avena-robotics/pcbs/UNIVERSAL_JOINT_v3_5/elementy.xlsx

Sheet: SMT
C1, | 1 | 10uF 25v | C | footprints:C_0805_2012Metric_Pad1.18x1.45mm_HandSolder | Unpolarized capacitor
X1, | 1 | ECS-240-8-36B2-CKM-TR | Crystal_GND24_Small | Crystal:Crystal_SMD_2520-4Pin_2.5x2.0mm | Four pin crystal, GND on pins 2 and 4, small symbol
U8, | 1 | NCP115 | NCP115 | footprints:TSOP-5_1.65x3.05mm_P0.95mm
U7, | 1 | MP2456 | MP2456GJ-Z | UNIVERSAL_JOINT:MP2456GJ-Z
U5, | 1 | 24CW16X | 24AA02-OT | footprints:SOT-23-5 | I2C Serial EEPROM, 2Kb, SOT-23
U4, | 1 | iC-PZ2656 | iC-PZ2656 | UNIVERSAL_JOINT:oQFN32-5x5
U3, | 1 | iC-PX3212 | iC-PX3212 | UNIVERSAL_JOINT:oDFN8-3x3
U2, | 1 | TCAN332G | TCAN332G | footprints:SO-8_3.9x4.9mm_P1.27mm | High-Speed CAN Transceiver with CAN FD, 5Mbps, 3.3V supply, SOT-23-8/SOIC-8
U1, | 1 | STSPIN32G4 | STSPIN32G4 | UNIVERSAL_JOINT:STSPIN32G4
SW3, | 1 | EVP-BB2A9B000 | EVP-BB2A9B000 | UNIVERSAL_JOINT:SW_EVP-BB2A9B000
RJ213, RJ215, RJ216, RJ217, RJ218, | 5 | 0 | R | footprints:R_0402_1005Metric_Pad0.72x0.64mm_HandSolder | Resistor
R92, | 1 | 200 | R | footprints:R_0402_1005Metric_Pad0.72x0.64mm_HandSolder | Resistor
R90, R226, | 2 | 100k | R | footprints:R_0402_1005Metric_Pad0.72x0.64mm_HandSolder | Resistor
R62, R63, R64, | 3 | 3.9k 1% | R | footprints:R_0402_1005Metric_Pad0.72x0.64mm_HandSolder | Resistor
R57, R59, R61, | 3 | 27k 1% | R | footprints:R_0402_1005Metric_Pad0.72x0.64mm_HandSolder | Resistor
R56, R58, R60, | 3 | 68k 1% | R | footprints:R_0402_1005Metric_Pad0.72x0.64mm_HandSolder | Resistor
R53, R54, R55, | 3 | 11k 1% | R | footprints:R_0402_1005Metric_Pad0.72x0.64mm_HandSolder | Resistor
R44, R45, R46, R50, R51, R52, | 6 | 1.5k 1% | R | footprints:R_0402_1005Metric_Pad0.72x0.64mm_HandSolder | Resistor
R41, R42, R43, R47, R48, R49, | 6 | 22k 1% | R | footprints:R_0402_1005Metric_Pad0.72x0.64mm_HandSolder | Resistor
R39, | 1 | 3.01k 1% | R | footprints:R_0402_1005Metric_Pad0.72x0.64mm_HandSolder | Resistor
R37, | 1 | 72.3k 1% | R | footprints:R_0402_1005Metric_Pad0.72x0.64mm_HandSolder | Resistor
R31, R33, R35, | 3 | 5m 1% 3W | R | footprints:R_2512_6332Metric_Pad1.40x3.35mm_HandSolder | Resistor
R225, | 1 | 33k | R | footprints:R_0402_1005Metric_Pad0.72x0.64mm_HandSolder | Resistor
R223, R224, | 2 | 10k 1% | R | footprints:R_0402_1005Metric_Pad0.72x0.64mm_HandSolder | Resistor
R222, | 1 | 23,7k | R | footprints:R_0402_1005Metric_Pad0.72x0.64mm_HandSolder | Resistor
R221, | 1 | 124k | R | footprints:R_0402_1005Metric_Pad0.72x0.64mm_HandSolder | Resistor
R209, | 1 | 1,1k | R | footprints:R_0402_1005Metric_Pad0.72x0.64mm_HandSolder | Resistor
R207, R210, | 2 | 100 | R | footprints:R_0402_1005Metric_Pad0.72x0.64mm_HandSolder | Resistor
R205, R206, R208, R213, R214, R215, R216, R217, R219, | 9 | 10k | R | footprints:R_0402_1005Metric_Pad0.72x0.64mm_HandSolder | Resistor
R204, | 1 | 1k | R | footprints:R_0402_1005Metric_Pad0.72x0.64mm_HandSolder | Resistor
R203, | 1 | 1,5k | R | footprints:R_0402_1005Metric_Pad0.72x0.64mm_HandSolder | Resistor
R201, R202, R211, R212, | 4 | 4.7k 0,5W 5% | R | footprints:R_0402_1005Metric_Pad0.72x0.64mm_HandSolder | Resistor
R2, | 1 | 22k | R | footprints:R_0402_1005Metric_Pad0.72x0.64mm_HandSolder | Resistor
R13, R14, R15, R25, R26, R27, | 6 | 33 | R | footprints:R_0402_1005Metric_Pad0.72x0.64mm_HandSolder | Resistor
Q203, | 1 | BSS138PS | BSS138PS | UNIVERSAL_JOINT:SOT363 | 60 V, 320 mA dual N-channel Trench MOSFET
Q1, Q2, Q3, Q4, Q5, Q6, | 6 | STL100N10 | BSC070N10NS5 | Package_TO_SOT_SMD:TDSON-8-1 | 80A Id, 100V Vds, OptiMOS N-Channel Power MOSFET, 7.0mOhm Ron, Qg (typ) 30.0nC, PG-TDSON-8
L2, | 1 | 10uH | L | UNIVERSAL_JOINT:VLS201612HBX-100M-1 | Inductor
L1, | 1 | 18uH, 1A | L | footprints:L_Wuerth_WE-PD2-Typ-MS | Inductor
J12, | 1 | FTSH-107-01-L-DV-K-TR | FTSH-107-01-L-DV-K-TR | UNIVERSAL_JOINT:SAMTEC_FTSH-107-01-L-DV-K-TR
J1, J2, | 2 | BM02B-SRSS-TB | BM02B-SRSS-TB | UNIVERSAL_JOINT:BM02B-SRSS-TB
D8, D9, D10, D11, D206, | 5 | BAT30K | D_Schottky | footprints:D_0603_1608Metric_Pad1.05x0.95mm_HandSolder | Schottky diode
D204, | 1 | RED | LED | footprints:D_0603_1608Metric_Pad1.05x0.95mm_HandSolder | Light emitting diode
D202, | 1 | SMBJ48A-TR | D_Schottky | footprints:D_SMB | Schottky diode
D201, D203, D205, | 3 | GREEN | LED | footprints:D_0603_1608Metric_Pad1.05x0.95mm_HandSolder | Light emitting diode
D2, D3, D4, D5, D6, D7, D207, | 7 | BAT48, 40 V | D_Schottky | footprints:D_0603_1608Metric_Pad1.05x0.95mm_HandSolder | Schottky diode
D1, | 1 | STPS1H100A | D_Schottky | footprints:D_0603_1608Metric_Pad1.05x0.95mm_HandSolder | Schottky diode
C8, C10, C215, | 3 | 1uF | C | footprints:C_0603_1608Metric_Pad1.08x0.95mm_HandSolder | Unpolarized capacitor
C7, C9, C11, C12, C40, C214, | 6 | 100nF | C | footprints:C_0603_1608Metric_Pad1.08x0.95mm_HandSolder | Unpolarized capacitor
C6, | 1 | 10uF | C | footprints:C_0603_1608Metric_Pad1.08x0.95mm_HandSolder | Unpolarized capacitor
C41, C203, C204, C205, C207, C209, C211, | 7 | 100 nF | C | footprints:C_0603_1608Metric_Pad1.08x0.95mm_HandSolder | Unpolarized capacitor
C4, C5, | 2 | 6.8pF | C | footprints:C_0603_1608Metric_Pad1.08x0.95mm_HandSolder | Unpolarized capacitor
C25, C26, C27, | 3 | 82nF 5% | C | footprints:C_0603_1608Metric_Pad1.08x0.95mm_HandSolder | Unpolarized capacitor
C217, C218, | 2 | C | C | footprints:C_0603_1608Metric_Pad1.08x0.95mm_HandSolder | Unpolarized capacitor
C216, | 1 | 1uF Ceramic | C | footprints:C_0603_1608Metric_Pad1.08x0.95mm_HandSolder | Unpolarized capacitor
C213, | 1 | 10 uF | C | footprints:C_0603_1608Metric_Pad1.08x0.95mm_HandSolder | Unpolarized capacitor
C212, | 1 | 4,7 uF | C | footprints:C_0805_2012Metric_Pad1.18x1.45mm_HandSolder | Unpolarized capacitor
C206, C208, C210, | 3 | 1 uF | C | footprints:C_0603_1608Metric_Pad1.08x0.95mm_HandSolder | Unpolarized capacitor
C2, C13, C14, C15, | 4 | 220nF 100V | C | footprints:C_0603_1608Metric_Pad1.08x0.95mm_HandSolder | Unpolarized capacitor
C19, | 1 | 33nF | C | footprints:C_0603_1608Metric_Pad1.08x0.95mm_HandSolder | Unpolarized capacitor
C16, C17, C18, | 3 | 1uF 25V | C | footprints:C_0603_1608Metric_Pad1.08x0.95mm_HandSolder | Unpolarized capacitor

Sheet: THT
J3, | 1 | Conn_01x11_Male | Conn_01x11_Male | footprints:PinHeader_1x11_P1.27mm_Vertical | Generic connector, single row, 01x11, script generated (kicad-library-utils/schlib/autogen/connector/)
TP9, TP10, | 2 | CANH | TestPoint | UNIVERSAL_JOINT:61-2348-11_0030 | test point
TP7, TP8, | 2 | CANL | TestPoint | UNIVERSAL_JOINT:KEYS_3544 | test point
TP5, TP6, | 2 | 12V | TestPoint | UNIVERSAL_JOINT:61-2348-11_0030 | test point
TP3, TP4, | 2 | GND | TestPoint | UNIVERSAL_JOINT:1-726388-2 | test point
TP18, TP19, | 2 | SAFETY | TestPoint | UNIVERSAL_JOINT:KEYS_3544 | test point
TP16, TP17, | 2 | GND | TestPoint | UNIVERSAL_JOINT:61-2348-11_0030 | test point
TP11, TP12, TP13, | 3 | 1-726388-2 | TestPoint | UNIVERSAL_JOINT:61-2348-11_0030 | test point
TP1, TP2, | 2 | 48V | TestPoint | UNIVERSAL_JOINT:1-726388-2 | test point
C31, C32, | 2 | 330uF 100V | C_Polarized_Small | footprints:CP_Radial_D12.5mm_P5.00mm | Polarized capacitor, small symbol
C202, | 1 | 220uF 100V | C_Polarized_Small | footprints:CP_Radial_D6.3mm_P2.50mm | Polarized capacitor, small symbol

Sheet: NM
R81, R82, R218, R220, | 4 | NM | R | footprints:R_0402_1005Metric_Pad0.72x0.64mm_HandSolder | Resistor
NT1, NT2, NT3, NT4, NT5, NT6, | 6 | NetTie_2 | NetTie_2 | footprints:NetTie-2_SMD_Pad0.5mm | Net tie, 2 pins
D12, D13, | 2 | NM | D_Schottky | footprints:D_0603_1608Metric_Pad1.05x0.95mm_HandSolder | Schottky diode
C34, C35, | 2 | NM | C | footprints:C_0603_1608Metric_Pad1.08x0.95mm_HandSolder | Unpolarized capacitor
