avena-robotics/pcbs/ARM_NUCLEO_HAT_1.1/ARM_NUCLEO_HAT/3dmodels/XY256RA1.STEP

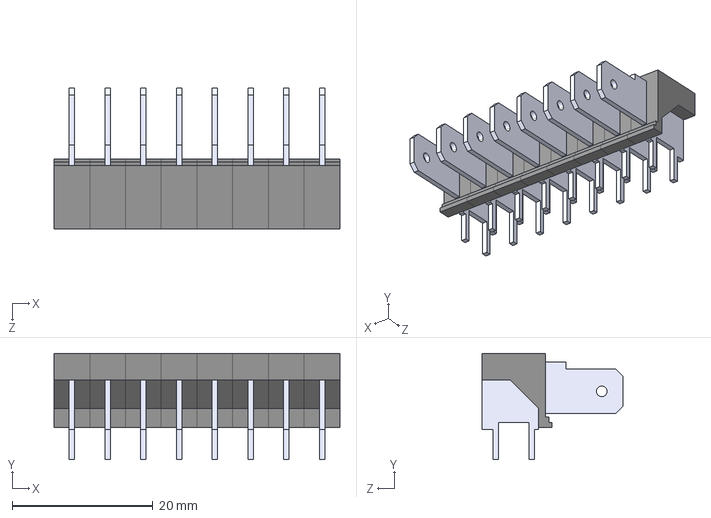
[picture p1: CAD file, 2022-02-07]
ARM_NUCLEO_HAT_1.1/ARM_NUCLEO_HAT/3dmodels/XY256RA1.STEP
40.6 x 15.1 x 20.0 mm
