avena-robotics/pcbs/ARM_NUCLEO_HAT_1.1/NUCLEO-H743ZI2 - odwrócony.DXF

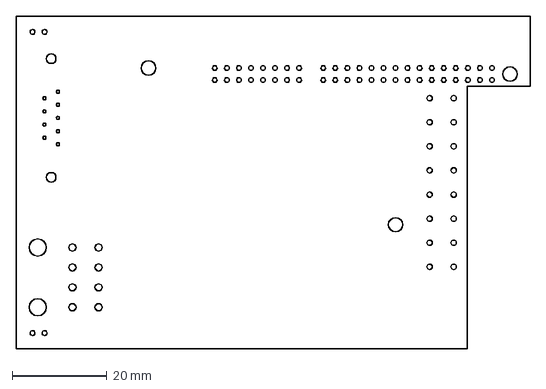
[picture p2: CAD file, 2022-02-07]
ARM_NUCLEO_HAT_1.1/NUCLEO-H743ZI2 - odwrócony.DXF
108.3 x 70.0 mm
