avena-robotics/pcbs/ARM_RPI4_HAT_1.0/mcp2517fd_click.dxf

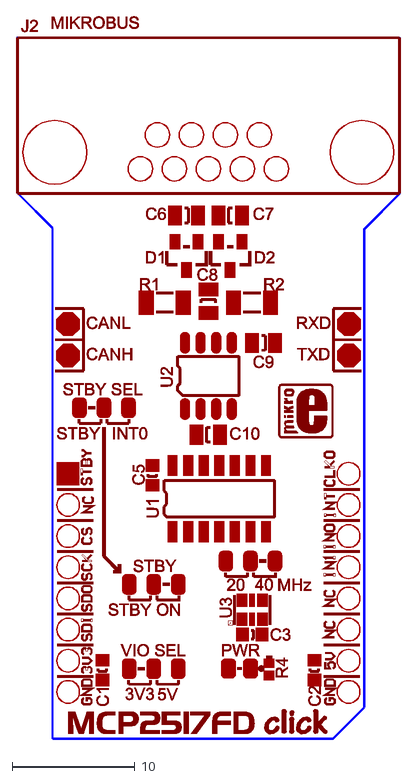
[picture p3: CAD file, 2022-01-12]
ARM_RPI4_HAT_1.0/mcp2517fd_click.dxf
31.3 x 58.9
