avena-robotics/pcbs/common_libraries/3dmodels/PinHeader_1x09_P1.27mm_Vertical.step

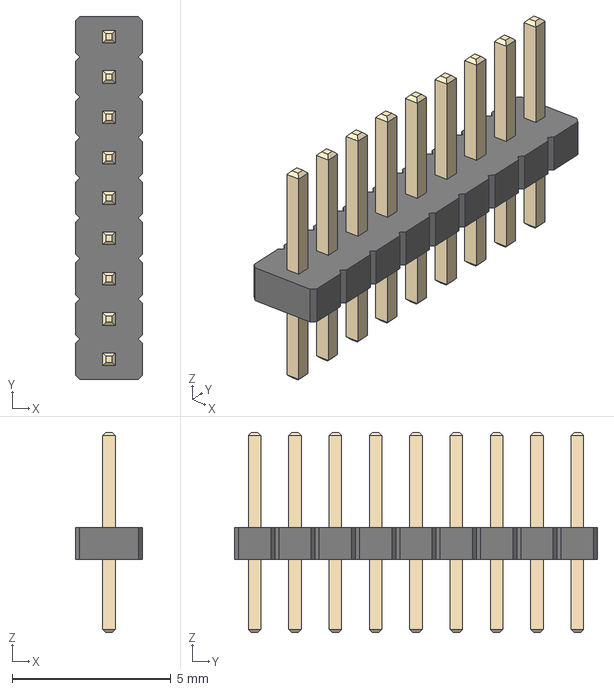
[picture p4: CAD file, 2022-07-13]
common_libraries/3dmodels/PinHeader_1x09_P1.27mm_Vertical.step
2.10 x 11.4 x 6.30 mm
