avena-robotics/pcbs/GRIPPER_PUMP_v1.0/CP1-0120 - kontroler PCB - nowy.dxf

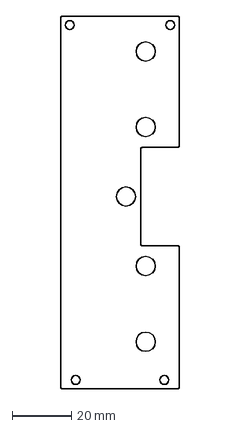
[picture p5: CAD file, 2022-05-02]
GRIPPER_PUMP_v1.0/CP1-0120 - kontroler PCB - nowy.dxf
40.0 x 126.0 mm
