avena-robotics/pcbs/GRIPPER_TWO_ADVANCED_CONTROL_BOARD_v1.3/GRIPPER_TWO_ADVANCED_CONTROL_BOARD/3dmodels/BD9G341AEFJ-E2.step

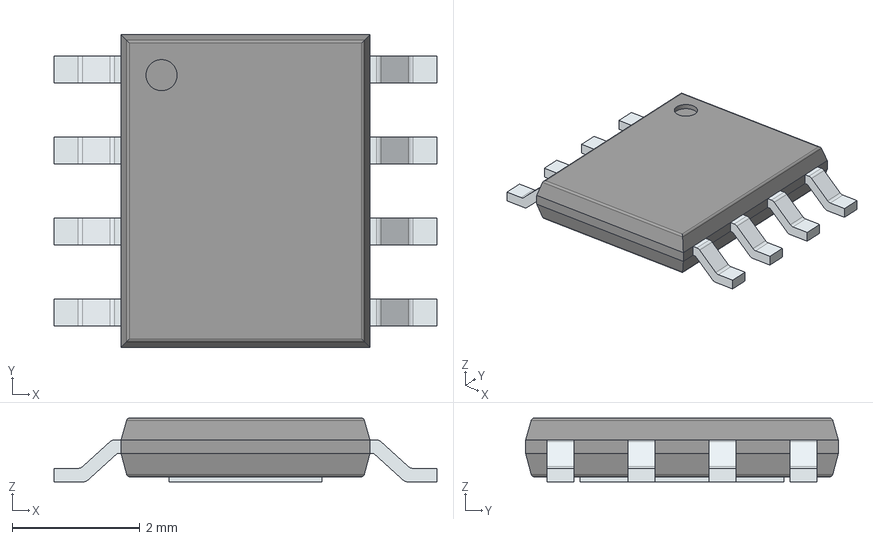
[picture p6: CAD file, 2022-01-12]
GRIPPER_TWO_ADVANCED_CONTROL_BOARD_v1.3/GRIPPER_TWO_ADVANCED_CONTROL_BOARD/3dmodels/BD9G341AEFJ-E2.step
6.00 x 4.90 x 1.00 mm
PinsArrayLR
ThermalPad
