avena-robotics/pcbs/IR_LED_PROJECTOR_v0.3/IR_LED_PROJECTOR/3dmodels/AON3402.step

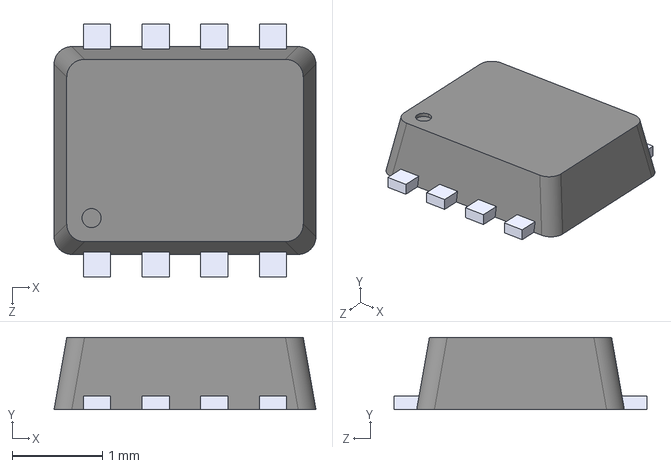
[picture p7: CAD file, 2022-01-12]
IR_LED_PROJECTOR_v0.3/IR_LED_PROJECTOR/3dmodels/AON3402.step
2.90 x 0.8 x 2.80 mm
