avena-robotics/pcbs/IR_LED_PROJECTOR_v0.3/ir_led_projector_v0.3.step

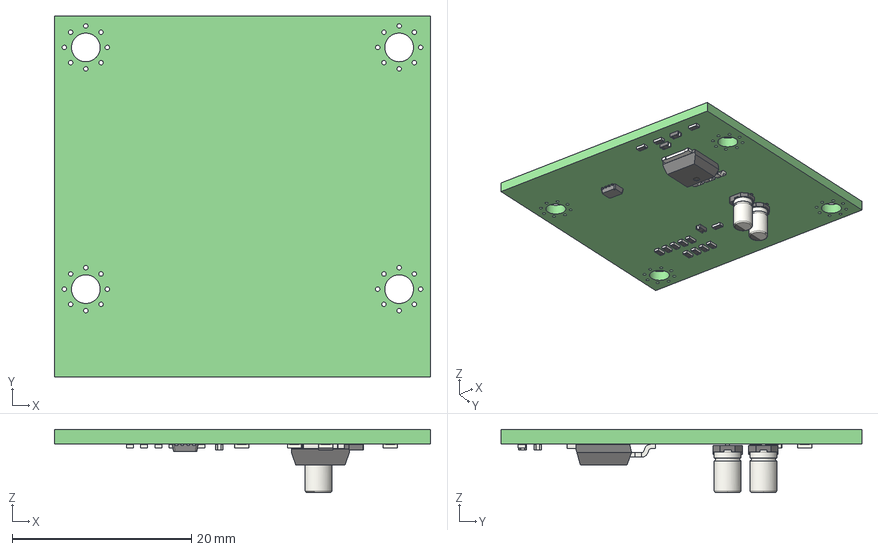
[picture p8: CAD file, 2022-01-12]
IR_LED_PROJECTOR_v0.3/ir_led_projector_v0.3.step
42.0 x 40.3 x 7.05 mm
ir_led_projector_v0.3 PCB
