avena-robotics/pcbs/TACTILE_28UFQFPN_SPI_v2.2/project-3dmodels/CP_Radial_D6.3mm_P2.50mm.step

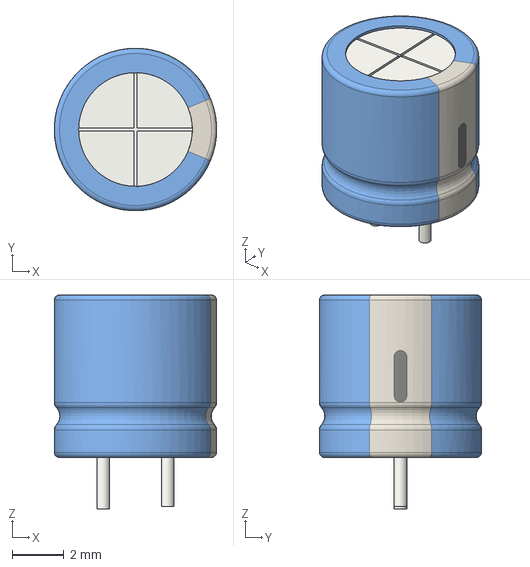
[picture p9: CAD file, 2021-11-14]
TACTILE_28UFQFPN_SPI_v2.2/project-3dmodels/CP_Radial_D6.3mm_P2.50mm.step
6.30 x 6.30 x 8.30 mm
