avena-robotics/pcbs/TACTILE_28UFQFPN_SPI_v2.2/STM32G071G8U6N/UFQFPN-28.step

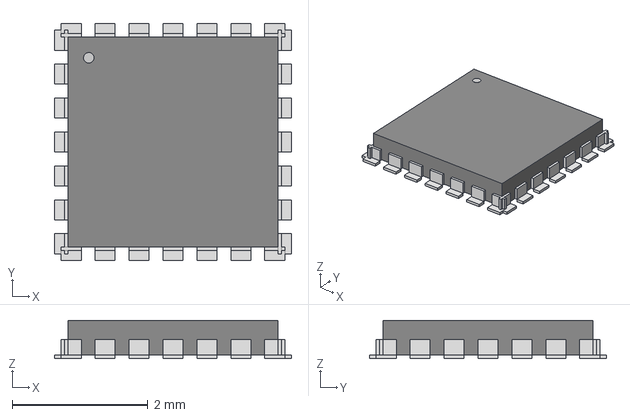
[picture p10: CAD file, 2021-11-14]
TACTILE_28UFQFPN_SPI_v2.2/STM32G071G8U6N/UFQFPN-28.step
3.49 x 3.49 x 0.561 mm
