avena-robotics/pcbs/UNIVERSAL_HALL_PCB_RI70_v3.0/universal_hall_pcb_RI70_v3.0.step

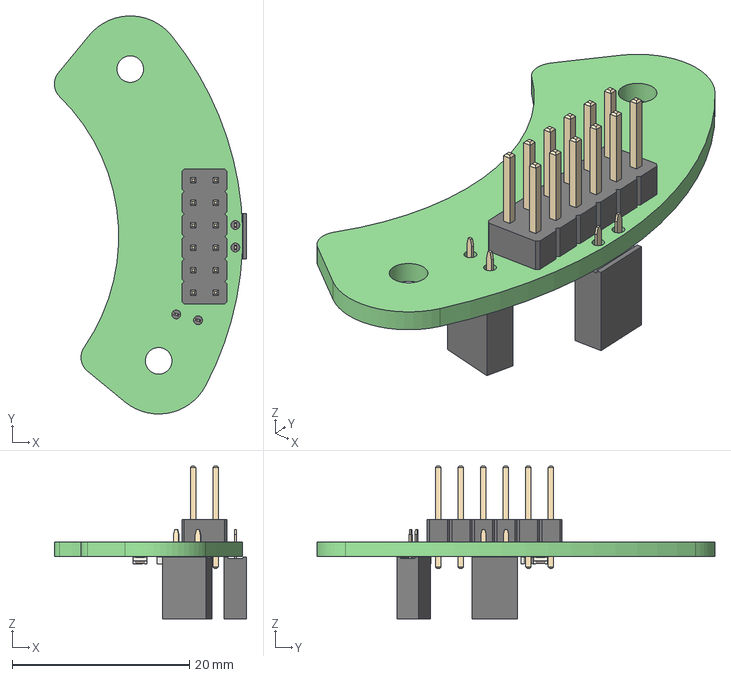
[picture p11: CAD file, 2022-02-07]
UNIVERSAL_HALL_PCB_RI70_v3.0/universal_hall_pcb_RI70_v3.0.step
21.7 x 44.9 x 17.2 mm
universal_hall_pcb_RI70_v3.0 PCB
