avena-robotics/pcbs/UNIVERSAL_HALL_PCB_RI80_v3.0/universal_hall_pcb_RI80_v3.0.step

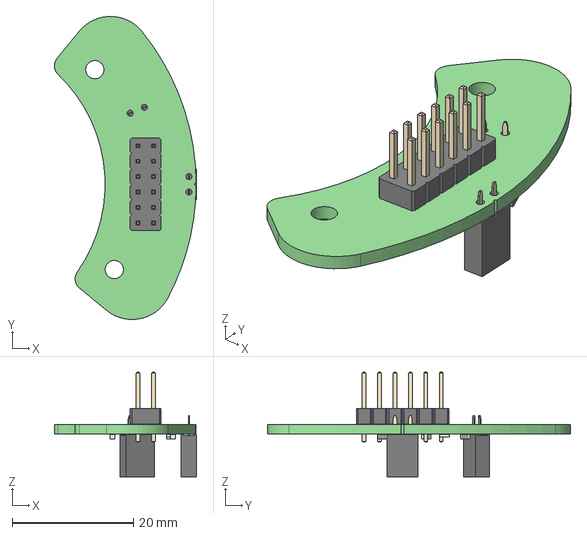
[picture p12: CAD file, 2022-02-07]
UNIVERSAL_HALL_PCB_RI80_v3.0/universal_hall_pcb_RI80_v3.0.step
23.4 x 49.9 x 17.2 mm
universal_hall_pcb_RI80_v3.0 PCB
