avena-robotics/pcbs/UNIVERSAL_JOINT_v3_5/D3-16-33 - PCB kontroler - D-shape.dxf

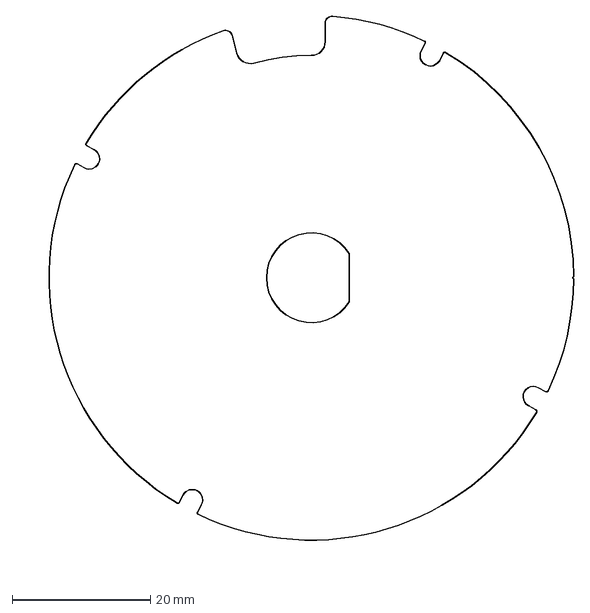
[picture p13: CAD file, 2022-07-13]
UNIVERSAL_JOINT_v3_5/D3-16-33 - PCB kontroler - D-shape.dxf
80.7 x 80.6 mm
