avena-robotics/pcbs/UNIVERSAL_JOINT_v3_5/UNIVERSAL_JOINT/3dmodels/BM02B-SRSS-TB.step

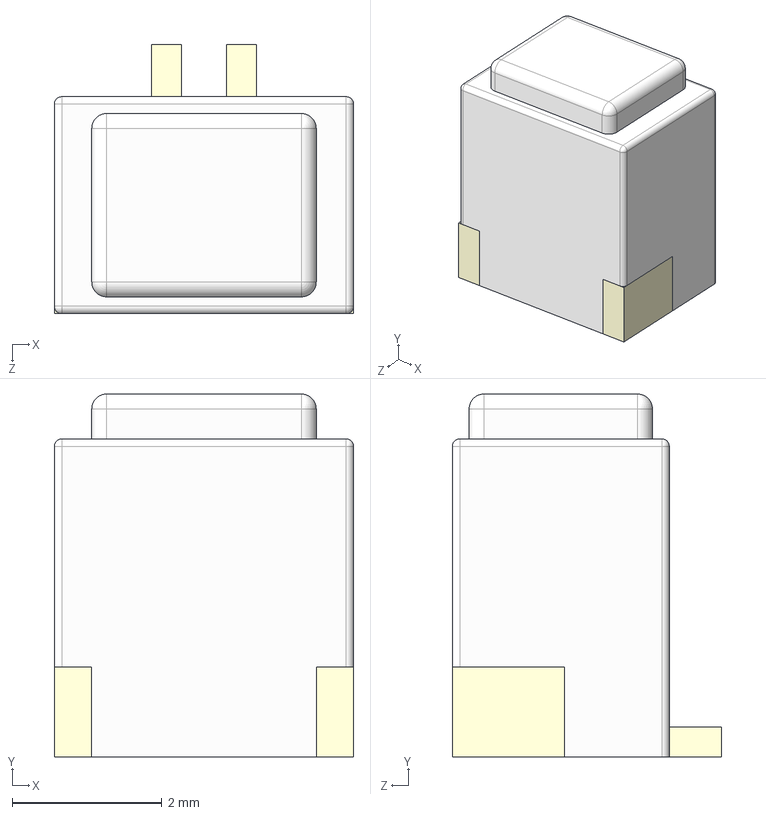
[picture p14: CAD file, 2022-07-13]
UNIVERSAL_JOINT_v3_5/UNIVERSAL_JOINT/3dmodels/BM02B-SRSS-TB.step
4.00 x 4.85 x 3.60 mm
