avena-robotics/pcbs/ARM_NUCLEO_HAT_1.1/ARM_NUCLEO_HAT/3dmodels/39-30-1080.step

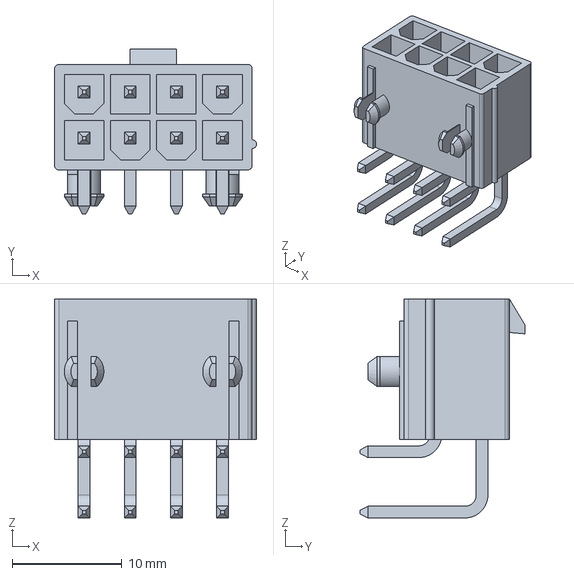
[picture p15: CAD file, 2022-02-07]
ARM_NUCLEO_HAT_1.1/ARM_NUCLEO_HAT/3dmodels/39-30-1080.step
18.4 x 15.0 x 19.9 mm
