avena-robotics/pcbs/ARM_NUCLEO_HAT_1.1/NUCLEO-H743ZI2 - HAT.dxf

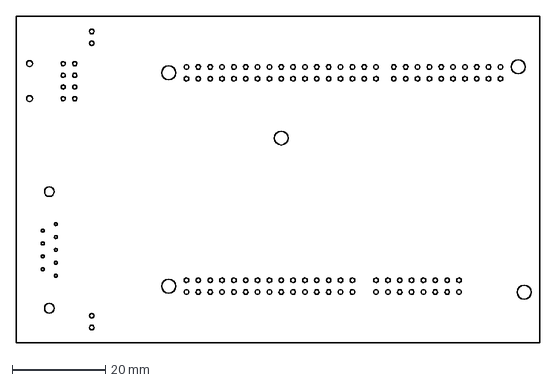
[picture p16: CAD file, 2022-02-07]
ARM_NUCLEO_HAT_1.1/NUCLEO-H743ZI2 - HAT.dxf
112.3 x 70.0 mm
