avena-robotics/pcbs/common_libraries/3dmodels/CP_Radial_D8.0mm_P2.50mm.step

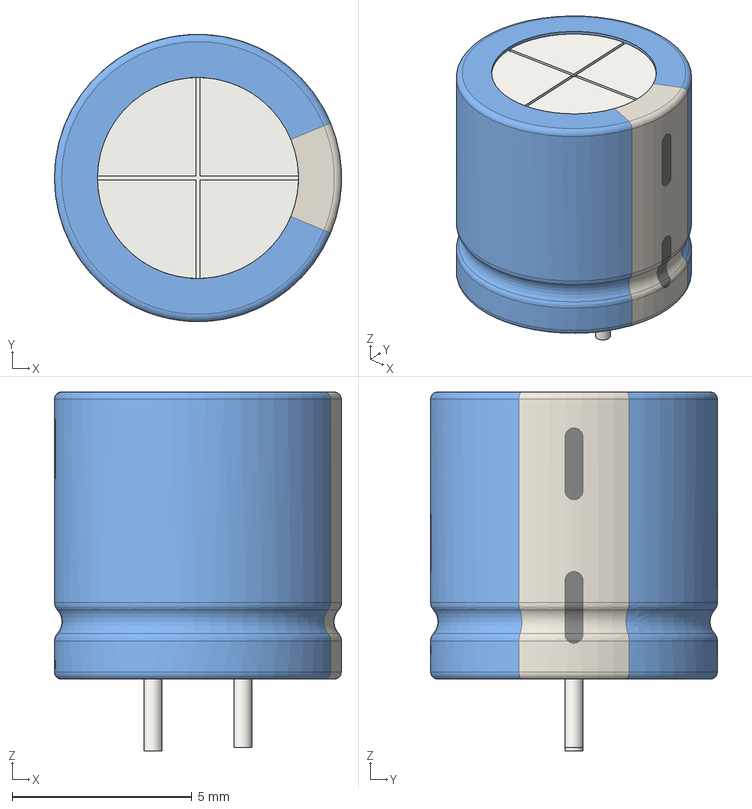
[picture p17: CAD file, 2022-07-13]
common_libraries/3dmodels/CP_Radial_D8.0mm_P2.50mm.step
8.00 x 8.00 x 10.0 mm
