avena-robotics/pcbs/GRIPPER_TWO_ADVANCED_CONTROL_BOARD_v1.3/GRIPPER_TWO_ADVANCED_CONTROL_BOARD/3dmodels/STR485LVQT.step

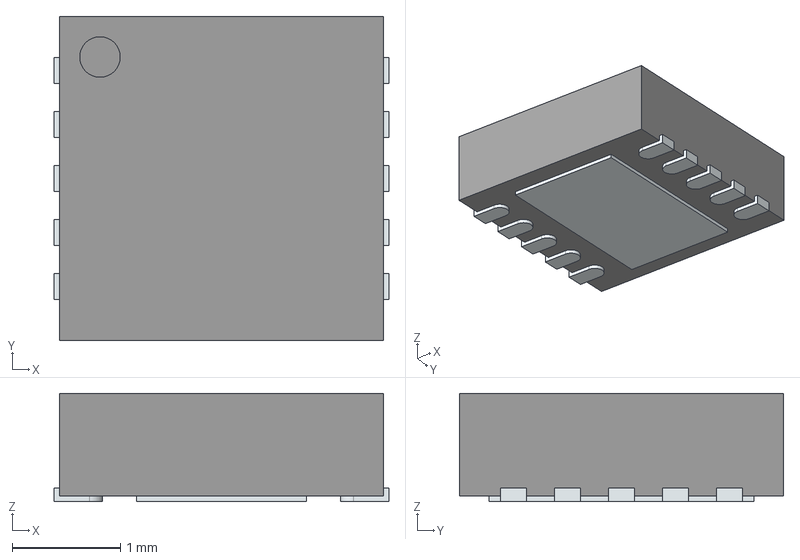
[picture p18: CAD file, 2022-01-12]
GRIPPER_TWO_ADVANCED_CONTROL_BOARD_v1.3/GRIPPER_TWO_ADVANCED_CONTROL_BOARD/3dmodels/STR485LVQT.step
3.10 x 3.00 x 1.00 mm
ThermalPin
PinsArrayLR
