avena-robotics/pcbs/IR_LED_PROJECTOR_v0.3/IR_LED_PROJECTOR/3dmodels/SKHUAL.step

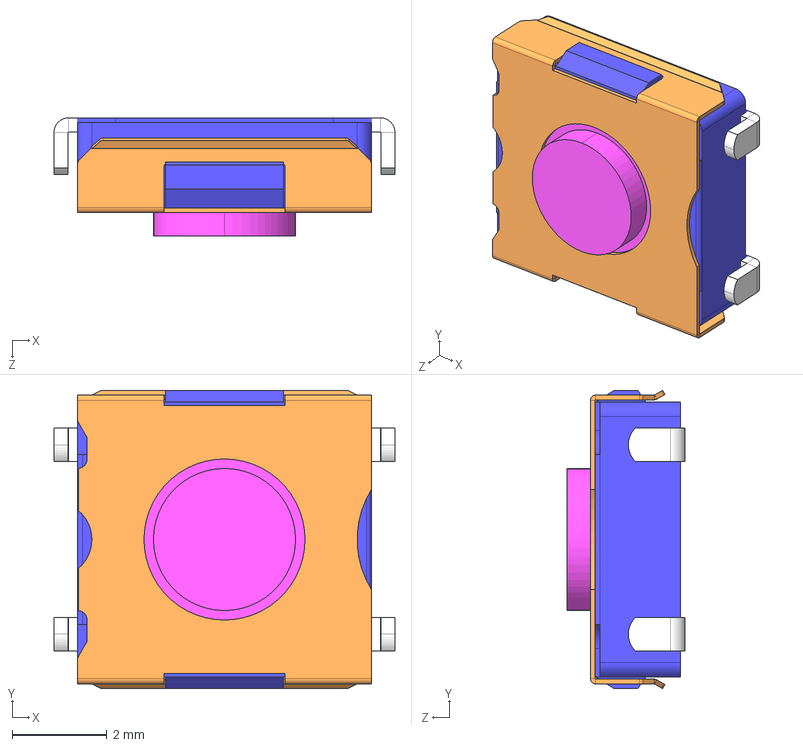
[picture p19: CAD file, 2021-11-30]
IR_LED_PROJECTOR_v0.3/IR_LED_PROJECTOR/3dmodels/SKHUAL.step
7.20 x 6.30 x 2.50 mm
