avena-robotics/pcbs/TACTILE_28UFQFPN_SPI_v2.2/project-3dmodels/C_2512_6332Metric.step

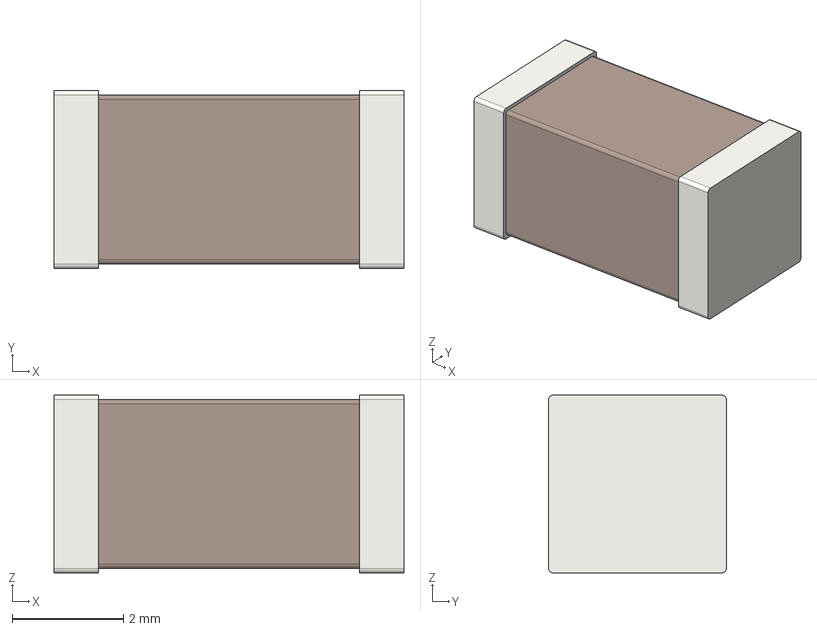
[picture p20: CAD file, 2021-11-14]
TACTILE_28UFQFPN_SPI_v2.2/project-3dmodels/C_2512_6332Metric.step
6.30 x 3.20 x 3.20 mm
