avena-robotics/pcbs/UNIVERSAL_HALL_PCB_RI80_v3.0/D3-15-24 - PCB - hall SMD v.3.2 - obrys płytki.dxf

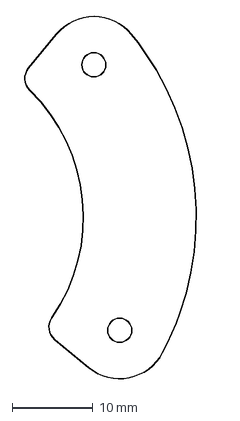
[picture p21: CAD file, 2021-12-08]
UNIVERSAL_HALL_PCB_RI80_v3.0/D3-15-24 - PCB - hall SMD v.3.2 - obrys płytki.dxf
24.0 x 45.2 mm
