avena-robotics/pcbs/UNIVERSAL_JOINT_v3_5/UNIVERSAL_JOINT/3dmodels/IC-PX.step

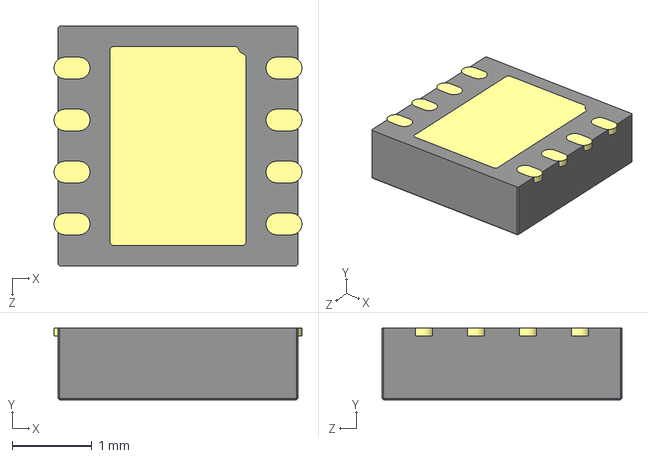
[picture p22: CAD file, 2022-07-13]
UNIVERSAL_JOINT_v3_5/UNIVERSAL_JOINT/3dmodels/IC-PX.step
3.10 x 0.9 x 3.00 mm
