avena-robotics/pcbs/ARM_NUCLEO_HAT_1.1/ARM_NUCLEO_HAT/3dmodels/SN75LBC179AD.step

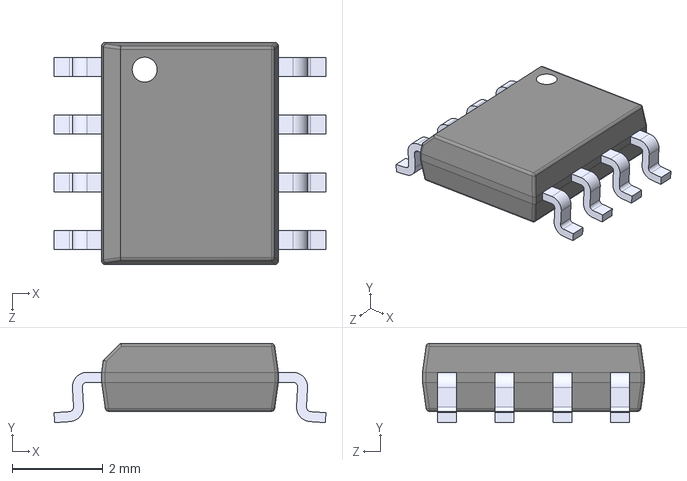
[picture p23: CAD file, 2022-02-07]
ARM_NUCLEO_HAT_1.1/ARM_NUCLEO_HAT/3dmodels/SN75LBC179AD.step
6.00 x 1.75 x 4.90 mm
