avena-robotics/pcbs/common_libraries/3dmodels/TSOT-23-6.step

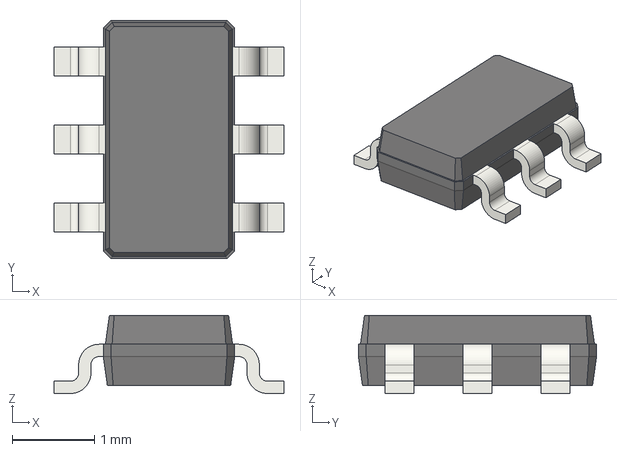
[picture p24: CAD file, 2022-07-13]
common_libraries/3dmodels/TSOT-23-6.step
2.80 x 2.90 x 0.95 mm
