avena-robotics/pcbs/TACTILE_28UFQFPN_SPI_v2.2/project-3dmodels/C_0603_1608Metric.step

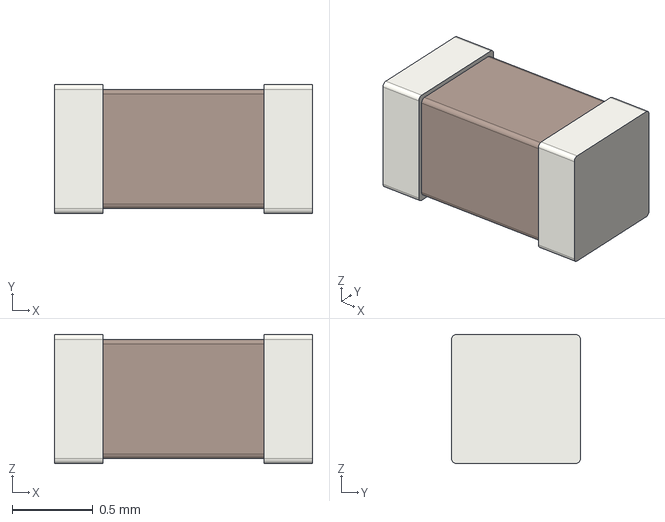
[picture p25: CAD file, 2021-11-14]
TACTILE_28UFQFPN_SPI_v2.2/project-3dmodels/C_0603_1608Metric.step
1.60 x 0.8 x 0.8 mm
