avena-robotics/pcbs/UNIVERSAL_HALL_PCB_RI80_v3.0/D3-2515-31 - PCB - hall SMD v.3.1.- obrys płytki z otworami nontażowymiDXF.DXF

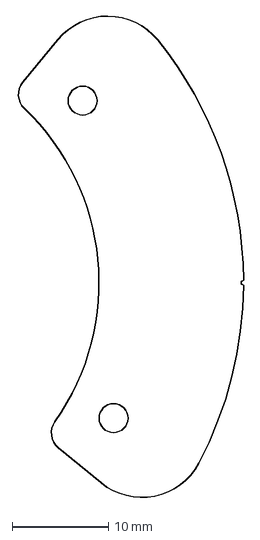
[picture p26: CAD file, 2021-12-08]
UNIVERSAL_HALL_PCB_RI80_v3.0/D3-2515-31 - PCB - hall SMD v.3.1.- obrys płytki z otworami nontażowymiDXF.DXF
23.6 x 50.2 mm
