avena-robotics/pcbs/ARM_NUCLEO_HAT_1.1/ARM_NUCLEO_HAT/3dmodels/MPEV1D1040.step

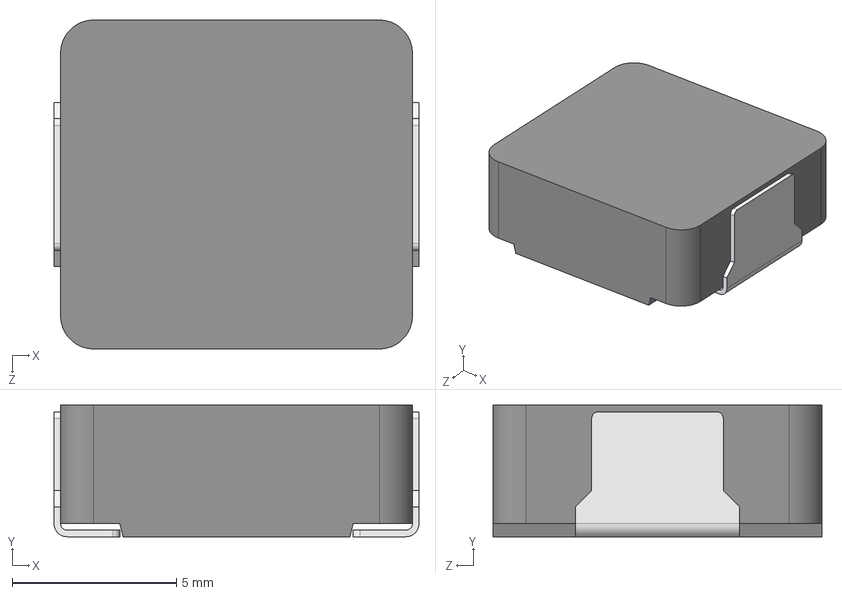
[picture p27: CAD file, 2022-01-12]
ARM_NUCLEO_HAT_1.1/ARM_NUCLEO_HAT/3dmodels/MPEV1D1040.step
11.1 x 4.00 x 10.0 mm
