avena-robotics/pcbs/common_libraries/3dmodels/R_0402_1005Metric.step

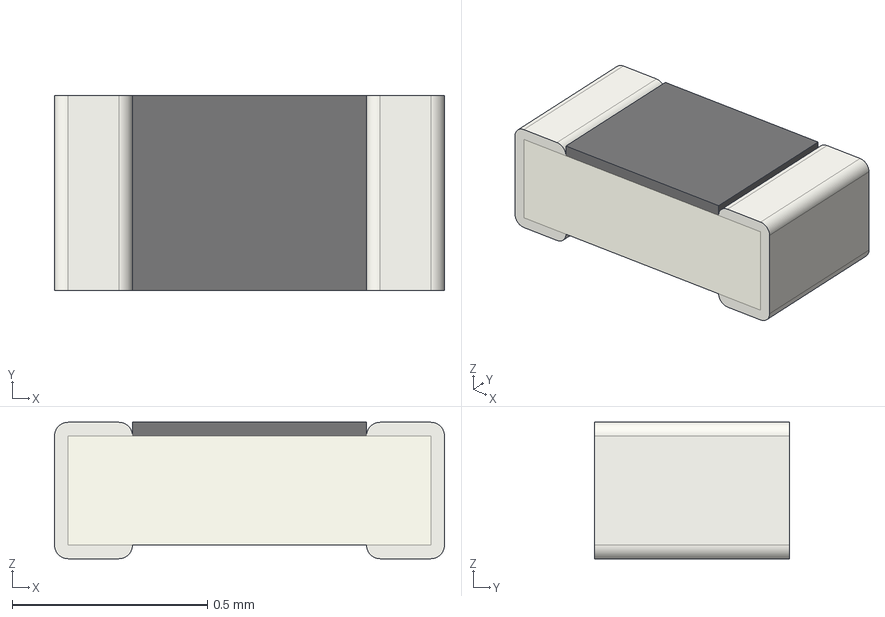
[picture p28: CAD file, 2022-07-13]
common_libraries/3dmodels/R_0402_1005Metric.step
1.00 x 0.5 x 0.35 mm
