avena-robotics/pcbs/TACTILE_28UFQFPN_SPI_v2.2/project-3dmodels/R_0603_1608Metric.step

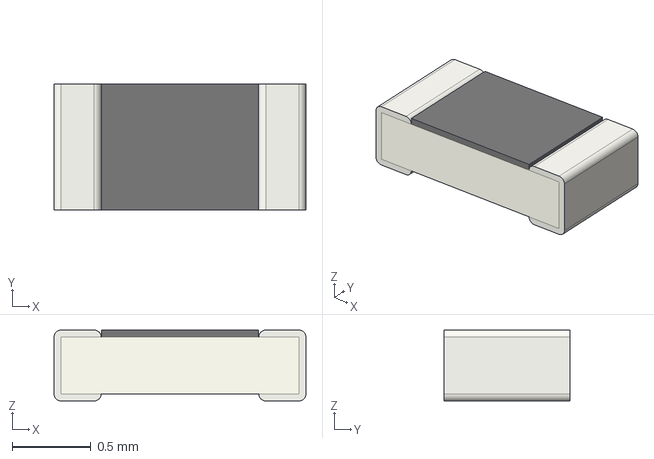
[picture p29: CAD file, 2021-11-14]
TACTILE_28UFQFPN_SPI_v2.2/project-3dmodels/R_0603_1608Metric.step
1.60 x 0.8 x 0.45 mm
