avena-robotics/pcbs/UNIVERSAL_HALL_PCB_RI80_v3.0/D3-2515-31 - PCB - hall SMD v.3.1 - obrys płytki i elementów.DXF

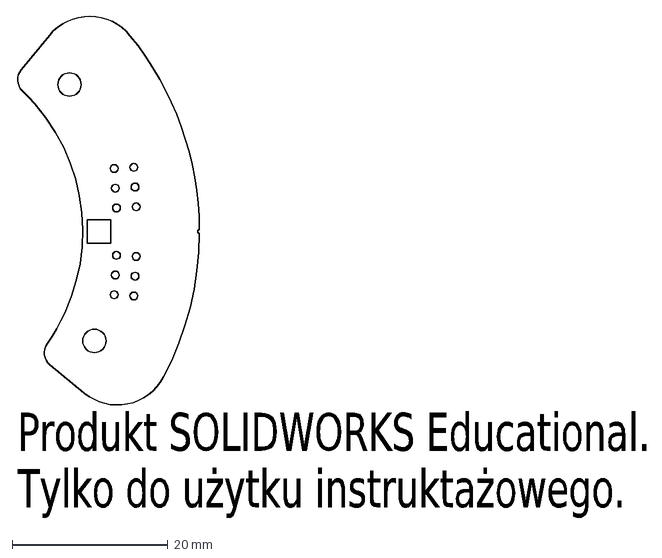
[picture p30: CAD file, 2021-11-30]
UNIVERSAL_HALL_PCB_RI80_v3.0/D3-2515-31 - PCB - hall SMD v.3.1 - obrys płytki i elementów.DXF
Produkt SOLIDWORKS Educational.
Tylko do użytku instruktażowego.
