avena-robotics/pcbs/UNIVERSAL_JOINT_v3_5/UNIVERSAL_JOINT/3dmodels/EVP-BB2A9B000.step

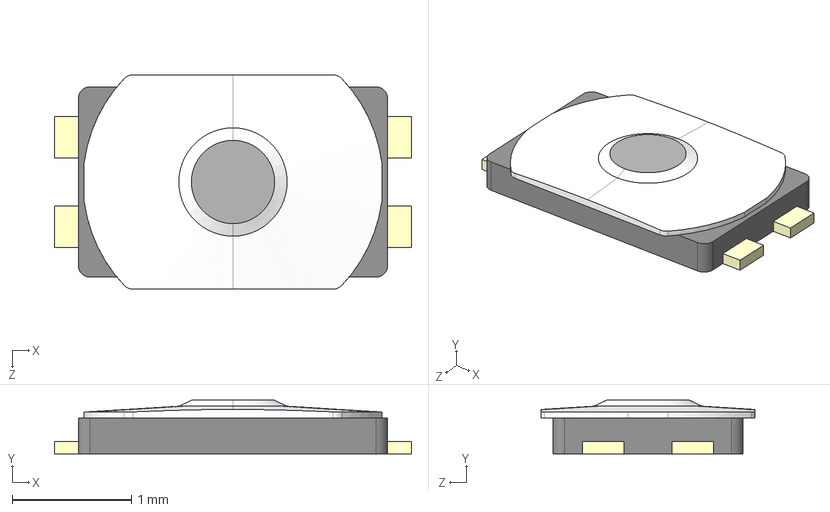
[picture p31: CAD file, 2022-07-13]
UNIVERSAL_JOINT_v3_5/UNIVERSAL_JOINT/3dmodels/EVP-BB2A9B000.step
3.00 x 0.45 x 1.80 mm
