avena-robotics/pcbs/common_libraries/3dmodels/PinHeader_1x11_P1.27mm_Vertical.step

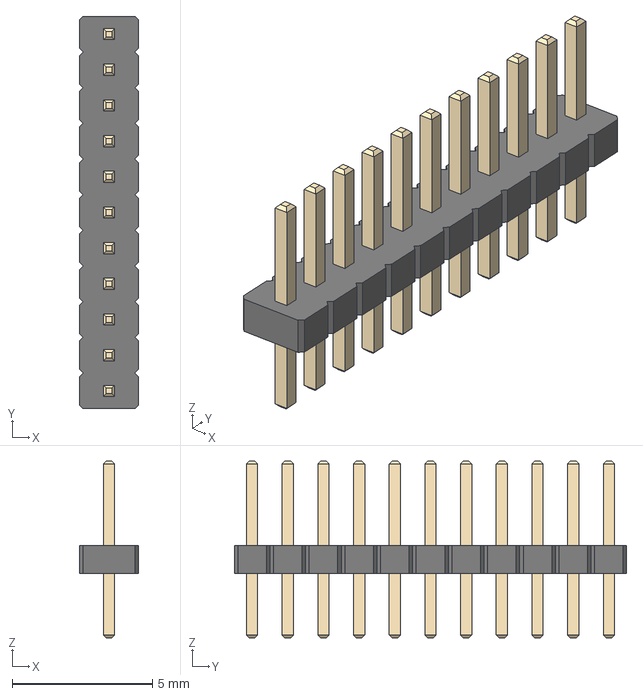
[picture p32: CAD file, 2022-07-13]
common_libraries/3dmodels/PinHeader_1x11_P1.27mm_Vertical.step
2.10 x 14.0 x 6.30 mm
