avena-robotics/pcbs/TACTILE_28UFQFPN_SPI_v2.2/project-3dmodels/D_0603_1608Metric.step

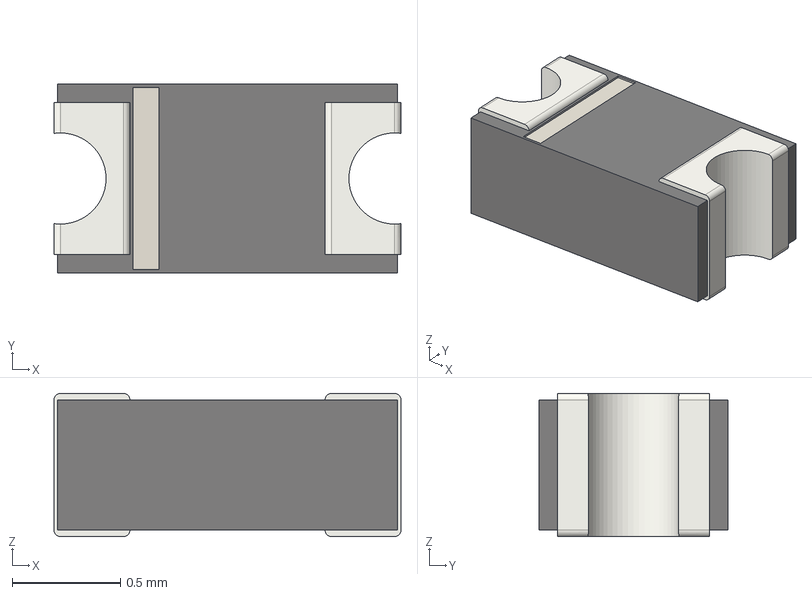
[picture p33: CAD file, 2021-11-14]
TACTILE_28UFQFPN_SPI_v2.2/project-3dmodels/D_0603_1608Metric.step
1.60 x 0.87 x 0.66 mm
