avena-robotics/pcbs/UNIVERSAL_JOINT_v3_5/UNIVERSAL_JOINT/3dmodels/iC-PZ.step

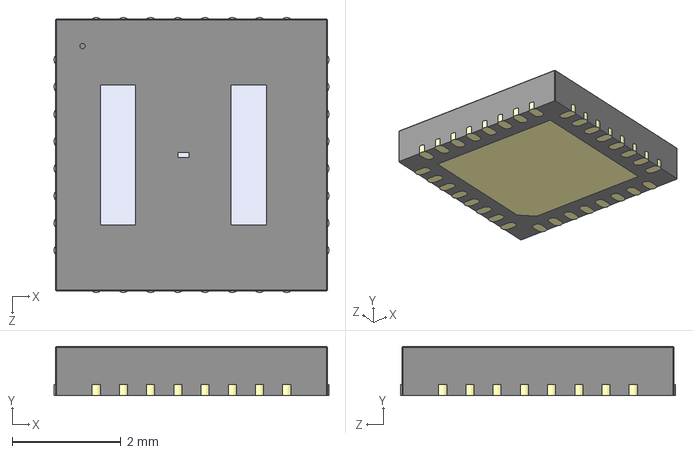
[picture p34: CAD file, 2022-07-13]
UNIVERSAL_JOINT_v3_5/UNIVERSAL_JOINT/3dmodels/iC-PZ.step
5.05 x 0.9 x 5.05 mm
