avena-robotics/pcbs/common_libraries/3dmodels/TSOP-5_1.65x3.05mm_P0.95mm.step

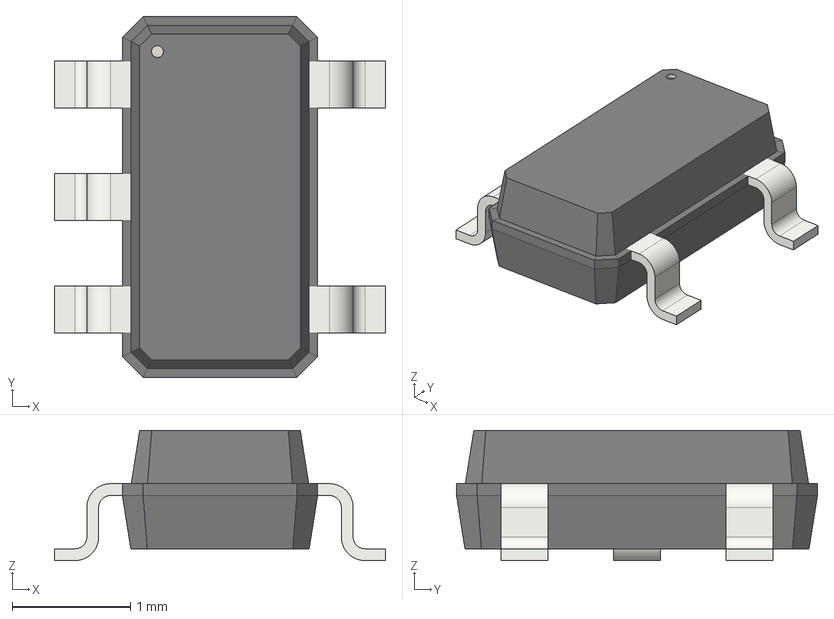
[picture p35: CAD file, 2022-07-13]
common_libraries/3dmodels/TSOP-5_1.65x3.05mm_P0.95mm.step
2.80 x 3.05 x 1.10 mm
