avena-robotics/pcbs/TACTILE_28UFQFPN_SPI_v2.2/project-3dmodels/CP_Radial_D12.5mm_P2.50mm.step

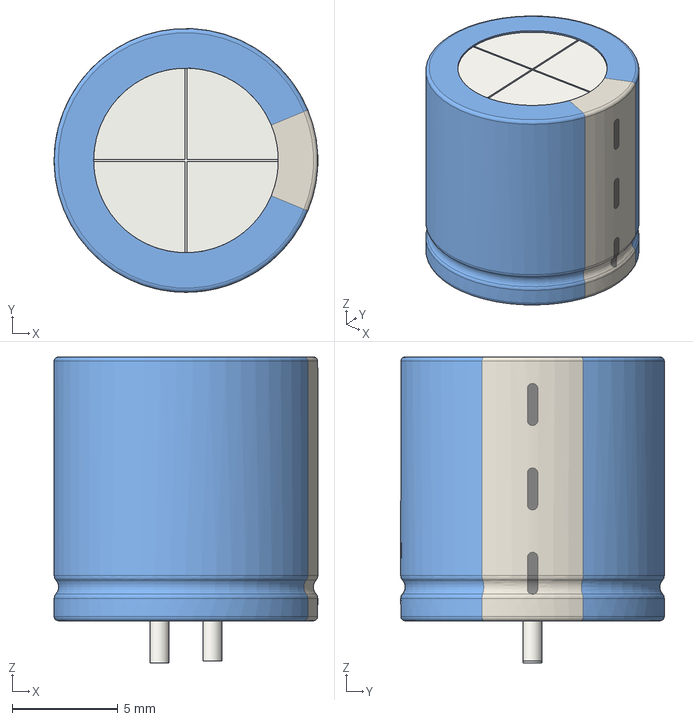
[picture p36: CAD file, 2021-11-14]
TACTILE_28UFQFPN_SPI_v2.2/project-3dmodels/CP_Radial_D12.5mm_P2.50mm.step
12.5 x 12.5 x 14.5 mm
