avena-robotics/pcbs/UNIVERSAL_JOINT_v3_5/UNIVERSAL_JOINT/3dmodels/TC2030-IDC.step

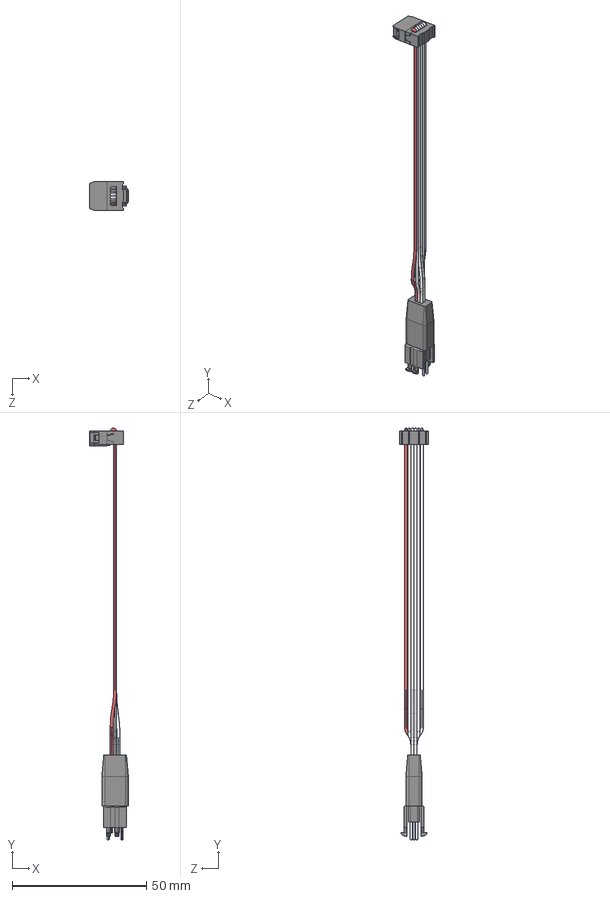
[picture p37: CAD file, 2022-07-13]
UNIVERSAL_JOINT_v3_5/UNIVERSAL_JOINT/3dmodels/TC2030-IDC.step
14.5 x 153.6 x 10.7 mm
