avena-robotics/pcbs/common_libraries/3dmodels/SOT-23-5.step

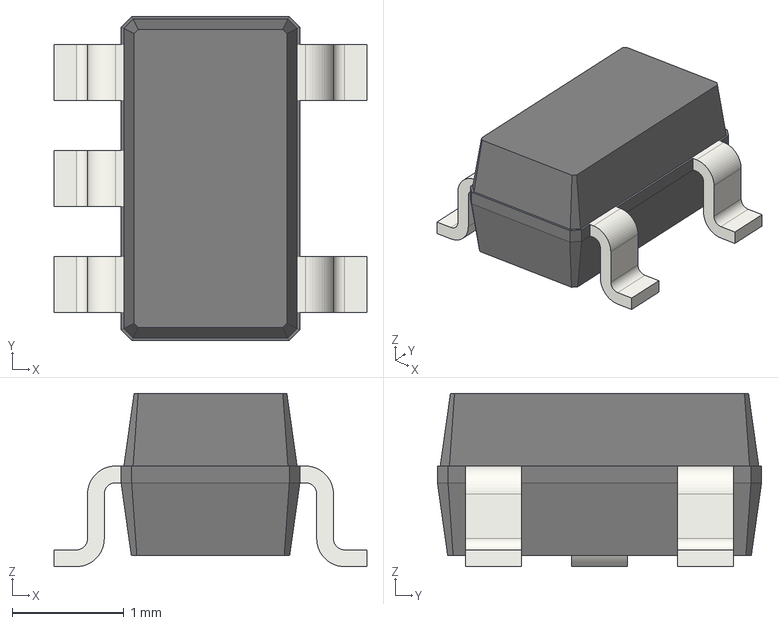
[picture p39: CAD file, 2022-07-13]
common_libraries/3dmodels/SOT-23-5.step
2.80 x 2.90 x 1.55 mm
