avena-robotics/pcbs/UNIVERSAL_JOINT_v3_5/UNIVERSAL_JOINT/3dmodels/SM04B-SRSS-TB.step

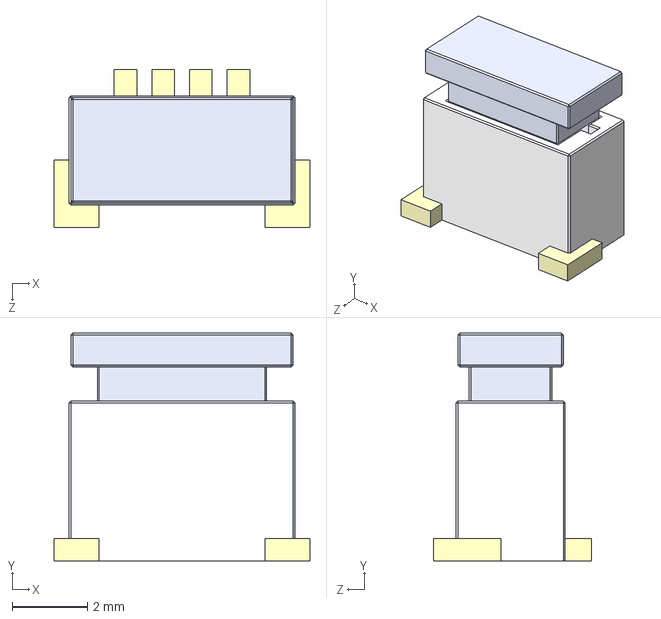
[picture p40: CAD file, 2022-06-21]
UNIVERSAL_JOINT_v3_5/UNIVERSAL_JOINT/3dmodels/SM04B-SRSS-TB.step
6.80 x 6.05 x 4.20 mm
