avena-robotics/pcbs/ARM_NUCLEO_HAT_1.1/ARM_NUCLEO_HAT/3dmodels/61-1407-21_0031.step

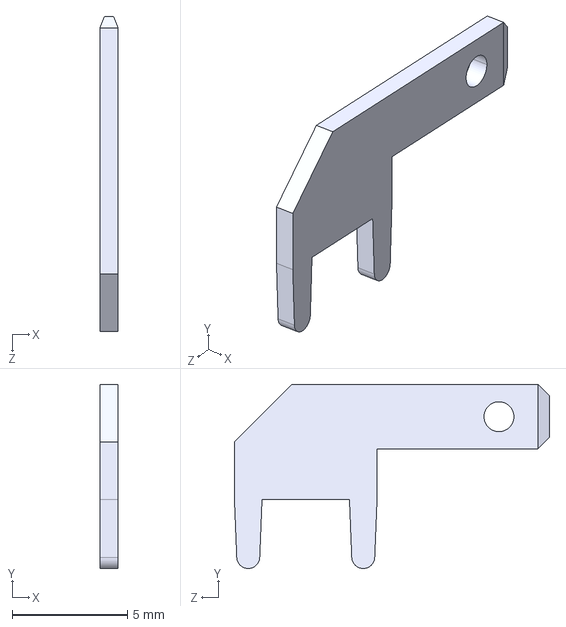
[picture p41: CAD file, 2022-01-12]
ARM_NUCLEO_HAT_1.1/ARM_NUCLEO_HAT/3dmodels/61-1407-21_0031.step
0.8 x 8.00 x 13.7 mm
