avena-robotics/pcbs/common_libraries/3dmodels/TDSON-8-1.step

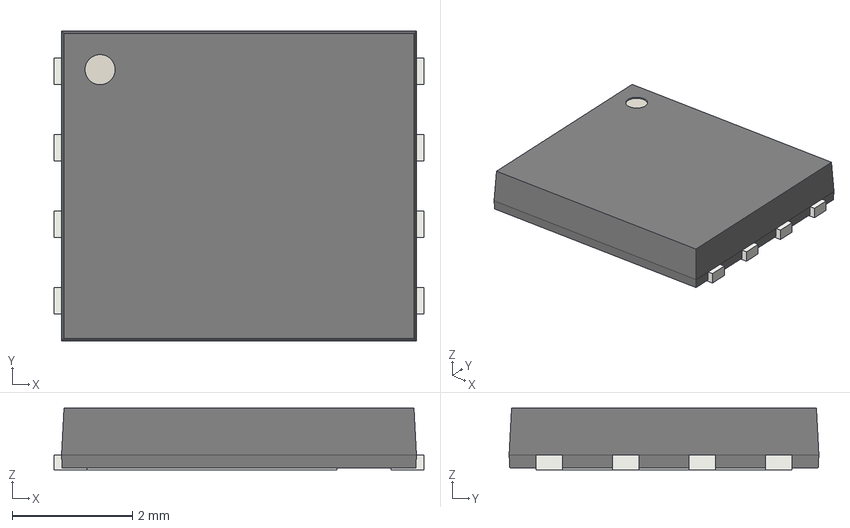
[picture p42: CAD file, 2022-05-02]
common_libraries/3dmodels/TDSON-8-1.step
6.15 x 5.15 x 1.03 mm
