avena-robotics/pcbs/UNIVERSAL_JOINT_v3_5/UNIVERSAL_JOINT/3dmodels/ECX-2236B2.step

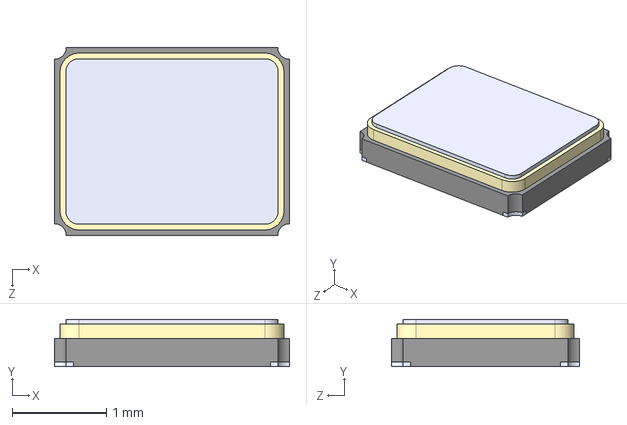
[picture p43: CAD file, 2022-05-02]
UNIVERSAL_JOINT_v3_5/UNIVERSAL_JOINT/3dmodels/ECX-2236B2.step
2.50 x 0.5 x 2.00 mm
