avena-robotics/pcbs/common_libraries/3dmodels/C_0805_2012Metric.step

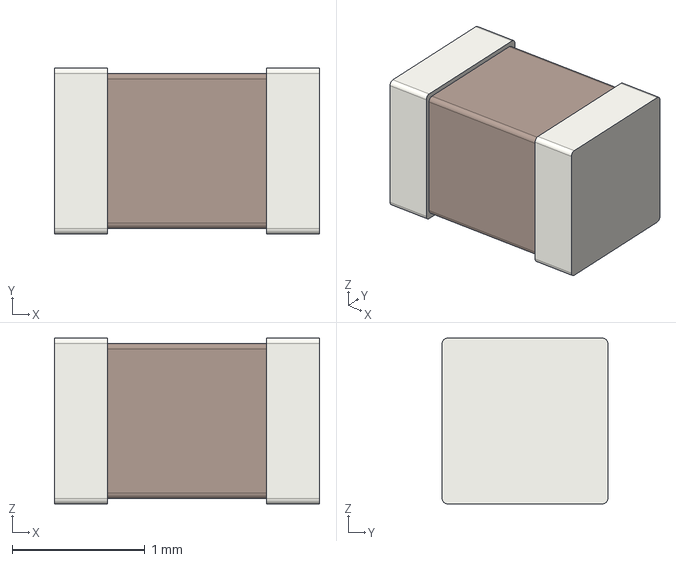
[picture p44: CAD file, 2022-01-12]
common_libraries/3dmodels/C_0805_2012Metric.step
2.00 x 1.25 x 1.25 mm
