avena-robotics/pcbs/UNIVERSAL_JOINT_v3_5/UNIVERSAL_JOINT/3dmodels/BSS138PS.STEP

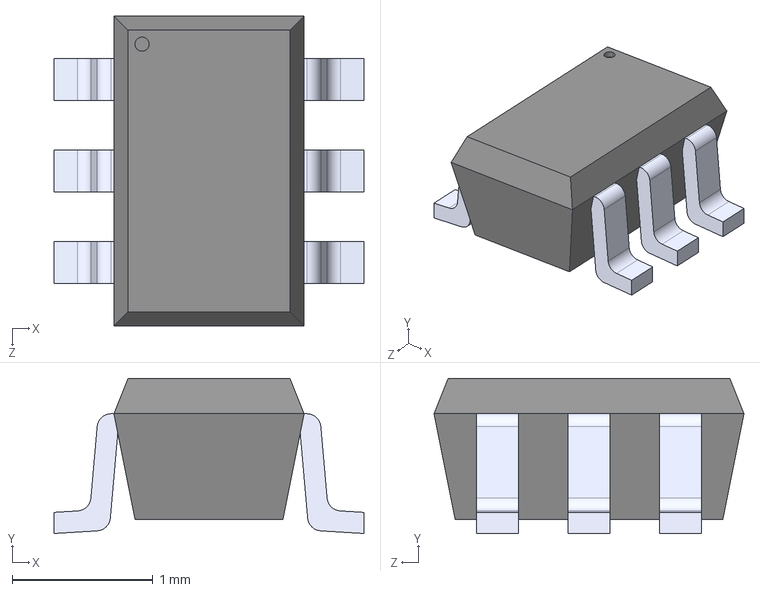
[picture p46: CAD file, 2022-04-29]
UNIVERSAL_JOINT_v3_5/UNIVERSAL_JOINT/3dmodels/BSS138PS.STEP
2.20 x 1.10 x 2.20 mm
