avena-robotics/pcbs/common_libraries/3dmodels/PinSocket_1x08_P2.54mm_Vertical.step

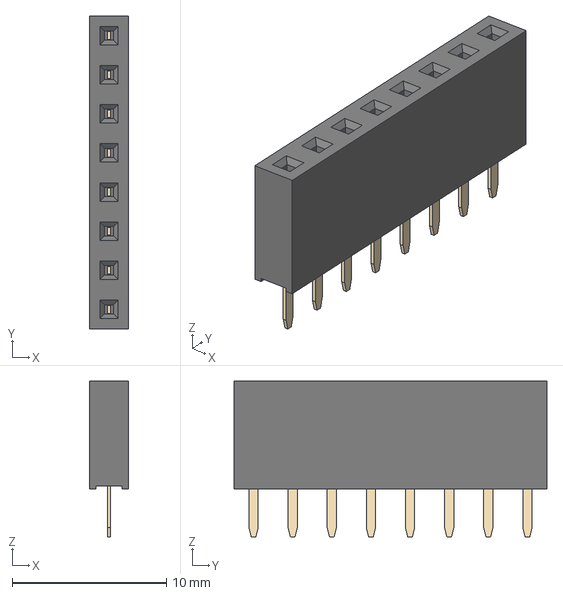
[picture p47: CAD file, 2022-01-12]
common_libraries/3dmodels/PinSocket_1x08_P2.54mm_Vertical.step
2.54 x 20.3 x 10.1 mm
