avena-robotics/pcbs/TACTILE_28UFQFPN_SPI_v2.2/project-3dmodels/QFN_IN32G4_STM.step

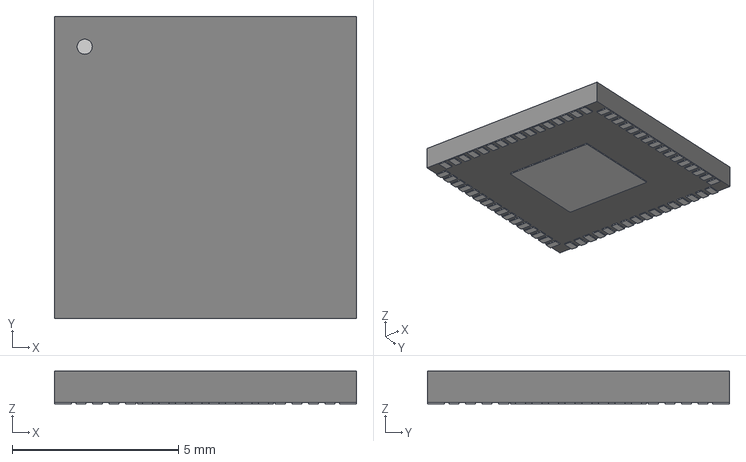
[picture p48: CAD file, 2021-11-14]
TACTILE_28UFQFPN_SPI_v2.2/project-3dmodels/QFN_IN32G4_STM.step
9.09 x 9.09 x 0.993 mm
