avena-robotics/pcbs/UNIVERSAL_JOINT_v3_5/UNIVERSAL_JOINT/3dmodels/TSOT23-6_MNP.step

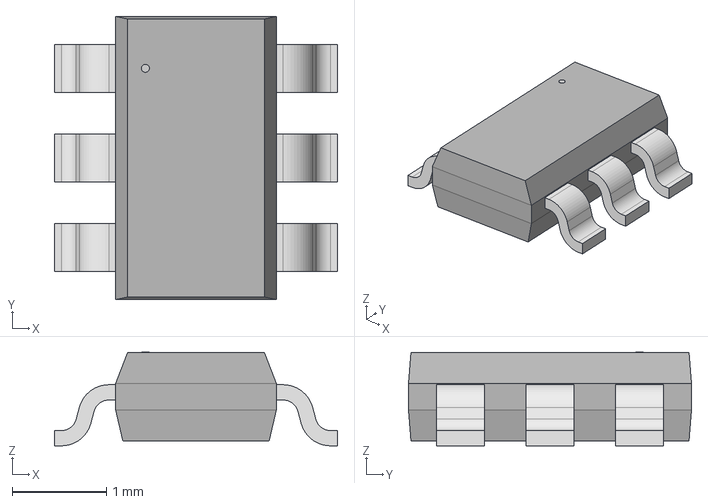
[picture p49: CAD file, 2022-04-29]
UNIVERSAL_JOINT_v3_5/UNIVERSAL_JOINT/3dmodels/TSOT23-6_MNP.step
3.00 x 3.00 x 0.993 mm
