avena-robotics/pcbs/common_libraries/3dmodels/PinHeader_1x03_P2.54mm_Horizontal.step

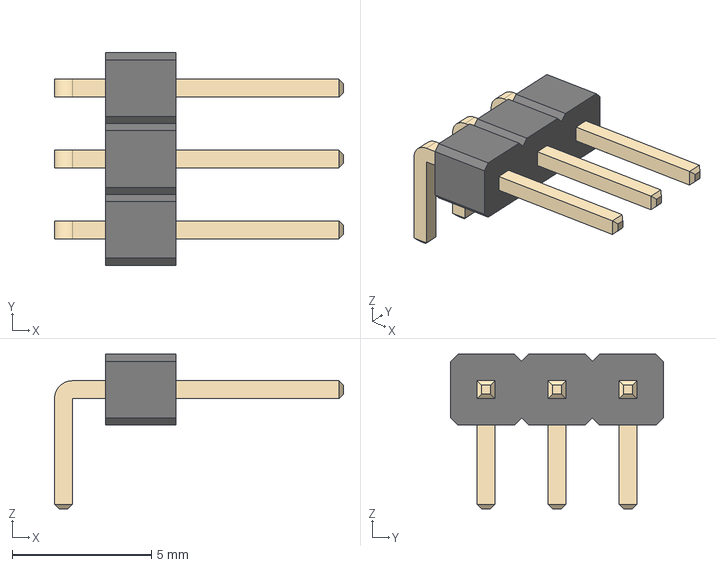
[picture p50: CAD file, 2022-01-12]
common_libraries/3dmodels/PinHeader_1x03_P2.54mm_Horizontal.step
10.4 x 7.62 x 5.54 mm
