avena-robotics/pcbs/UNIVERSAL_JOINT_v3_5/UNIVERSAL_JOINT/3dmodels/SOT-363.step

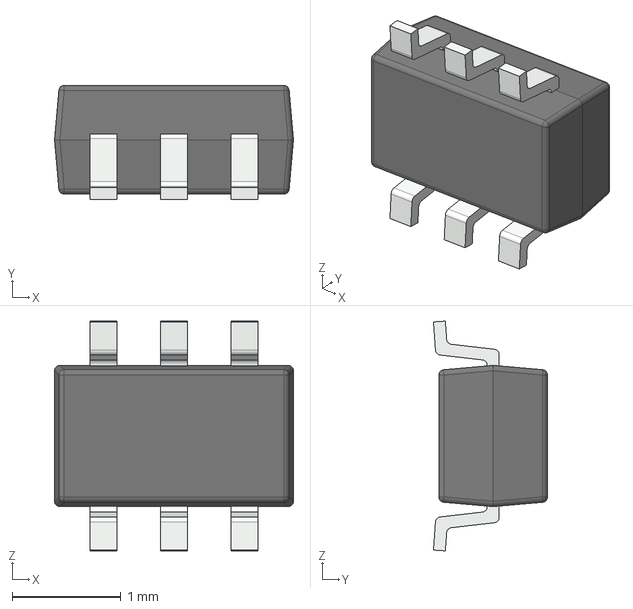
[picture p51: CAD file, 2022-04-29]
UNIVERSAL_JOINT_v3_5/UNIVERSAL_JOINT/3dmodels/SOT-363.step
2.20 x 1.05 x 2.12 mm
