avena-robotics/pcbs/common_libraries/3dmodels/D_SMB.step

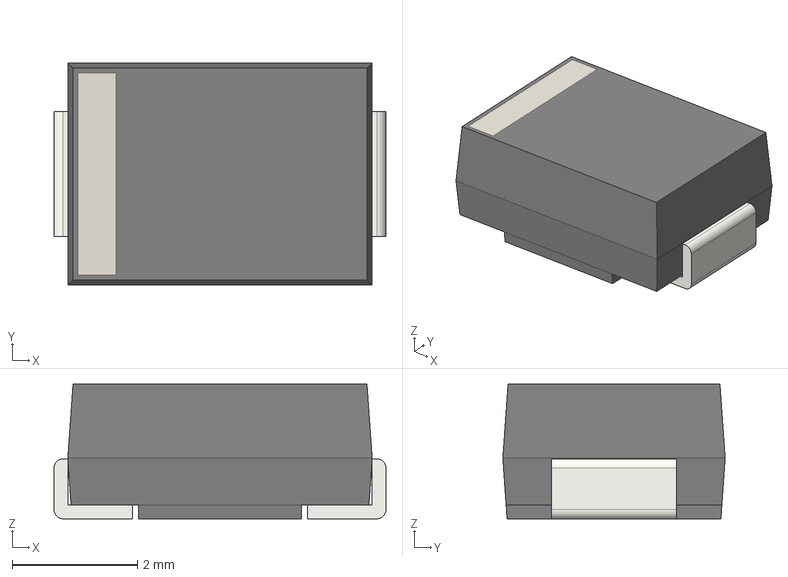
[picture p52: CAD file, 2022-01-12]
common_libraries/3dmodels/D_SMB.step
5.30 x 3.55 x 2.15 mm
