avena-robotics/pcbs/UNIVERSAL_JOINT_v3_5/UNIVERSAL_JOINT/3dmodels/KEYS-3578.step

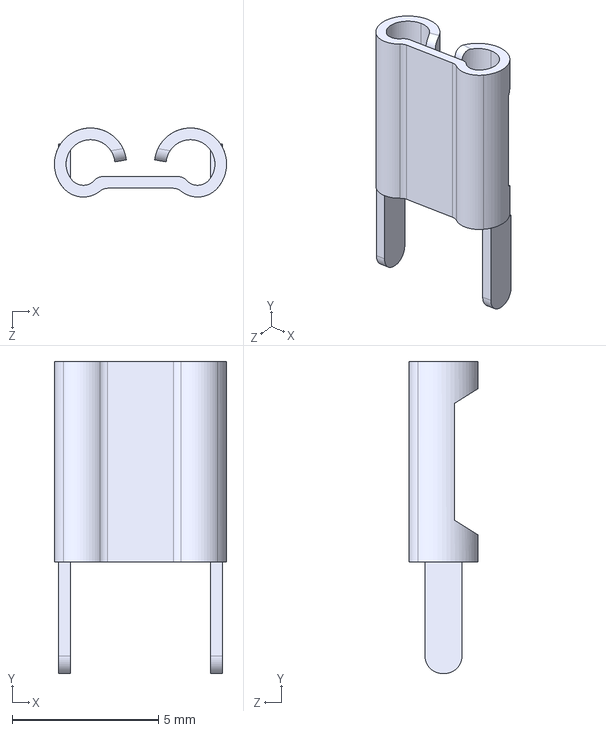
[picture p53: CAD file, 2022-02-07]
UNIVERSAL_JOINT_v3_5/UNIVERSAL_JOINT/3dmodels/KEYS-3578.step
5.89 x 10.7 x 2.36 mm
