avena-robotics/pcbs/UNIVERSAL_JOINT_v3_5/UNIVERSAL_JOINT/3dmodels/KEYS-3544.step

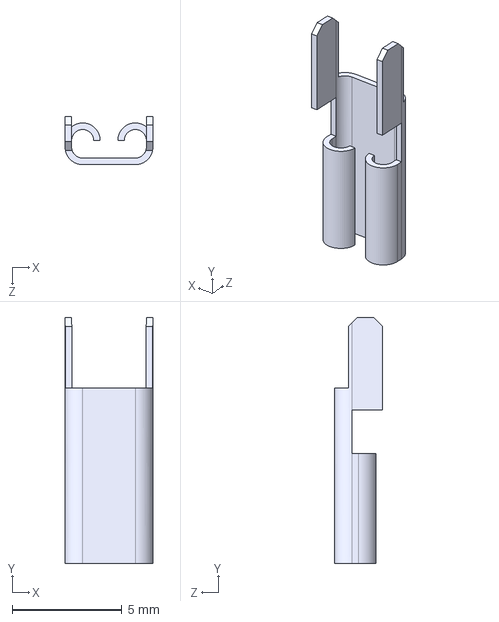
[picture p55: CAD file, 2022-02-07]
UNIVERSAL_JOINT_v3_5/UNIVERSAL_JOINT/3dmodels/KEYS-3544.step
4.00 x 11.2 x 2.20 mm
