avena-robotics/pcbs/common_libraries/3dmodels/PinSocket_1x02_P2.54mm_Vertical.step

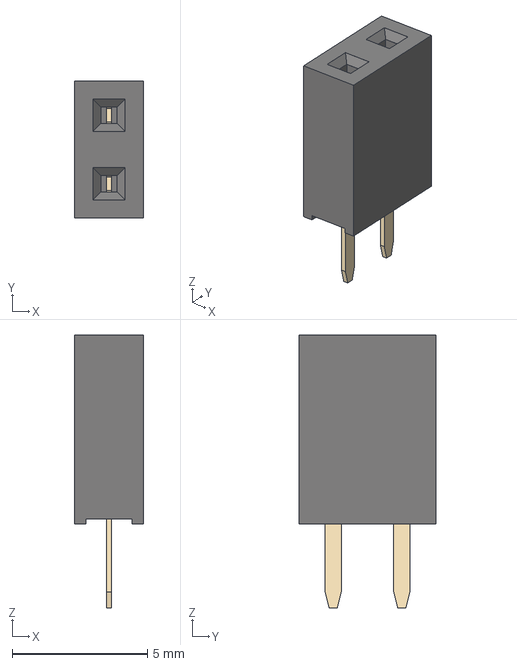
[picture p56: CAD file, 2022-01-12]
common_libraries/3dmodels/PinSocket_1x02_P2.54mm_Vertical.step
2.54 x 5.08 x 10.1 mm
