avena-robotics/pcbs/UNIVERSAL_JOINT_v3_5/UNIVERSAL_JOINT/3dmodels/MA730GQ-Z.step

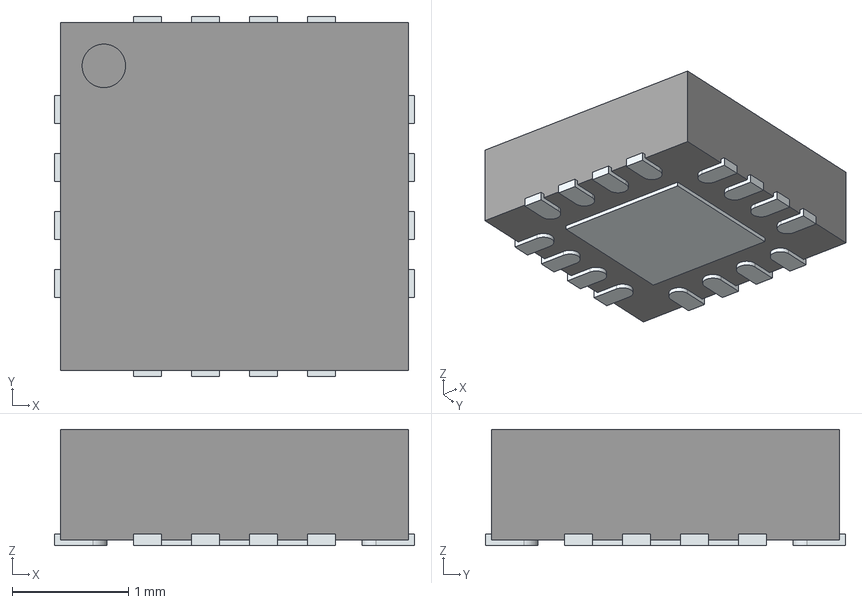
[picture p57: CAD file, 2022-01-12]
UNIVERSAL_JOINT_v3_5/UNIVERSAL_JOINT/3dmodels/MA730GQ-Z.step
3.10 x 3.10 x 1.00 mm
ThermalPin
PinsArrayLR
PinsArrayTB
