avena-robotics/pcbs/common_libraries/3dmodels/D_SOD-123.step

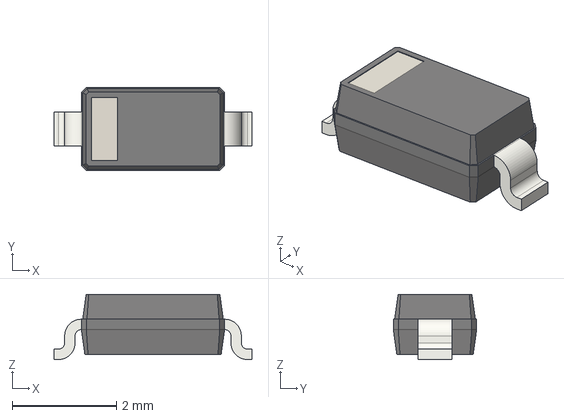
[picture p58: CAD file, 2022-01-12]
common_libraries/3dmodels/D_SOD-123.step
3.80 x 1.60 x 1.25 mm
