avena-robotics/pcbs/common_libraries/3dmodels/C_1210_3225Metric.step

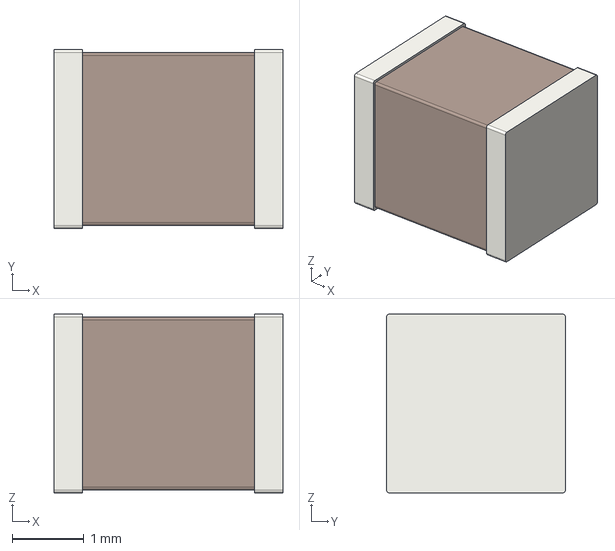
[picture p59: CAD file, 2022-01-12]
common_libraries/3dmodels/C_1210_3225Metric.step
3.20 x 2.50 x 2.50 mm
