avena-robotics/pcbs/UNIVERSAL_JOINT_v3_5/UNIVERSAL_JOINT/3dmodels/SOT-23.step

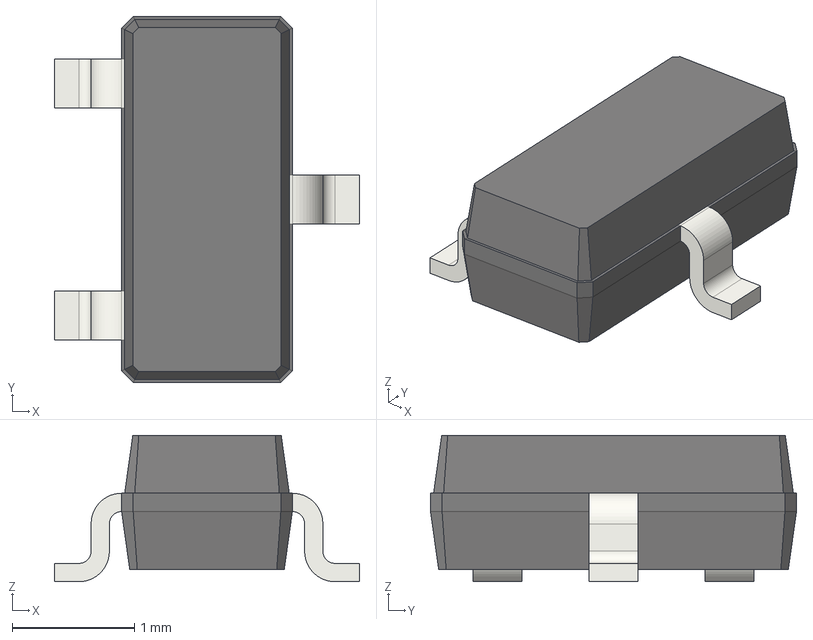
[picture p60: CAD file, 2022-01-12]
UNIVERSAL_JOINT_v3_5/UNIVERSAL_JOINT/3dmodels/SOT-23.step
2.50 x 3.00 x 1.20 mm
