avena-robotics/pcbs/common_libraries/3dmodels/C_1206_3216Metric.step

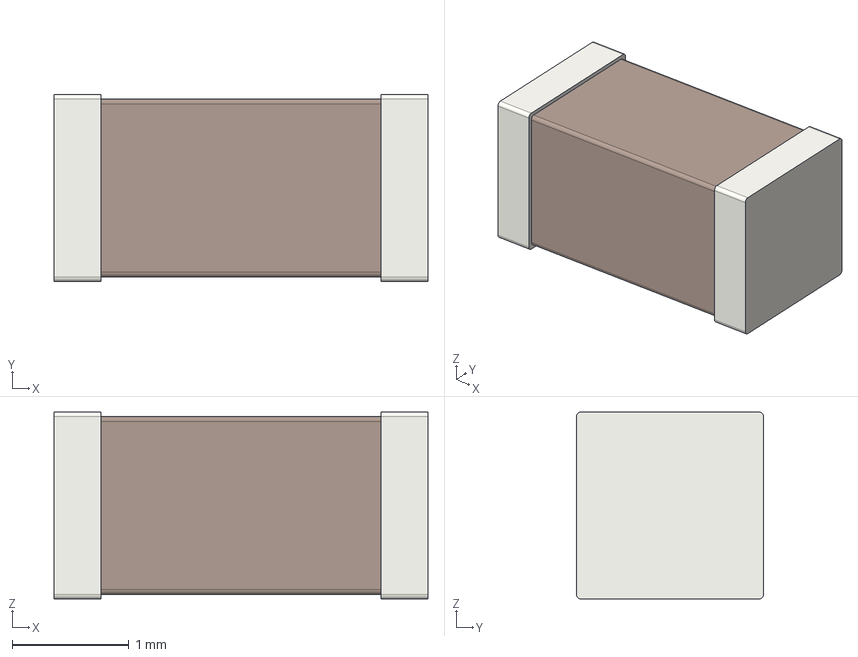
[picture p61: CAD file, 2022-01-12]
common_libraries/3dmodels/C_1206_3216Metric.step
3.20 x 1.60 x 1.60 mm
