avena-robotics/pcbs/UNIVERSAL_JOINT_v3_5/UNIVERSAL_JOINT/3dmodels/ECS-240-8-36B2-CKM-TR.step

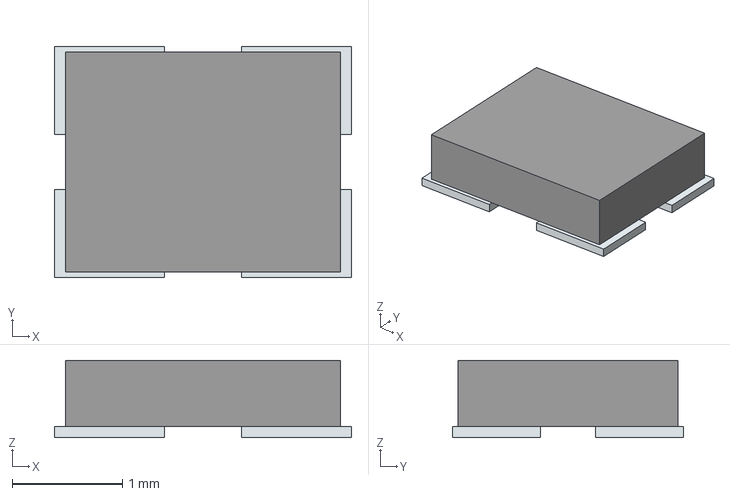
[picture p62: CAD file, 2022-01-12]
UNIVERSAL_JOINT_v3_5/UNIVERSAL_JOINT/3dmodels/ECS-240-8-36B2-CKM-TR.step
2.70 x 2.10 x 0.7 mm
Pins
