avena-robotics/pcbs/common_libraries/3dmodels/D_SMA.step

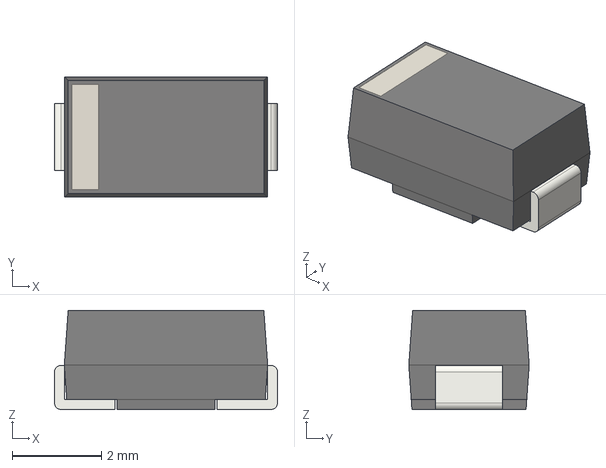
[picture p63: CAD file, 2022-01-12]
common_libraries/3dmodels/D_SMA.step
5.00 x 2.70 x 2.22 mm
