avena-robotics/pcbs/UNIVERSAL_JOINT_v3_5/UNIVERSAL_JOINT/3dmodels/TCAN332G.step

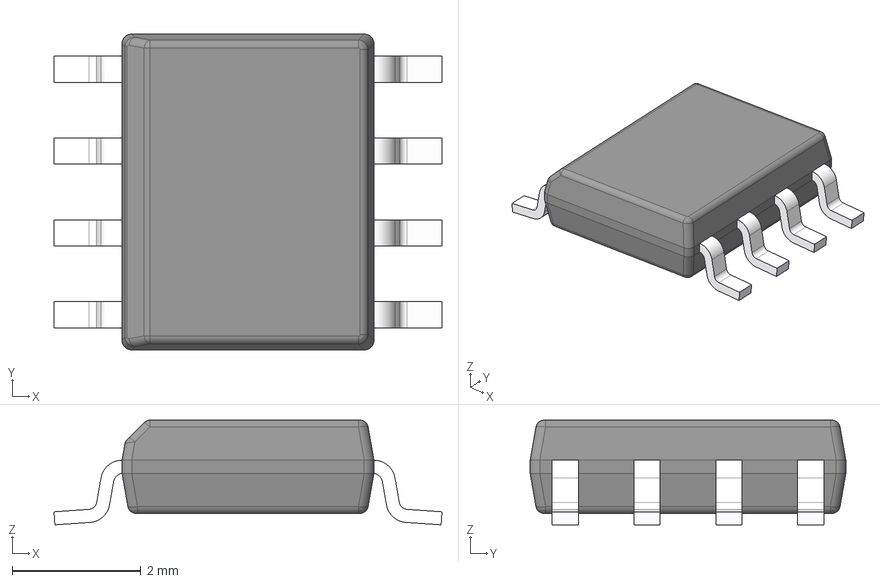
[picture p64: CAD file, 2021-12-10]
UNIVERSAL_JOINT_v3_5/UNIVERSAL_JOINT/3dmodels/TCAN332G.step
6.02 x 4.90 x 1.63 mm
BODY-SO
LEAD-D0008A x 8
