avena-robotics/pcbs/common_libraries/3dmodels/PinSocket_2x20_P2.54mm_Vertical.step

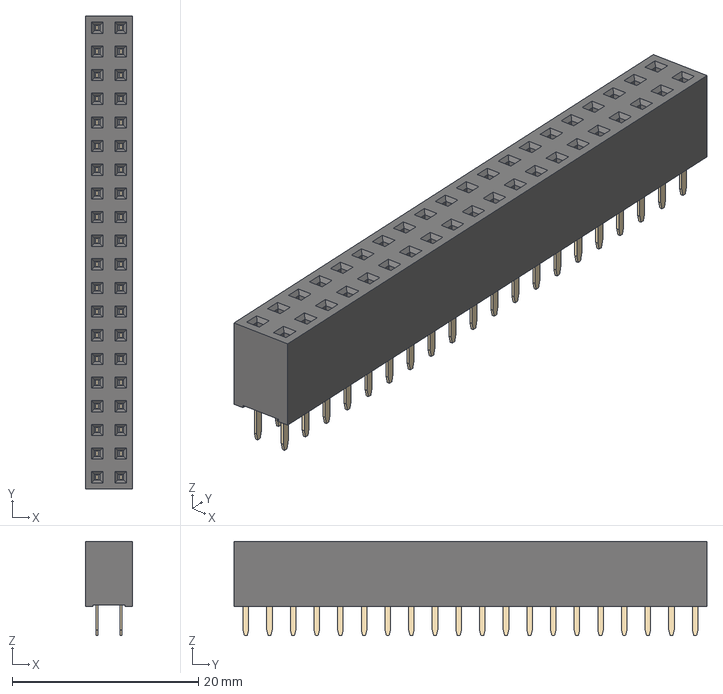
[picture p65: CAD file, 2022-01-12]
common_libraries/3dmodels/PinSocket_2x20_P2.54mm_Vertical.step
5.08 x 50.8 x 10.1 mm
