avena-robotics/pcbs/common_libraries/3dmodels/R_0805_2012Metric.step

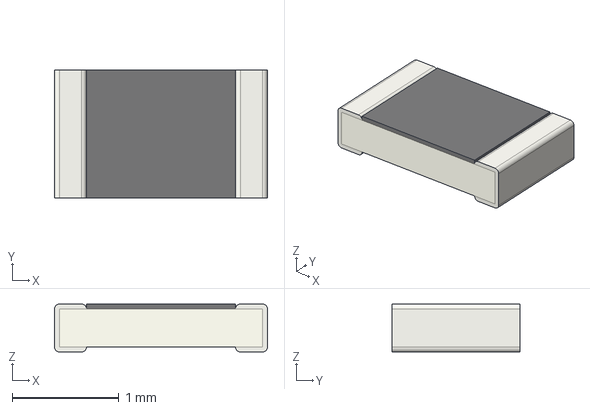
[picture p66: CAD file, 2021-12-10]
common_libraries/3dmodels/R_0805_2012Metric.step
2.00 x 1.20 x 0.45 mm
