avena-robotics/pcbs/UNIVERSAL_JOINT_v3_5/UNIVERSAL_JOINT/3dmodels/61-2348-11_0030.step

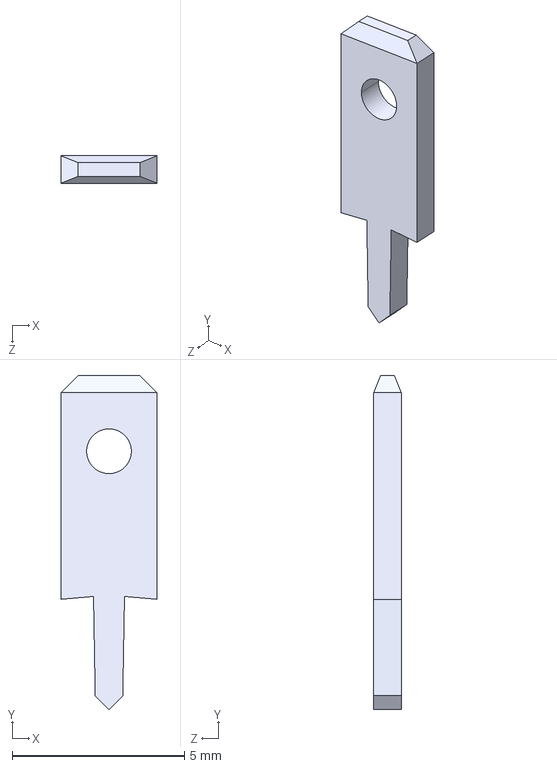
[picture p67: CAD file, 2021-12-08]
UNIVERSAL_JOINT_v3_5/UNIVERSAL_JOINT/3dmodels/61-2348-11_0030.step
2.80 x 9.70 x 0.8 mm
