avena-robotics/pcbs/common_libraries/3dmodels/L_Wuerth_WE-PD2-Typ-MS.step

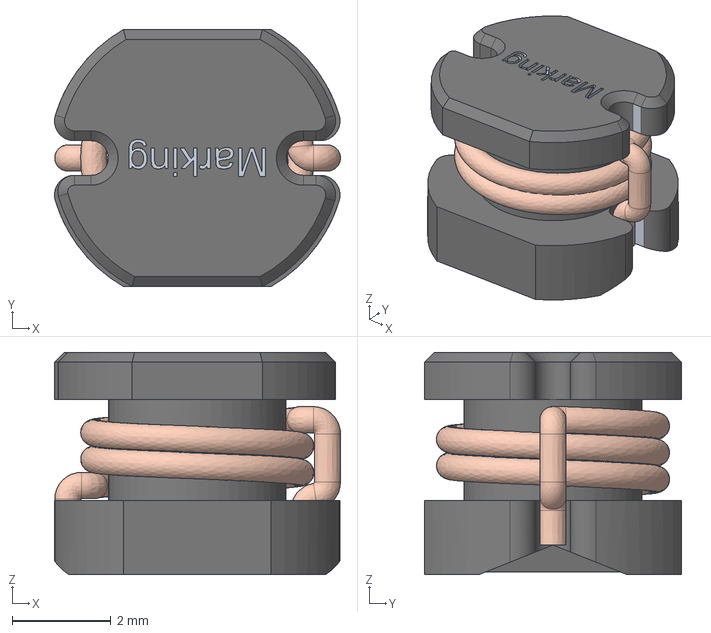
[picture p68: CAD file, 2021-11-30]
common_libraries/3dmodels/L_Wuerth_WE-PD2-Typ-MS.step
5.79 x 5.20 x 4.50 mm
