avena-robotics/pcbs/common_libraries/3dmodels/C_Elec_6.3x7.7.step

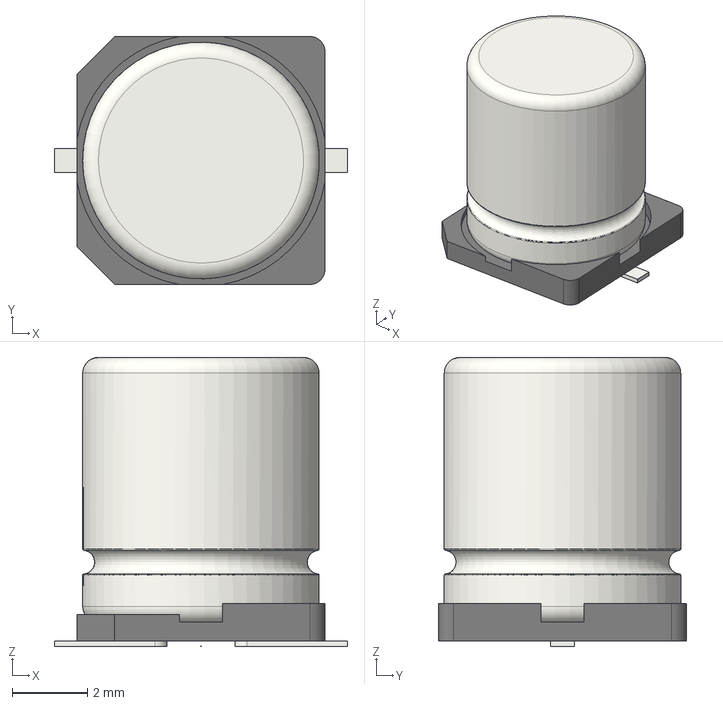
[picture p69: CAD file, 2021-11-14]
common_libraries/3dmodels/C_Elec_6.3x7.7.step
7.80 x 6.60 x 7.70 mm
