avena-robotics/pcbs/UNIVERSAL_JOINT_v3_5/UNIVERSAL_JOINT/3dmodels/PCU250.step

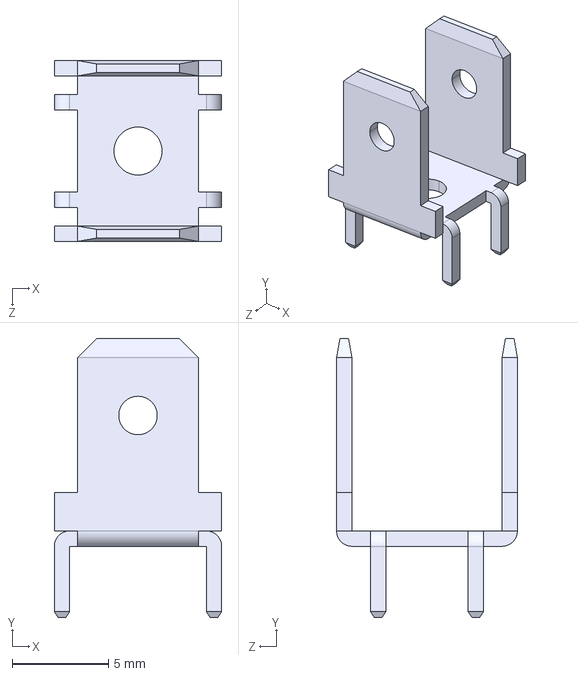
[picture p70: CAD file, 2021-11-30]
UNIVERSAL_JOINT_v3_5/UNIVERSAL_JOINT/3dmodels/PCU250.step
8.70 x 14.5 x 9.40 mm
