avena-robotics/pcbs/common_libraries/3dmodels/C_Elec_10x10.2.step

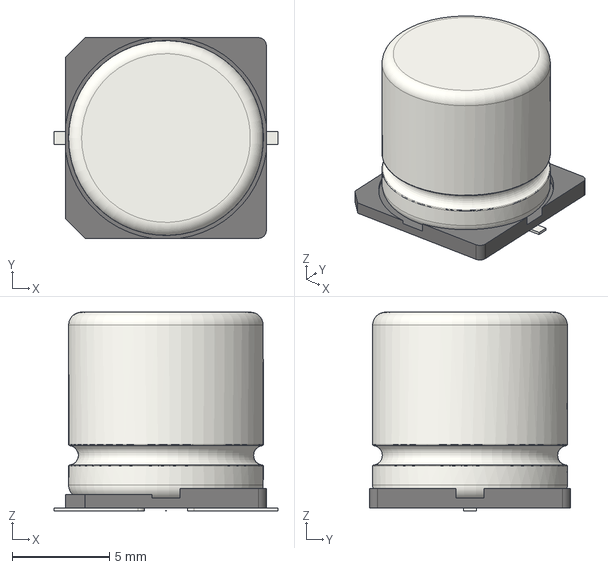
[picture p71: CAD file, 2021-11-14]
common_libraries/3dmodels/C_Elec_10x10.2.step
11.5 x 10.3 x 10.2 mm
