avena-robotics/pcbs/UNIVERSAL_JOINT_v3_5/UNIVERSAL_JOINT/3dmodels/1-726388-2.step

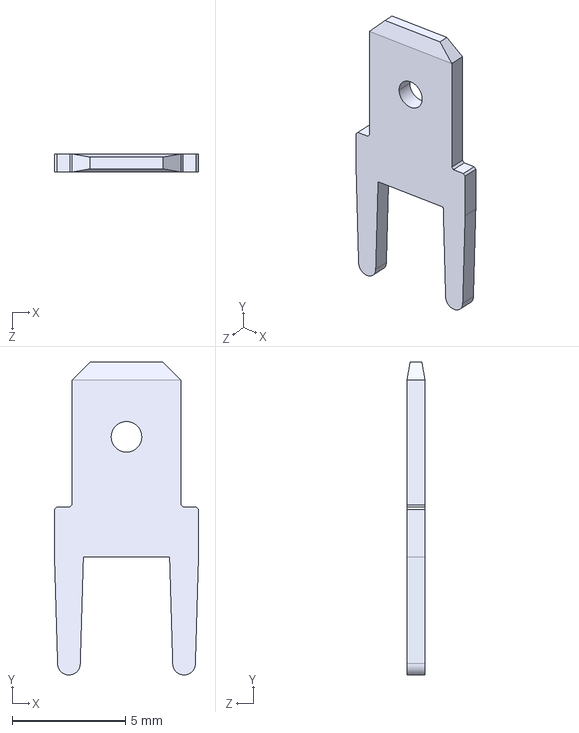
[picture p72: CAD file, 2021-11-30]
UNIVERSAL_JOINT_v3_5/UNIVERSAL_JOINT/3dmodels/1-726388-2.step
6.35 x 13.8 x 0.8 mm
