avena-robotics/pcbs/common_libraries/3dmodels/C_Elec_3x5.4.step

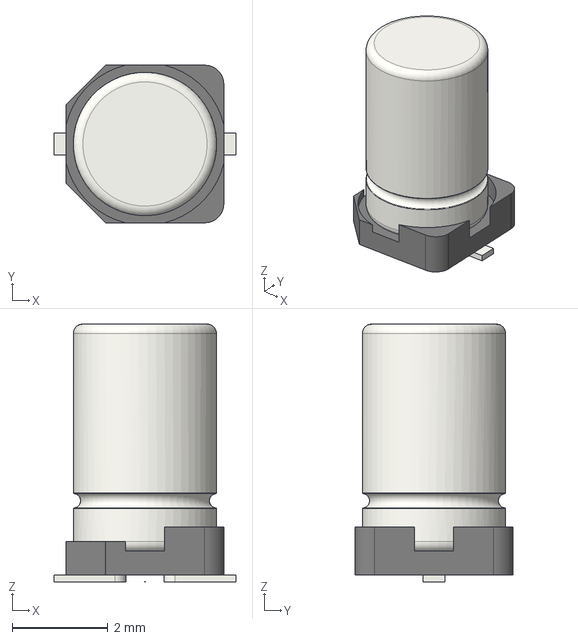
[picture p73: CAD file, 2021-11-14]
common_libraries/3dmodels/C_Elec_3x5.4.step
3.80 x 3.30 x 5.40 mm
