avena-robotics/pcbs/UNIVERSAL_JOINT_v3_5/UNIVERSAL_JOINT/3dmodels/FTSH-107-01-L-DV-K-TR.step

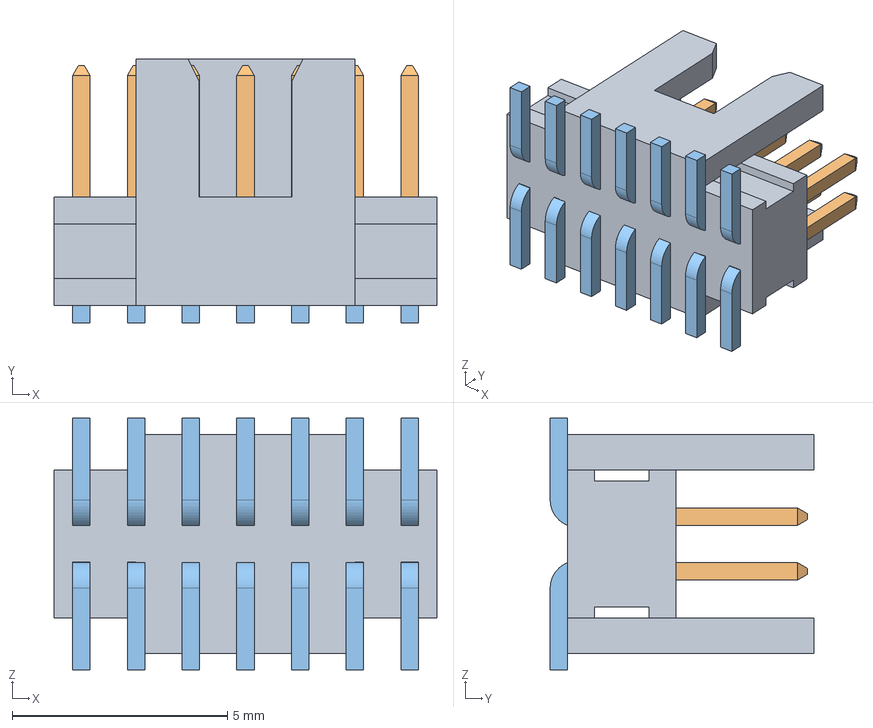
[picture p74: CAD file, 2021-11-14]
UNIVERSAL_JOINT_v3_5/UNIVERSAL_JOINT/3dmodels/FTSH-107-01-L-DV-K-TR.step
8.89 x 6.12 x 5.84 mm
_FTSH-107-01-L-DV-K-TR_body
_FTSH-107-01-L-DV-K-TR_pins1
_FTSH-107-01-L-DV-K-TR_pins2
