avena-robotics/pcbs/common_libraries/3dmodels/C_Elec_4x5.4.step

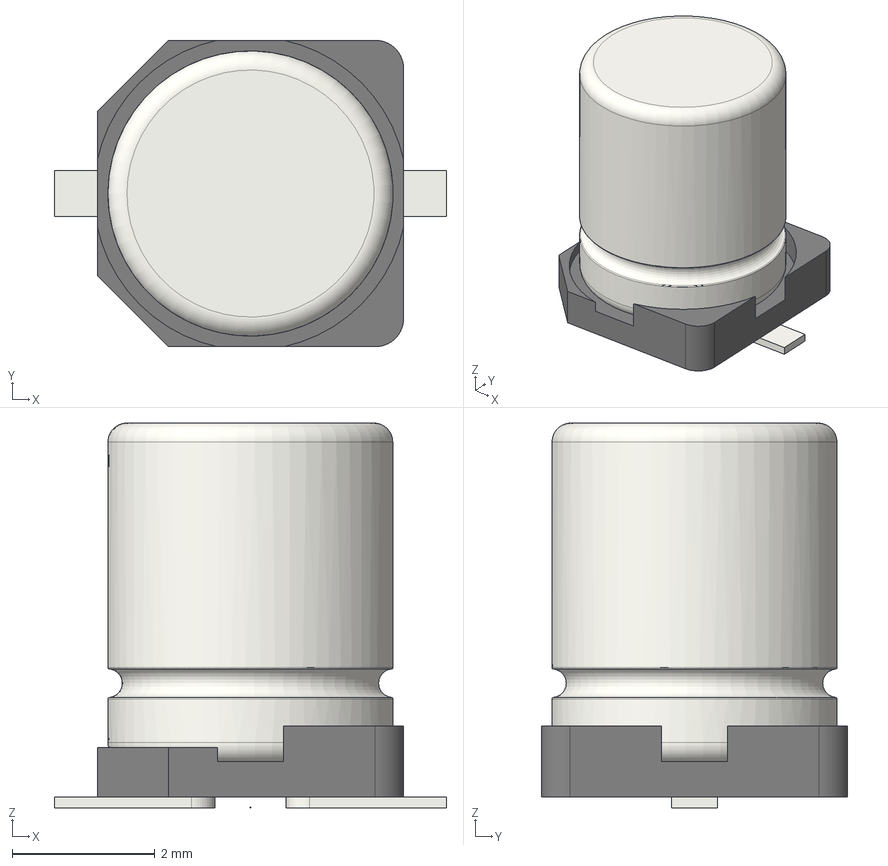
[picture p75: CAD file, 2021-11-14]
common_libraries/3dmodels/C_Elec_4x5.4.step
5.50 x 4.30 x 5.40 mm
