avena-robotics/pcbs/UNIVERSAL_JOINT_v3_5/UNIVERSAL_JOINT/3dmodels/IAUC120N06S5L.step

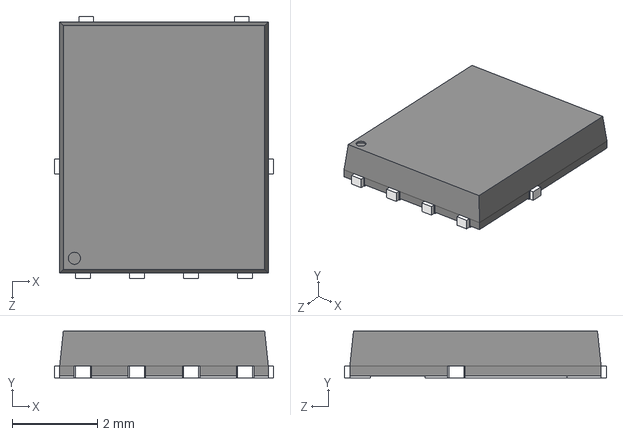
[picture p76: CAD file, 2021-11-14]
UNIVERSAL_JOINT_v3_5/UNIVERSAL_JOINT/3dmodels/IAUC120N06S5L.step
5.15 x 1.10 x 6.15 mm
