avena-robotics/pcbs/common_libraries/3dmodels/C_Elec_5x5.4.step

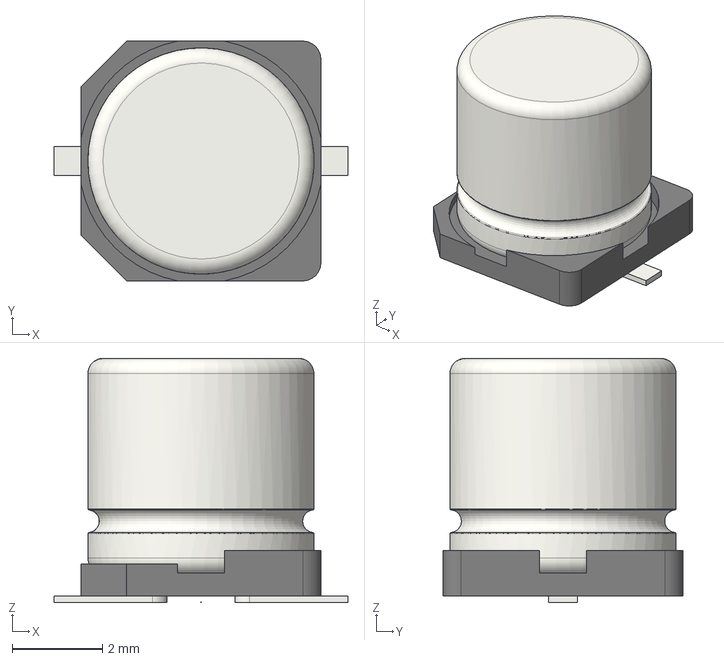
[picture p78: CAD file, 2021-11-14]
common_libraries/3dmodels/C_Elec_5x5.4.step
6.50 x 5.30 x 5.40 mm
