avena-robotics/pcbs/common_libraries/3dmodels/C_Elec_8x5.4.step

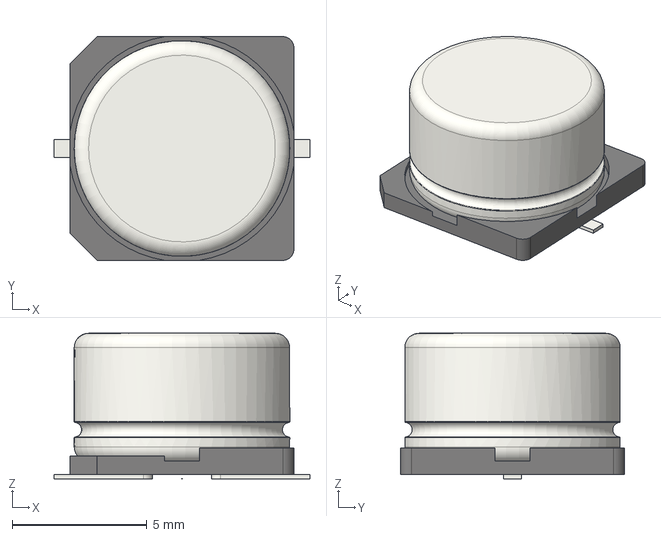
[picture p79: CAD file, 2021-11-14]
common_libraries/3dmodels/C_Elec_8x5.4.step
9.50 x 8.30 x 5.40 mm
