avena-robotics/pcbs/common_libraries/3dmodels/C_Elec_8x6.2.step

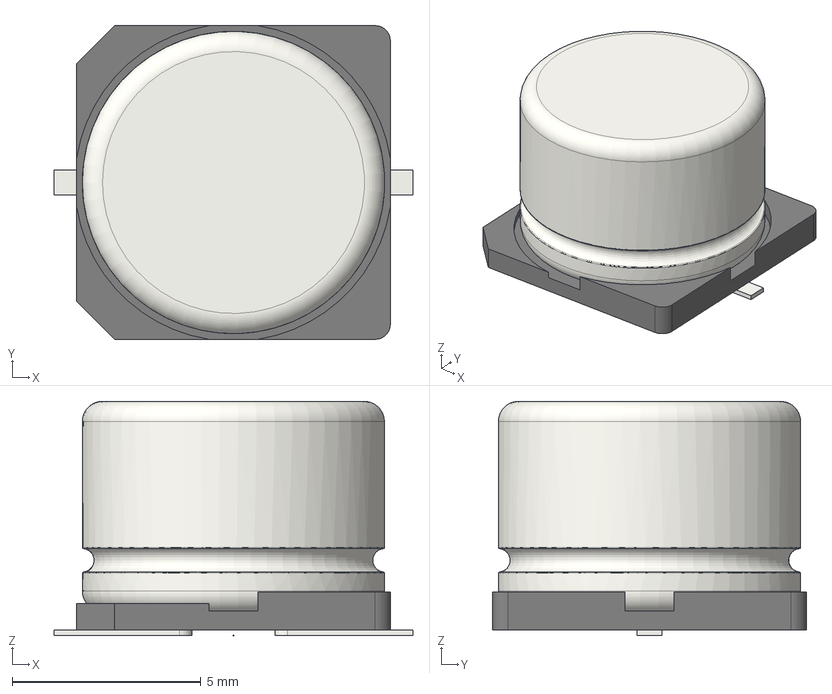
[picture p80: CAD file, 2021-11-14]
common_libraries/3dmodels/C_Elec_8x6.2.step
9.50 x 8.30 x 6.20 mm
