avena-robotics/pcbs/common_libraries/3dmodels/C_Elec_4x5.8.step

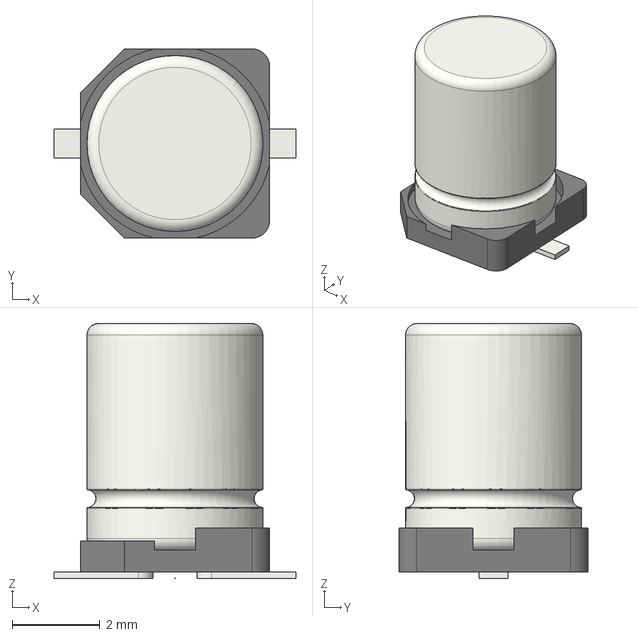
[picture p81: CAD file, 2021-11-14]
common_libraries/3dmodels/C_Elec_4x5.8.step
5.50 x 4.30 x 5.80 mm
