avena-robotics/pcbs/common_libraries/3dmodels/C_Elec_6.3x5.4.step

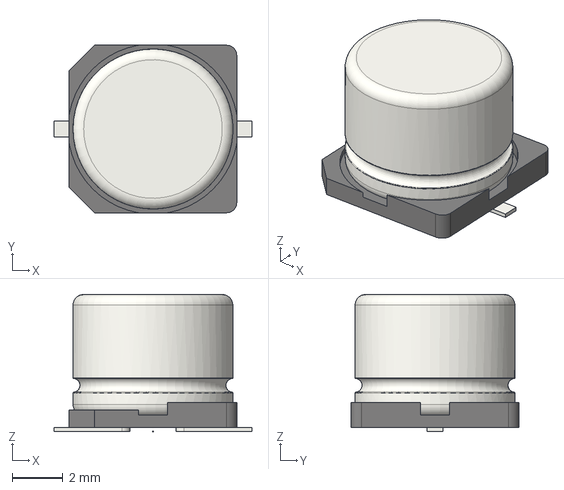
[picture p82: CAD file, 2021-11-14]
common_libraries/3dmodels/C_Elec_6.3x5.4.step
7.80 x 6.60 x 5.40 mm
