avena-robotics/pcbs/common_libraries/3dmodels/C_Elec_6.3x5.8.step

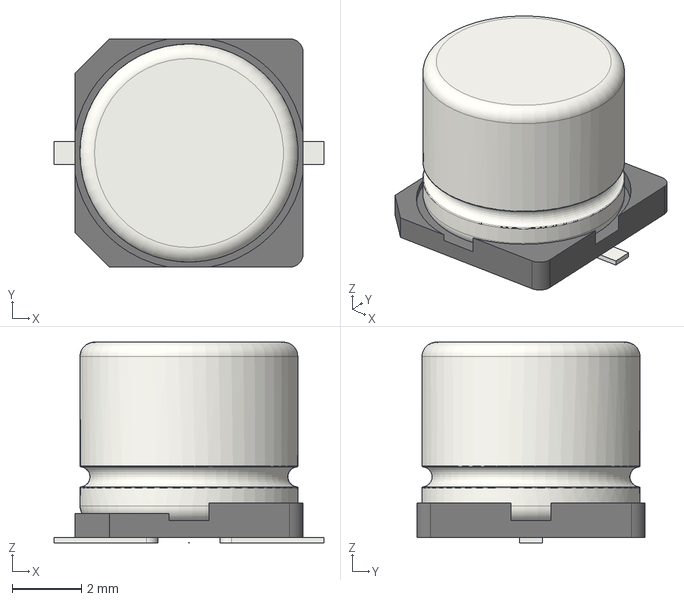
[picture p83: CAD file, 2021-11-14]
common_libraries/3dmodels/C_Elec_6.3x5.8.step
7.80 x 6.60 x 5.80 mm
