avena-robotics/pcbs/(list of files, cad)

Other CAD files:
TACTILE_28UFQFPN_SPI_v2.2/project-3dmodels/CP_Radial_D12.5mm_P7.50mm.step
TACTILE_28UFQFPN_SPI_v2.2/project-3dmodels/CP_Radial_D12.5mm_P5.00mm.step
UNIVERSAL_JOINT_v3_5/UNIVERSAL_JOINT/3dmodels/QFN_IN32G4_STM.step
UNIVERSAL_JOINT_v3_5/UNIVERSAL_JOINT/3dmodels/SKHUALE010.step
ARM_NUCLEO_HAT_1.1/ARM_NUCLEO_HAT/3dmodels/01000020Z LITTELFUSE x 20mm.step
ARM_NUCLEO_HAT_1.1/ARM_NUCLEO_HAT/3dmodels/105314-2208.step
IR_LED_PROJECTOR_v0.3/IR_LED_PROJECTOR/3dmodels/JS202011SCQN.step
IR_LED_PROJECTOR_v0.3/ir_led_projector_v0.1.step
TACTILE_28UFQFPN_SPI_v2.1/TACTILE_28UFQFPN_SPI_v2.1.step
UNIVERSAL_HALL_PCB_RI70_v2.9/universal_hall_pcb_RI70_v2.9.step
UNIVERSAL_HALL_PCB_RI70_v2.9/universal_hall_pcb_v2.9.step
UNIVERSAL_JOINT_v2_2/UNIVERSAL_JOINT/3dmodels/C_Radial_D12.5mm_H20.0mm_P5.00mm.step
UNIVERSAL_JOINT_v2_2/UNIVERSAL_JOINT/3dmodels/DRV8323RHRGZR.STEP
UNIVERSAL_JOINT_v2_2/UNIVERSAL_JOINT/3dmodels/LQFP48-7x7mm.step
UNIVERSAL_JOINT_v2_2/UNIVERSAL_JOINT/3dmodels/QFN-3x3_MA710_MNP.step
UNIVERSAL_JOINT_v2_2/UNIVERSAL_JOINT/3dmodels/SMBJ16A-TR.step
UNIVERSAL_JOINT_v2_2/UNIVERSAL_JOINT/3dmodels/SRN4012TA-150M.STEP
UNIVERSAL_JOINT_v2_2/UNIVERSAL_JOINT/3dmodels/STM32G431CBT6.step
UNIVERSAL_JOINT_v2_2/UNIVERSAL_JOINT/3dmodels/STM32G431CBU6.step
UNIVERSAL_JOINT_v2_2/UNIVERSAL_JOINT_v2_2.dxf
UNIVERSAL_JOINT_v3_1/UNIVERSAL_JOINT/3dmodels/M20-7810645.step
UNIVERSAL_JOINT_v3_2/UNIVERSAL_JOINT/3dmodels/QFN-3x3_MA710_MNP.step
UNIVERSAL_JOINT_v3_3/D3-16-33 - PCB kontroler.dxf
UNIVERSAL_JOINT_v3_3/UNIVERSAL_JOINT_v3_3 - powierzchnia oddawania ciepła.DXF
UNIVERSAL_JOINT_v3_4/UNIVERSAL_JOINT/3dmodels/VLS201612HBX-100M-1.step
UNIVERSAL_JOINT_v3_5/UNIVERSAL_JOINT/3dmodels/M20-7810345.step
UNIVERSAL_JOINT_v3_5/UNIVERSAL_JOINT/3dmodels/M50-3600742.step
UNIVERSAL_JOINT_v3_5/UNIVERSAL_JOINT/3dmodels/VLS201612HBX-100M-1.step
