avena-robotics/pcbs/UNIVERSAL_JOINT_v3_5/UNIVERSAL_JOINT_v3_5.kicad_pcb

## KiCad design UNIVERSAL_JOINT_v3_5/UNIVERSAL_JOINT_v3_5.kicad_pcb (2022-07-13)

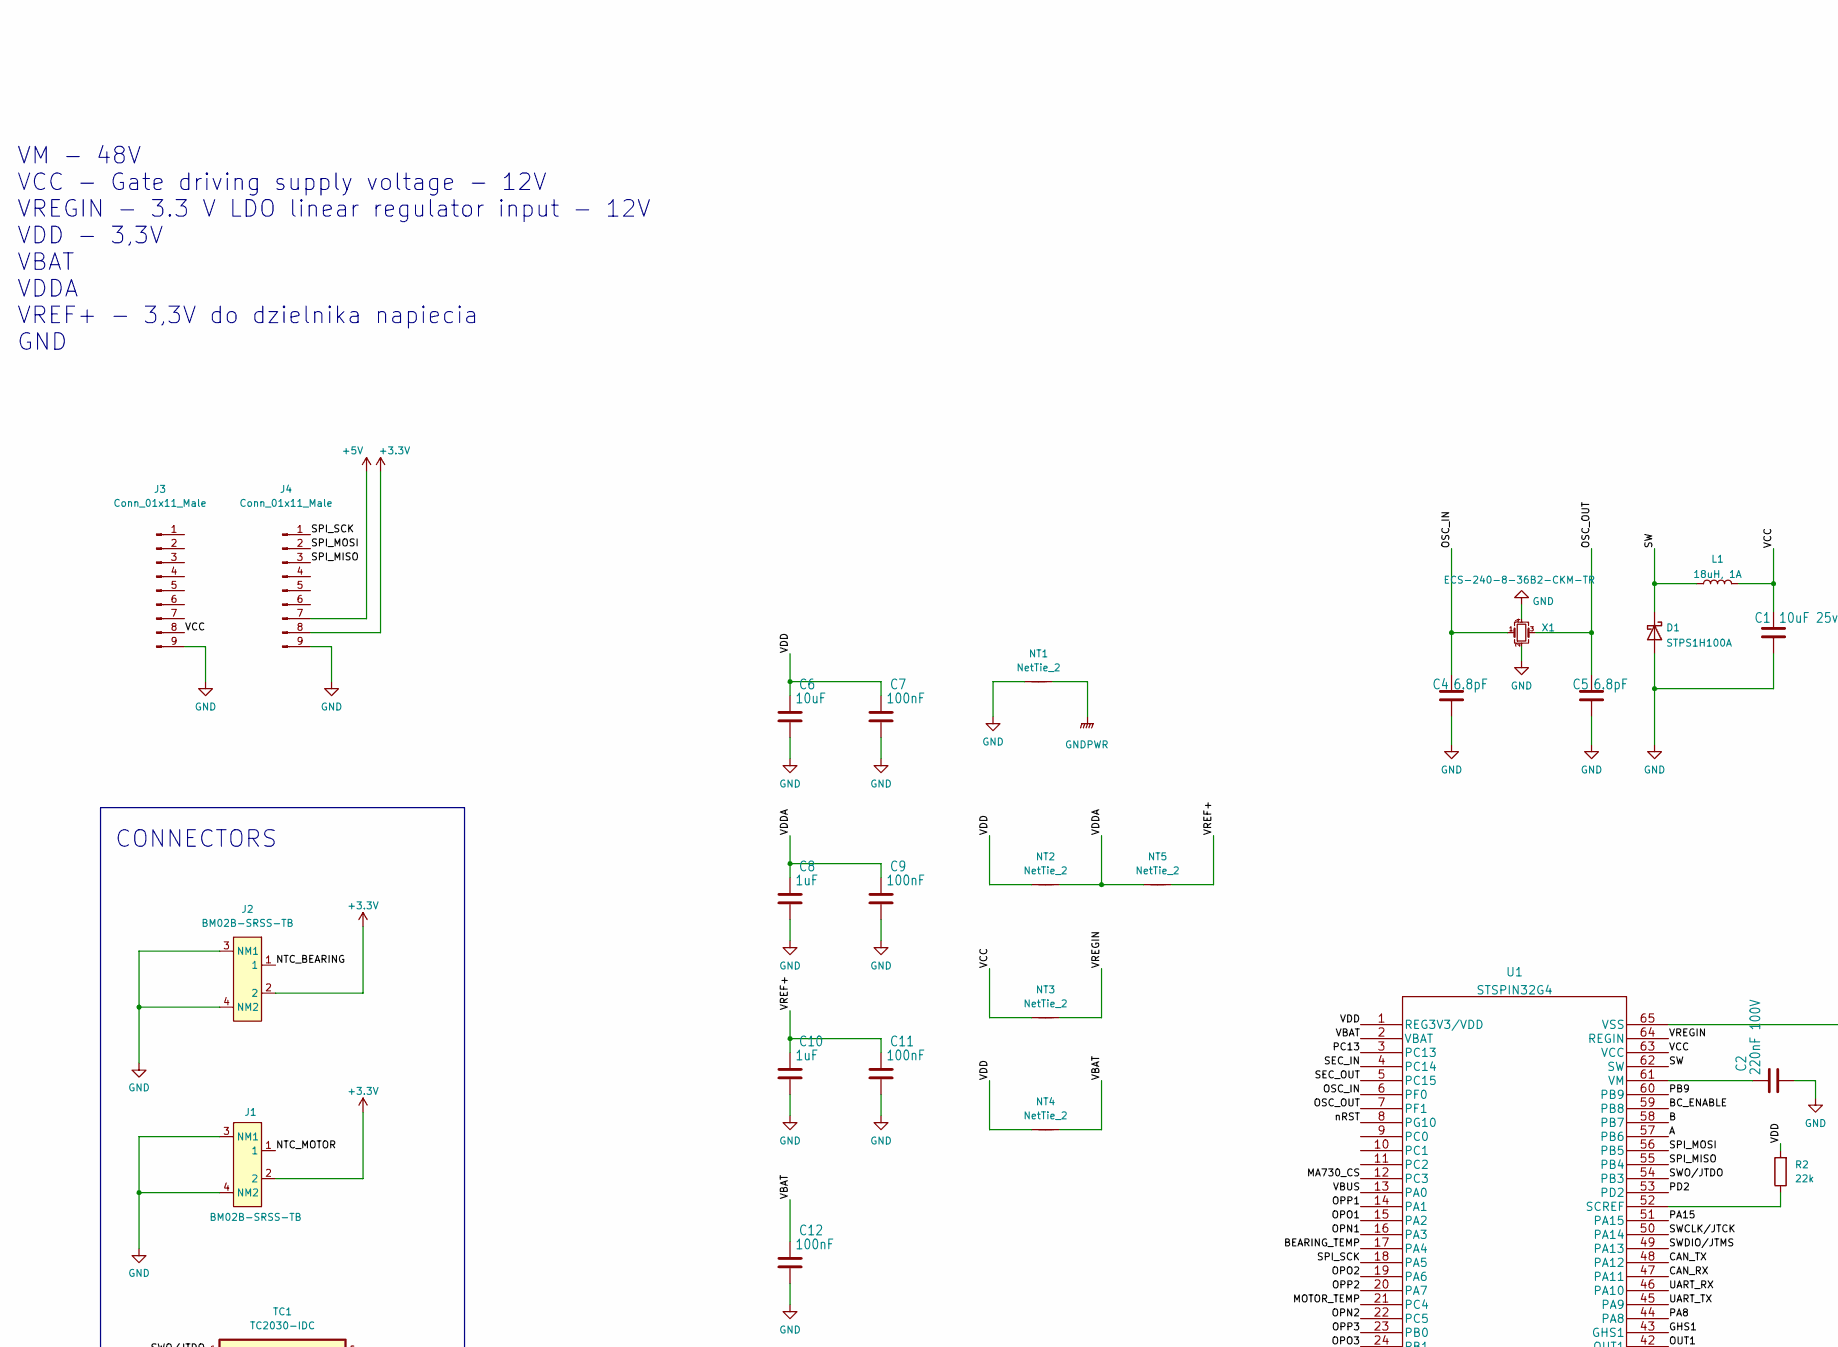
[picture p85: schematic UNIVERSAL_JOINT_v3_5.kicad_sch, part in row 1, column 1]

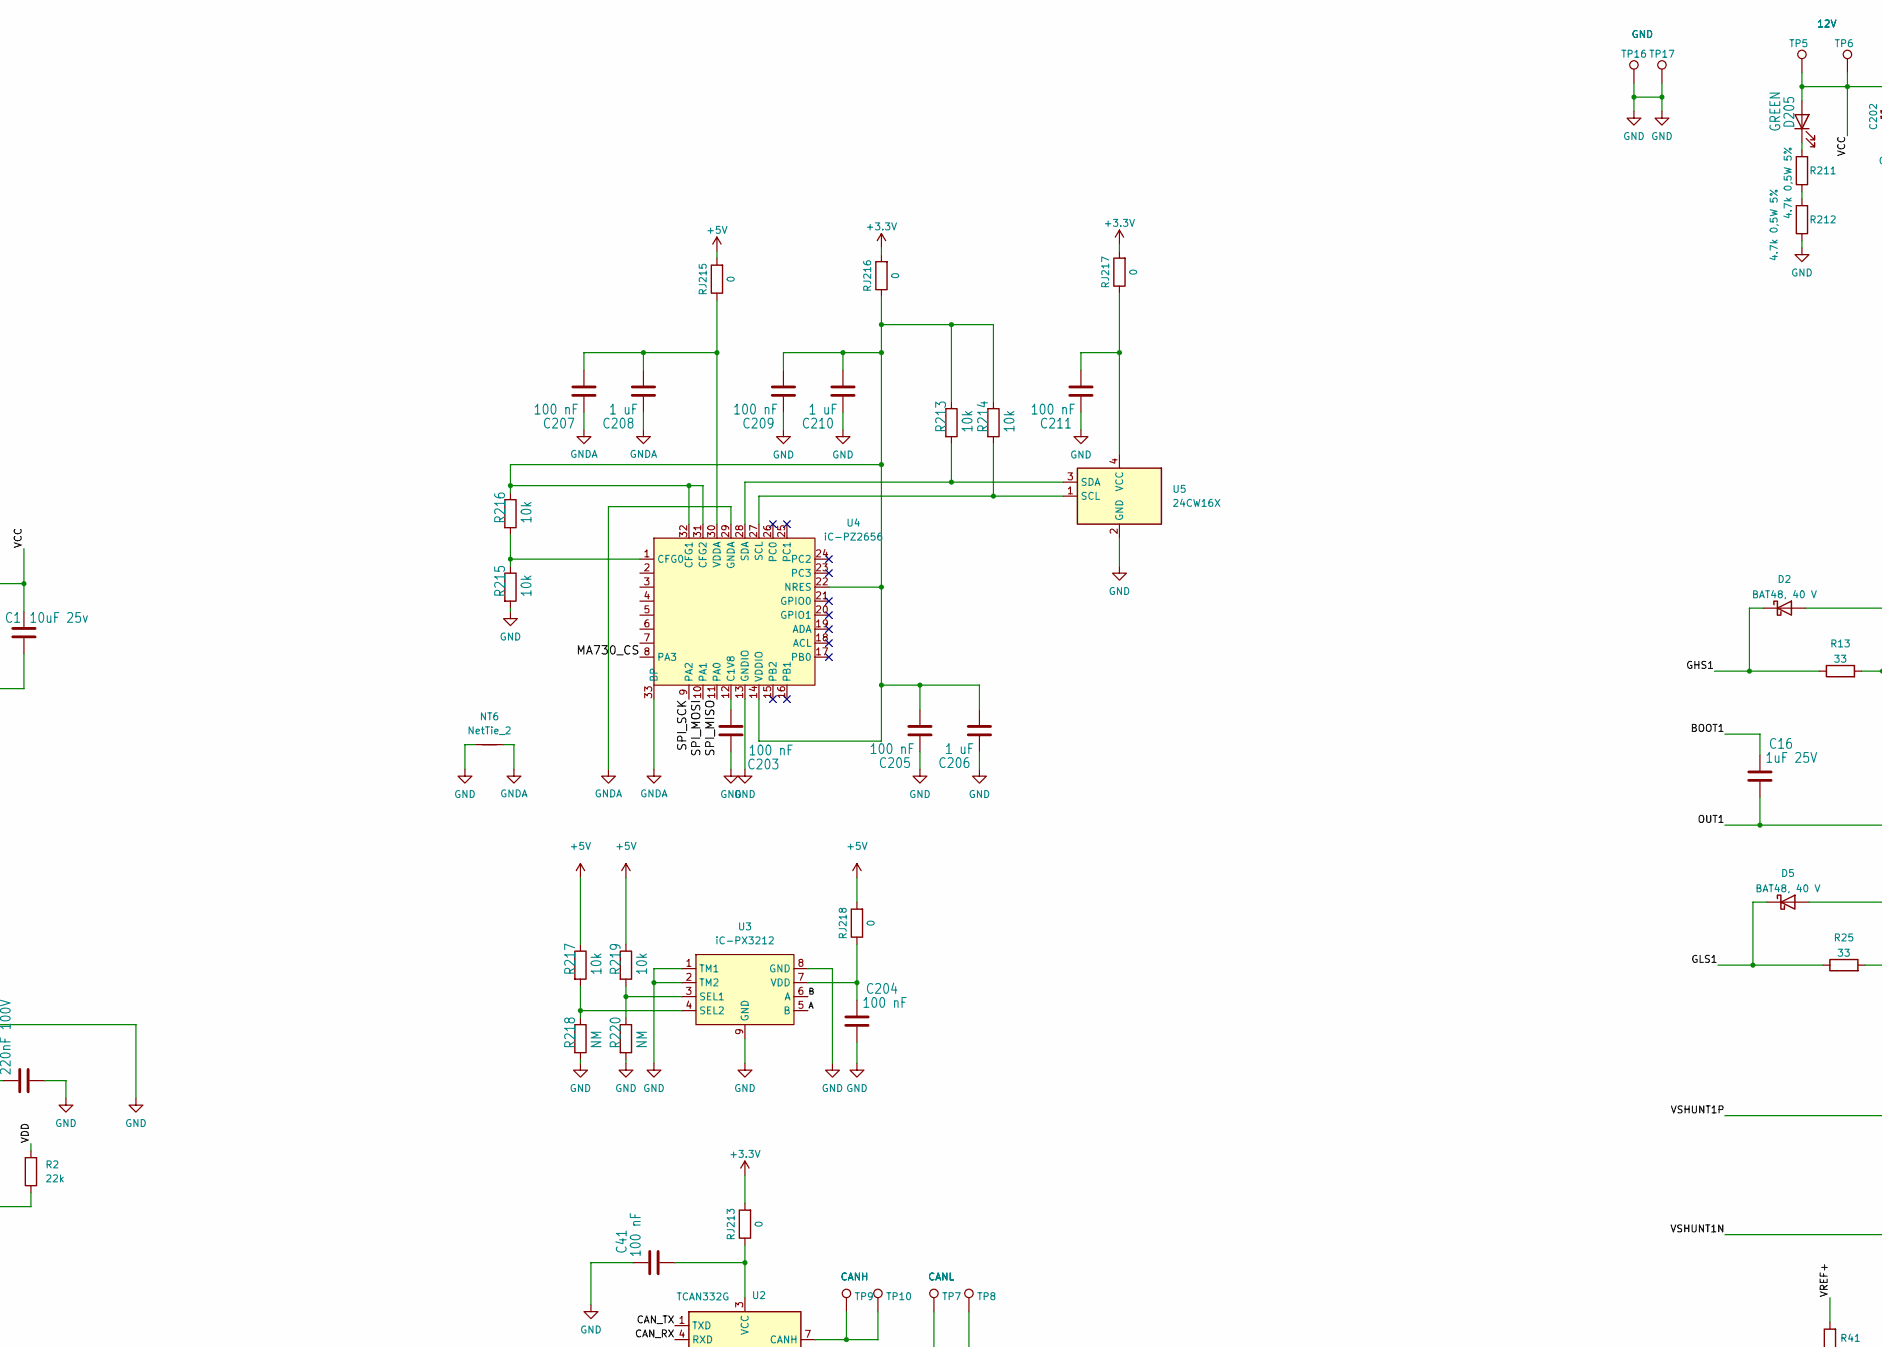
[picture p86: schematic UNIVERSAL_JOINT_v3_5.kicad_sch, part in row 1, column 2]

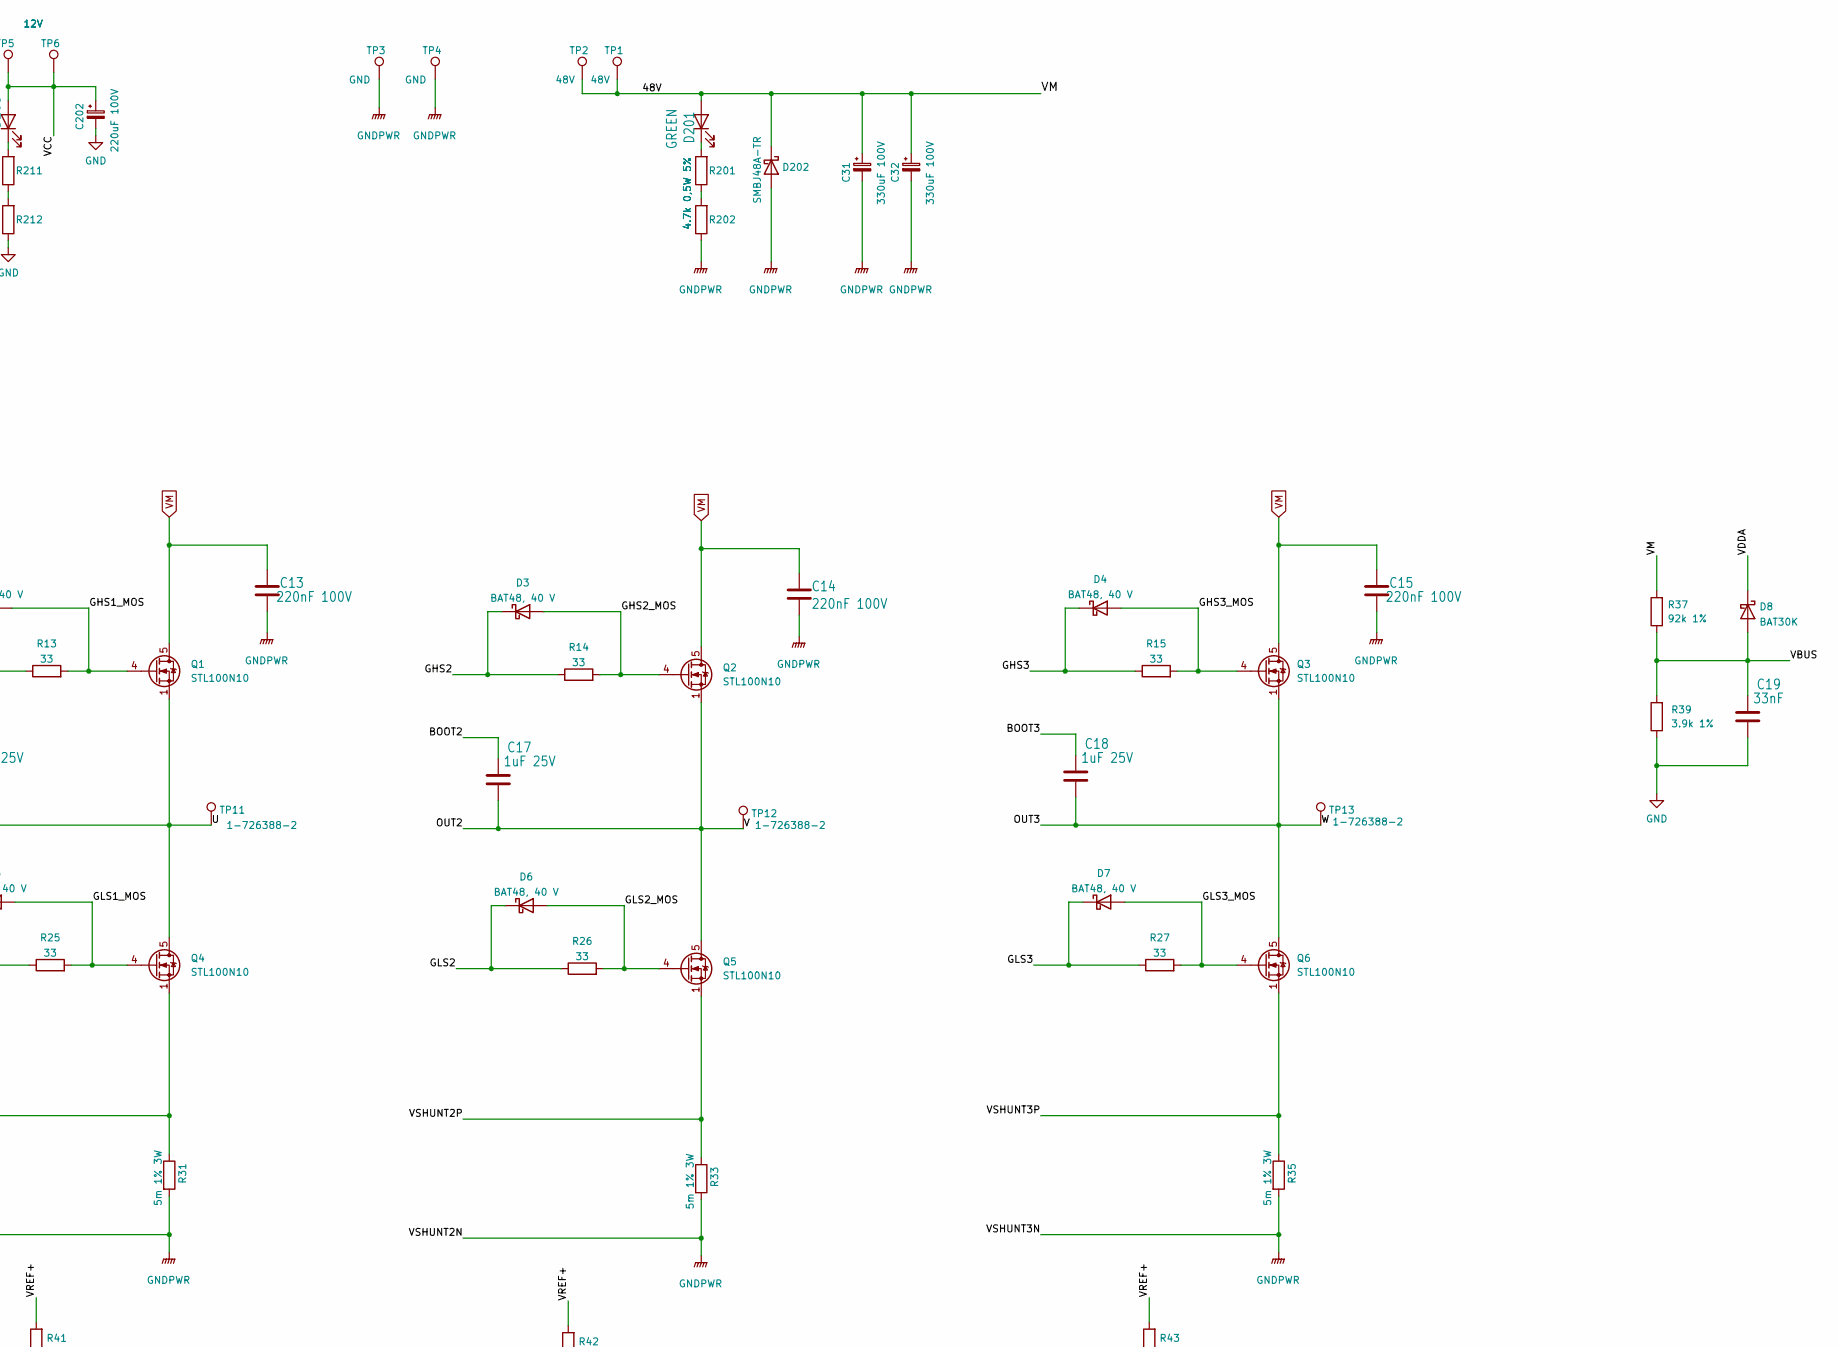
[picture p87: schematic UNIVERSAL_JOINT_v3_5.kicad_sch, part in row 1, column 3]

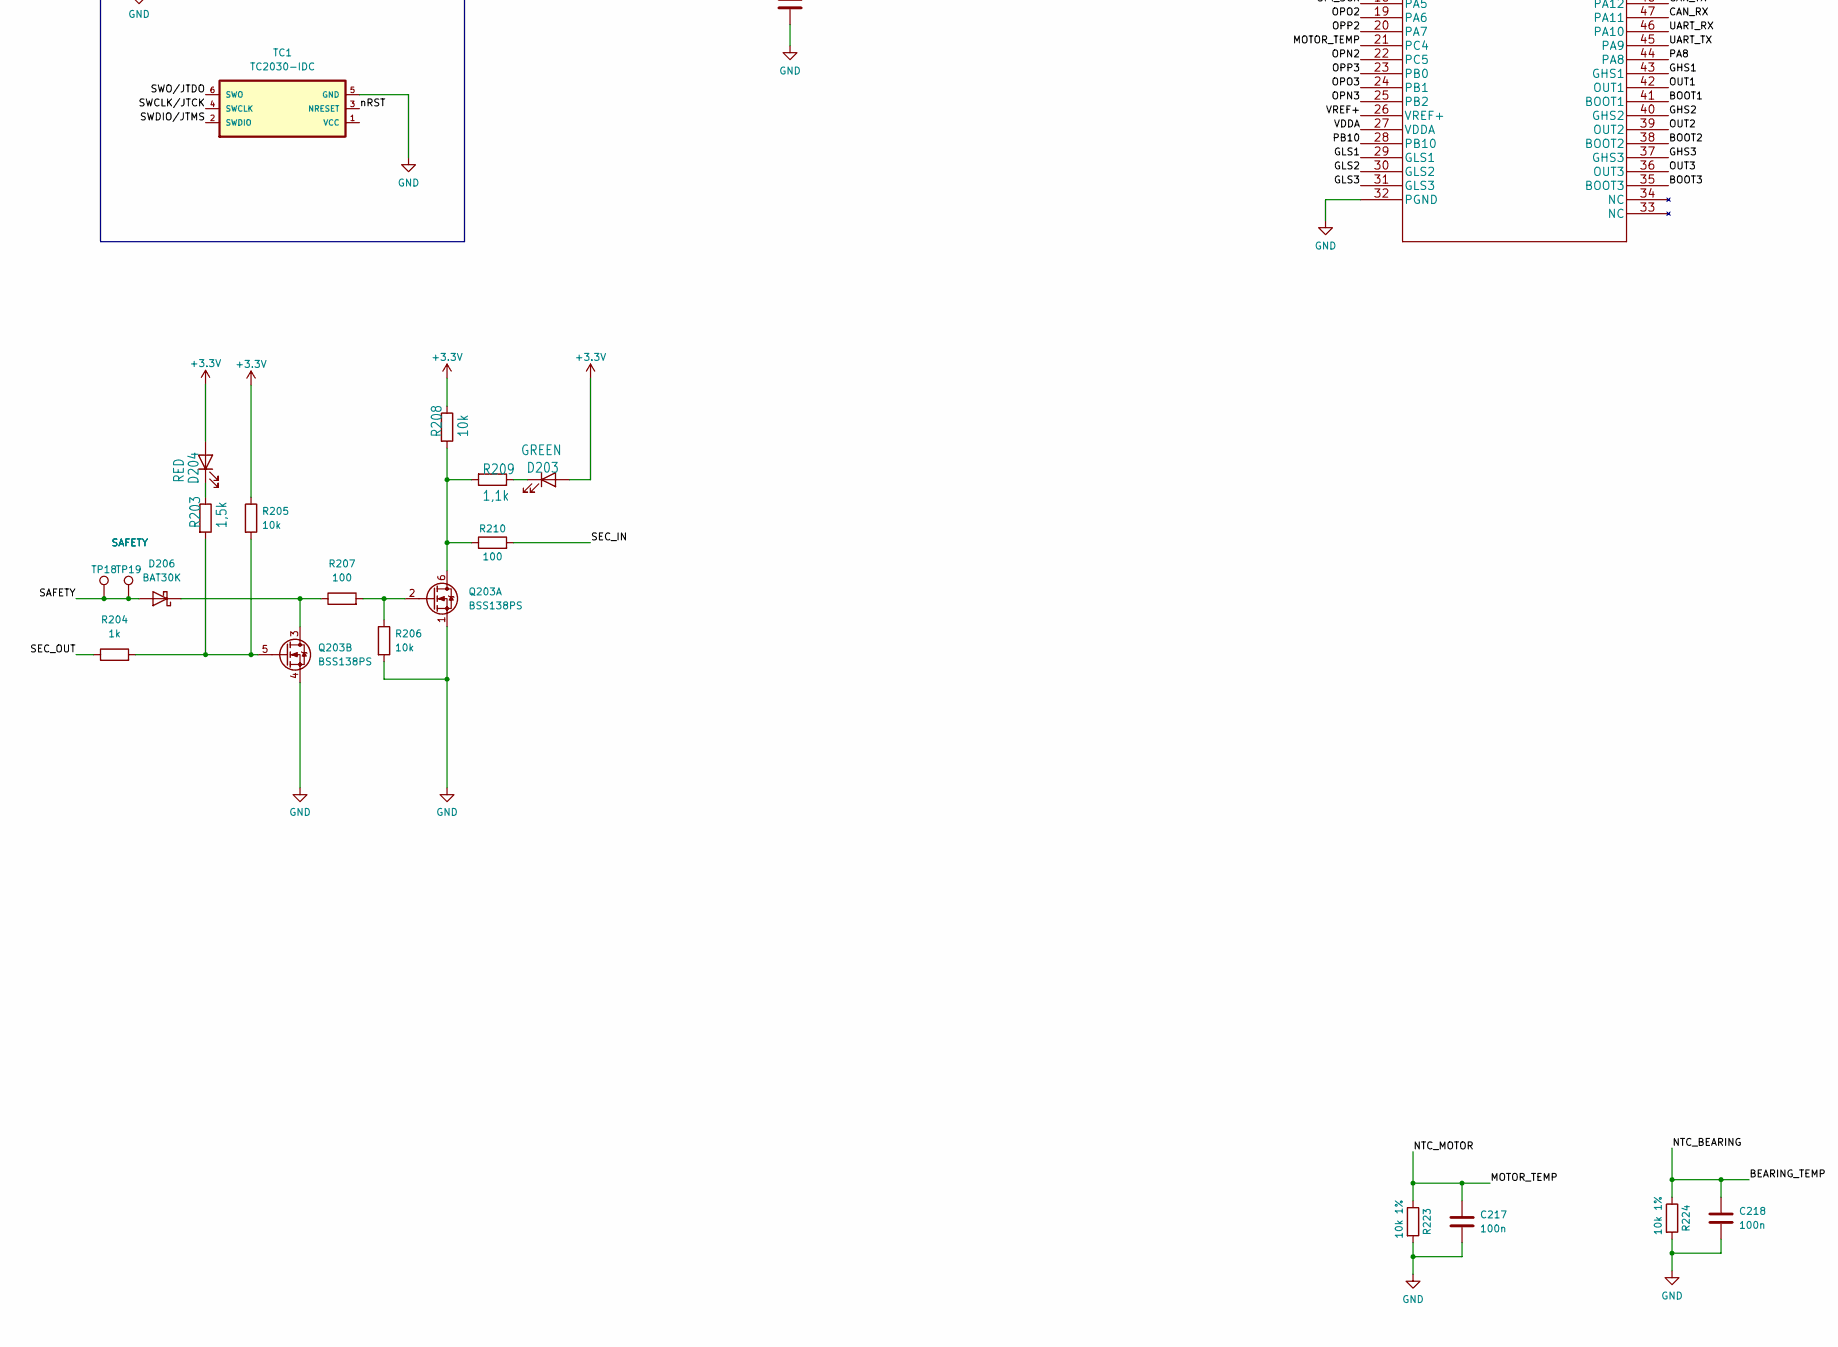
[picture p88: schematic UNIVERSAL_JOINT_v3_5.kicad_sch, part in row 2, column 1]

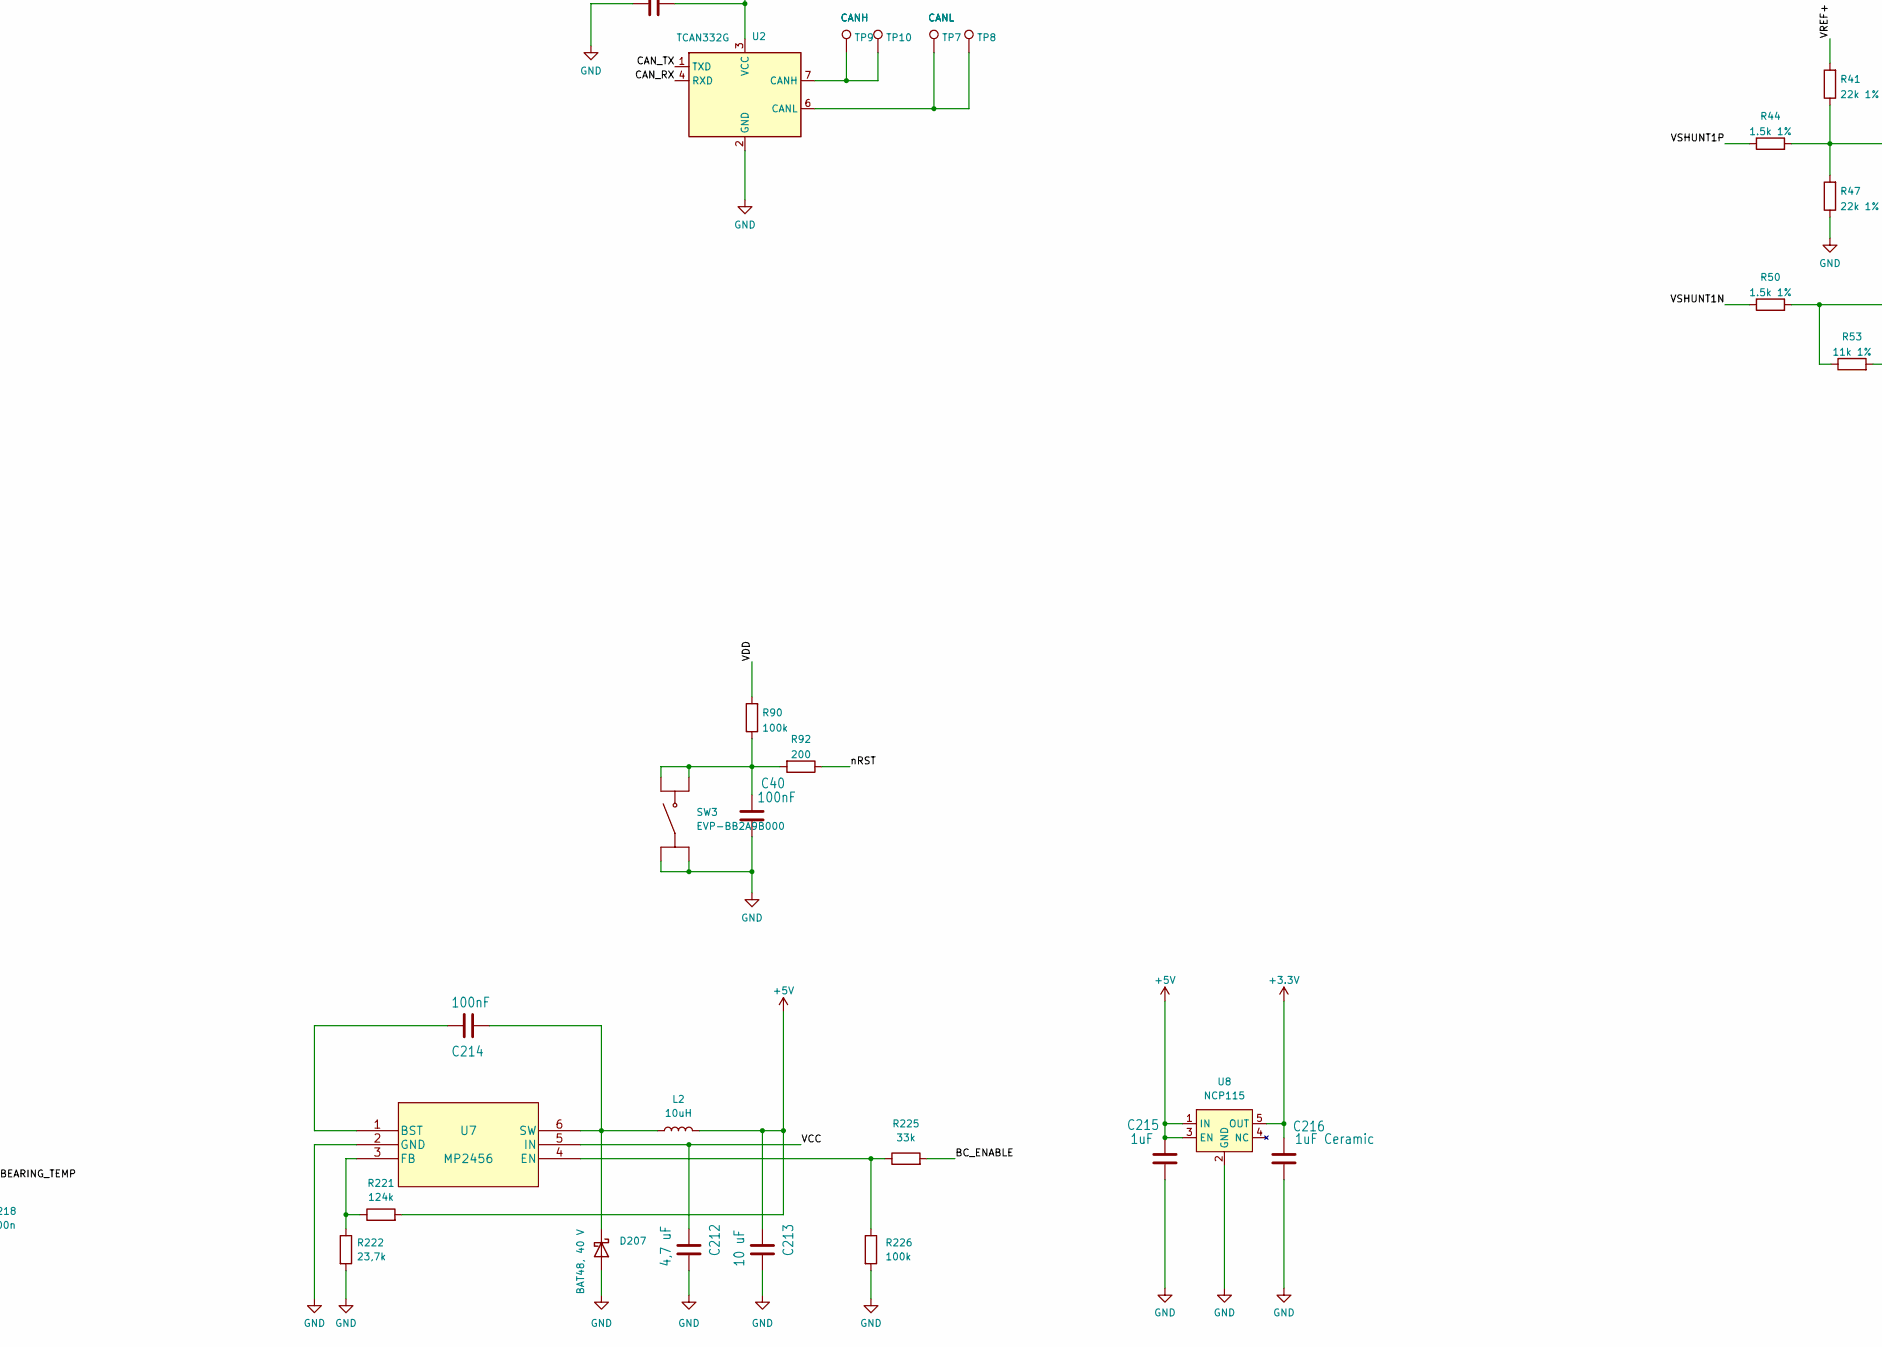
[picture p89: schematic UNIVERSAL_JOINT_v3_5.kicad_sch, part in row 2, column 2]

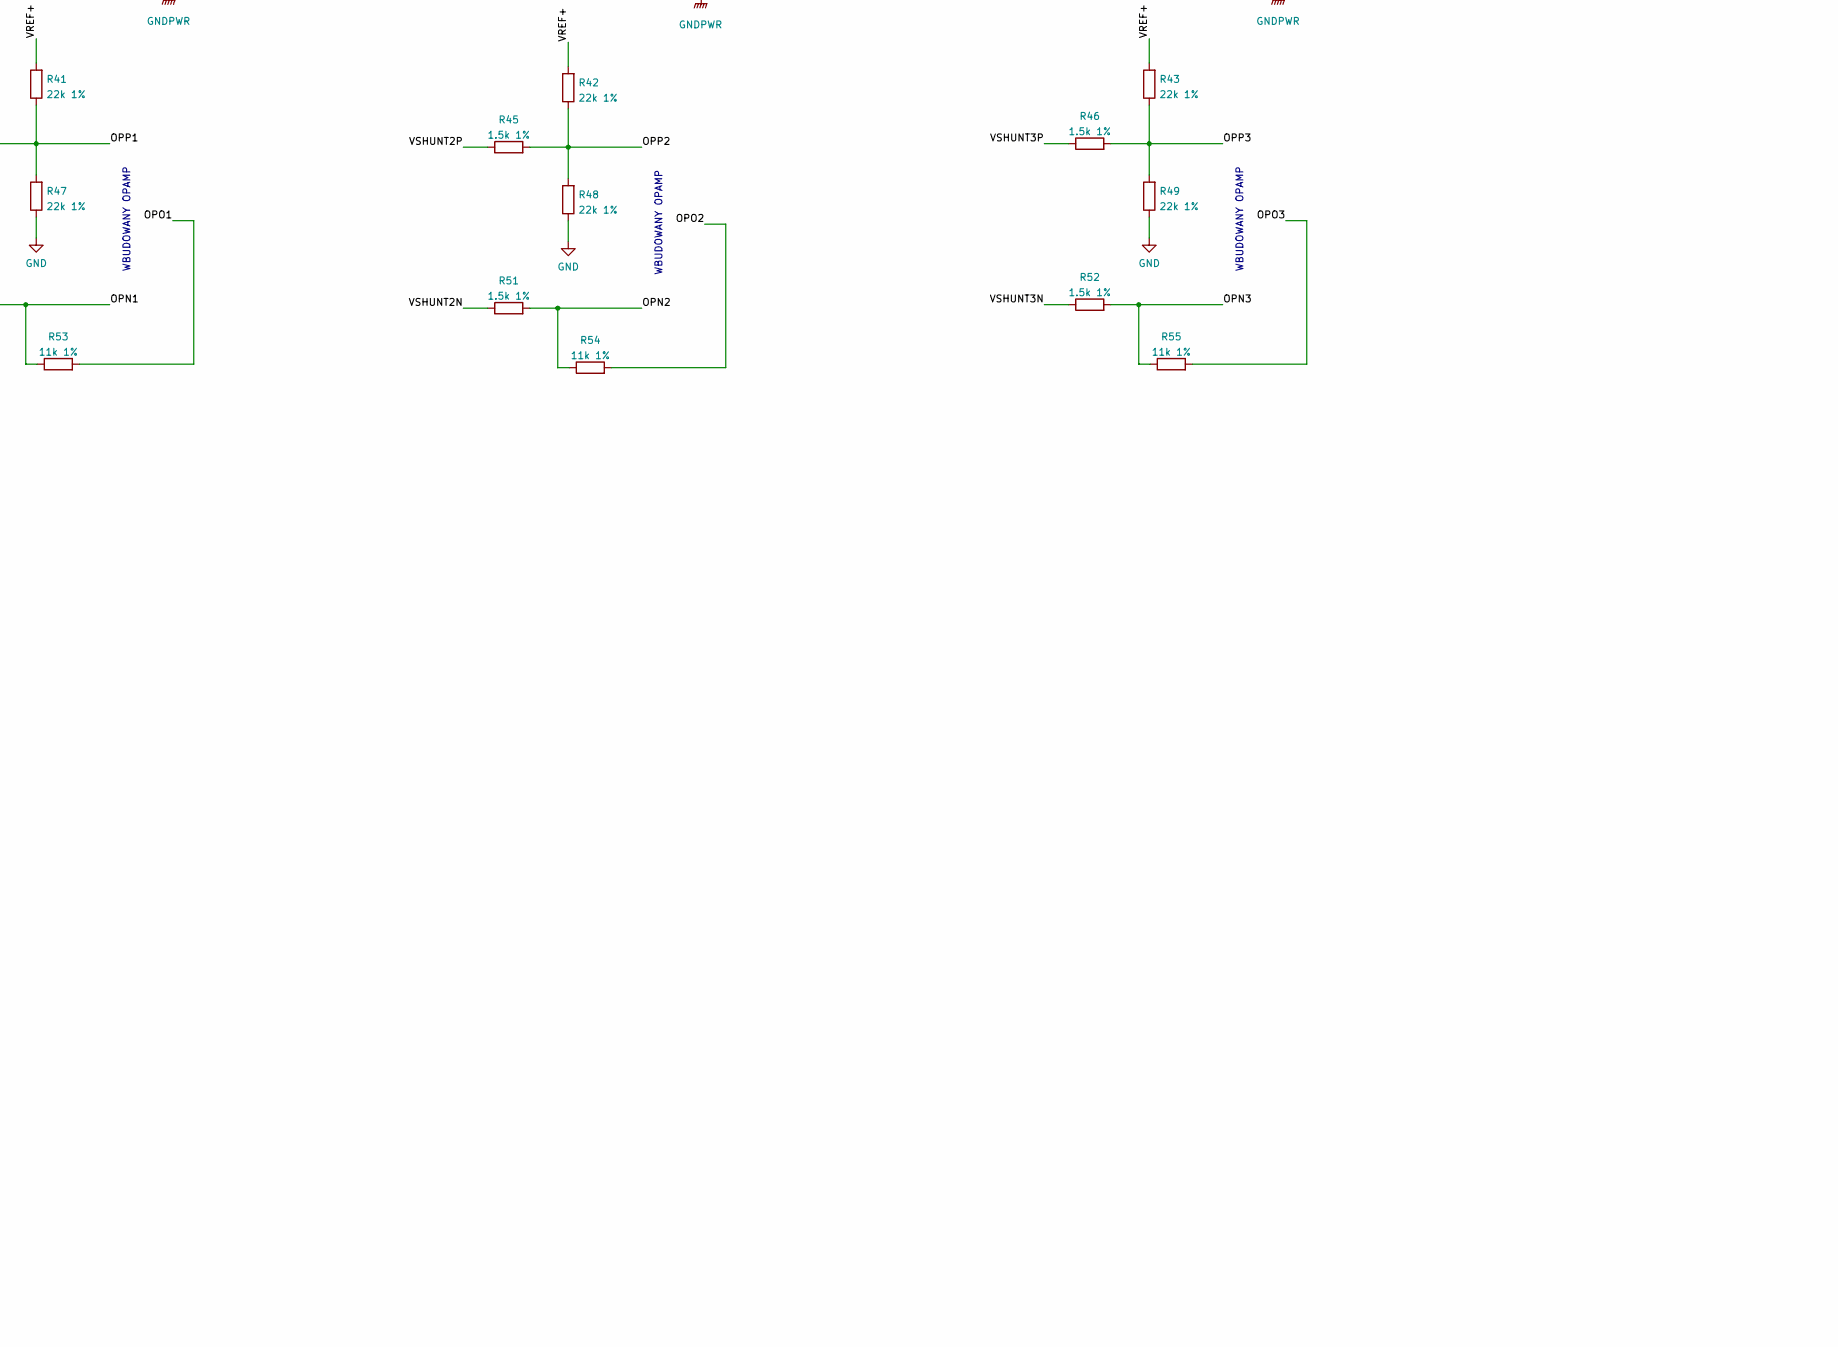
[picture p90: schematic UNIVERSAL_JOINT_v3_5.kicad_sch, part in row 2, column 3]

Parts:
C1: 10uF 25v; C_0805_2012Metric_Pad1.18x1.45mm_HandSolder
C2, C13, C14, C15: 220nF 100V; C_0603_1608Metric_Pad1.08x0.95mm_HandSolder
C4, C5: 6.8pF; C_0603_1608Metric_Pad1.08x0.95mm_HandSolder
C6: 10uF; C_0603_1608Metric_Pad1.08x0.95mm_HandSolder
C7, C9, C11, C12, C40, C214: 100nF; C_0603_1608Metric_Pad1.08x0.95mm_HandSolder
C8, C10, C215: 1uF; C_0603_1608Metric_Pad1.08x0.95mm_HandSolder
C16, C17, C18: 1uF 25V; C_0603_1608Metric_Pad1.08x0.95mm_HandSolder
C19: 33nF; C_0603_1608Metric_Pad1.08x0.95mm_HandSolder
C31, C32: 330uF 100V; CP_Radial_D12.5mm_P5.00mm
C41, C203, C204, C205, C207, C209, C211: 100 nF; C_0603_1608Metric_Pad1.08x0.95mm_HandSolder
C202: 220uF 100V; CP_Radial_D8.0mm_P2.50mm
C206, C208, C210: 1 uF; C_0603_1608Metric_Pad1.08x0.95mm_HandSolder
C212: 4,7 uF; C_0805_2012Metric_Pad1.18x1.45mm_HandSolder
C213: 10 uF; C_0603_1608Metric_Pad1.08x0.95mm_HandSolder
C216: 1uF Ceramic; C_0603_1608Metric_Pad1.08x0.95mm_HandSolder
C217, C218: 100n; C_0603_1608Metric_Pad1.08x0.95mm_HandSolder
D1: STPS1H100A; D_0603_1608Metric_Pad1.05x0.95mm_HandSolder
D2, D3, D4, D5, D6, D7, D207: BAT48, 40 V; D_0603_1608Metric_Pad1.05x0.95mm_HandSolder
D8, D206: BAT30K; D_0603_1608Metric_Pad1.05x0.95mm_HandSolder
D201, D203, D205: GREEN; D_0603_1608Metric_Pad1.05x0.95mm_HandSolder
D202: SMBJ48A-TR; D_SMB
D204: RED; D_0603_1608Metric_Pad1.05x0.95mm_HandSolder
J1, J2: BM02B-SRSS-TB
J3, J4: Conn_01x11_Male; PinHeader_1x09_P1.27mm_Vertical
L1: 18uH, 1A; L_Wuerth_WE-PD2-Typ-MS
L2: 10uH; VLS201612HBX-100M-1
NT1, NT2, NT3, NT4, NT5, NT6: NetTie_2; NetTie-2_SMD_Pad0.5mm
Q1, Q2, Q3, Q4, Q5, Q6: STL100N10; TDSON-8-1
Q203: BSS138PS; SOT363
R2: 22k; R_0402_1005Metric_Pad0.72x0.64mm_HandSolder
R13, R14, R15, R25, R26, R27: 33; R_0402_1005Metric_Pad0.72x0.64mm_HandSolder
R31, R33, R35: 5m 1% 3W; R_2512_6332Metric_Pad1.40x3.35mm_HandSolder
R37: 92k 1%; R_0402_1005Metric_Pad0.72x0.64mm_HandSolder
R39: 3.9k 1%; R_0402_1005Metric_Pad0.72x0.64mm_HandSolder
R41, R42, R43, R47, R48, R49: 22k 1%; R_0402_1005Metric_Pad0.72x0.64mm_HandSolder
R44, R45, R46, R50, R51, R52: 1.5k 1%; R_0402_1005Metric_Pad0.72x0.64mm_HandSolder
R53, R54, R55: 11k 1%; R_0402_1005Metric_Pad0.72x0.64mm_HandSolder
R90, R226: 100k; R_0402_1005Metric_Pad0.72x0.64mm_HandSolder
R92: 200; R_0402_1005Metric_Pad0.72x0.64mm_HandSolder
R201, R202, R211, R212: 4.7k 0,5W 5%; R_0603_1608Metric_Pad0.98x0.95mm_HandSolder
R203: 1,5k; R_0402_1005Metric_Pad0.72x0.64mm_HandSolder
R204: 1k; R_0402_1005Metric_Pad0.72x0.64mm_HandSolder
R205, R206, R208, R213, R214, R215, R216, R217, R219: 10k; R_0402_1005Metric_Pad0.72x0.64mm_HandSolder
R207, R210: 100; R_0402_1005Metric_Pad0.72x0.64mm_HandSolder
R209: 1,1k; R_0402_1005Metric_Pad0.72x0.64mm_HandSolder
R218, R220: NM; R_0402_1005Metric_Pad0.72x0.64mm_HandSolder
R221: 124k; R_0402_1005Metric_Pad0.72x0.64mm_HandSolder
R222: 23,7k; R_0402_1005Metric_Pad0.72x0.64mm_HandSolder
R223, R224: 10k 1%; R_0402_1005Metric_Pad0.72x0.64mm_HandSolder
R225: 33k; R_0402_1005Metric_Pad0.72x0.64mm_HandSolder
RJ213, RJ215, RJ216, RJ217, RJ218: 0; R_0402_1005Metric_Pad0.72x0.64mm_HandSolder
SW3: EVP-BB2A9B000; SW_EVP-BB2A9B000; DIGI-KEY_PART_NUMBER P19888CT-ND
TC1: TC2030-IDC
TP1, TP2: 48V; 1-726388-2
TP3, TP4: GND; 1-726388-2
TP5, TP6: 12V; 61-2348-11_0030
TP7, TP8: CANL; KEYS_3544
TP9, TP10: CANH; 61-2348-11_0030
TP11, TP12, TP13: 1-726388-2; 61-2348-11_0030
TP16, TP17: GND; 61-2348-11_0030
TP18, TP19: SAFETY; KEYS_3544
U1: STSPIN32G4
U2: TCAN332G; SO-8_3.9x4.9mm_P1.27mm
U3: iC-PX3212; oDFN8-3x3
U4: iC-PZ2656; oQFN32-5x5
U5: 24CW16X; SOT-23-5
U7: MP2456; MP2456GJ-Z
U8: NCP115; TSOP-5_1.65x3.05mm_P0.95mm
X1: ECS-240-8-36B2-CKM-TR; Crystal_SMD_2520-4Pin_2.5x2.0mm

Connections:
+3V3: C216.2, D203.2 (A), D204.2 (A), J1.2, J2.2, J4.8, R205.1, R208.1, RJ213.2, RJ216.2, RJ217.2, U8.5 (OUT)
+5V: C213.2, C215.2, J4.7, L2.2, R217.1, R219.1, R221.2, RJ215.2, RJ218.2, U8.1 (IN), U8.3 (EN)
/A: U1.57 (PB6), U3.5 (B)
/B: U1.58 (PB7), U3.6 (A)
/BC_ENABLE: R225.2, U1.59 (PB8)
/BEARING_TEMP: C218.1, J2.1, R224.1, U1.17 (PA4)
/BOOT1: C16.2, U1.41 (BOOT1)
/BOOT2: C17.2, U1.38 (BOOT2)
/BOOT3: C18.2, U1.35 (BOOT3)
/CAN_RX: U1.47 (PA11), U2.4 (RXD)
/CAN_TX: U1.48 (PA12), U2.1 (TXD)
/GHS1: D2.1 (K), R13.1, U1.43 (GHS1)
/GHS1_MOS: D2.2 (A), Q1.4 (G), R13.2
/GHS2: D3.1 (K), R14.1, U1.40 (GHS2)
/GHS2_MOS: D3.2 (A), Q2.4 (G), R14.2
/GHS3: D4.1 (K), R15.1, U1.37 (GHS3)
/GHS3_MOS: D4.2 (A), Q3.4 (G), R15.2
/GLS1: D5.1 (K), R25.1, U1.29 (GLS1)
/GLS1_MOS: D5.2 (A), Q4.4 (G), R25.2
/GLS2: D6.1 (K), R26.1, U1.30 (GLS2)
/GLS2_MOS: D6.2 (A), Q5.4 (G), R26.2
/GLS3: D7.1 (K), R27.1, U1.31 (GLS3)
/GLS3_MOS: D7.2 (A), Q6.4 (G), R27.2
/MA730_CS: U1.12 (PC3), U4.8 (PA3)
/MOTOR_TEMP: C217.1, J1.1, R223.1, U1.21 (PC4)
/OPN1: R50.2, R53.1, U1.16 (PA3)
/OPN2: R51.2, R54.1, U1.22 (PC5)
/OPN3: R52.2, R55.1, U1.25 (PB2)
/OPO1: R53.2, U1.15 (PA2)
/OPO2: R54.2, U1.19 (PA6)
/OPO3: R55.2, U1.24 (PB1)
/OPP1: R41.1, R44.2, R47.2, U1.14 (PA1)
/OPP2: R42.1, R45.2, R48.2, U1.20 (PA7)
/OPP3: R43.1, R46.2, R49.2, U1.23 (PB0)
/OSC_IN: C4.2, U1.6 (PF0), X1.1
/OSC_OUT: C5.2, U1.7 (PF1), X1.3
/OUT1: C16.1, Q1.1 (S), Q1.2 (S), Q1.3 (S), Q4.5 (D), TP11.1, U1.42 (OUT1)
/OUT2: C17.1, Q2.1 (S), Q2.2 (S), Q2.3 (S), Q5.5 (D), TP12.1, U1.39 (OUT2)
/OUT3: C18.1, Q3.1 (S), Q3.2 (S), Q3.3 (S), Q6.5 (D), TP13.1, U1.36 (OUT3)
/PA8: U1.44 (PA8)
/PA15: U1.51 (PA15)
/PB9: U1.60 (PB9)
/PB10: U1.28 (PB10)
/PC13: U1.3 (PC13)
/PD2: U1.53 (PD2)
/SAFETY: D206.2 (A), TP18.1, TP19.1
/SEC_IN: R210.2, U1.4 (PC14)
/SEC_OUT: R204.1, U1.5 (PC15)
/SPI_MISO: J4.3, U1.55 (PB4), U4.11 (PA0)
/SPI_MOSI: J4.2, U1.56 (PB5), U4.10 (PA1)
/SPI_SCK: J4.1, U1.18 (PA5), U4.9 (PA2)
/SW: D1.1 (K), L1.1, U1.62 (SW)
/SWCLK/JTCK: TC1.4 (SWCLK), U1.50 (PA14)
/SWDIO/JTMS: TC1.2 (SWDIO), U1.49 (PA13)
/SWO/JTDO: TC1.6 (SWO), U1.54 (PB3)
/UART_RX: U1.46 (PA10)
/UART_TX: U1.45 (PA9)
/VBAT: C12.2, NT4.2, U1.2 (VBAT)
/VBUS: C19.2, D8.2 (A), R37.1, R39.2, U1.13 (PA0)
/VCC: C1.2, C202.1, C212.2, D205.2 (A), J3.8, L1.2, NT3.1, TP5.1, TP6.1, U1.63 (VCC), U7.5 (IN)
/VDD: C6.2, C7.2, NT2.1, NT4.1, R2.2, R90.2, U1.1 (REG3V3/VDD)
/VDDA: C8.2, C9.2, D8.1 (K), NT2.2, NT5.1, U1.27 (VDDA)
/VREF+: C10.2, C11.2, NT5.2, R41.2, R42.2, R43.2, U1.26 (VREF+)
/VREGIN: NT3.2, U1.64 (REGIN)
/VSHUNT1P: Q4.1 (S), Q4.2 (S), Q4.3 (S), R31.1, R44.1
/VSHUNT2P: Q5.1 (S), Q5.2 (S), Q5.3 (S), R33.1, R45.1
/VSHUNT3P: Q6.1 (S), Q6.2 (S), Q6.3 (S), R35.1, R46.1
/nRST: R92.1, TC1.3 (NRESET), U1.8 (PG10)
GND: C1.1, C2.1, C4.1, C5.1, C6.1, C7.1, C8.1, C9.1, C10.1, C11.1, C12.1, C19.1, C40.1, C41.2, C202.2, C203.2, C204.1, C205.2, C206.2, C209.2, C210.2, C211.2, C212.1, C213.1, C215.1, C216.1, C217.2, C218.2, D1.2 (A), D207.2 (A), J1.3 (NM1), J1.4 (NM2), J2.3 (NM1), J2.4 (NM2), J3.9, J4.9, NT1.1, NT6.1, Q203.1 (S1), Q203.4 (S2), R39.1, R47.1, R48.1, R49.1, R206.2, R212.1, R215.2, R218.2, R220.2, R222.2, R223.2, R224.2, R226.2, SW3.A1, SW3.A2, TC1.5 (GND), TP16.1, TP17.1, U1.32 (PGND), U1.65 (VSS), U2.2 (GND), U3.1 (TM1), U3.2 (TM2), U3.8 (GND), U3.9 (GND), U4.13 (GNDIO), U5.2 (GND), U7.2 (GND), U8.2 (GND), X1.2, X1.4
GNDA: C207.2, C208.2, NT6.2, U4.29 (GNDA), U4.33 (BP)
GNDPWR: C13.1, C14.1, C15.1, C31.2, C32.2, D202.2 (A), NT1.2, R31.2, R33.2, R35.2, R50.1, R51.1, R52.1, R202.1, TP3.1, TP4.1
unnamed: C2.2, U1.61 (VM)
unnamed: C40.2, R90.1, R92.2, SW3.B1, SW3.B2
unnamed: C41.1, RJ213.1, U2.3 (VCC)
unnamed: C203.1, U4.12 (C1V8)
unnamed: C204.2, RJ218.1, U3.7 (VDD)
unnamed: C205.1, C206.1, C209.1, C210.1, R213.1, R214.1, R216.1, RJ216.1, U4.14 (VDDIO), U4.22 (NRES), U4.31 (CFG2), U4.32 (CFG1)
unnamed: C207.1, C208.1, RJ215.1, U4.30 (VDDA)
unnamed: C211.1, RJ217.1, U5.4 (VCC)
unnamed: C214.1, U7.1 (BST)
unnamed: C214.2, D207.1 (K), L2.1, U7.6 (SW)
unnamed: D201.1 (K), R201.2
unnamed: D203.1 (K), R209.1
unnamed: D204.1 (K), R203.1
unnamed: D205.1 (K), R211.2
unnamed: D206.1 (K), Q203.3 (D2), R207.1
unnamed: Q203.2 (G1), R206.1, R207.2
unnamed: Q203.5 (G2), R203.2, R204.2, R205.2
unnamed: Q203.6 (D1), R208.2, R209.2, R210.1
unnamed: R2.1, U1.52 (SCREF)
unnamed: R201.1, R202.2
unnamed: R211.1, R212.2
unnamed: R213.2, U4.28 (SDA), U5.3 (SDA)
unnamed: R214.2, U4.27 (SCL), U5.1 (SCL)
unnamed: R215.1, R216.2, U4.1 (CFG0)
unnamed: R217.2, R218.1, U3.4 (SEL2)
unnamed: R219.2, R220.1, U3.3 (SEL1)
unnamed: R221.1, R222.1, U7.3 (FB)
unnamed: R225.1, R226.1, U7.4 (EN)
unnamed: TP7.1, TP8.1, U2.6 (CANL)
unnamed: TP9.1, TP10.1, U2.7 (CANH)
VM: C13.2, C14.2, C15.2, C31.1, C32.1, D201.2 (A), D202.1 (K), Q1.5 (D), Q2.5 (D), Q3.5 (D), R37.2, TP1.1, TP2.1

Notes on the sheet:
VM - 48V VCC - Gate driving supply voltage - 12V VREGIN - 3.3 V LDO linear regulator input - 12V VDD - 3,3V VBAT VDDA VREF+ - 3,3V do dzielnika napiecia GND
CONNECTORS
WBUDOWANY OPAMP
