avena-robotics/pcbs/UNIVERSAL_JOINT_v3_5/UNIVERSAL_JOINT_v3_5.kicad_pcb

## KiCad design UNIVERSAL_JOINT_v3_5/UNIVERSAL_JOINT_v3_5.kicad_pcb (continued)

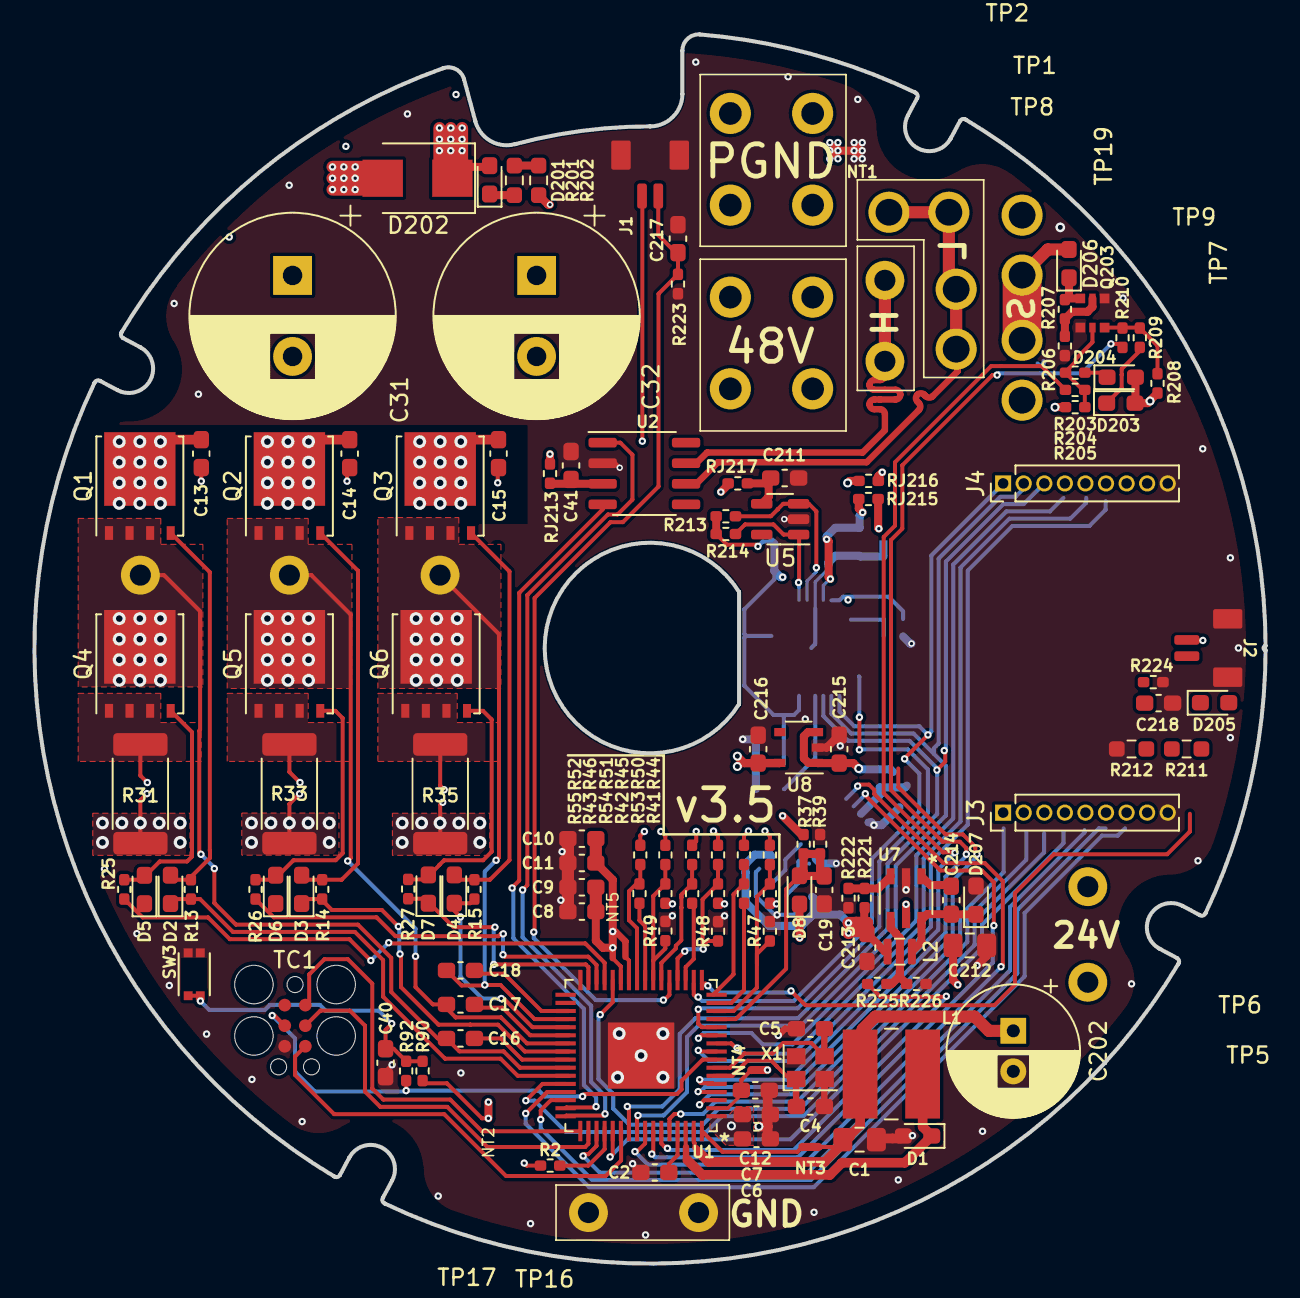
[picture p91: board UNIVERSAL_JOINT_v3_5.kicad_pcb from above]

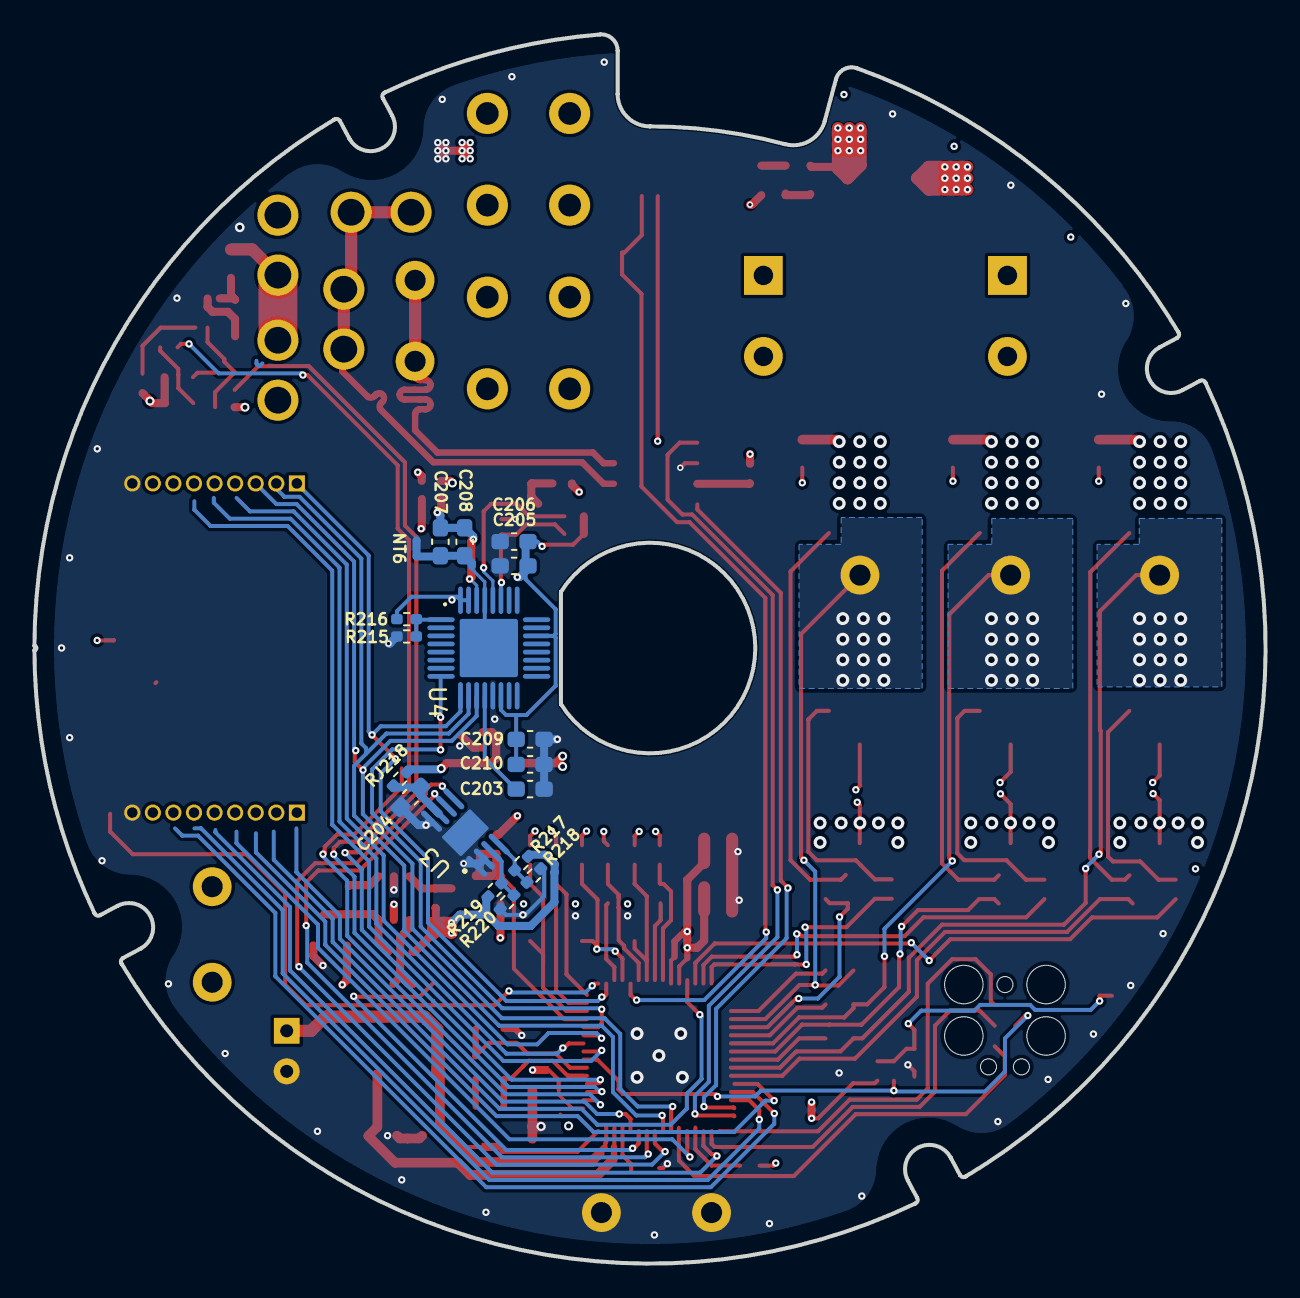
[picture p92: board UNIVERSAL_JOINT_v3_5.kicad_pcb from below]

Board: 4 copper layers, 76.0 x 75.9 mm, 160 parts (18 on the bottom side), 94 nets.
