avena-robotics/pcbs/GRIPPER_PUMP_v1.0/GRIPPER_PUMP_v1_0.kicad_pcb

## KiCad design GRIPPER_PUMP_v1.0/GRIPPER_PUMP_v1_0.kicad_pcb (2022-05-02)

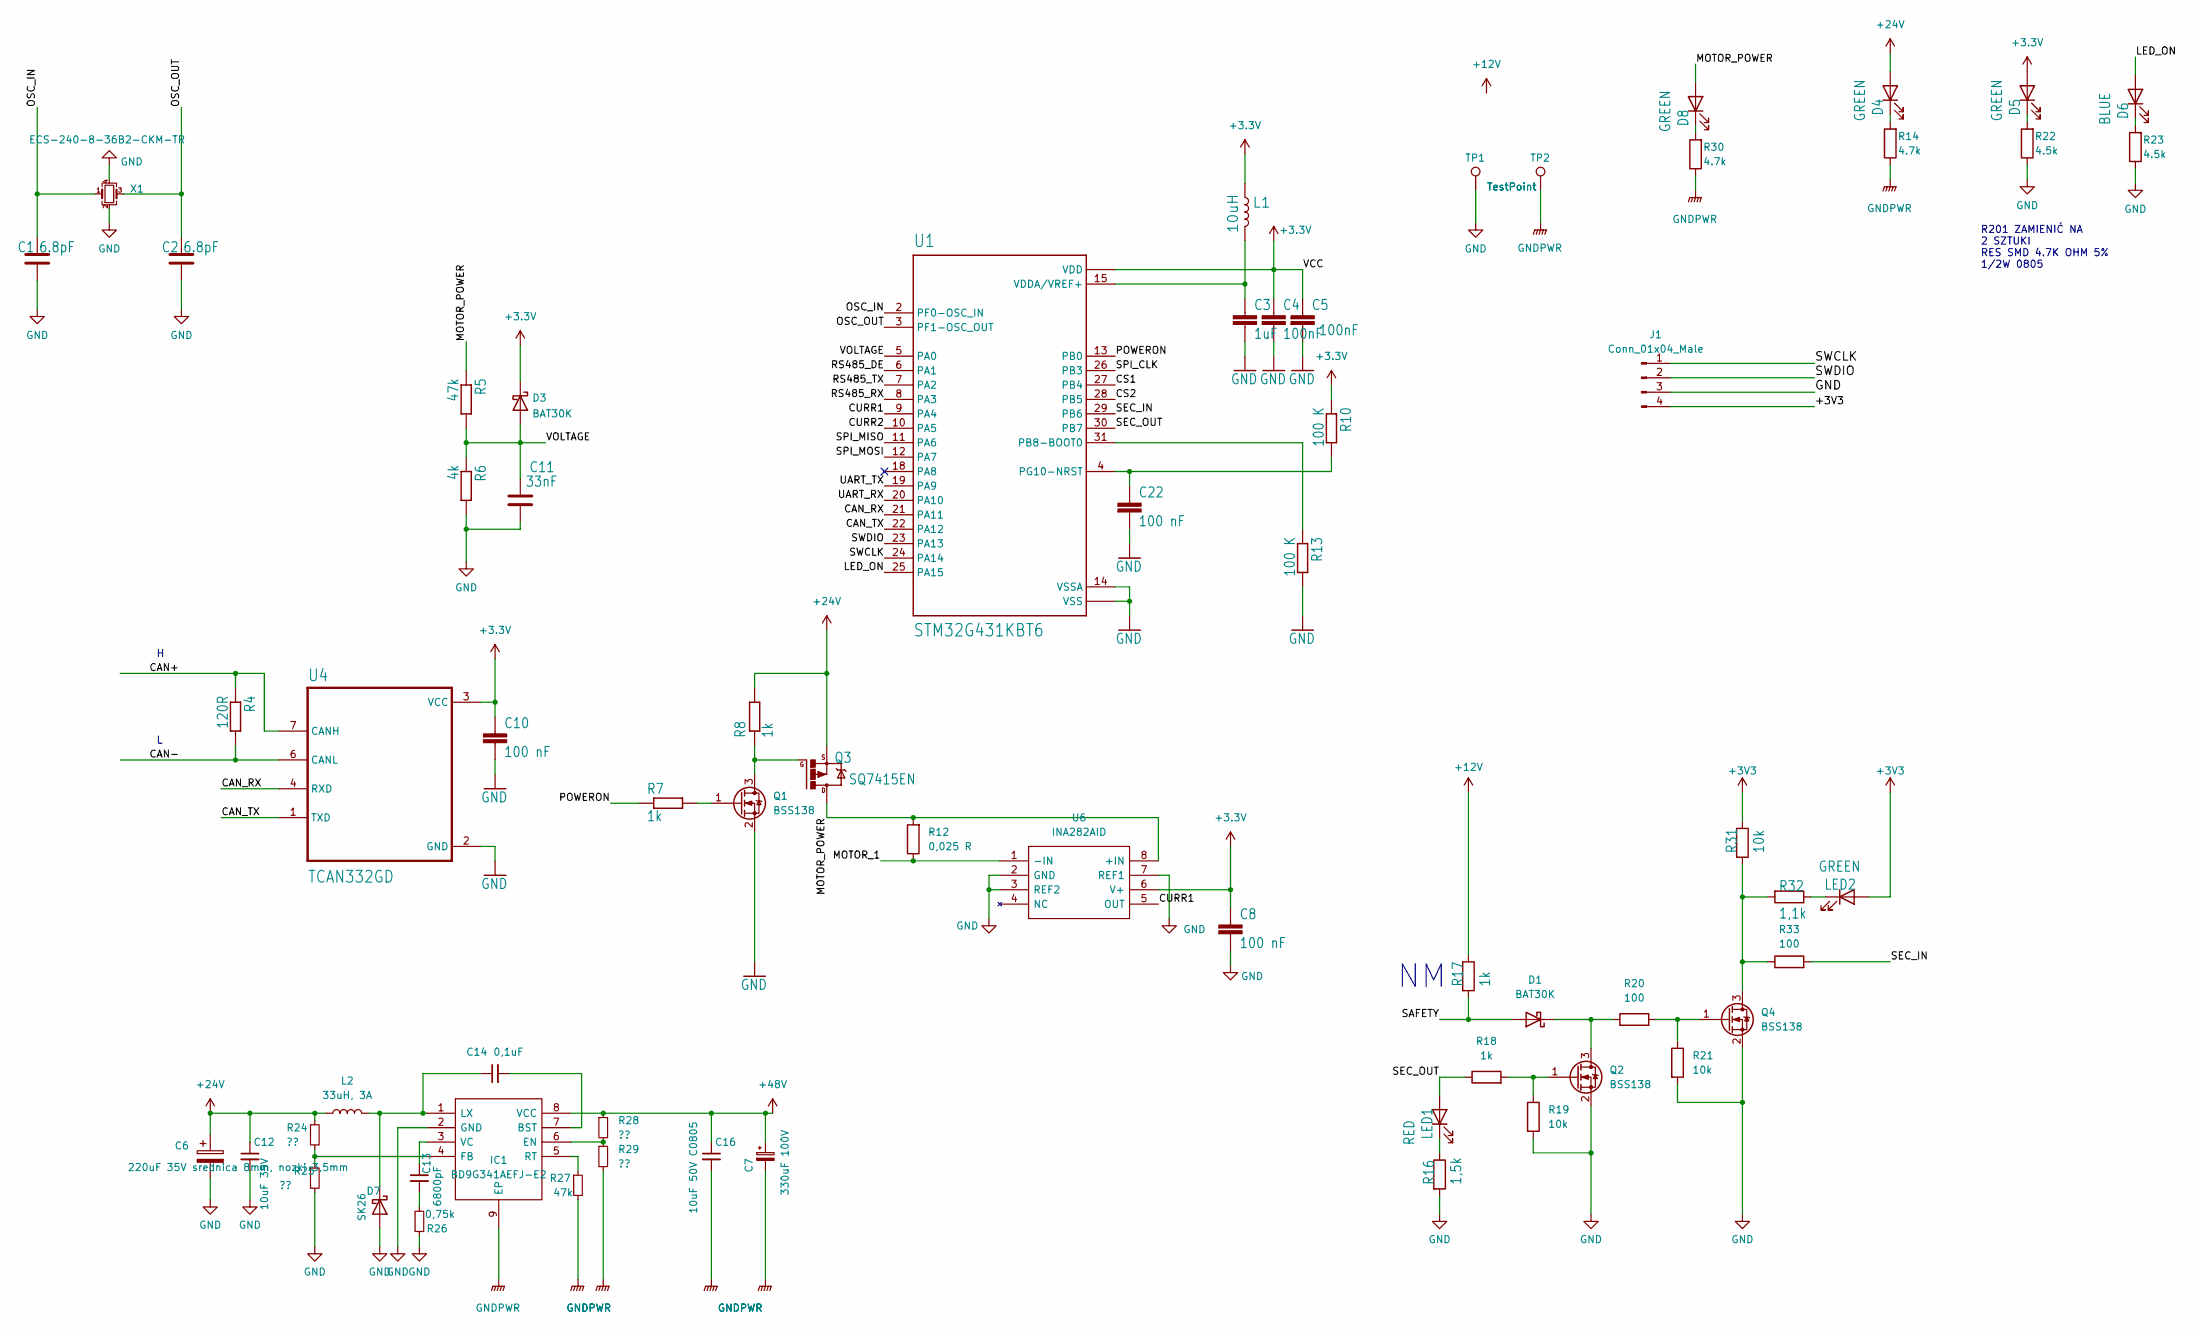
[picture p93: schematic GRIPPER_PUMP_v1_0.kicad_sch]

Parts:
C1, C2: 6.8pF; C_0603_1608Metric_Pad1.08x0.95mm_HandSolder
C3: 1uF; C_0603_1608Metric_Pad1.08x0.95mm_HandSolder
C4, C5: 100nF; C_0603_1608Metric_Pad1.08x0.95mm_HandSolder
C6: 220uF 35V srednica 8mm, nozki 3,5mm; C_Radial_D8.0mm_H11.5mm_P3.50mm
C7: 330uF 100V; CP_Radial_D12.5mm_P7.50mm
C8, C10, C22: 100 nF; C_0603_1608Metric_Pad1.08x0.95mm_HandSolder
C11: 33nF; C_0603_1608Metric_Pad1.08x0.95mm_HandSolder
C12: 10uF 35V; C_1206_3216Metric_Pad1.33x1.80mm_HandSolder
C13: 6800pF; C_0603_1608Metric_Pad1.08x0.95mm_HandSolder
C14: 0,1uF; C_0603_1608Metric_Pad1.08x0.95mm_HandSolder
C16: 10uF 50V C0805; C_0603_1608Metric_Pad1.08x0.95mm_HandSolder
D1, D3: BAT30K; D_0603_1608Metric_Pad1.05x0.95mm_HandSolder
D4, D5, D8: GREEN; D_0603_1608Metric_Pad1.05x0.95mm_HandSolder
D6: BLUE; D_0603_1608Metric_Pad1.05x0.95mm_HandSolder
D7: SK26; D_SMB_Handsoldering
IC1: BD9G341AEFJ-E2; SOIC127P600X100-9N; Mouser Part Number 755-BD9G341AEFJ-E2
J1: Conn_01x04_Male; PinHeader_1x04_P2.54mm_Vertical
L1: 10uH; 0603
L2: 33uH, 3A; MPEV1D1040L330
LED1: RED; D_0603_1608Metric_Pad1.05x0.95mm_HandSolder
LED2: GREEN; D_0603_1608Metric_Pad1.05x0.95mm_HandSolder
Q1, Q2, Q4: BSS138; SOT-23
Q3: SQ7415EN; DFN3.3X3.3
R4: 120R; R_0603_1608Metric_Pad0.98x0.95mm_HandSolder
R5, R27: 47k; R_0603_1608Metric_Pad0.98x0.95mm_HandSolder
R6: 4k; R_0603_1608Metric_Pad0.98x0.95mm_HandSolder
R7, R8, R17, R18: 1k; R_0603_1608Metric_Pad0.98x0.95mm_HandSolder
R10, R13: 100 K; R_0603_1608Metric_Pad0.98x0.95mm_HandSolder
R12: 0,025 R; R_2512_6332Metric_Pad1.40x3.35mm_HandSolder
R14, R30: 4.7k; R_0805_2012Metric_Pad1.20x1.40mm_HandSolder
R16: 1,5k; R_0603_1608Metric_Pad0.98x0.95mm_HandSolder
R19, R21, R31: 10k; R_0603_1608Metric_Pad0.98x0.95mm_HandSolder
R20, R33: 100; R_0603_1608Metric_Pad0.98x0.95mm_HandSolder
R22, R23: 4.5k; R_0603_1608Metric_Pad0.98x0.95mm_HandSolder
R24, R25, R28, R29: ??; R_0603_1608Metric_Pad0.98x0.95mm_HandSolder
R26: 0,75k; R_0603_1608Metric_Pad0.98x0.95mm_HandSolder
R32: 1,1k; R_0603_1608Metric_Pad0.98x0.95mm_HandSolder
TP1, TP2: TestPoint; TestPoint_Pad_1.0x1.0mm
U1: STM32G431KBT6; QFP80P900X900X160-32N
U4: TCAN332GD; SOIC127P599X175-8N
U6: INA282AID; SOIC127P600X175-8N; Mouser Part Number 595-INA282AID
X1: ECS-240-8-36B2-CKM-TR; Crystal_SMD_2520-4Pin_2.5x2.0mm

Connections:
+12V: R17.1
+24V: C6.1, C12.1, D4.2 (A), L2.1, Q3.1 (S), Q3.2 (S), Q3.3 (S), R8.2, R24.1
+48V: C7.1, C16.1, IC1.8 (VCC), R28.1
/CAN+: R4.1, U4.7 (CANH)
/CAN-: R4.2, U4.6 (CANL)
/CAN_RX: U1.21 (PA11), U4.4 (RXD)
/CAN_TX: U1.22 (PA12), U4.1 (TXD)
/CS1: U1.27 (PB4)
/CS2: U1.28 (PB5)
/CURR1: U1.9 (PA4), U6.5 (OUT)
/CURR2: U1.10 (PA5)
/LED_ON: D6.2 (A), U1.25 (PA15)
/MOTOR_1: R12.1, U6.1 (-IN)
/MOTOR_POWER: D8.2 (A), Q3.5 (D), Q3.6 (D), Q3.7 (D), Q3.8 (D), R5.1, R12.2, U6.8 (+IN)
/OSC_IN: C1.2, U1.2 (PF0-OSC_IN), X1.1
/OSC_OUT: C2.2, U1.3 (PF1-OSC_OUT), X1.3
/POWERON: R7.1, U1.13 (PB0)
/RS485_DE: U1.6 (PA1)
/RS485_RX: U1.8 (PA3)
/RS485_TX: U1.7 (PA2)
/SAFETY: D1.2 (A), R17.2
/SEC_IN: R33.2, U1.29 (PB6)
/SEC_OUT: LED1.2 (A), R18.1, U1.30 (PB7)
/SPI_CLK: U1.26 (PB3)
/SPI_MISO: U1.11 (PA6)
/SPI_MOSI: U1.12 (PA7)
/SWCLK: J1.1, U1.24 (PA14)
/SWDIO: J1.2, U1.23 (PA13)
/UART_RX: U1.20 (PA10)
/UART_TX: U1.19 (PA9)
/VOLTAGE: C11.2, D3.2 (A), R5.2, R6.1, U1.5 (PA0)
GND: C1.1, C2.1, C3.2, C4.2, C5.2, C6.2, C8.2, C10.2, C11.1, C12.2, C22.2, D7.2 (A), IC1.2 (GND), J1.3, Q1.2 (S), Q2.2 (S), Q4.2 (S), R6.2, R13.2, R16.2, R19.2, R21.2, R22.1, R23.1, R25.2, R26.1, TP1.1, U1.14 (VSSA), U1.16 (VSS), U1.32 (VSS), U4.2 (GND), U6.2 (GND), U6.3 (REF2), U6.7 (REF1), X1.2, X1.4
GNDPWR: C7.2, C16.2, IC1.9 (EP), R14.1, R27.2, R29.2, R30.1, TP2.1
unnamed: C3.1, L1.2, U1.15 (VDDA/VREF+)
unnamed: C13.1, IC1.3 (VC)
unnamed: C13.2, R26.2
unnamed: C14.1, D7.1 (K), IC1.1 (LX), L2.2
unnamed: C14.2, IC1.7 (BST)
unnamed: C22.1, R10.2, U1.4 (PG10-NRST)
unnamed: D1.1 (K), Q2.3 (D), R20.1
unnamed: D4.1 (K), R14.2
unnamed: D5.1 (K), R22.2
unnamed: D6.1 (K), R23.2
unnamed: D8.1 (K), R30.2
unnamed: IC1.4 (FB), R24.2, R25.1
unnamed: IC1.5 (RT), R27.1
unnamed: IC1.6 (EN), R28.2, R29.1
unnamed: LED1.1 (K), R16.1
unnamed: LED2.1 (K), R32.1
unnamed: Q2.1 (G), R18.2, R19.1
unnamed: Q1.3 (D), Q3.4 (G), R8.1
unnamed: Q4.1 (G), R20.2, R21.1
unnamed: Q4.3 (D), R31.2, R32.2, R33.1
unnamed: Q1.1 (G), R7.2
unnamed: R13.1, U1.31 (PB8-BOOT0)

Notes on the sheet:
R201 ZAMIENIĆ NA 2 SZTUKI RES SMD 4.7K OHM 5% 1/2W 0805

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
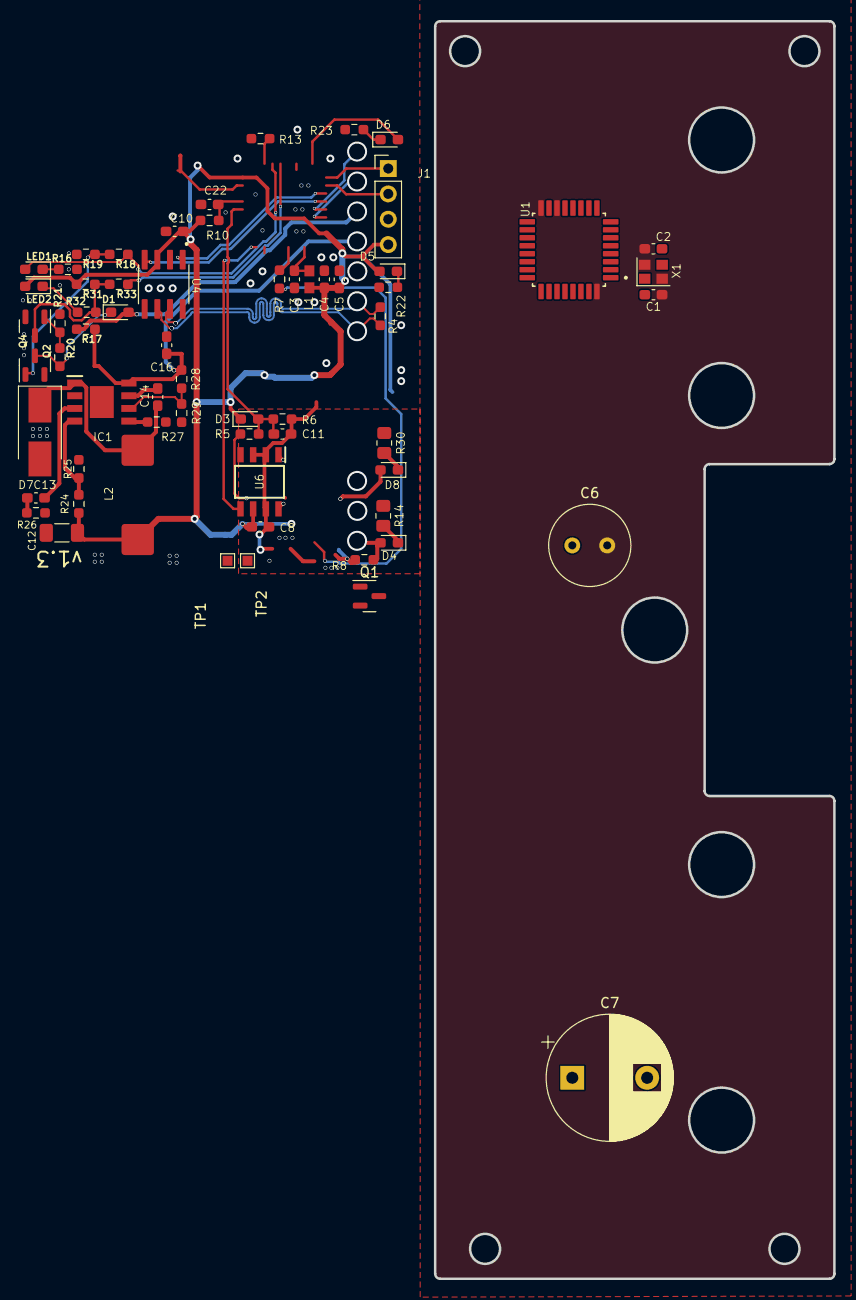
[picture p94: board GRIPPER_PUMP_v1_0.kicad_pcb from above]

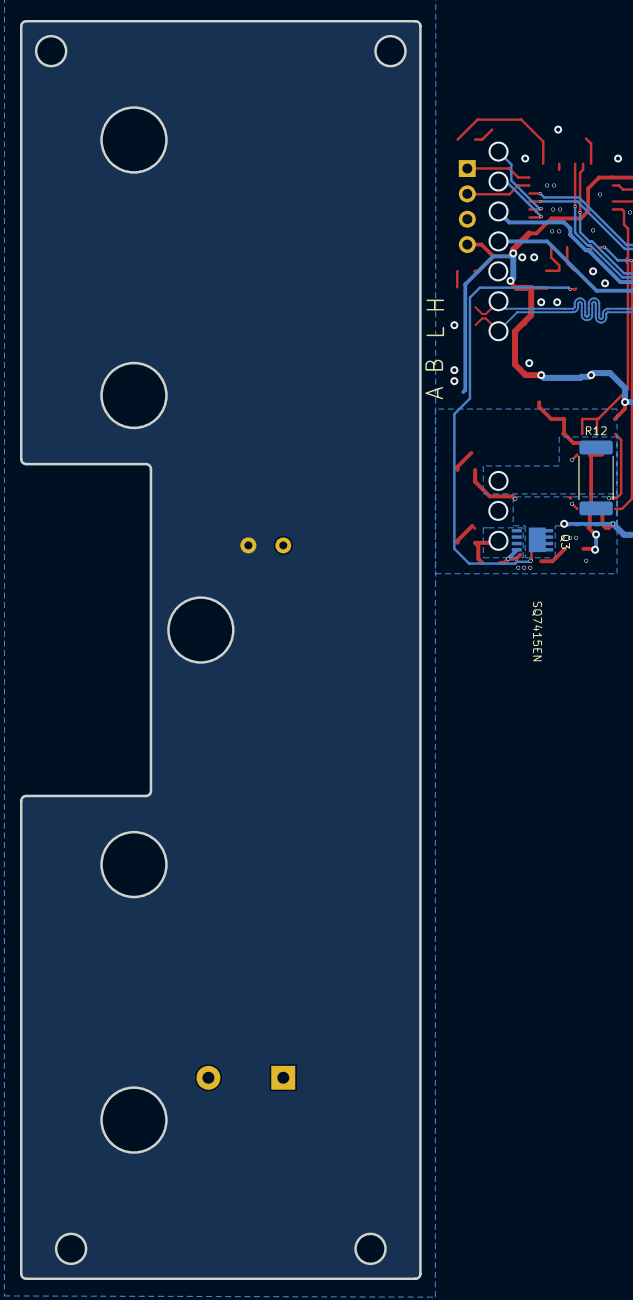
[picture p95: board GRIPPER_PUMP_v1_0.kicad_pcb from below]

Board: 2 copper layers, 40.0 x 126.0 mm, 65 parts (2 on the bottom side), 44 nets.
