avena-robotics/pcbs/UNIVERSAL_JOINT_v2_2/UNIVERSAL_JOINT_v2_2.kicad_pcb

## KiCad design UNIVERSAL_JOINT_v2_2/UNIVERSAL_JOINT_v2_2.kicad_pcb (2022-05-02, an earlier design)

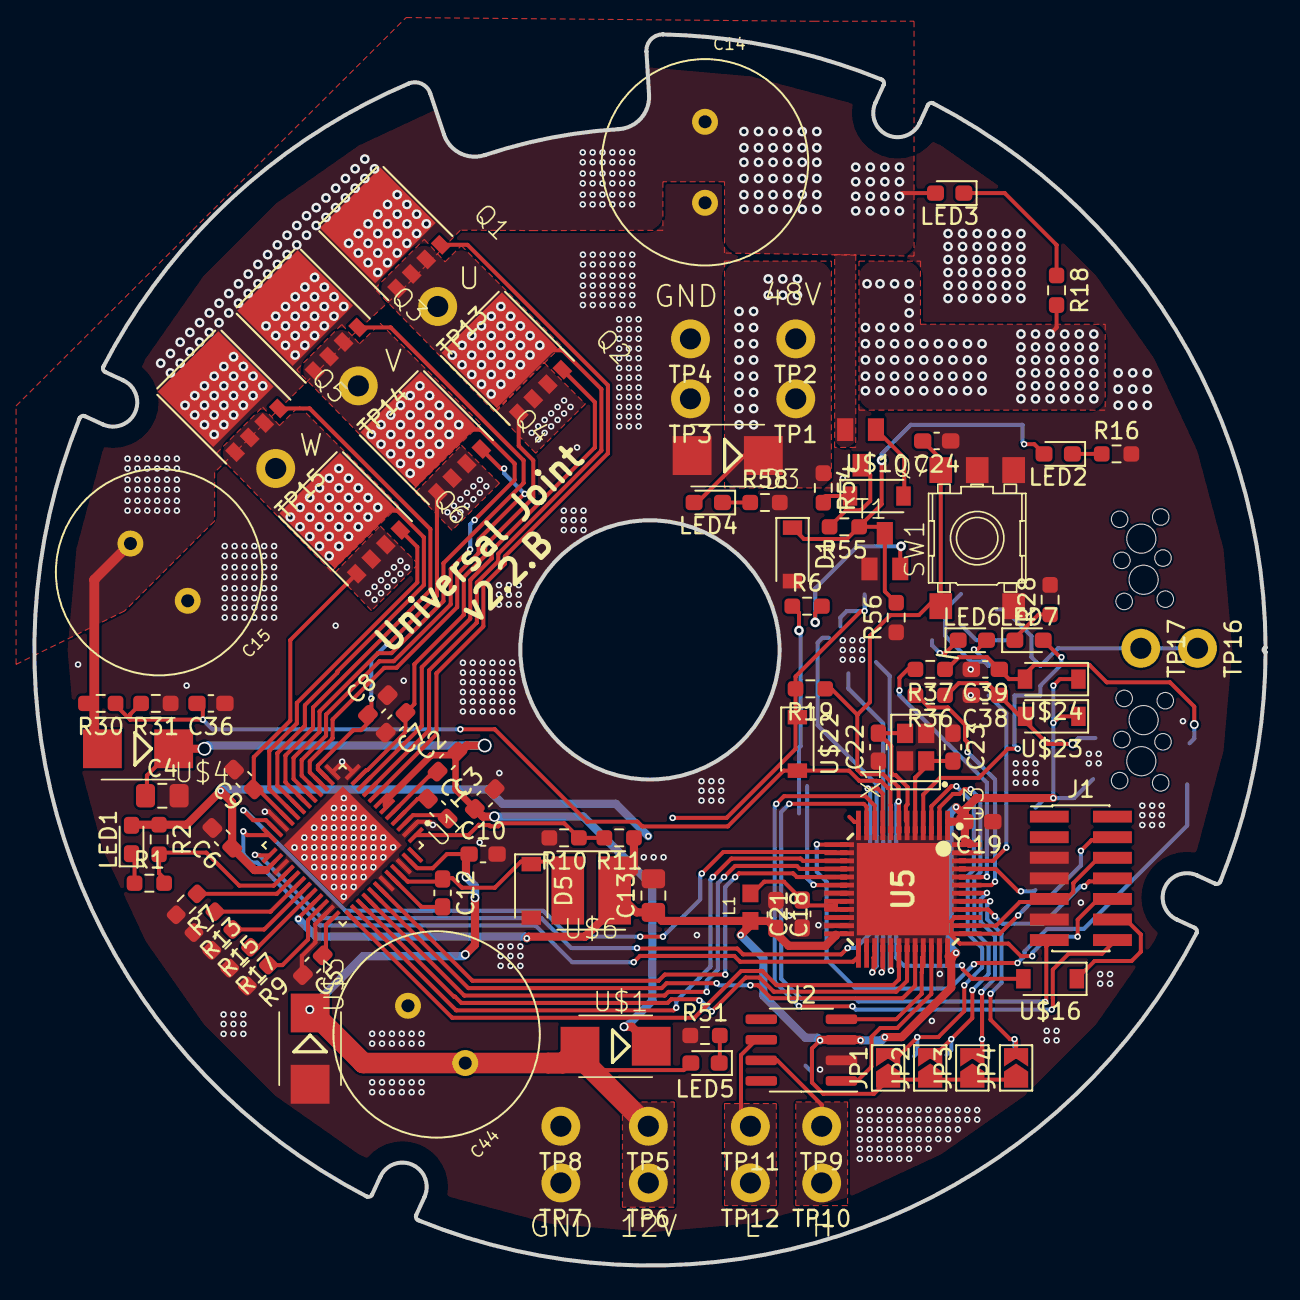
[picture p96: board UNIVERSAL_JOINT_v2_2.kicad_pcb from above]

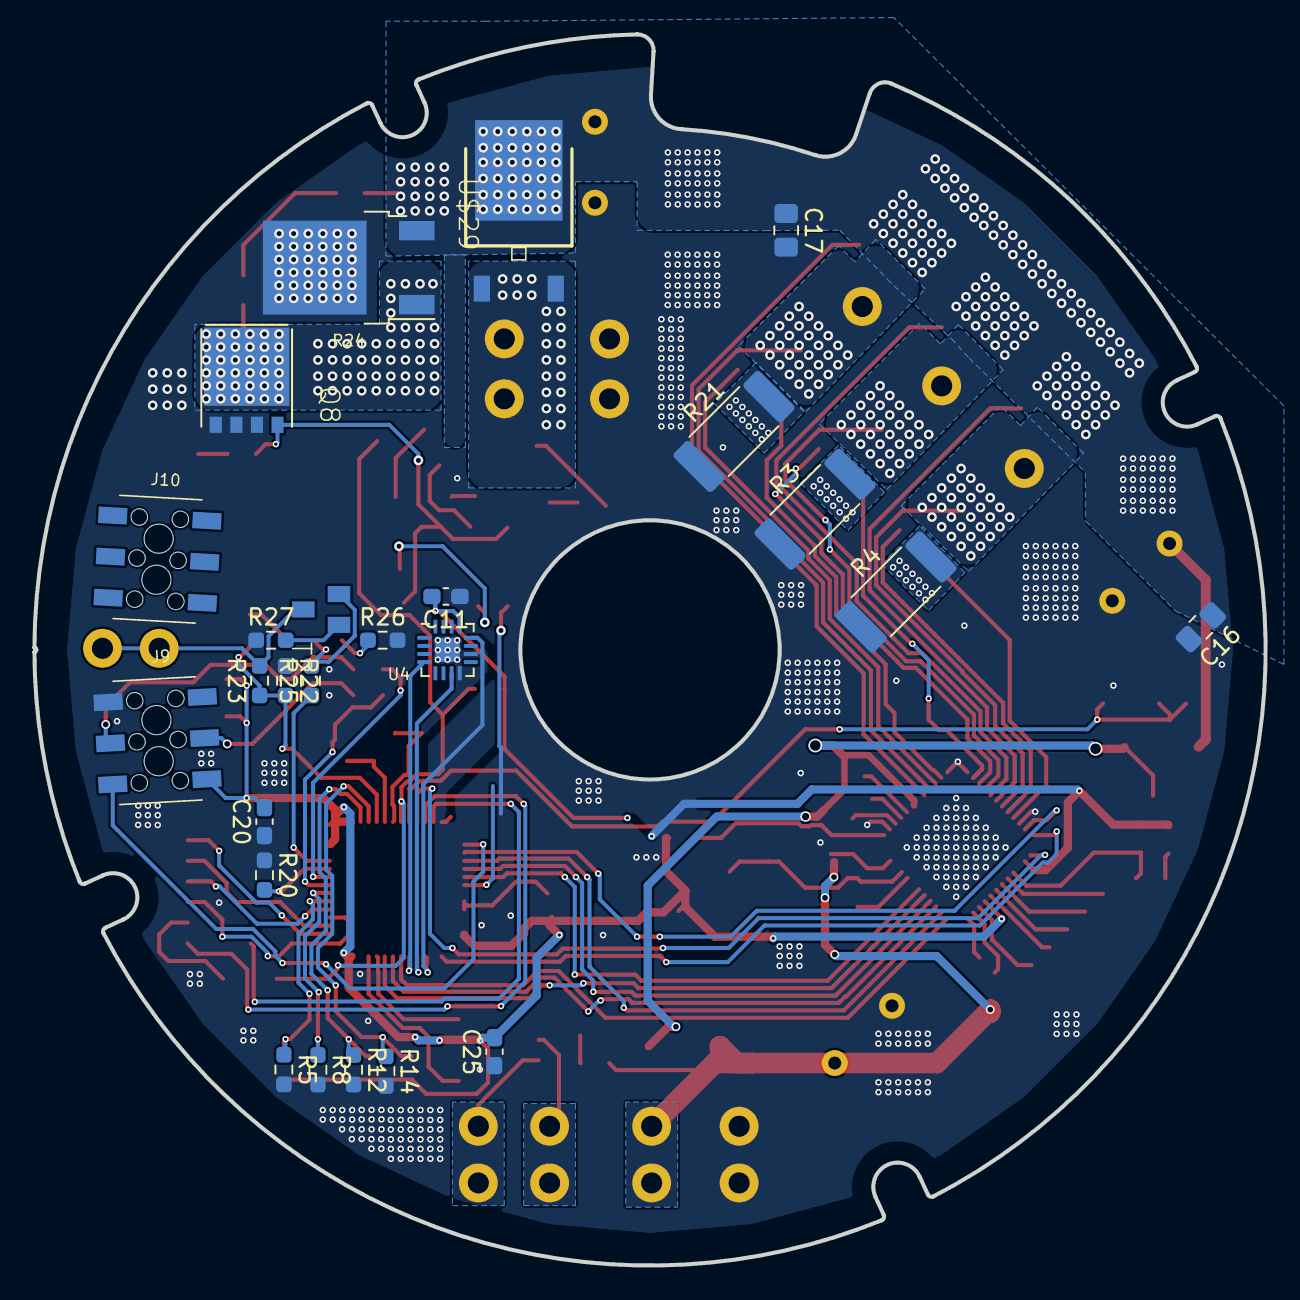
[picture p97: board UNIVERSAL_JOINT_v2_2.kicad_pcb from below]

Board: 2 copper layers, 76.0 x 76.0 mm, 128 parts (25 on the bottom side), 89 nets.

Parts:
C1: 47nF x 50V; C_0603_1608Metric_Pad1.08x0.95mm_HandSolder
C2, C10, C11, C21: 1uF; C_0603_1608Metric_Pad1.08x0.95mm_HandSolder
C3, C5, C6, C12, C18, C19, C20, C24, C25: 100nF; C_0603_1608Metric_Pad1.08x0.95mm_HandSolder
C4: 10uF; C_0805_2012Metric_Pad1.18x1.45mm_HandSolder
C7, C8, C9: 1nF; C_0603_1608Metric_Pad1.08x0.95mm_HandSolder
C13: 22u; C_0805_2012Metric_Pad1.18x1.45mm_HandSolder
C14, C15, C44: 330uF; C_Radial_D12.5mm_H25.0mm_P5.00mm
C16, C17: 100nF; C_0805_2012Metric_Pad1.18x1.45mm_HandSolder
C22, C23: 22pF; C_0603_1608Metric_Pad1.08x0.95mm_HandSolder
C36: 4.7n x 10V; C_0603_1608Metric_Pad1.08x0.95mm_HandSolder
C38, C39: 4.7nF; C_0603_1608Metric_Pad1.08x0.95mm_HandSolder
D1: ACZRW5242B-G; D_SOD-123
D3: SMBJ48A-TR; SMB
D5: MBR1H100SFT3G; D_SOD-123
J1: Conn_02x07_Odd_Even; PinHeader_2x07_P1.27mm_Vertical_SMD
J9: HEADER_MALE_2X3_2.54_SMT; M207810345
J10: n.m.; M207810345
JP1, JP2, JP3, JP4: SolderJumper_2_Open; SolderJumper-2_P1.3mm_Open_TrianglePad1.0x1.5mm
L1: 10uH; 0603
LED1, LED6: RED; D_0603_1608Metric_Pad1.05x0.95mm_HandSolder
LED2: BLUE; D_0603_1608Metric_Pad1.05x0.95mm_HandSolder
LED3: ORANGE; D_0603_1608Metric_Pad1.05x0.95mm_HandSolder
LED4, LED5, LED7: GREEN; D_0603_1608Metric_Pad1.05x0.95mm_HandSolder
Q1, Q2, Q3, Q4, Q5, Q6, Q8: IAUC120N06S5L; SO-8FL
Q7: ZXTP19100CFFCT; SOT23
R1, R26: 130R; R_0603_1608Metric_Pad0.98x0.95mm_HandSolder
R2, R6, R51: 1k; R_0603_1608Metric_Pad0.98x0.95mm_HandSolder
R3, R4, R21: 10mR; R_2512_6332Metric_Pad1.40x3.35mm_HandSolder
R5, R8, R12, R14, R19, R20: 100k; R_0603_1608Metric_Pad0.98x0.95mm_HandSolder
R7, R17: 0; R_0603_1608Metric_Pad0.98x0.95mm_HandSolder
R9, R10, R54, R56: 10k; R_0603_1608Metric_Pad0.98x0.95mm_HandSolder
R11: 33k; R_0603_1608Metric_Pad0.98x0.95mm_HandSolder
R13, R15: 75k; R_0603_1608Metric_Pad0.98x0.95mm_HandSolder
R16: 1.2k; R_0603_1608Metric_Pad0.98x0.95mm_HandSolder
R18: 4.6k; R_0603_1608Metric_Pad0.98x0.95mm_HandSolder
R22: 5,23k; R_0603_1608Metric_Pad0.98x0.95mm_HandSolder
R23: 13,7k; R_0603_1608Metric_Pad0.98x0.95mm_HandSolder
R24: 47R; TO-252-2
R25, R27: 200R; R_0603_1608Metric_Pad0.98x0.95mm_HandSolder
R28: 80R; R_0603_1608Metric_Pad0.98x0.95mm_HandSolder
R30: 169k; R_0603_1608Metric_Pad0.98x0.95mm_HandSolder
R31: 9k31; R_0603_1608Metric_Pad0.98x0.95mm_HandSolder
R36, R37: 1k8; R_0603_1608Metric_Pad0.98x0.95mm_HandSolder
R55: 22k; R_0603_1608Metric_Pad0.98x0.95mm_HandSolder
R58: 4.5k; R_0603_1608Metric_Pad0.98x0.95mm_HandSolder
SW1: SKHMPE010; SKHMPXE010
T1, T2: 2PC4081S,115; SOT23-EBC
TP1, TP2, TP3, TP4, TP5, TP6, TP7, TP8, TP9, TP10, TP11, TP12, TP13, TP14, TP15, TP16, TP17: TestPoint; 61-2348-11_0030
U1: DRV8323RHRGZR; QFN50P700X700X100-49N
U2: TCAN332G; SOIC-8_3.9x4.9mm_P1.27mm
U3: STM32G431C8T6; LQFP48-7X7
U4: MA730; HVQFN-16-1EP_3x3mm_P0.5mm_EP1.5x1.5mm
U5: STM32G431CBU6; QFN50P700X700X65-49N-D
U$1, U$4: SMBJ48A-TR; SMB
U$3: 16V; SMB
U$6: SRN4012TA-150M; BEADC4040X120N
U$10: STPS0560Z; D_SOD-123
U$16, U$22, U$23, U$24: RSX101M-30TR; D_SOD-123
U$29: MBRD10100CT; DPACK
X1: LFXTAL069392CUTT; 2.5X2-4-PAD

Connections:
+3V3: C6.1, C11.2, C13.1, C18.2, C19.2, C20.2, C25.2, J9.6, JP1.1 (A), JP2.1 (A), JP3.1 (A), JP4.1 (A), L1.1, LED1.2 (A), R2.1, R11.1, R19.2, U1.26 (VREF), U1.33 (ENABLE), U2.3 (VCC), U3.1 (VDD), U3.24 (VDD), U3.36 (VDD), U3.48 (VDD), U4.13 (VDD), U$6.1, U$22.1 (K), U$23.1 (K), U$24.1 (K)
/12V: C10.1, C44.1, LED5.2 (A), TP5.1, TP6.1, U1.47 (VIN), U$1.A, U$3.C
/48V: D3.C, LED4.2 (A), R54.1, TP1.1, TP2.1, U$29.1 (A1), U$29.3 (A2)
/A: C38.1, J9.4, R36.1, U$23.2 (A)
/B: C39.1, J9.3, R37.1, U$24.2 (A)
/BRAKE: R6.1, U3.12 (PA4), U5.12 (PA4)
/CAN_H: TP9.1, TP10.1, U2.7 (CANH)
/CAN_L: TP11.1, TP12.1, U2.6 (CANL)
/CB: C12.2, U1.44 (CB)
/CS1: U3.18 (PB2), U4.5 (~CS)
/CURR_FB_U: U1.25 (SOA), U3.9 (PA1), U5.9 (PA1)
/CURR_FB_V: U1.24 (SOB), U3.25 (PB11)
/CURR_FB_W: U1.23 (SOC), U3.14 (PA6), U5.14 (PA6)
/DIP1: JP1.2 (B), R14.1, U3.3 (PC14)
/DIP2: JP2.2 (B), R12.1, U3.2 (PC13)
/DIP3: JP3.2 (B), R8.1, U3.42 (PB5)
/DIP4: JP4.2 (B), R5.1, U3.41 (PB4)
/FDCAN_RX: U2.4 (RXD), U3.33 (PA11)
/FDCAN_TX: U2.1 (TXD), U3.34 (PA12)
/GAIN: R17.1, U1.32 (GA]N)
/GHA: Q1.P$4 (G), U1.8 (GHA)
/GHB: Q3.P$4 (G), U1.17 (GHB)
/GHC: Q5.P$4 (G), U1.18 (GHC)
/GLA: Q2.P$4 (G), U1.10 (GLA)
/GLB: Q4.P$4 (G), U1.15 (GLB)
/GLC: Q6.P$4 (G), U1.20 (GLC)
/H1: R36.2, U3.43 (PB6)
/H2: R37.2, U3.44 (PB7)
/IDRIVE: R13.1, U1.30 (IDRLVE)
/JTDI: J1.10, U3.39 (PA15)
/MODE: R7.1, U1.29 (MODE)
/MOTOR_SUPPLY: C14.1, C15.1, C16.1, C17.1, LED3.2 (A), Q1.P$5 (D), Q3.P$5 (D), Q5.P$5 (D), Q7.2 (E), R24.3, R30.2, U$4.A, U$29.2 (C)
/MOTOR_U: Q1.P$1 (S), Q1.P$2 (S), Q1.P$3 (S), Q2.P$5 (D), TP13.1, U1.9 (SHA)
/MOTOR_V: Q3.P$1 (S), Q3.P$2 (S), Q3.P$3 (S), Q4.P$5 (D), TP14.1, U1.16 (SHB)
/MOTOR_W: Q5.P$1 (S), Q5.P$2 (S), Q5.P$3 (S), Q6.P$5 (D), TP15.1, U1.19 (SHC)
/NFAULT: R1.2, R2.2, U1.28 (NFAULT)
/PWM_1: U1.37 (INHA), U3.30 (PA8)
/PWM_1N: U1.38 (INLA), U3.15 (PA7), U5.15 (PA7)
/PWM_2: U1.39 (INHB), U3.31 (PA9)
/PWM_2N: U1.40 (INLB), U3.16 (PB0), U5.17 (PB0)
/PWM_3: U1.41 (INHC), U3.32 (PA10)
/PWM_3N: U1.42 (INLC), U3.17 (PB1), U5.18 (PB1)
/SECURITY: R23.2, T2.C, TP16.1, TP17.1
/SEC_IN: LED7.2 (A), R22.2, R23.1, U3.4 (PC15)
/SEC_OUT: R25.1, U3.46 (PB9)
/SENS_U: C7.1, Q2.P$1 (S), Q2.P$2 (S), Q2.P$3 (S), R21.2, U1.11 (SPA)
/SENS_V: C8.1, Q4.P$1 (S), Q4.P$2 (S), Q4.P$3 (S), R3.2, U1.14 (SPB)
/SENS_W: C9.1, Q6.P$1 (S), Q6.P$2 (S), Q6.P$3 (S), R4.2, U1.21 (SPC)
/SPI_MISO: U3.28 (PB14), U4.7 (MISO)
/SPI_MOSI: U3.29 (PB15), U4.4 (MOSI)
/SPI_SCK: U3.27 (PB13), U4.12 (SCLK)
/SW: C12.1, D5.1 (K), U1.45 (SW), U$6.2
/SWCLK/JTCK: J1.6, J1.9, U3.38 (PA14)
/SWDIO/JTMS: J1.4, U3.37 (PA13)
/SWO/JTDO: J1.8, U3.40 (PB3)
/TEMP: J9.5, U3.13 (PA5), U5.13 (PA5)
/UART_RX: J1.13, U3.11 (PA3), U5.11 (PA3)
/UART_TX: J1.14, U3.10 (PA2), U5.10 (PA2)
/VBUS: C36.2, R30.1, R31.2, U3.8 (PA0), U5.8 (PA0), U$22.2 (A)
/VDS: R15.1, U1.31 (VDS)
/VM: C2.2, C3.1, C4.1, U1.6 (VM), U1.7 (VDRALN), U$1.C, U$4.C
/nRST: J1.12, U$16.1 (K)
GND: C3.2, C4.2, C5.2, C6.2, C7.2, C8.2, C9.2, C10.2, C11.1, C13.2, C14.2, C15.2, C16.2, C17.2, C18.1, C19.1, C20.1, C21.1, C22.1, C23.1, C24.1, C25.1, C36.1, C38.2, C39.2, C44.2, D1.2 (A), D3.A, D5.2 (A), J1.5, J1.7, J1.11, J9.1, Q8.P$1 (S), Q8.P$2 (S), Q8.P$3 (S), R3.1, R4.1, R5.2, R7.2, R8.2, R9.2, R10.2, R12.2, R13.2, R14.2, R15.2, R16.2, R17.2, R20.1, R21.1, R22.1, R24.2, R26.2, R27.1, R28.2, R31.1, R51.2, R56.1, R58.2, SW1.3 (2.1), SW1.4 (2.2), SW1.5 (SH), T1.E, TP3.1, TP4.1, TP7.1, TP8.1, U1.2 (PGND), U1.12 (SNA), U1.13 (SNB), U1.22 (SNC), U1.27 (DGND), U1.35 (AGND), U1.43 (BGND), U1.46 (NC), U1.49 (PAD), U2.2 (GND), U3.19 (VSSA), U3.23 (VSS), U3.35 (VSS), U3.47 (VSS), U4.8 (GND), U4.10 (TEST), U4.17 (PAD), U$3.A, X1.2, X1.4
unnamed: C1.1, U1.4 (CPH)
unnamed: C1.2, U1.3 (CPL)
unnamed: C2.1, U1.5 (VCP)
unnamed: C5.1, U1.36 (DVDD)
unnamed: C21.2, L1.2, U3.20 (VDDA/VREF+), U3.21 (VDDA/VREF+)
unnamed: C22.2, U3.6 (PF1-OSC_OUT), X1.3
unnamed: C23.2, U3.5 (PF0-OSC_IN), X1.1
unnamed: C24.2, R19.1, SW1.1 (1.1), SW1.2 (1.2), U3.7 (PG10-NRST), U$16.2 (A)
unnamed: D1.1 (K), LED2.2 (A), Q8.P$4 (G), R55.1, R56.2, T1.C
unnamed: LED1.1 (K), R1.1
unnamed: LED2.1 (K), R16.1
unnamed: LED3.1 (K), R18.1
unnamed: LED4.1 (K), R58.1
unnamed: LED5.1 (K), R51.1
unnamed: LED6.1 (K), R26.1
unnamed: LED6.2 (A), R25.2, T2.B
unnamed: LED7.1 (K), R28.1
unnamed: Q7.1 (B), U$10.2 (A)
unnamed: Q7.3 (C), R55.2
unnamed: Q8.P$5 (D), R18.2, R24.1
unnamed: R6.2, T1.B
unnamed: R9.1, U1.34 (CAL)
unnamed: R10.1, R11.2, U1.1 (FB)
unnamed: R20.2, U3.45 (PB8-BOOT0)
unnamed: R27.2, T2.E
unnamed: R54.2, U$10.1 (K)
