avena-robotics/pcbs/ARM_NUCLEO_HAT_1.0/ARM_NUCLEO_HAT_1.0.kicad_pcb

## KiCad design ARM_NUCLEO_HAT_1.0/ARM_NUCLEO_HAT_1.0.kicad_pcb (2022-05-02)

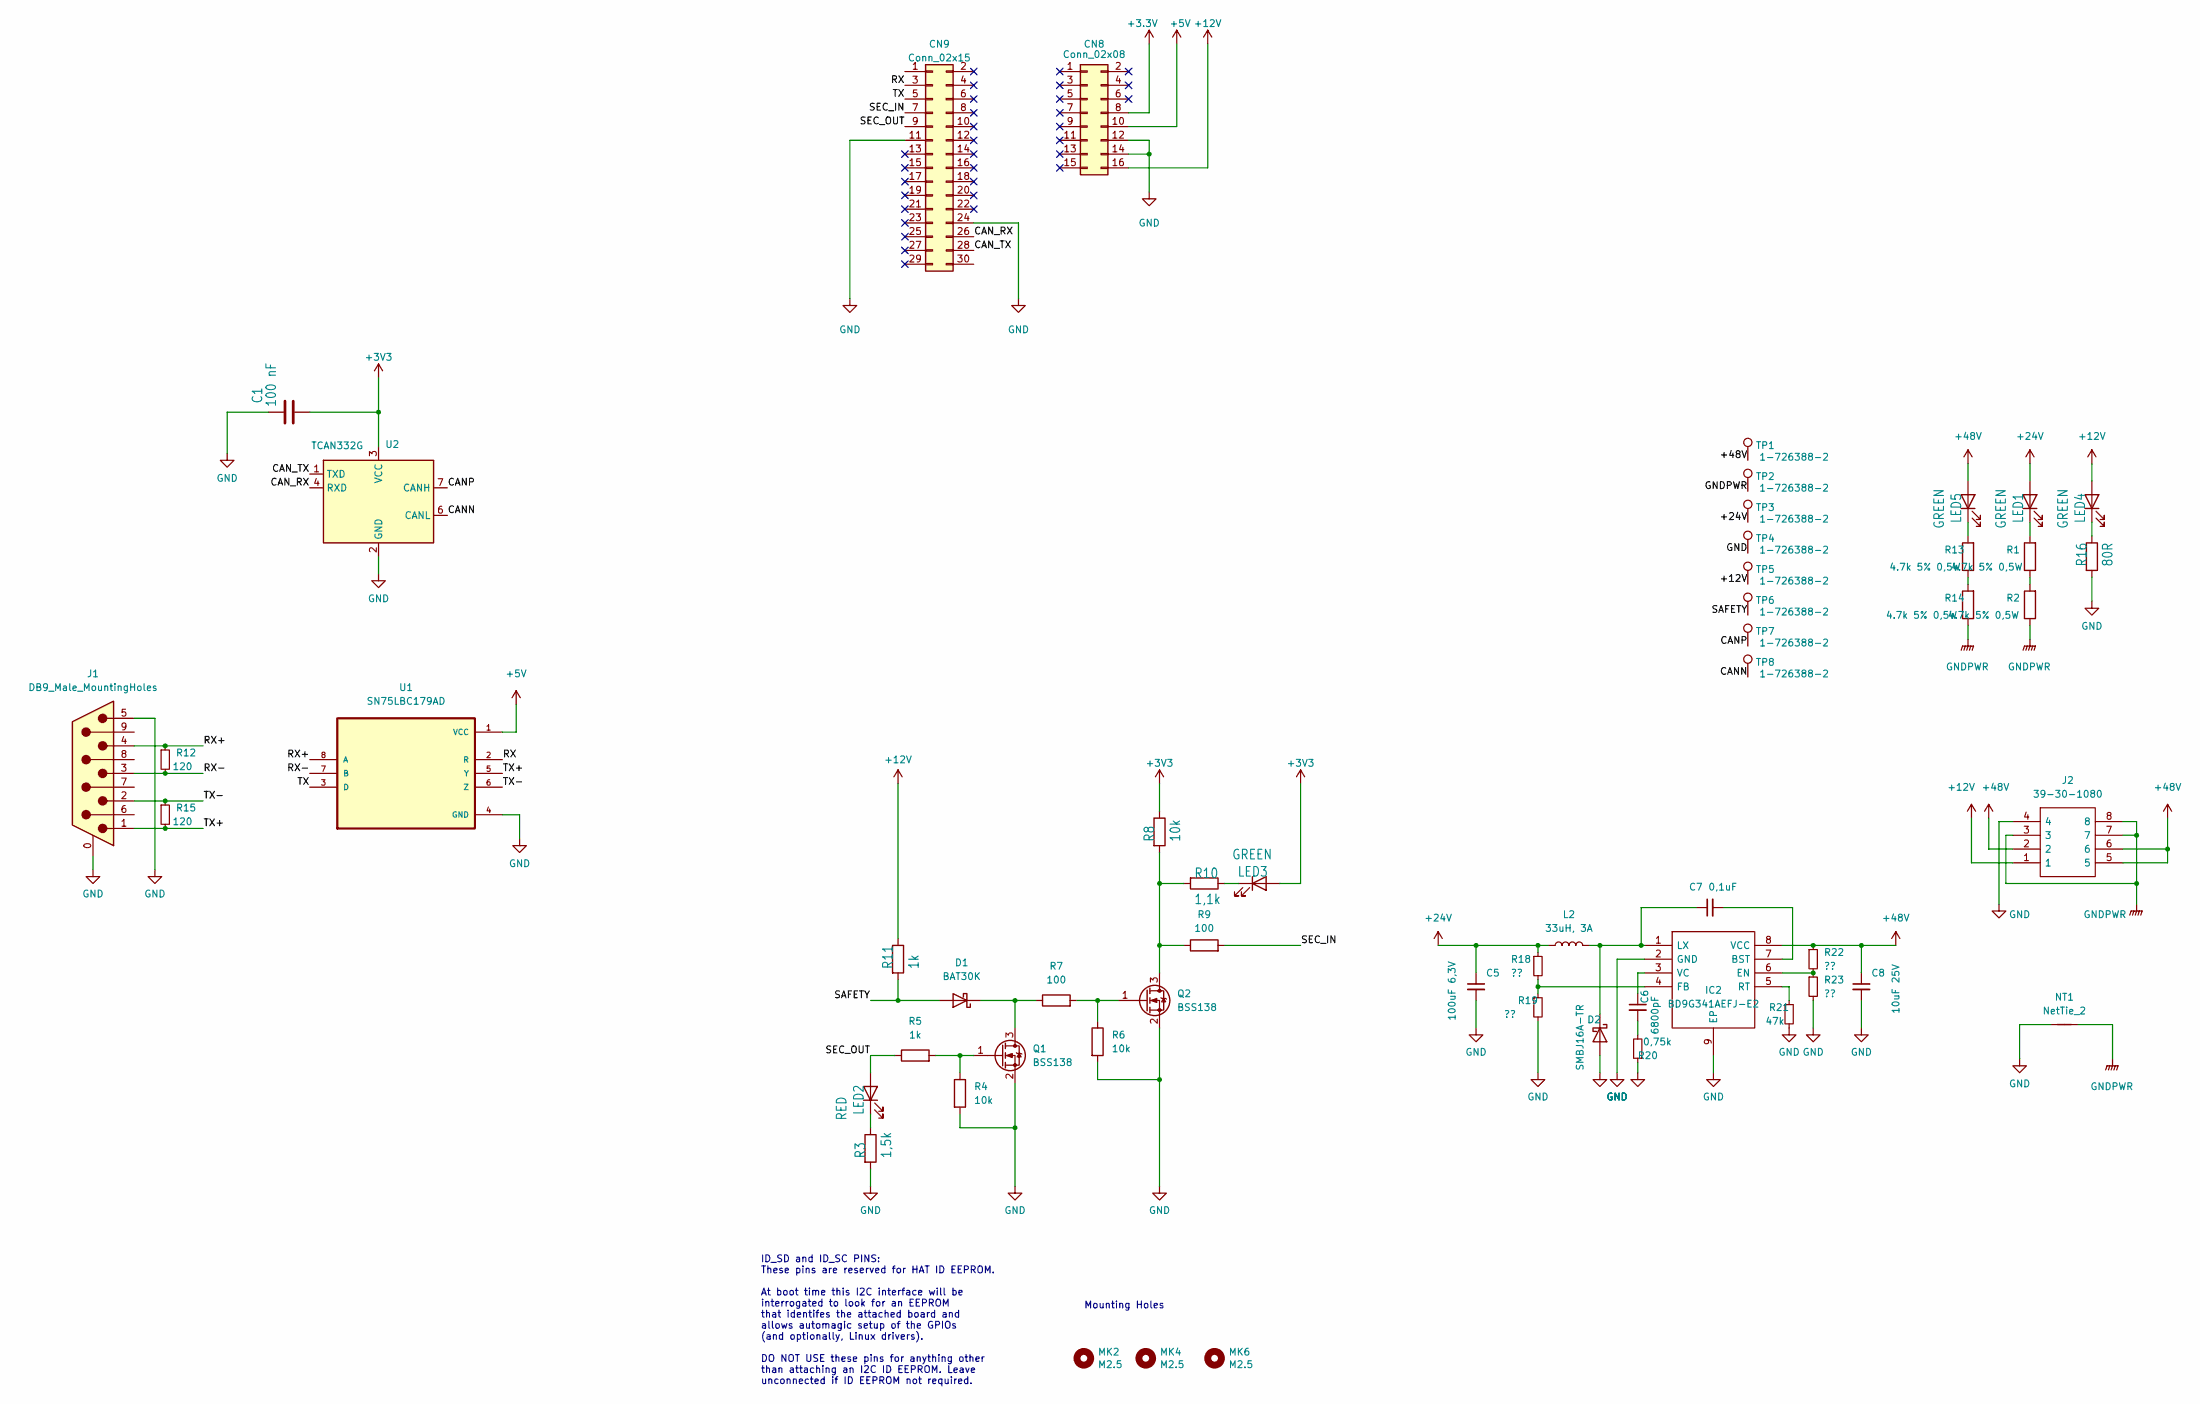
[picture p98: schematic ARM_NUCLEO_HAT_1.0.kicad_sch]

Parts:
C1: 100 nF; C_0603_1608Metric_Pad1.08x0.95mm_HandSolder
C5: 100uF 6,3V; C_1206_3216Metric_Pad1.33x1.80mm_HandSolder
C6: 6800pF; C_0603_1608Metric_Pad1.08x0.95mm_HandSolder
C7: 0,1uF; C_0603_1608Metric_Pad1.08x0.95mm_HandSolder
C8: 10uF 25V; C_0603_1608Metric_Pad1.08x0.95mm_HandSolder
CN8: Conn_02x08; PinSocket_2x08_P2.54mm_Vertical
CN9: Conn_02x15; PinSocket_2x15_P2.54mm_Vertical
D1: BAT30K; D_0603_1608Metric_Pad1.05x0.95mm_HandSolder
D2: SMBJ16A-TR; D_SMB_Handsoldering
IC2: BD9G341AEFJ-E2; SOIC127P600X100-9N; Mouser Part Number 755-BD9G341AEFJ-E2
J1: DB9_Male_MountingHoles; DSUB-9_Male_Horizontal_P2.77x2.84mm_EdgePinOffset7.70mm_Hou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
J2: 39-30-1080; 39301080; Mouser Part Number 538-39-30-1080
L2: 33uH, 3A; MPEV1D1040L330
LED1, LED3, LED4, LED5: GREEN; D_0603_1608Metric_Pad1.05x0.95mm_HandSolder
LED2: RED; D_0603_1608Metric_Pad1.05x0.95mm_HandSolder
MK2, MK4, MK6: M2.5; MountingHole_2.7mm_M2.5
NT1: NetTie_2; NetTie-2_SMD_Pad0.5mm
Q1, Q2: BSS138; SOT-23
R1, R2, R13, R14: 4.7k 5% 0,5W; R_0805_2012Metric_Pad1.20x1.40mm_HandSolder
R3: 1,5k; R_0603_1608Metric_Pad0.98x0.95mm_HandSolder
R4, R6, R8: 10k; R_0603_1608Metric_Pad0.98x0.95mm_HandSolder
R5, R11: 1k; R_0603_1608Metric_Pad0.98x0.95mm_HandSolder
R7, R9: 100; R_0603_1608Metric_Pad0.98x0.95mm_HandSolder
R10: 1,1k; R_0603_1608Metric_Pad0.98x0.95mm_HandSolder
R12, R15: 120; R_0603_1608Metric_Pad0.98x0.95mm_HandSolder
R16: 80R; R_0603_1608Metric_Pad0.98x0.95mm_HandSolder
R18, R19, R22, R23: ??; R_0603_1608Metric_Pad0.98x0.95mm_HandSolder
R20: 0,75k; R_0603_1608Metric_Pad0.98x0.95mm_HandSolder
R21: 47k; R_0603_1608Metric_Pad0.98x0.95mm_HandSolder
TP1, TP2, TP3, TP4, TP5, TP6, TP7, TP8: 1-726388-2; 61-1537-11-0031
U1: SN75LBC179AD; SOIC127P599X175-8N
U2: TCAN332G; SO-8_3.9x4.9mm_P1.27mm

Connections:
+5V: CN8.10, U1.1 (VCC)
+12V: CN8.16, J2.1, LED4.2 (A), R11.1, TP5.1
+24V: C5.1, L2.1, LED1.2 (A), R18.1, TP3.1
+48V: C8.1, IC2.8 (VCC), J2.2, J2.5, J2.6, LED5.2 (A), R22.1, TP1.1
/CANN: TP8.1, U2.6 (CANL)
/CANP: TP7.1, U2.7 (CANH)
/CAN_RX: CN9.26, U2.4 (RXD)
/CAN_TX: CN9.28, U2.1 (TXD)
/RX: CN9.3, U1.2 (R)
/RX+: J1.4, R12.1, U1.8 (A)
/RX-: J1.3, R12.2, U1.7 (B)
/SAFETY: D1.2 (A), R11.2, TP6.1
/SEC_IN: CN9.7, R9.2
/SEC_OUT: CN9.9, LED2.2 (A), R5.1
/TX: CN9.5, U1.3 (D)
/TX+: J1.1, R15.2, U1.5 (Y)
/TX-: J1.2, R15.1, U1.6 (Z)
GND: C1.2, C5.2, C8.2, CN8.12, CN8.14, CN9.11, CN9.24, D2.2 (A), IC2.2 (GND), IC2.9 (EP), J1.0 (PAD), J1.5, J2.4, NT1.1, Q1.2 (S), Q2.2 (S), R3.2, R4.2, R6.2, R16.2, R19.2, R20.1, R21.2, R23.2, TP4.1, U1.4 (GND), U2.2 (GND)
GNDPWR: J2.3, J2.7, J2.8, NT1.2, R2.1, R14.1, TP2.1
unnamed: C6.1, IC2.3 (VC)
unnamed: C6.2, R20.2
unnamed: C7.1, D2.1 (K), IC2.1 (LX), L2.2
unnamed: C7.2, IC2.7 (BST)
unnamed: D1.1 (K), Q1.3 (D), R7.1
unnamed: IC2.4 (FB), R18.2, R19.1
unnamed: IC2.5 (RT), R21.1
unnamed: IC2.6 (EN), R22.2, R23.1
unnamed: LED1.1 (K), R1.2
unnamed: LED2.1 (K), R3.1
unnamed: LED3.1 (K), R10.1
unnamed: LED4.1 (K), R16.1
unnamed: LED5.1 (K), R13.2
unnamed: Q1.1 (G), R4.1, R5.2
unnamed: Q2.1 (G), R6.1, R7.2
unnamed: Q2.3 (D), R8.2, R9.1, R10.2
unnamed: R1.1, R2.2
unnamed: R13.1, R14.2

Notes on the sheet:
ID_SD and ID_SC PINS: These pins are reserved for HAT ID EEPROM. At boot time this I2C interface will be interrogated to look for an EEPROM that identifes the attached board and allows automagic setup of the GPIOs (and optionally, Linux drivers). DO NOT USE these pins for anything other than attach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
Mounting Holes

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
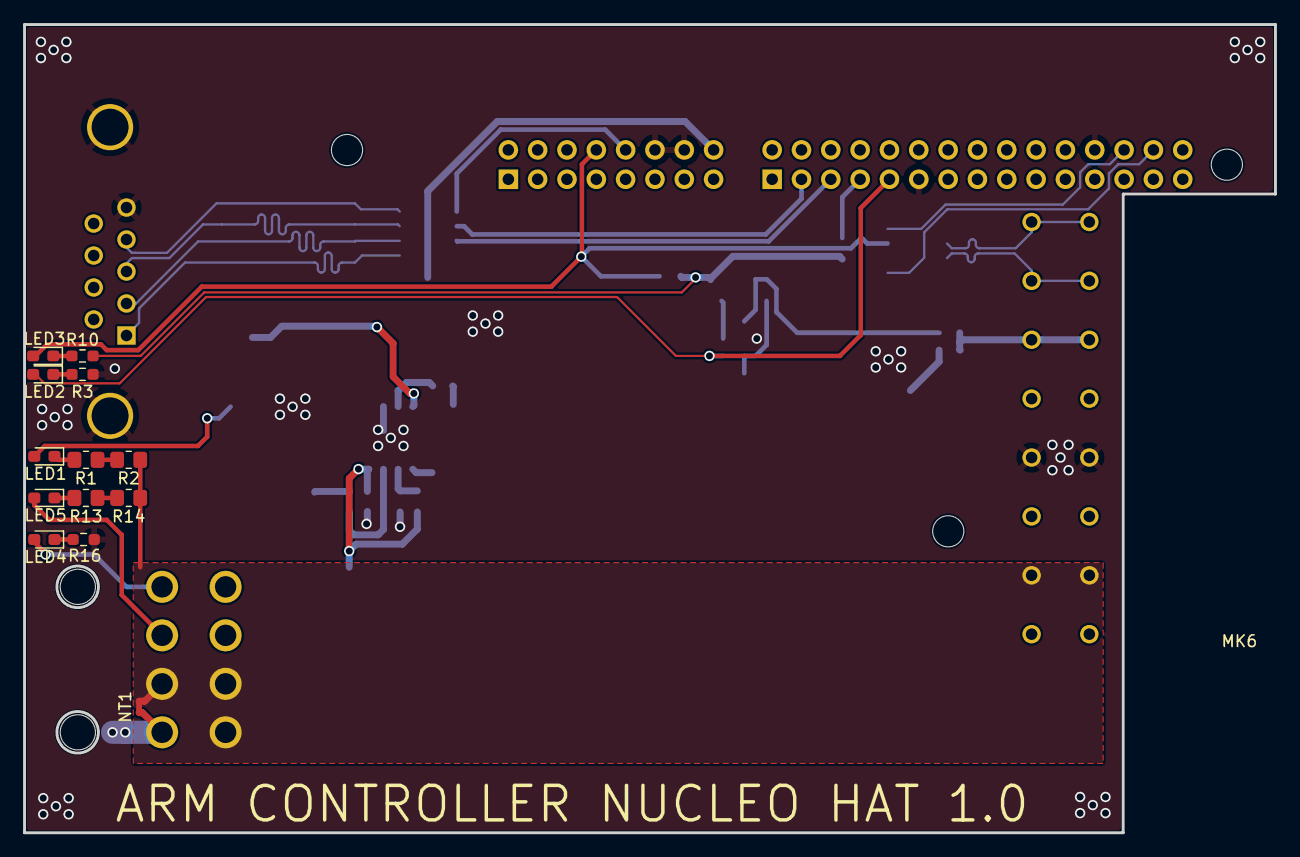
[picture p99: board ARM_NUCLEO_HAT_1.0.kicad_pcb from above]

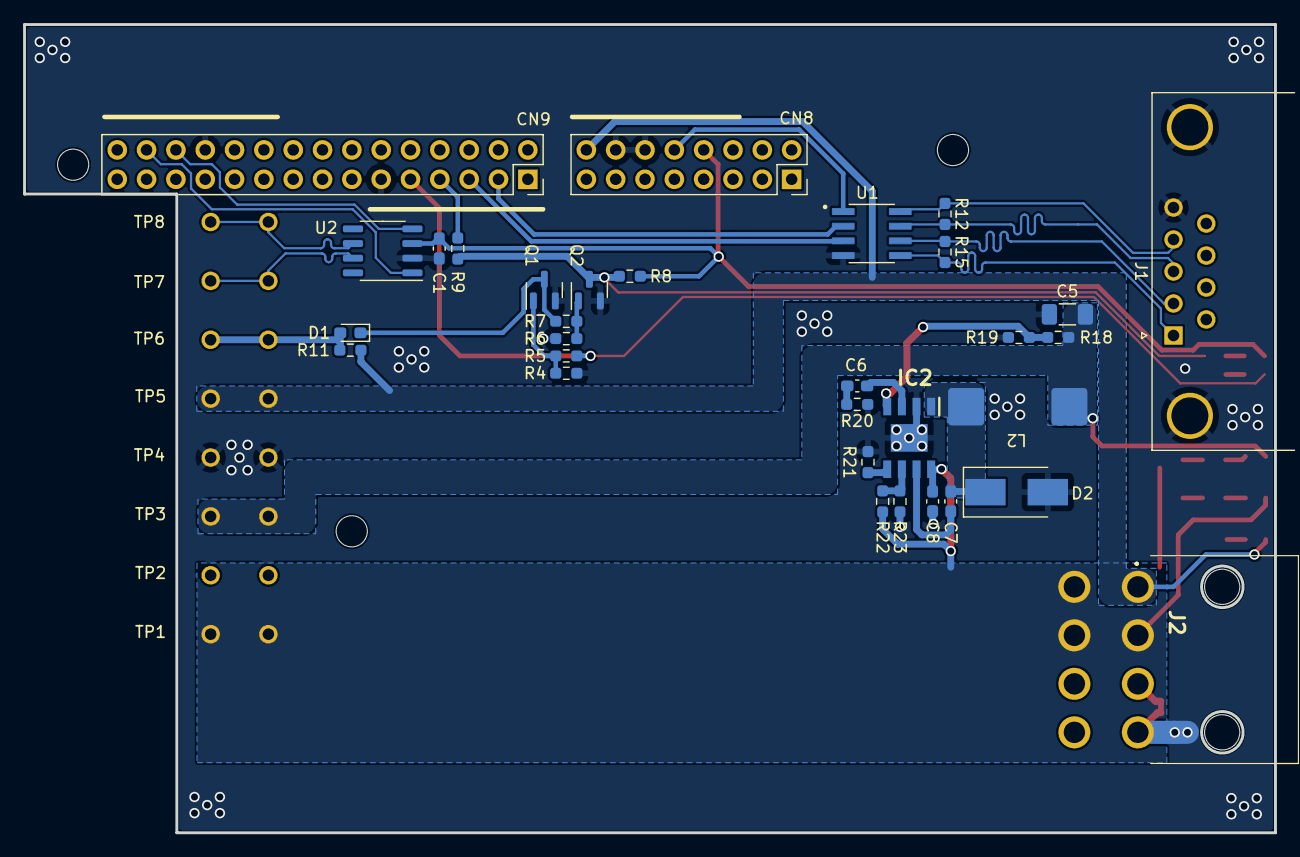
[picture p100: board ARM_NUCLEO_HAT_1.0.kicad_pcb from below]

Board: 2 copper layers, 108.3 x 70.0 mm, 56 parts (40 on the bottom side), 38 nets.
