avena-robotics/pcbs/UNIVERSAL_HALL_PCB_RI70_v2.9/universal_hall_pcb_RI70_v2.9.kicad_pcb

## KiCad design UNIVERSAL_HALL_PCB_RI70_v2.9/universal_hall_pcb_RI70_v2.9.kicad_pcb (2022-05-02, an earlier design)

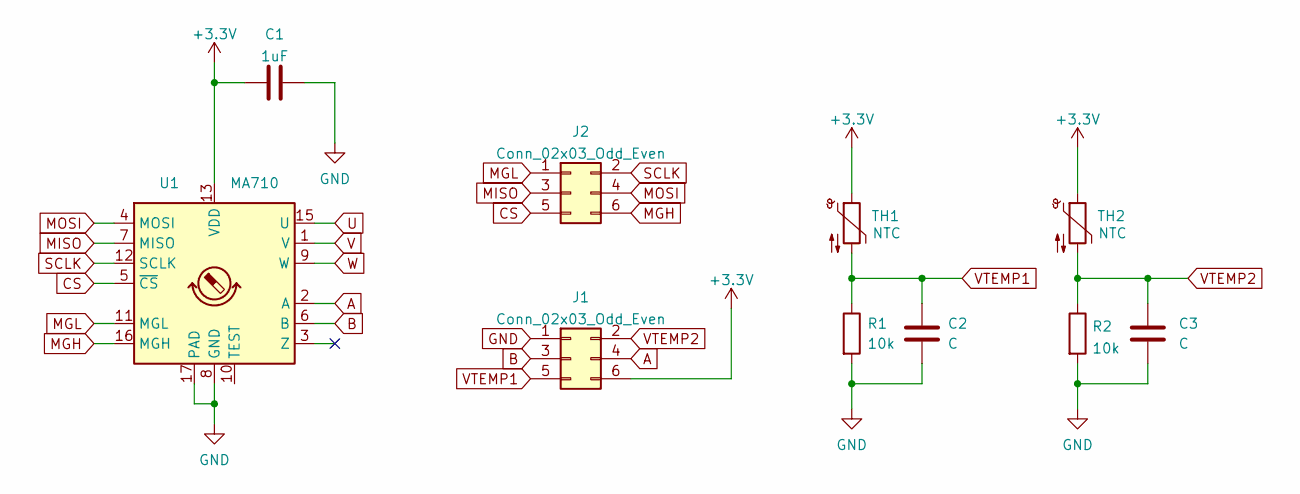
[picture p101: schematic universal_hall_pcb_RI70_v2.9.kicad_sch]

Parts:
C1: 1uF; C_0603_1608Metric_Pad1.08x0.95mm_HandSolder
C2, C3: C; C_0603_1608Metric_Pad1.08x0.95mm_HandSolder
J1, J2: Conn_02x03_Odd_Even; PinSocket_2x03_P2.54mm_Vertical
R1, R2: 10k; R_0603_1608Metric_Pad0.98x0.95mm_HandSolder
TH1, TH2: NTC; PinHeader_1x02_P2.54mm_Vertical
U1: MA710; VQFN-16-1EP_3x3mm_P0.5mm_EP1.8x1.8mm

Connections:
+3V3: C1.1, J1.6, TH1.1, TH2.1, U1.13 (VDD)
A: J1.4, U1.2 (A)
B: J1.3, U1.6 (B)
CS: J2.5, U1.5 (~CS)
GND: C1.2, C2.2, C3.2, J1.1, R1.2, R2.2, U1.8 (GND), U1.17 (PAD)
MGH: J2.6, U1.16 (MGH)
MGL: J2.1, U1.11 (MGL)
MISO: J2.3, U1.7 (MISO)
MOSI: J2.4, U1.4 (MOSI)
SCLK: J2.2, U1.12 (SCLK)
U: U1.15 (U)
V: U1.1 (V)
VTEMP1: C2.1, J1.5, R1.1, TH1.2
VTEMP2: C3.1, J1.2, R2.1, TH2.2
W: U1.9 (W)

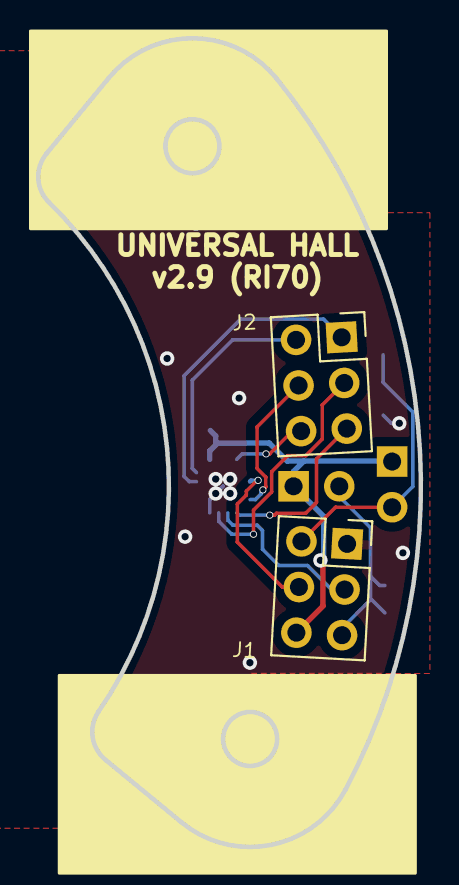
[picture p102: board universal_hall_pcb_RI70_v2.9.kicad_pcb from above]

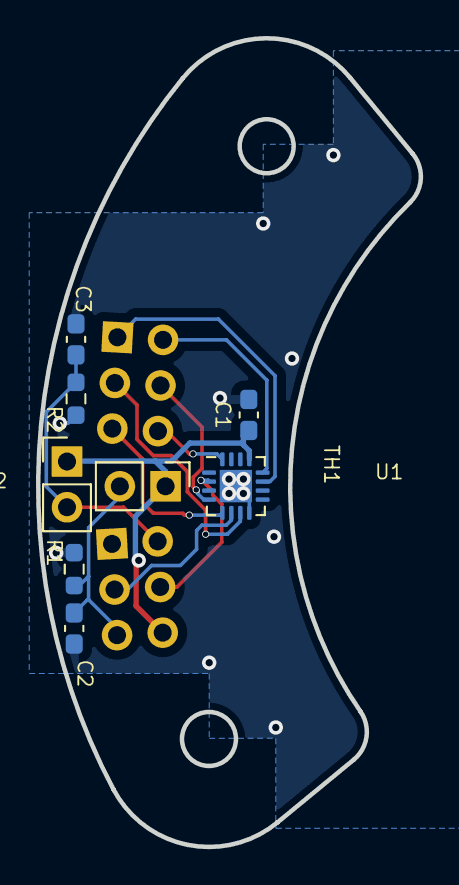
[picture p103: board universal_hall_pcb_RI70_v2.9.kicad_pcb from below]

Board: 2 copper layers, 21.3 x 44.9 mm, 10 parts (8 on the bottom side), 12 nets.
