avena-robotics/pcbs/GRIPPER_TWO_ADVANCED_CONECTION_BOARD_v1.2/GRIPPER_TWO_ADVANCED_CONECTION_BOARD.kicad_pcb

## KiCad design GRIPPER_TWO_ADVANCED_CONECTION_BOARD_v1.2/GRIPPER_TWO_ADVANCED_CONECTION_BOARD.kicad_pcb (2022-05-02)

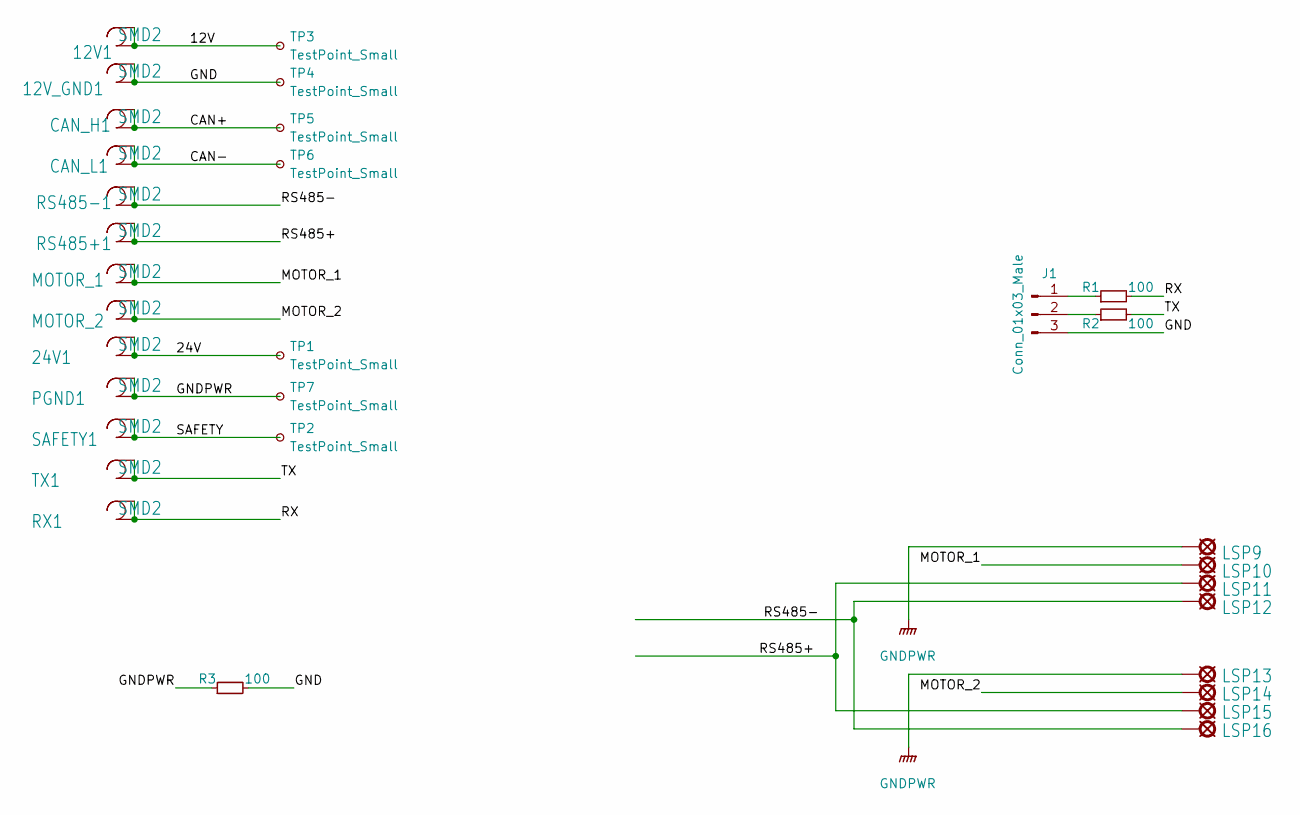
[picture p104: schematic GRIPPER_TWO_ADVANCED_CONECTION_BOARD.kicad_sch]

Parts:
12V1, 12V_GND1, 24V1: SMD2; SMD1,27-2,54
CAN_H1: SMD2; SMD1,27-2,54
CAN_L1: SMD2; SMD1,27-2,54
J1: Conn_01x03_Male; PinHeader_1x03_P2.54mm_Vertical
LSP9, LSP10, LSP11, LSP12, LSP13, LSP14, LSP15, LSP16: SE11
MOTOR_1, MOTOR_2: SMD2; SMD1,27-2,54
PGND1: SMD2; SMD1,27-2,54
R1, R2, R3: 100; R_0603_1608Metric_Pad0.98x0.95mm_HandSolder
RS485+1, RS485-1: SMD2; SMD1,27-2,54
RX1: SMD2; SMD1,27-2,54
SAFETY1: SMD2; SMD1,27-2,54
TP1, TP2, TP3, TP4, TP5, TP6, TP7: TestPoint_Small; TestPoint_Pad_1.0x1.0mm
TX1: SMD2; SMD1,27-2,54

Connections:
/12V: 12V1.1, 12V1.2, TP3.1
/24V: 24V1.1, 24V1.2, TP1.1
/CAN+: CAN_H1.1, CAN_H1.2, TP5.1
/CAN-: CAN_L1.1, CAN_L1.2, TP6.1
/GND: 12V_GND1.1, 12V_GND1.2, J1.3, R3.2, TP4.1
/MOTOR_1: LSP10.MP, MOTOR_1.1, MOTOR_1.2
/MOTOR_2: LSP14.MP, MOTOR_2.1, MOTOR_2.2
/RS485+: LSP11.MP, LSP15.MP, RS485+1.1, RS485+1.2
/RS485-: LSP12.MP, LSP16.MP, RS485-1.1, RS485-1.2
/RX: R1.2, RX1.1, RX1.2
/SAFETY: SAFETY1.1, SAFETY1.2, TP2.1
/TX: R2.2, TX1.1, TX1.2
GNDPWR: LSP9.MP, LSP13.MP, PGND1.1, PGND1.2, R3.1, TP7.1
unnamed: J1.1, R1.1
unnamed: J1.2, R2.1

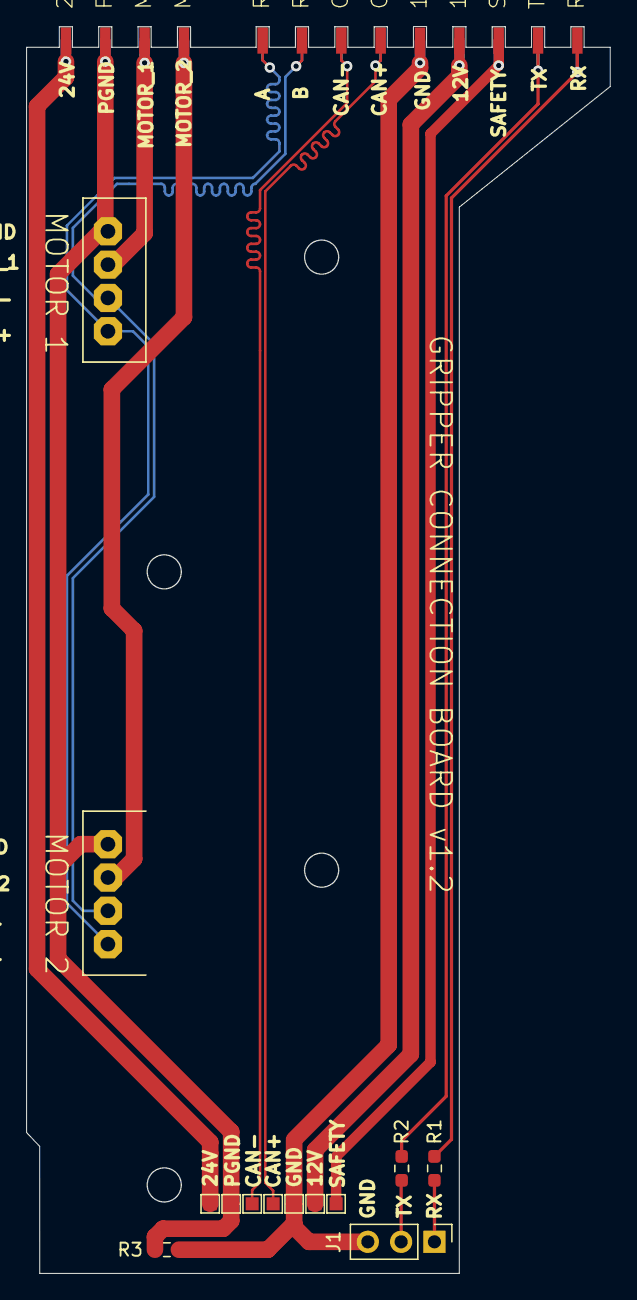
[picture p105: board GRIPPER_TWO_ADVANCED_CONECTION_BOARD.kicad_pcb from above]

Board: 2 copper layers, 44.5 x 95.1 mm, 32 parts (0 on the bottom side), 15 nets.
