avena-robotics/pcbs/UNIVERSAL_JOINT_v3_2/UNIVERSAL_JOINT_v3_2.kicad_pcb

## KiCad design UNIVERSAL_JOINT_v3_2/UNIVERSAL_JOINT_v3_2.kicad_pcb (2022-05-02, an earlier design)

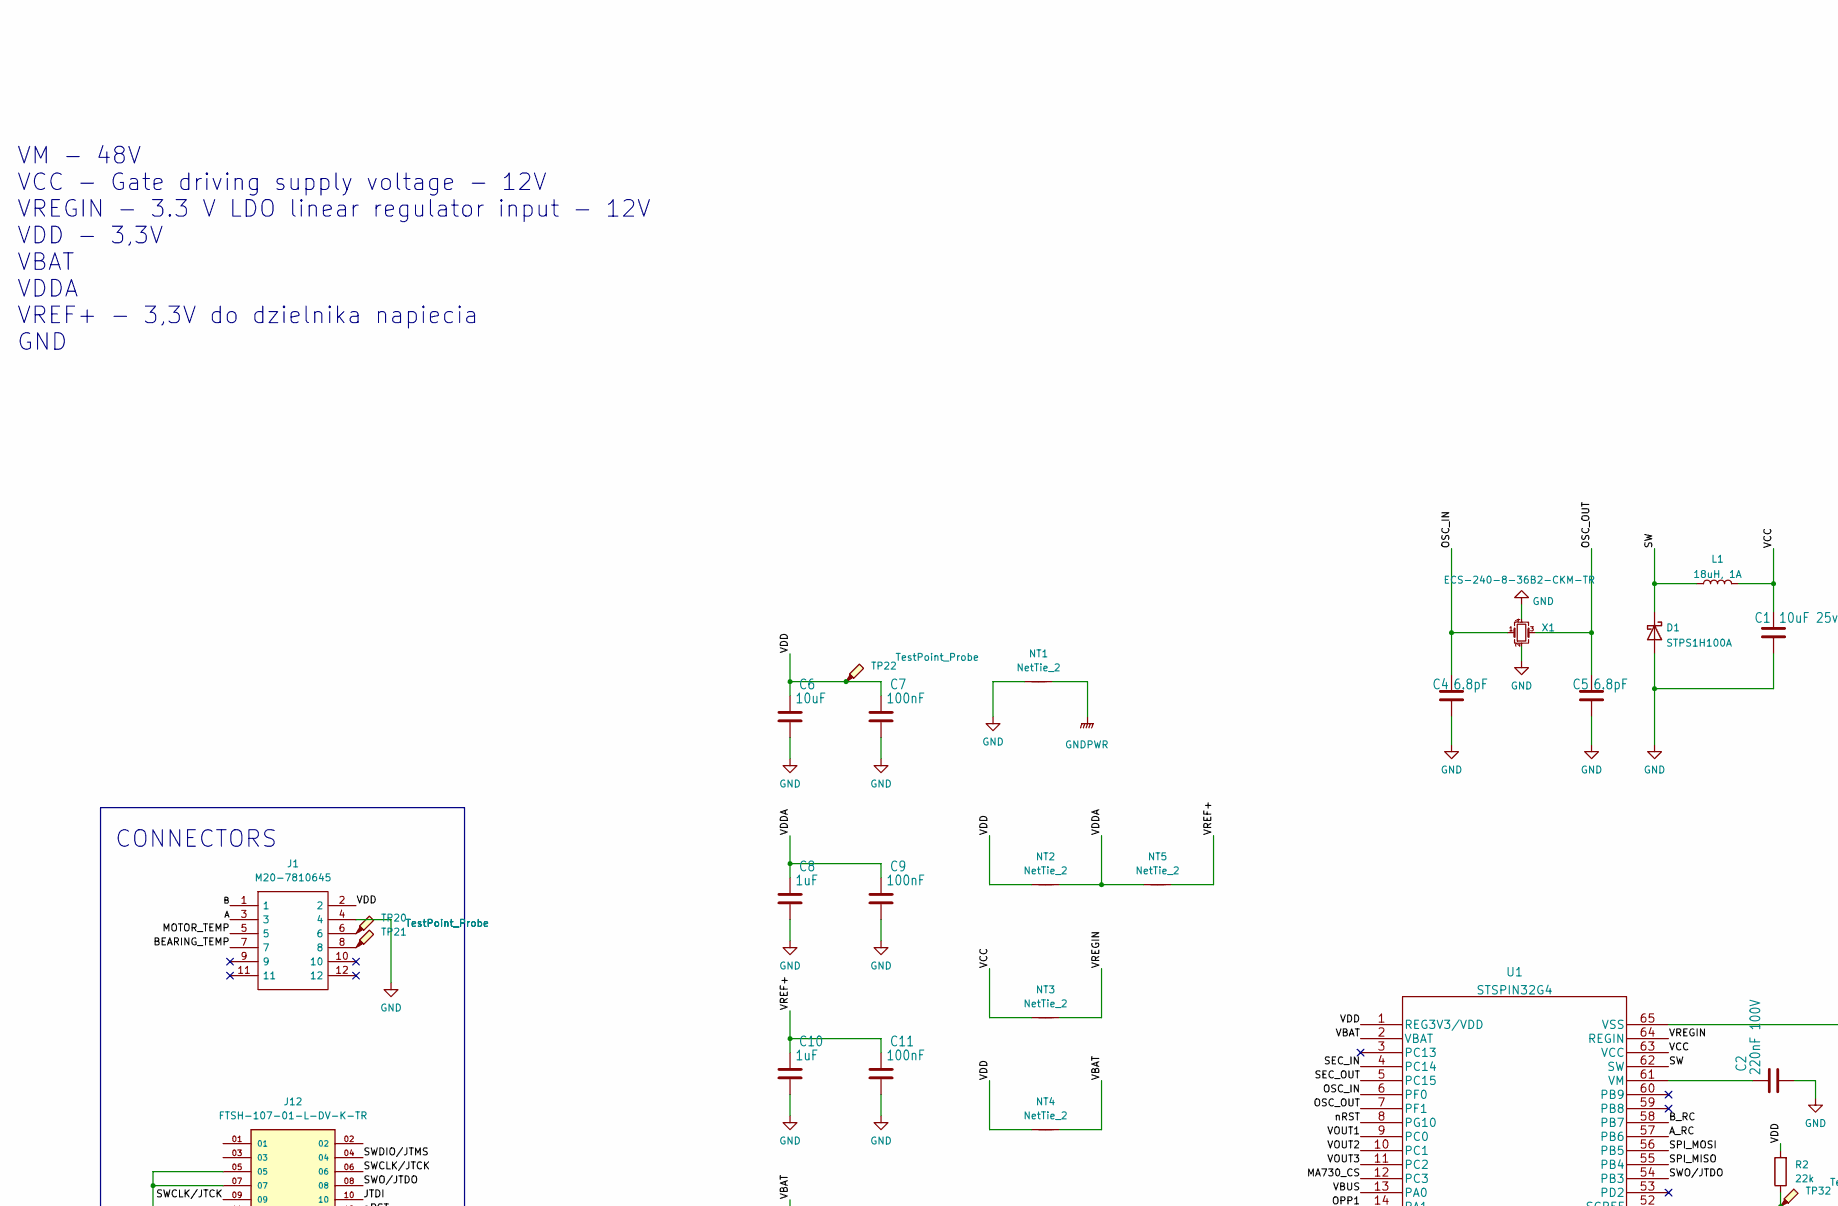
[picture p106: schematic UNIVERSAL_JOINT_v3_2.kicad_sch, part in row 1, column 1]

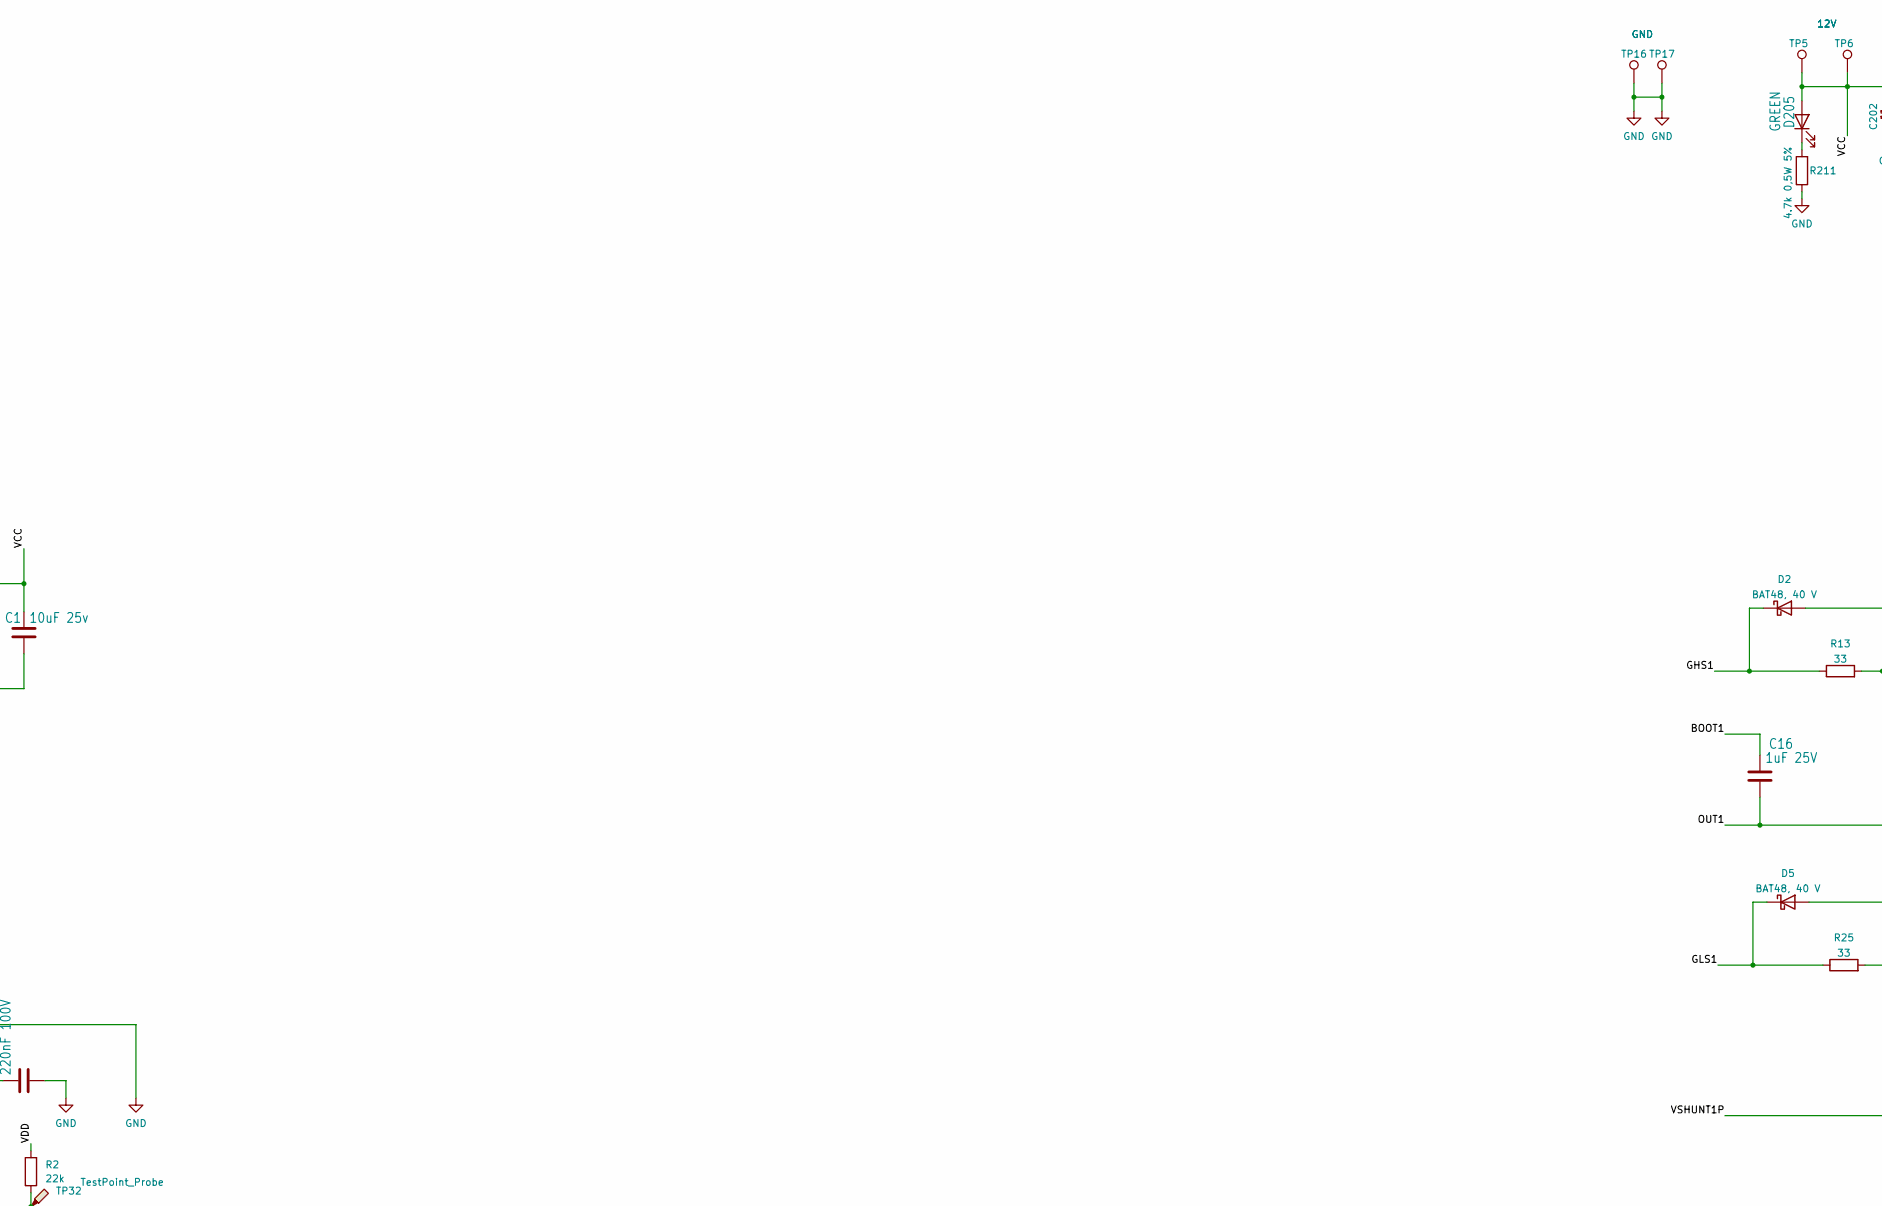
[picture p107: schematic UNIVERSAL_JOINT_v3_2.kicad_sch, part in row 1, column 2]

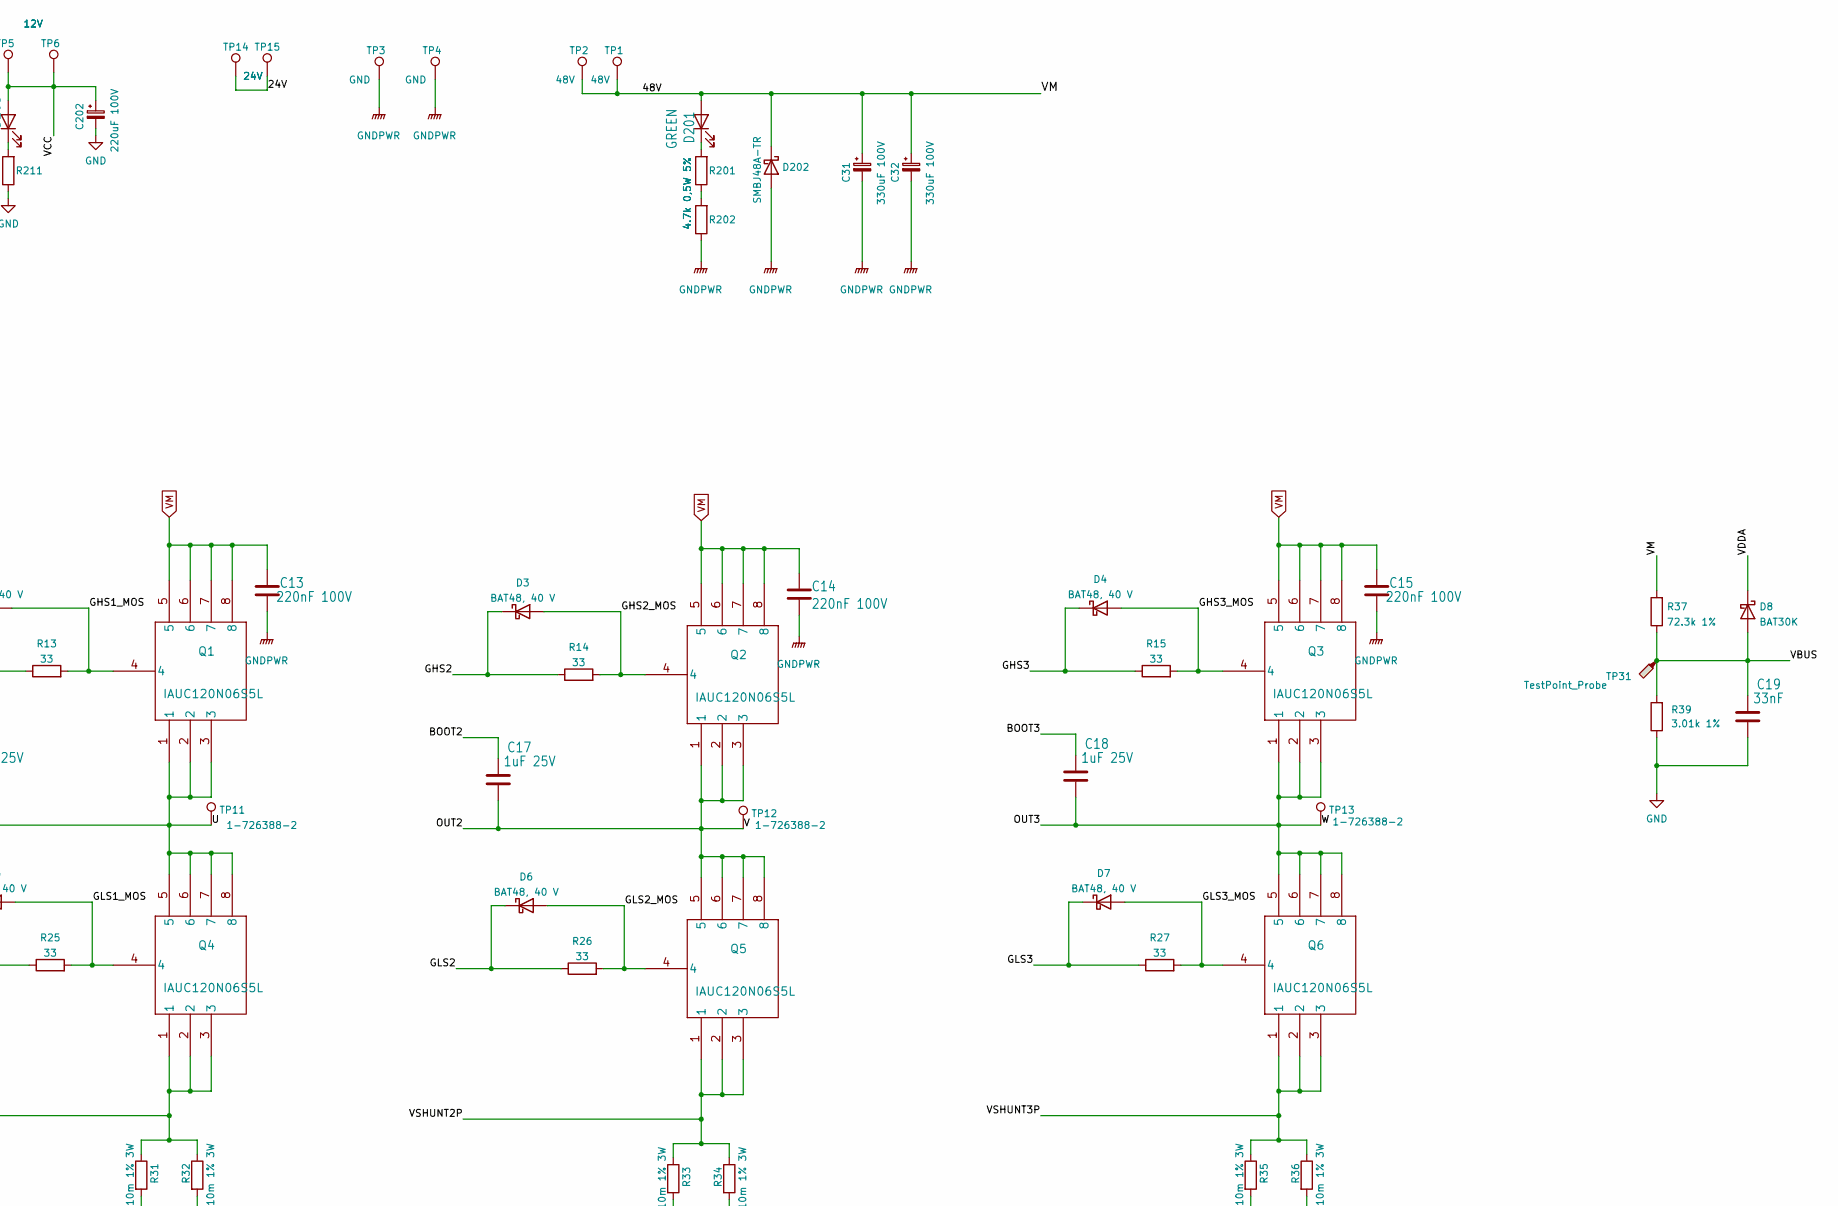
[picture p108: schematic UNIVERSAL_JOINT_v3_2.kicad_sch, part in row 1, column 3]

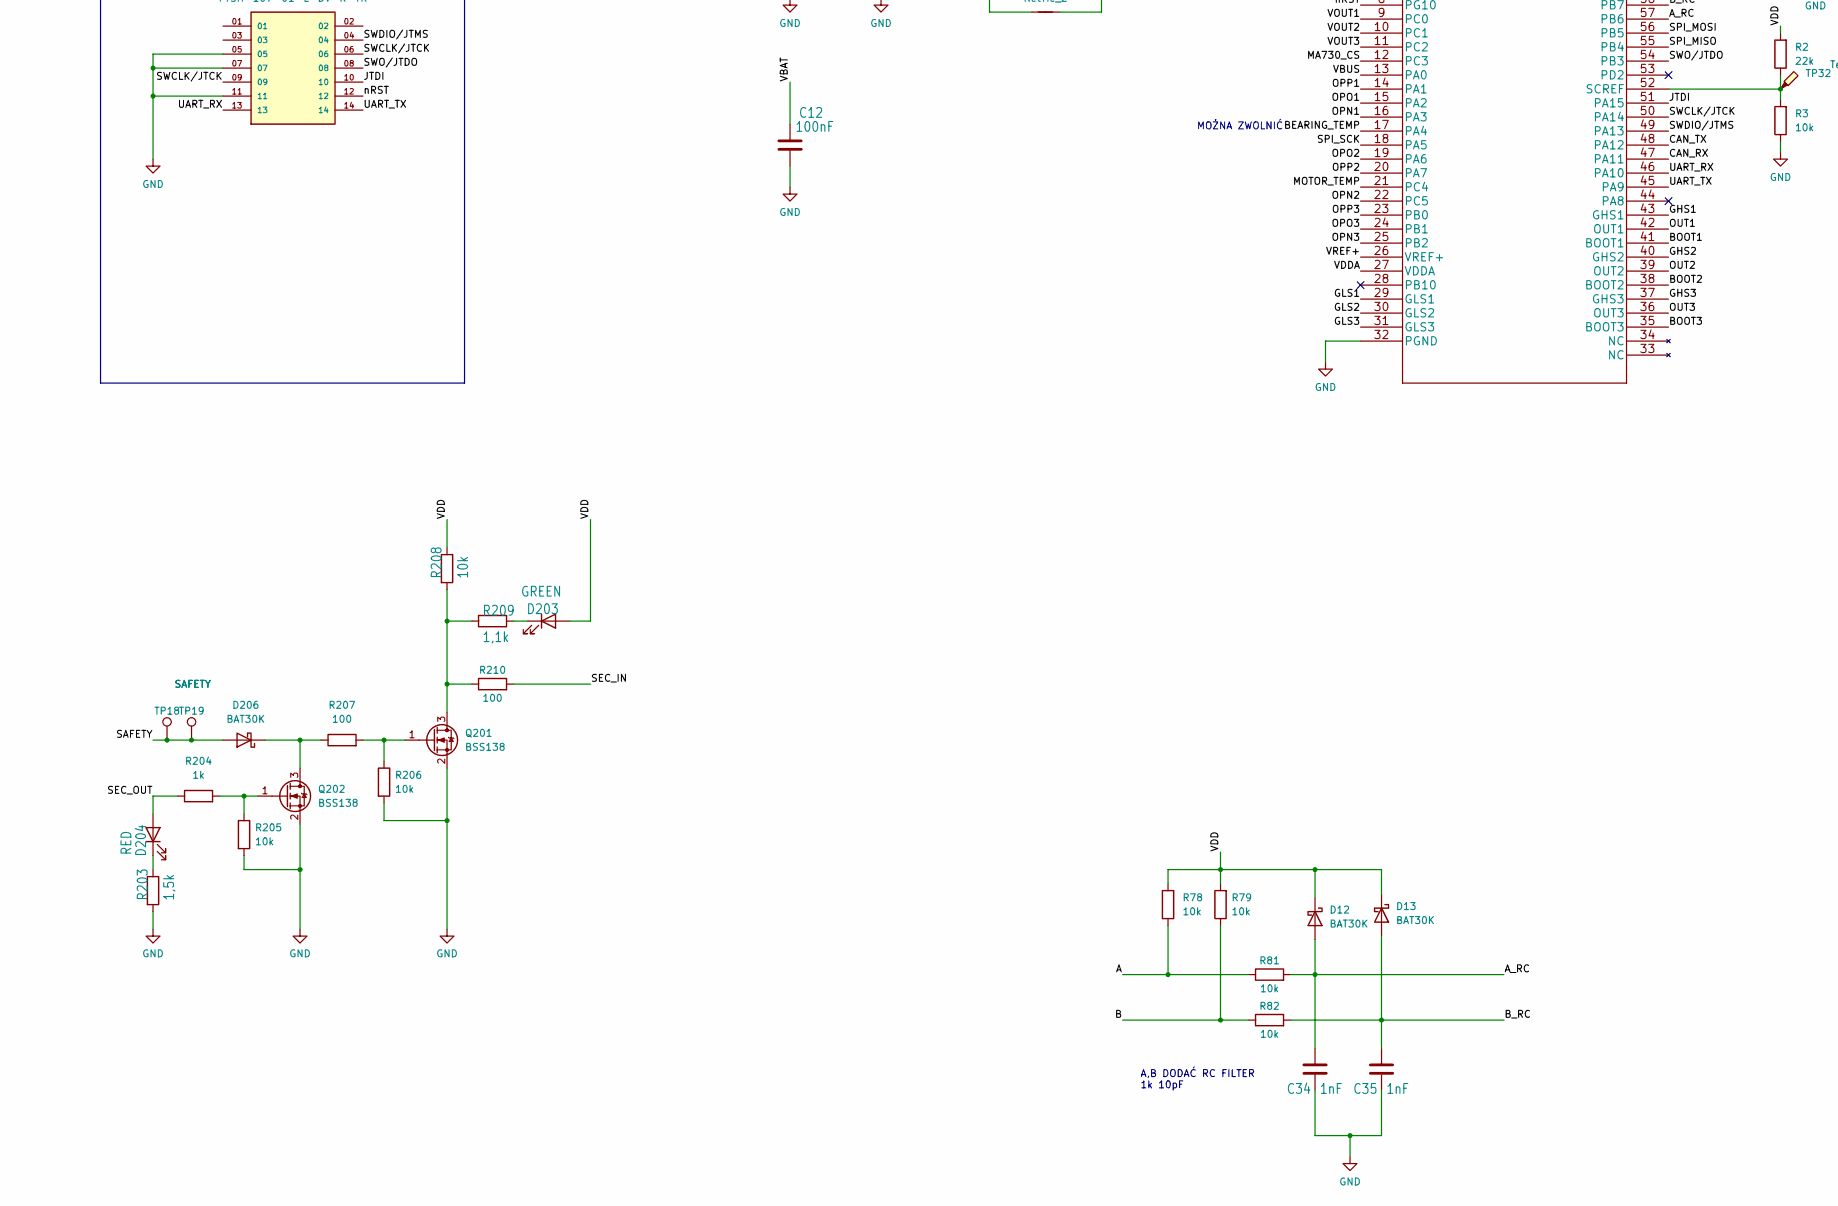
[picture p109: schematic UNIVERSAL_JOINT_v3_2.kicad_sch, part in row 2, column 1]

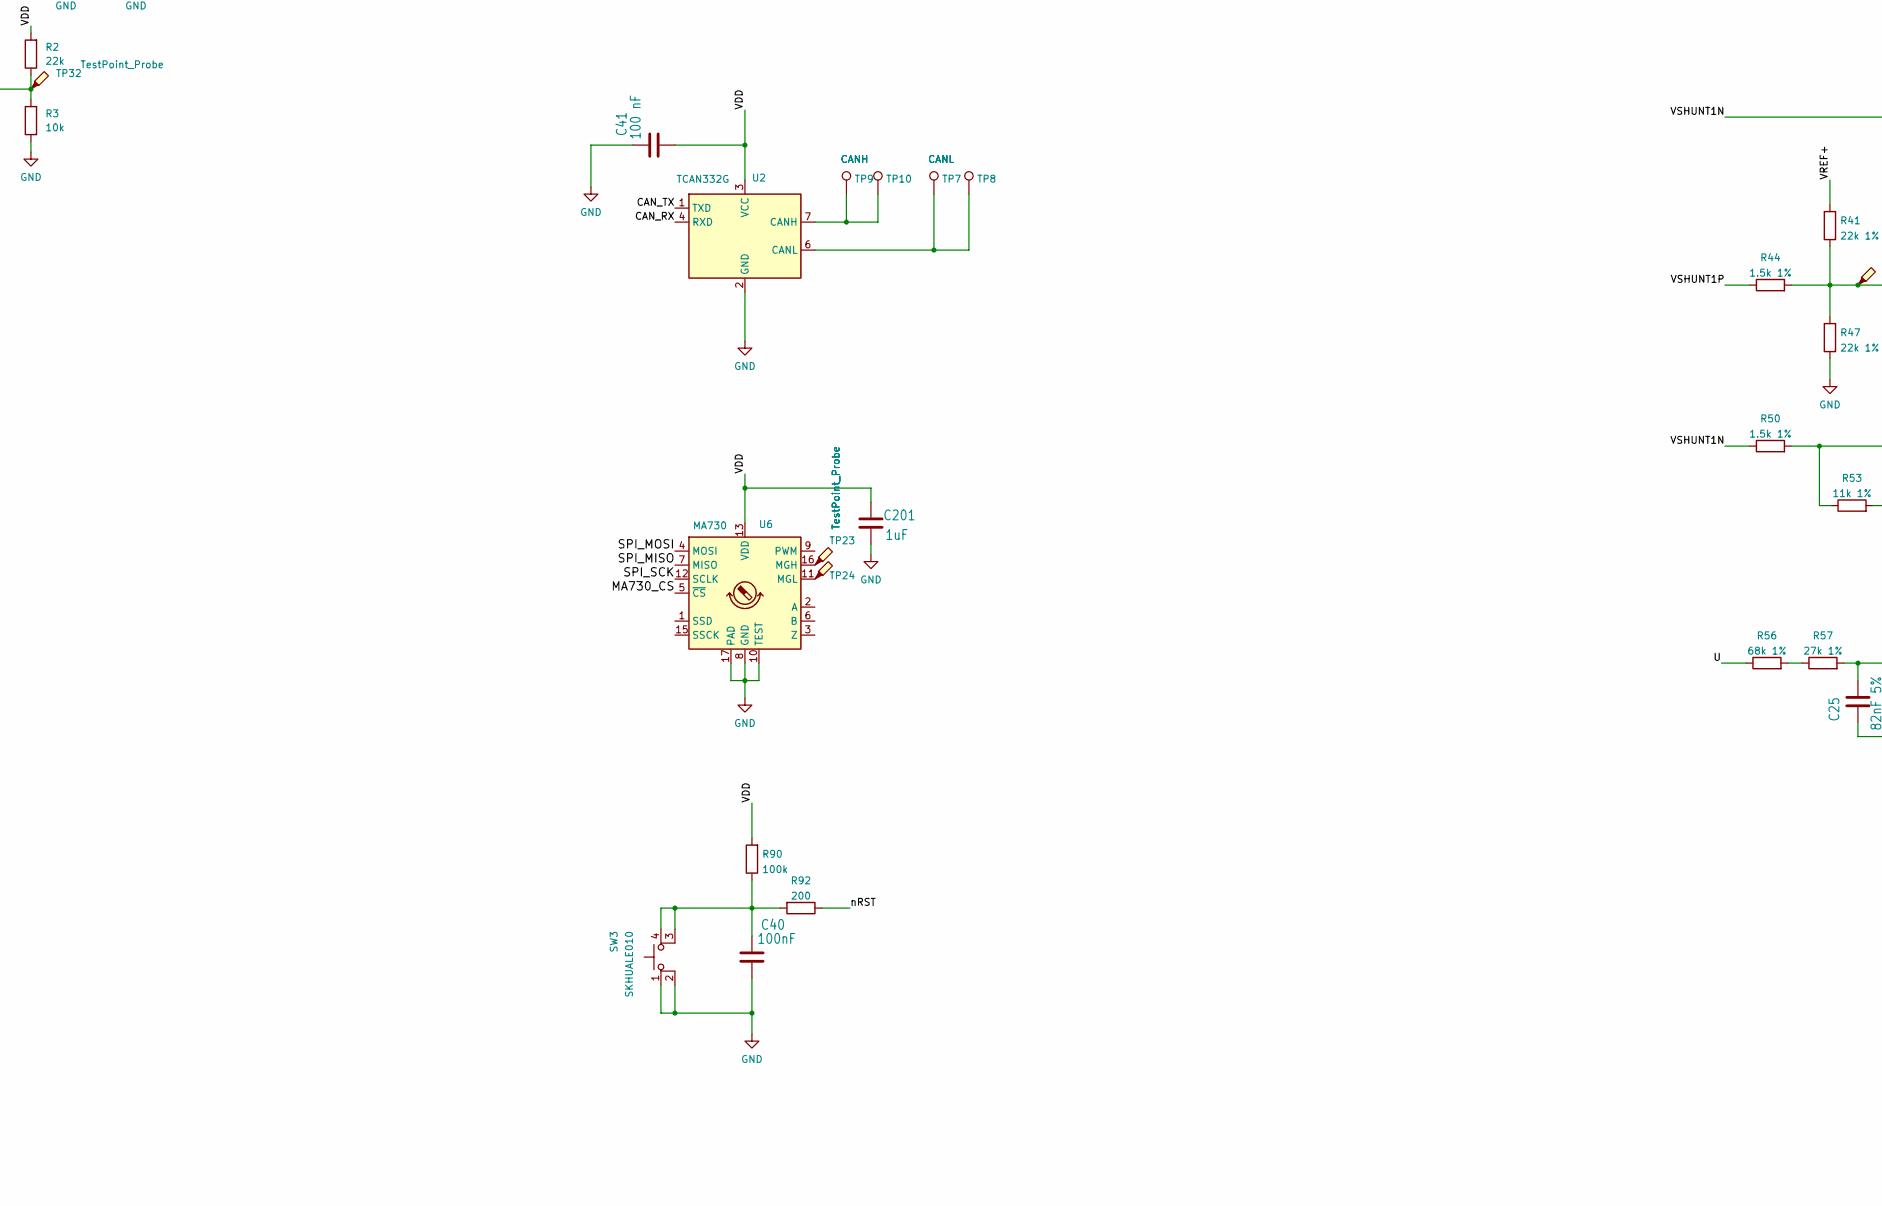
[picture p110: schematic UNIVERSAL_JOINT_v3_2.kicad_sch, part in row 2, column 2]

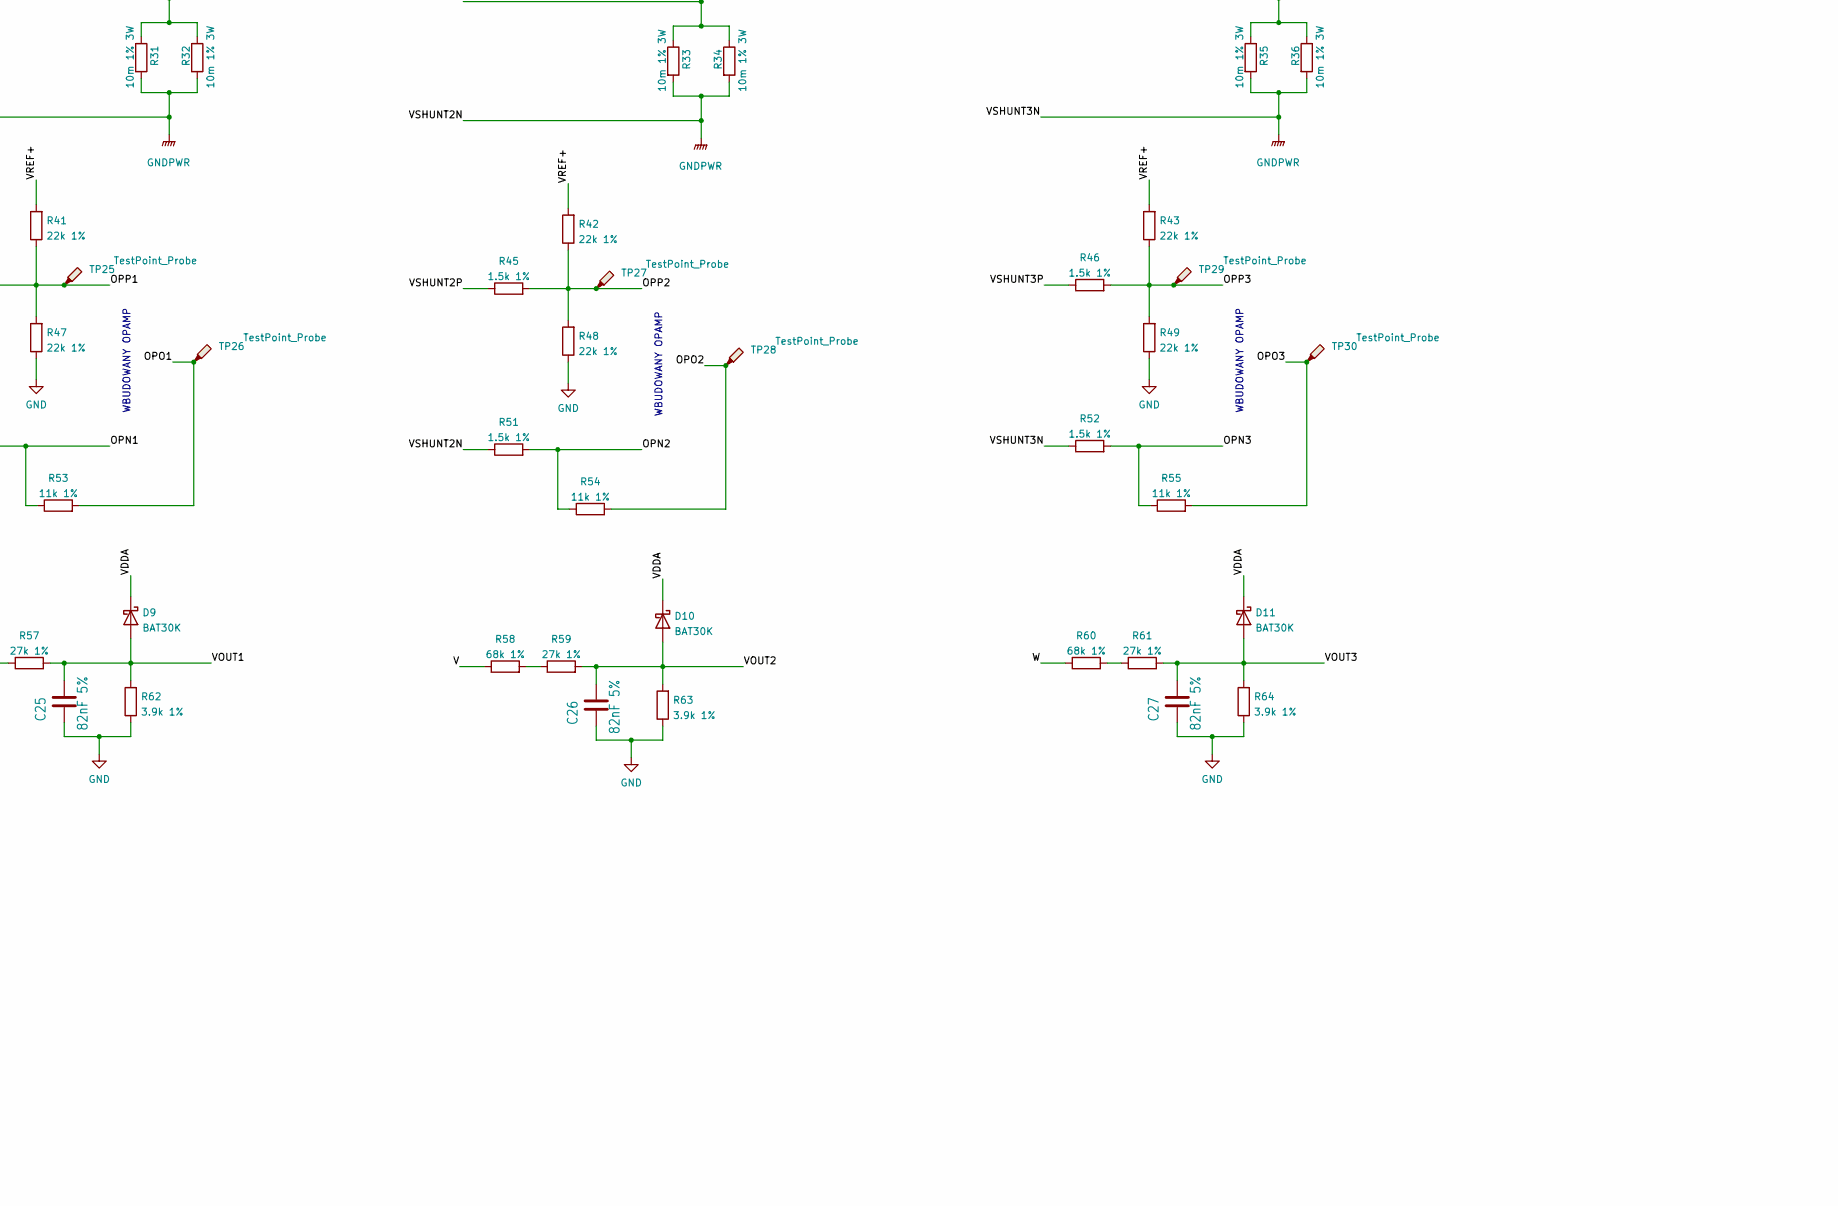
[picture p111: schematic UNIVERSAL_JOINT_v3_2.kicad_sch, part in row 2, column 3]

Parts:
C1: 10uF 25v; C_0603_1608Metric_Pad1.08x0.95mm_HandSolder
C2, C13, C14, C15: 220nF 100V; C_0603_1608Metric_Pad1.08x0.95mm_HandSolder
C4, C5: 6.8pF; C_0603_1608Metric_Pad1.08x0.95mm_HandSolder
C6: 10uF; C_0603_1608Metric_Pad1.08x0.95mm_HandSolder
C7, C9, C11, C12, C40: 100nF; C_0603_1608Metric_Pad1.08x0.95mm_HandSolder
C8, C10, C201: 1uF; C_0603_1608Metric_Pad1.08x0.95mm_HandSolder
C16, C17, C18: 1uF 25V; C_0603_1608Metric_Pad1.08x0.95mm_HandSolder
C19: 33nF; C_0603_1608Metric_Pad1.08x0.95mm_HandSolder
C25, C26, C27: 82nF 5%; C_0603_1608Metric_Pad1.08x0.95mm_HandSolder
C31, C32: 330uF 100V; CP_Radial_D12.5mm_P5.00mm
C34, C35: 1nF; C_0603_1608Metric_Pad1.08x0.95mm_HandSolder
C41: 100 nF; C_0603_1608Metric_Pad1.08x0.95mm_HandSolder
C202: 220uF 100V; CP_Radial_D6.3mm_P2.50mm
D1: STPS1H100A; D_0603_1608Metric_Pad1.05x0.95mm_HandSolder
D2, D3, D4, D5, D6, D7: BAT48, 40 V; D_0603_1608Metric_Pad1.05x0.95mm_HandSolder
D8, D9, D10, D11, D12, D13, D206: BAT30K; D_0603_1608Metric_Pad1.05x0.95mm_HandSolder
D201, D203, D205: GREEN; D_0603_1608Metric_Pad1.05x0.95mm_HandSolder
D202: SMBJ48A-TR; D_0603_1608Metric_Pad1.05x0.95mm_HandSolder
D204: RED; D_0603_1608Metric_Pad1.05x0.95mm_HandSolder
J1: M20-7810645; Mouser Part Number 855-M20-7810645
J12: FTSH-107-01-L-DV-K-TR; SAMTEC_FTSH-107-01-L-DV-K-TR; PARTREV R
L1: 18uH, 1A; L_Wuerth_WE-PD2-Typ-MS
NT1, NT2, NT3, NT4, NT5: NetTie_2; NetTie-2_SMD_Pad0.5mm
Q1, Q2, Q3, Q4, Q5, Q6: IAUC120N06S5L; STL110N10F7
Q201, Q202: BSS138; SOT-23
R2: 22k; R_0603_1608Metric_Pad0.98x0.95mm_HandSolder
R3, R78, R79, R81, R82, R205, R206, R208: 10k; R_0603_1608Metric_Pad0.98x0.95mm_HandSolder
R13, R14, R15, R25, R26, R27: 33; R_0603_1608Metric_Pad0.98x0.95mm_HandSolder
R31, R32, R33, R34, R35, R36: 10m 1% 3W; R_2512_6332Metric_Pad1.40x3.35mm_HandSolder
R37: 72.3k 1%; R_0603_1608Metric_Pad0.98x0.95mm_HandSolder
R39: 3.01k 1%; R_0603_1608Metric_Pad0.98x0.95mm_HandSolder
R41, R42, R43, R47, R48, R49: 22k 1%; R_0603_1608Metric_Pad0.98x0.95mm_HandSolder
R44, R45, R46, R50, R51, R52: 1.5k 1%; R_0603_1608Metric_Pad0.98x0.95mm_HandSolder
R53, R54, R55: 11k 1%; R_0603_1608Metric_Pad0.98x0.95mm_HandSolder
R56, R58, R60: 68k 1%; R_0603_1608Metric_Pad0.98x0.95mm_HandSolder
R57, R59, R61: 27k 1%; R_0603_1608Metric_Pad0.98x0.95mm_HandSolder
R62, R63, R64: 3.9k 1%; R_0603_1608Metric_Pad0.98x0.95mm_HandSolder
R90: 100k; R_0603_1608Metric_Pad0.98x0.95mm_HandSolder
R92: 200; R_0603_1608Metric_Pad0.98x0.95mm_HandSolder
R201, R202, R211: 4.7k 0,5W 5%; R_0603_1608Metric_Pad0.98x0.95mm_HandSolder
R203: 1,5k; R_0603_1608Metric_Pad0.98x0.95mm_HandSolder
R204: 1k; R_0603_1608Metric_Pad0.98x0.95mm_HandSolder
R207, R210: 100; R_0603_1608Metric_Pad0.98x0.95mm_HandSolder
R209: 1,1k; R_0603_1608Metric_Pad0.98x0.95mm_HandSolder
SW3: SKHUALE010
TP1, TP2: 48V; 1-726388-2
TP3, TP4: GND; 1-726388-2
TP5, TP6: 12V; 61-2348-11_0030
TP7, TP8: CANL; KEYS_3544
TP9, TP10: CANH; 61-2348-11_0030
TP11, TP12, TP13: 1-726388-2; 61-2348-11_0030
TP14, TP15: 24V; KEYS_3578
TP16, TP17: GND; 61-2348-11_0030
TP18, TP19: SAFETY; KEYS_3544
TP20, TP21, TP22, TP23, TP24, TP25, TP26, TP27, TP28, TP29, TP30, TP31, TP32: TestPoint_Probe; TestPoint_Pad_D1.0mm
U1: STSPIN32G4
U2: TCAN332G; SO-8_3.9x4.9mm_P1.27mm
U6: MA730; MA730GQ-Z
X1: ECS-240-8-36B2-CKM-TR; ECX-2236B2

Connections:
/24V: TP14.1, TP15.1
/A: J1.3, R78.1, R81.1
/A_RC: C34.1, D12.2 (A), R81.2, U1.57 (PB6)
/B: J1.1, R79.1, R82.1
/BEARING_TEMP: J1.7, U1.17 (PA4)
/BOOT1: C16.2, U1.41 (BOOT1)
/BOOT2: C17.2, U1.38 (BOOT2)
/BOOT3: C18.2, U1.35 (BOOT3)
/B_RC: C35.1, D13.2 (A), R82.2, U1.58 (PB7)
/CAN_RX: U1.47 (PA11), U2.4 (RXD)
/CAN_TX: U1.48 (PA12), U2.1 (TXD)
/GHS1: D2.1 (K), R13.1, U1.43 (GHS1)
/GHS1_MOS: D2.2 (A), Q1.4, R13.2
/GHS2: D3.1 (K), R14.1, U1.40 (GHS2)
/GHS2_MOS: D3.2 (A), Q2.4, R14.2
/GHS3: D4.1 (K), R15.1, U1.37 (GHS3)
/GHS3_MOS: D4.2 (A), Q3.4, R15.2
/GLS1: D5.1 (K), R25.1, U1.29 (GLS1)
/GLS1_MOS: D5.2 (A), Q4.4, R25.2
/GLS2: D6.1 (K), R26.1, U1.30 (GLS2)
/GLS2_MOS: D6.2 (A), Q5.4, R26.2
/GLS3: D7.1 (K), R27.1, U1.31 (GLS3)
/GLS3_MOS: D7.2 (A), Q6.4, R27.2
/JTDI: J12.10, U1.51 (PA15)
/MA730_CS: U1.12 (PC3), U6.5 (~CS)
/MOTOR_TEMP: J1.5, U1.21 (PC4)
/OPN1: R50.2, R53.1, U1.16 (PA3)
/OPN2: R51.2, R54.1, U1.22 (PC5)
/OPN3: R52.2, R55.1, U1.25 (PB2)
/OPO1: R53.2, TP26.1, U1.15 (PA2)
/OPO2: R54.2, TP28.1, U1.19 (PA6)
/OPO3: R55.2, TP30.1, U1.24 (PB1)
/OPP1: R41.1, R44.2, R47.2, TP25.1, U1.14 (PA1)
/OPP2: R42.1, R45.2, R48.2, TP27.1, U1.20 (PA7)
/OPP3: R43.1, R46.2, R49.2, TP29.1, U1.23 (PB0)
/OSC_IN: C4.2, U1.6 (PF0), X1.1
/OSC_OUT: C5.2, U1.7 (PF1), X1.3
/OUT1: C16.1, Q1.1, Q1.2, Q1.3, Q4.5, Q4.6, Q4.7, Q4.8, R56.1, TP11.1, U1.42 (OUT1)
/OUT2: C17.1, Q2.1, Q2.2, Q2.3, Q5.5, Q5.6, Q5.7, Q5.8, R58.1, TP12.1, U1.39 (OUT2)
/OUT3: C18.1, Q3.1, Q3.2, Q3.3, Q6.5, Q6.6, Q6.7, Q6.8, R60.1, TP13.1, U1.36 (OUT3)
/SAFETY: D206.2 (A), TP18.1, TP19.1
/SEC_IN: R210.2, U1.4 (PC14)
/SEC_OUT: D204.2 (A), R204.1, U1.5 (PC15)
/SPI_MISO: U1.55 (PB4), U6.7 (MISO)
/SPI_MOSI: U1.56 (PB5), U6.4 (MOSI)
/SPI_SCK: U1.18 (PA5), U6.12 (SCLK)
/SW: D1.1 (K), L1.1, U1.62 (SW)
/SWCLK/JTCK: J12.06, J12.09, U1.50 (PA14)
/SWDIO/JTMS: J12.04, U1.49 (PA13)
/SWO/JTDO: J12.08, U1.54 (PB3)
/UART_RX: J12.13, U1.46 (PA10)
/UART_TX: J12.14, U1.45 (PA9)
/VBAT: C12.2, NT4.2, U1.2 (VBAT)
/VBUS: C19.2, D8.2 (A), R37.1, R39.2, TP31.1, U1.13 (PA0)
/VCC: C1.2, C202.1, D205.2 (A), L1.2, NT3.1, TP5.1, TP6.1, U1.63 (VCC)
/VDD: C6.2, C7.2, C41.1, C201.2, D12.1 (K), D13.1 (K), D203.2 (A), J1.2, NT2.1, NT4.1, R2.2, R78.2, R79.2, R90.2, R208.1, TP22.1, U1.1 (REG3V3/VDD), U2.3 (VCC), U6.13 (VDD)
/VDDA: C8.2, C9.2, D8.1 (K), D9.1 (K), D10.1 (K), D11.1 (K), NT2.2, NT5.1, U1.27 (VDDA)
/VOUT1: C25.1, D9.2 (A), R57.2, R62.2, U1.9 (PC0)
/VOUT2: C26.1, D10.2 (A), R59.2, R63.2, U1.10 (PC1)
/VOUT3: C27.1, D11.2 (A), R61.2, R64.2, U1.11 (PC2)
/VREF+: C10.2, C11.2, NT5.2, R41.2, R42.2, R43.2, U1.26 (VREF+)
/VREGIN: NT3.2, U1.64 (REGIN)
/VSHUNT1P: Q4.1, Q4.2, Q4.3, R31.1, R32.1, R44.1
/VSHUNT2P: Q5.1, Q5.2, Q5.3, R33.1, R34.1, R45.1
/VSHUNT3P: Q6.1, Q6.2, Q6.3, R35.1, R36.1, R46.1
/nRST: J12.12, R92.1, U1.8 (PG10)
GND: C1.1, C2.1, C4.1, C5.1, C6.1, C7.1, C8.1, C9.1, C10.1, C11.1, C12.1, C19.1, C25.2, C26.2, C27.2, C34.2, C35.2, C40.1, C41.2, C201.1, C202.2, D1.2 (A), J1.4, J12.05, J12.07, J12.11, NT1.1, Q201.2 (S), Q202.2 (S), R3.1, R39.1, R47.1, R48.1, R49.1, R62.1, R63.1, R64.1, R203.2, R205.2, R206.2, R211.1, SW3.1, SW3.2, TP16.1, TP17.1, U1.32 (PGND), U1.65 (VSS), U2.2 (GND), U6.8 (GND), U6.10 (TEST), U6.17 (PAD), X1.2, X1.4
GNDPWR: C13.1, C14.1, C15.1, C31.2, C32.2, D202.2 (A), NT1.2, R31.2, R32.2, R33.2, R34.2, R35.2, R36.2, R50.1, R51.1, R52.1, R202.1, TP3.1, TP4.1
unnamed: C2.2, U1.61 (VM)
unnamed: C40.2, R90.1, R92.2, SW3.3 (K), SW3.4 (A)
unnamed: D201.1 (K), R201.2
unnamed: D203.1 (K), R209.1
unnamed: D204.1 (K), R203.1
unnamed: D205.1 (K), R211.2
unnamed: D206.1 (K), Q202.3 (D), R207.1
unnamed: J1.6, TP20.1
unnamed: J1.8, TP21.1
unnamed: Q201.1 (G), R206.1, R207.2
unnamed: Q201.3 (D), R208.2, R209.2, R210.1
unnamed: Q202.1 (G), R204.2, R205.1
unnamed: R2.1, R3.2, TP32.1, U1.52 (SCREF)
unnamed: R56.2, R57.1
unnamed: R58.2, R59.1
unnamed: R60.2, R61.1
unnamed: R201.1, R202.2
unnamed: TP7.1, TP8.1, U2.6 (CANL)
unnamed: TP9.1, TP10.1, U2.7 (CANH)
unnamed: TP23.1, U6.16 (MGH)
unnamed: TP24.1, U6.11 (MGL)
VM: C13.2, C14.2, C15.2, C31.1, C32.1, D201.2 (A), D202.1 (K), Q1.5, Q1.6, Q1.7, Q1.8, Q2.5, Q2.6, Q2.7, Q2.8, Q3.5, Q3.6, Q3.7, Q3.8, R37.2, TP1.1, TP2.1

Notes on the sheet:
VM - 48V VCC - Gate driving supply voltage - 12V VREGIN - 3.3 V LDO linear regulator input - 12V VDD - 3,3V VBAT VDDA VREF+ - 3,3V do dzielnika napiecia GND
CONNECTORS
WBUDOWANY OPAMP
A,B DODAĆ RC FILTER 1k 10pF
MOŻNA ZWOLNIĆ

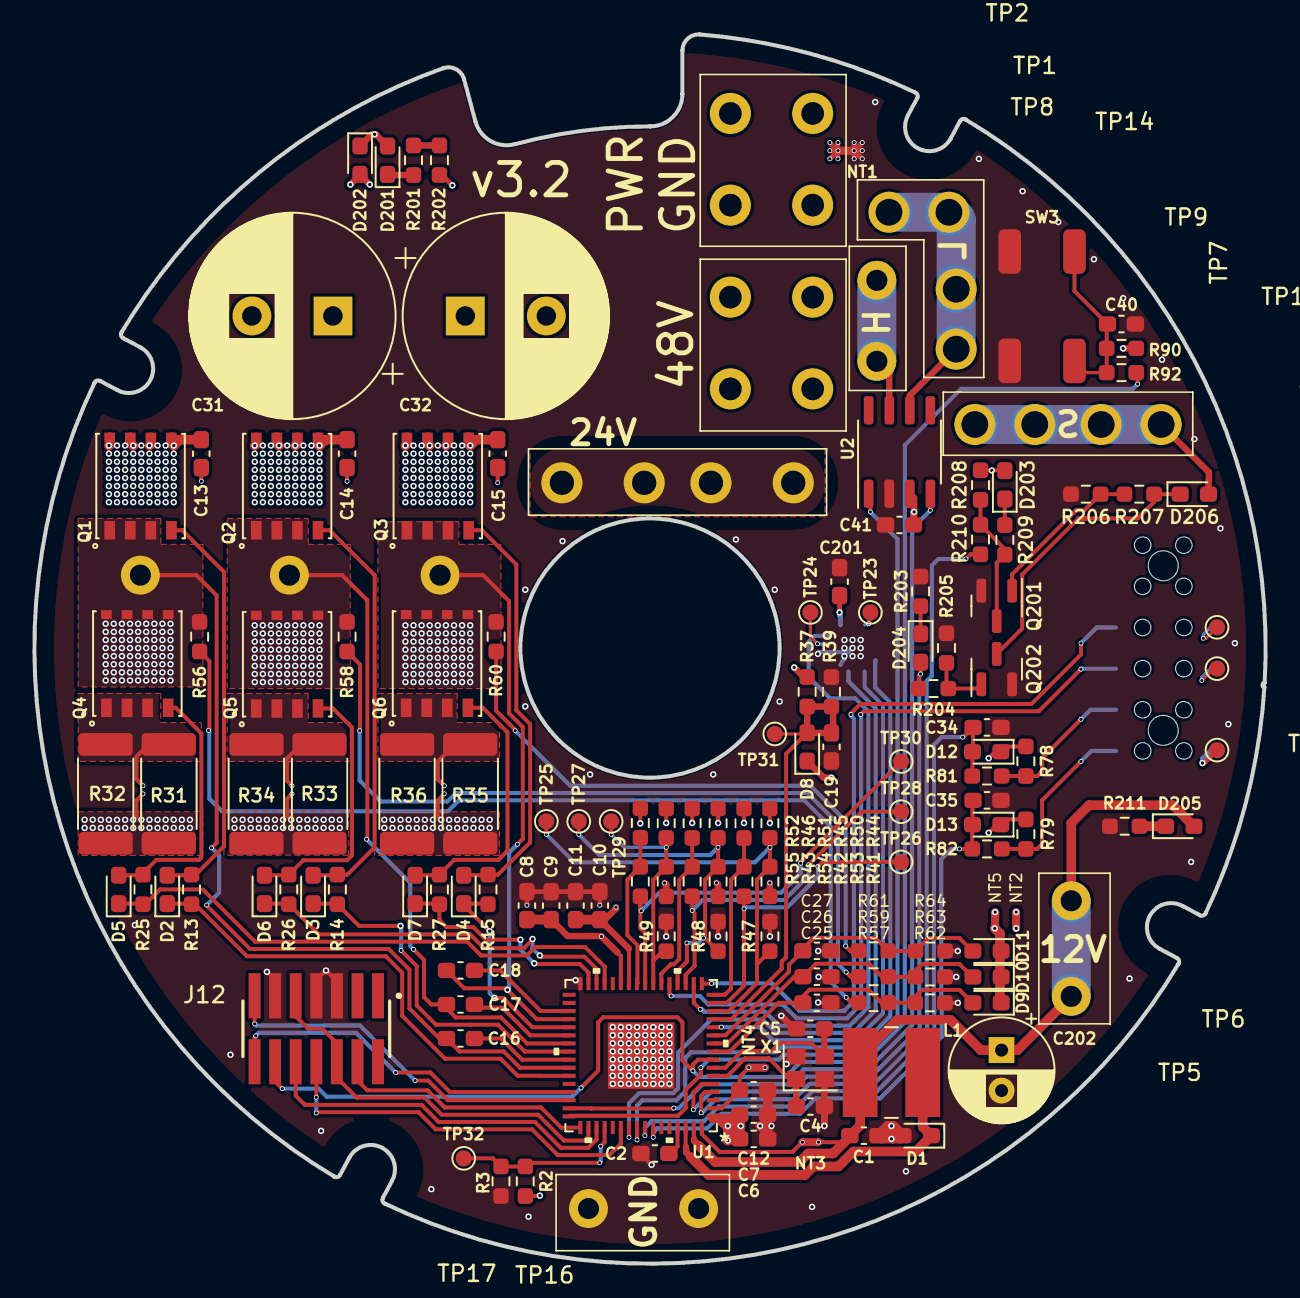
[picture p112: board UNIVERSAL_JOINT_v3_2.kicad_pcb from above]

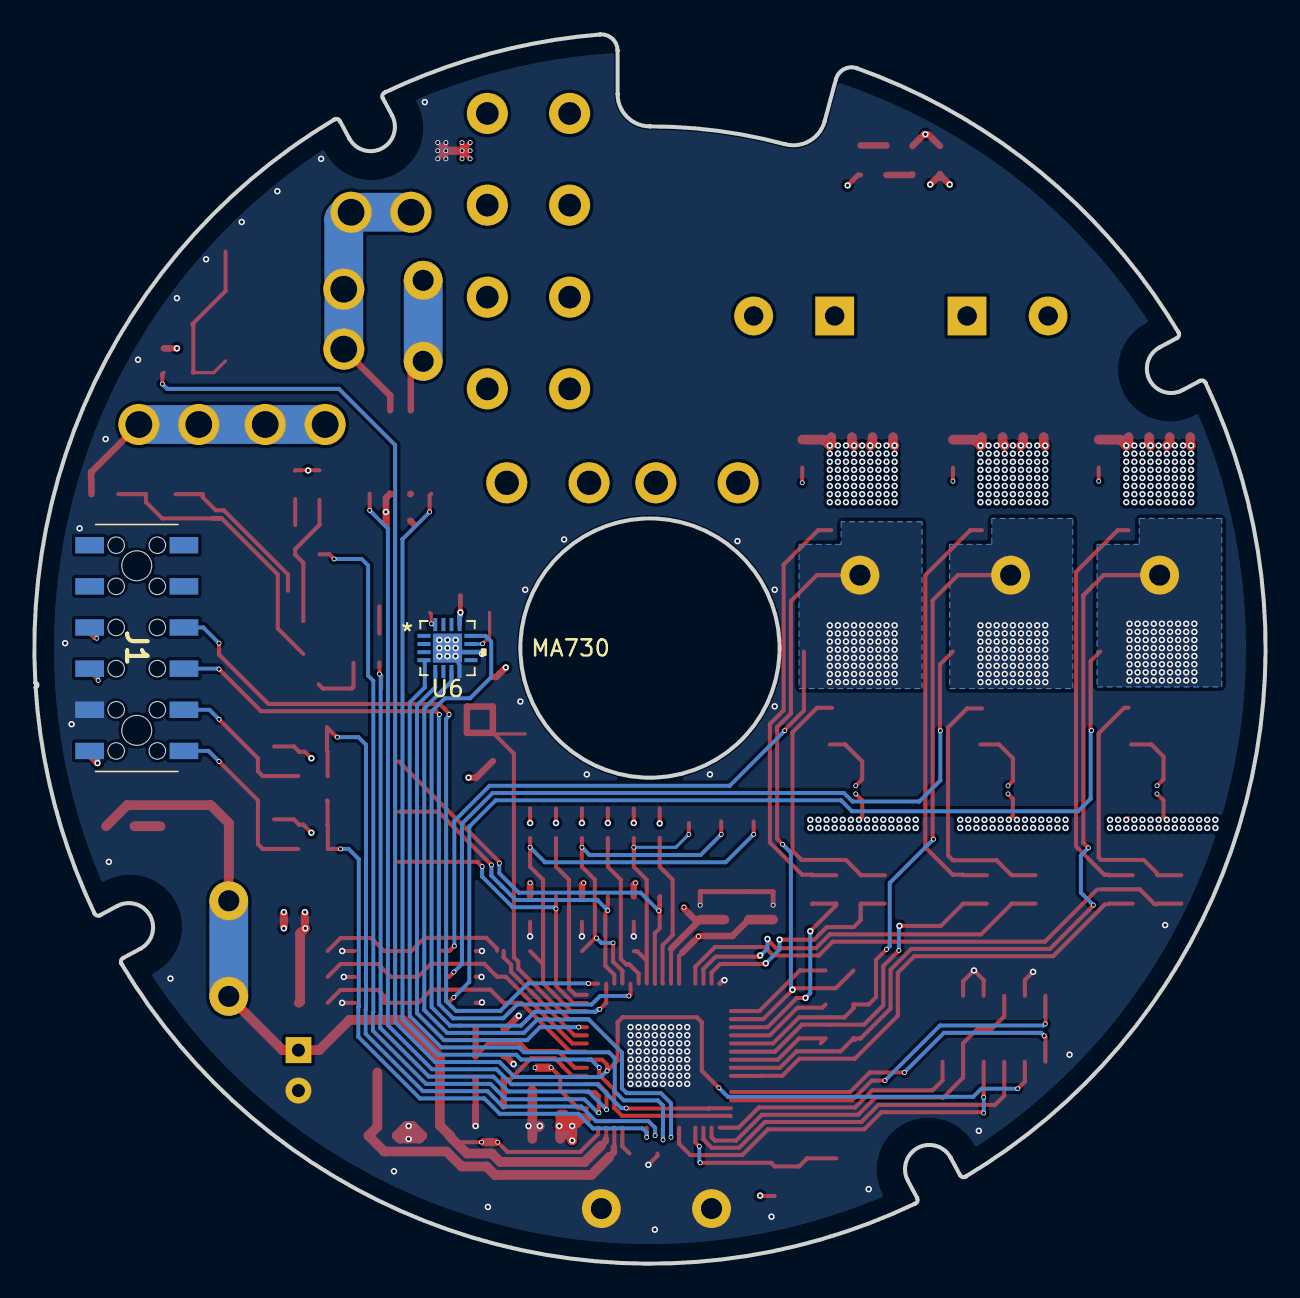
[picture p113: board UNIVERSAL_JOINT_v3_2.kicad_pcb from below]

Board: 4 copper layers, 76.0 x 75.9 mm, 158 parts (2 on the bottom side), 90 nets.
