avena-robotics/pcbs/UNIVERSAL_HALL_PCB_RI80_v3.0/universal_hall_pcb_RI80_v3.0.kicad_pcb

## KiCad design UNIVERSAL_HALL_PCB_RI80_v3.0/universal_hall_pcb_RI80_v3.0.kicad_pcb (2022-02-07)

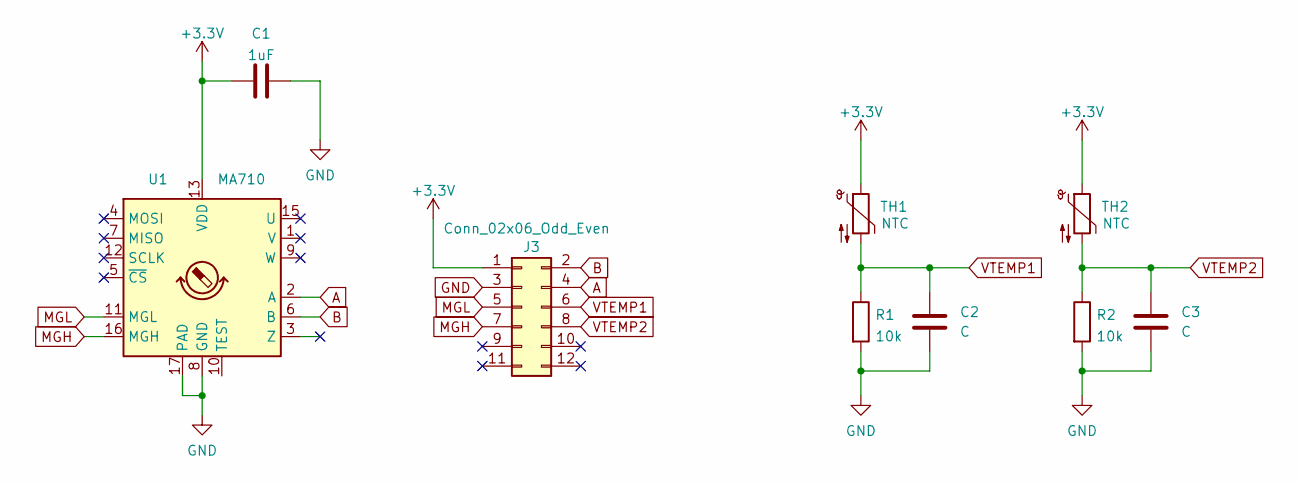
[picture p114: schematic universal_hall_pcb_RI80_v3.0.kicad_sch]

Parts:
C1: 1uF; C_0603_1608Metric_Pad1.08x0.95mm_HandSolder
C2, C3: C; C_0603_1608Metric_Pad1.08x0.95mm_HandSolder
J3: Conn_02x06_Odd_Even; PinHeader_2x06_P2.54mm_Vertical
R1, R2: 10k; R_0603_1608Metric_Pad0.98x0.95mm_HandSolder
TH1, TH2: NTC; PinHeader_1x02_P2.54mm_Vertical
U1: MA710; VQFN-16-1EP_3x3mm_P0.5mm_EP1.8x1.8mm

Connections:
+3V3: C1.1, J3.1, TH1.1, TH2.1, U1.13 (VDD)
A: J3.4, U1.2 (A)
B: J3.2, U1.6 (B)
GND: C1.2, C2.2, C3.2, J3.3, R1.2, R2.2, U1.8 (GND), U1.17 (PAD)
MGH: J3.7, U1.16 (MGH)
MGL: J3.5, U1.11 (MGL)
VTEMP1: C2.1, J3.6, R1.1, TH1.2
VTEMP2: C3.1, J3.8, R2.1, TH2.2
