avena-robotics/pcbs/UNIVERSAL_HALL_PCB_RI80_v3.0/universal_hall_pcb_RI80_v3.0.kicad_pcb

## KiCad design UNIVERSAL_HALL_PCB_RI80_v3.0/universal_hall_pcb_RI80_v3.0.kicad_pcb (continued)

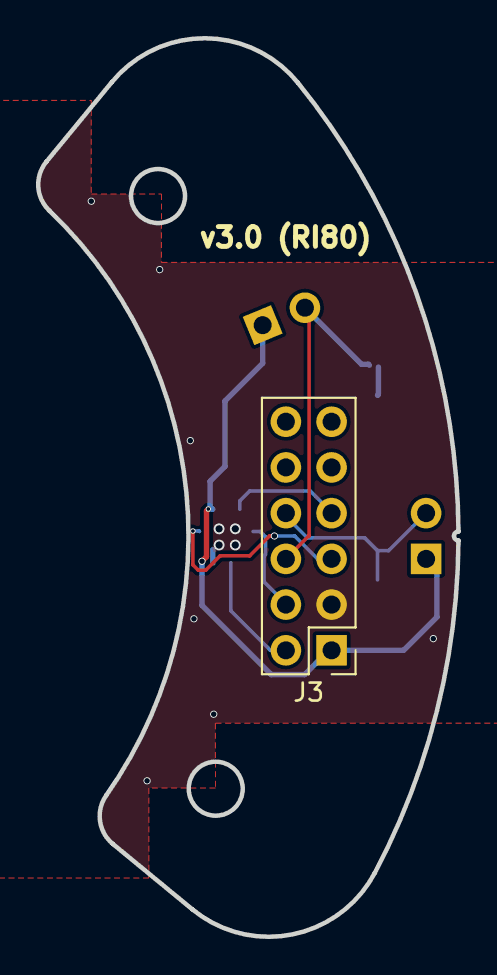
[picture p115: board universal_hall_pcb_RI80_v3.0.kicad_pcb from above]

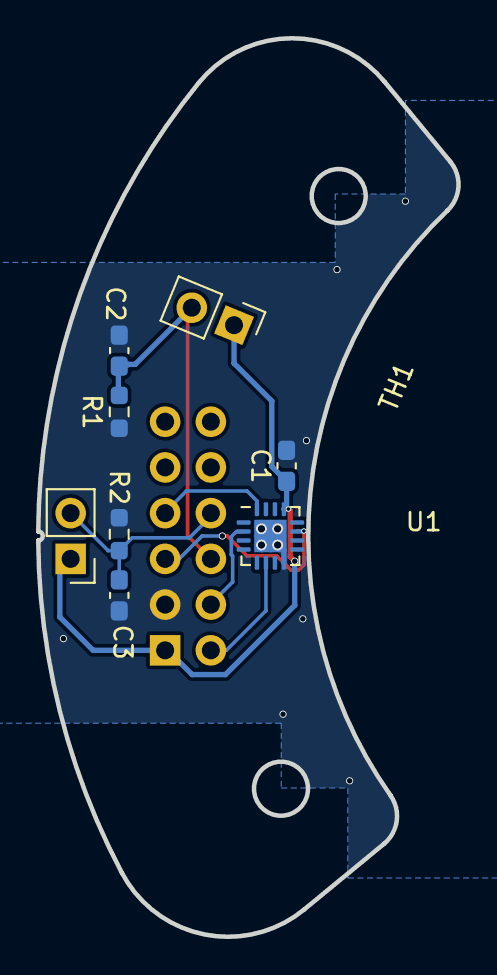
[picture p116: board universal_hall_pcb_RI80_v3.0.kicad_pcb from below]

Board: 2 copper layers, 23.3 x 49.9 mm, 9 parts (8 on the bottom side), 8 nets.
