avena-robotics/pcbs/UNIVERSAL_HALL_PCB_RI70_v3.0/universal_hall_pcb_RI70_v3.0.kicad_pcb

## KiCad design UNIVERSAL_HALL_PCB_RI70_v3.0/universal_hall_pcb_RI70_v3.0.kicad_pcb (2022-02-07)

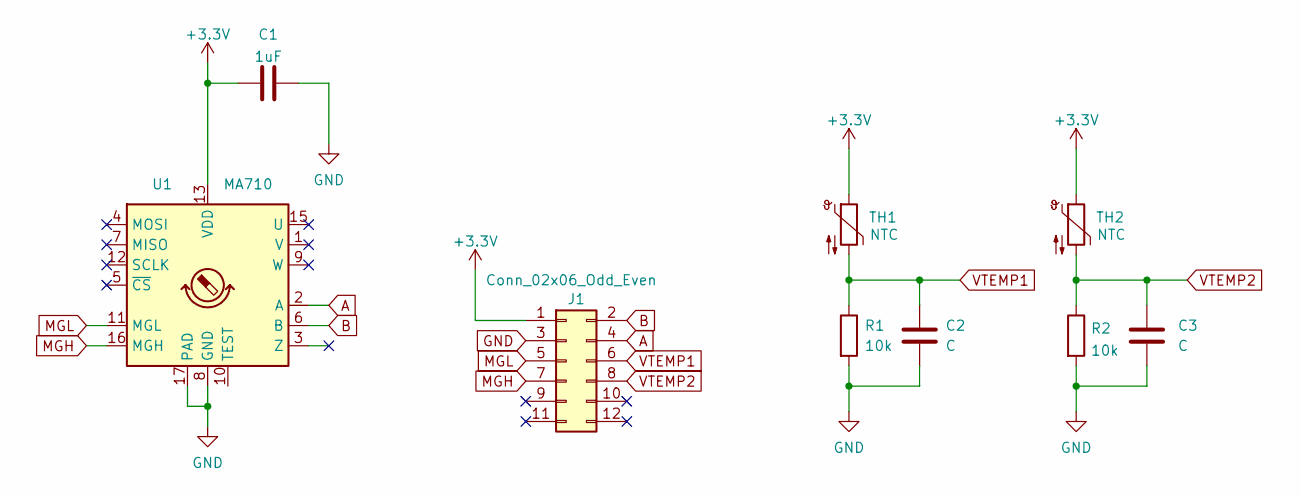
[picture p117: schematic universal_hall_pcb_RI70_v3.0.kicad_sch]

Parts:
C1: 1uF; C_0603_1608Metric_Pad1.08x0.95mm_HandSolder
C2, C3: C; C_0603_1608Metric_Pad1.08x0.95mm_HandSolder
J1: Conn_02x06_Odd_Even; PinHeader_2x06_P2.54mm_Vertical
R1, R2: 10k; R_0603_1608Metric_Pad0.98x0.95mm_HandSolder
TH1, TH2: NTC; PinHeader_1x02_P2.54mm_Vertical
U1: MA710; VQFN-16-1EP_3x3mm_P0.5mm_EP1.8x1.8mm

Connections:
+3V3: C1.1, J1.1, TH1.1, TH2.1, U1.13 (VDD)
A: J1.4, U1.2 (A)
B: J1.2, U1.6 (B)
GND: C1.2, C2.2, C3.2, J1.3, R1.2, R2.2, U1.8 (GND), U1.17 (PAD)
MGH: J1.7, U1.16 (MGH)
MGL: J1.5, U1.11 (MGL)
VTEMP1: C2.1, J1.6, R1.1, TH1.2
VTEMP2: C3.1, J1.8, R2.1, TH2.2

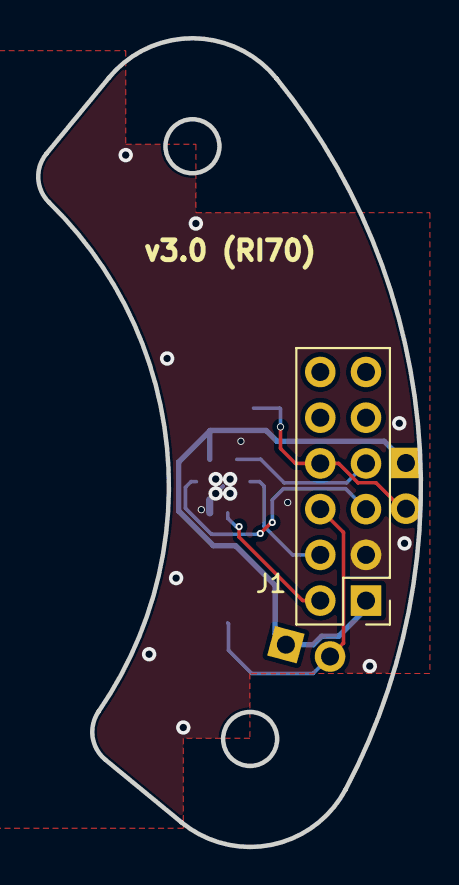
[picture p118: board universal_hall_pcb_RI70_v3.0.kicad_pcb from above]

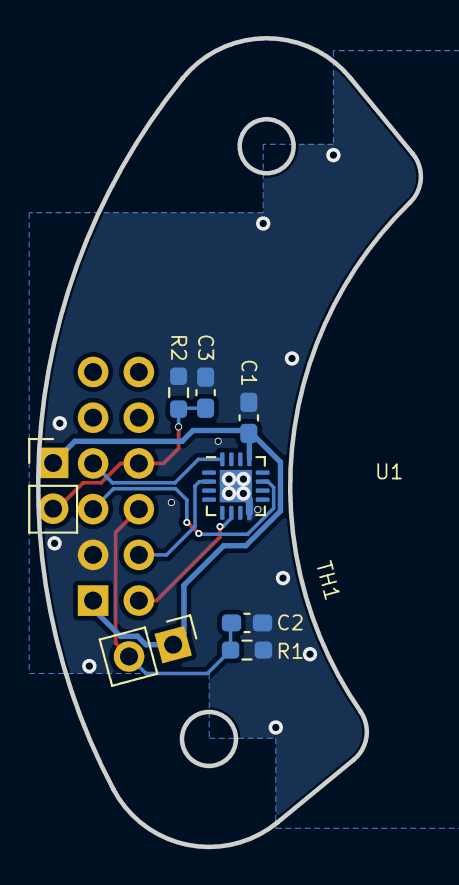
[picture p119: board universal_hall_pcb_RI70_v3.0.kicad_pcb from below]

Board: 2 copper layers, 21.3 x 44.9 mm, 9 parts (8 on the bottom side), 8 nets.
