avena-robotics/pcbs/ARM_RPI4_HAT_1.0/ARM_RPI4_HAT_1.0.kicad_pcb

## KiCad design ARM_RPI4_HAT_1.0/ARM_RPI4_HAT_1.0.kicad_pcb (2022-01-12)

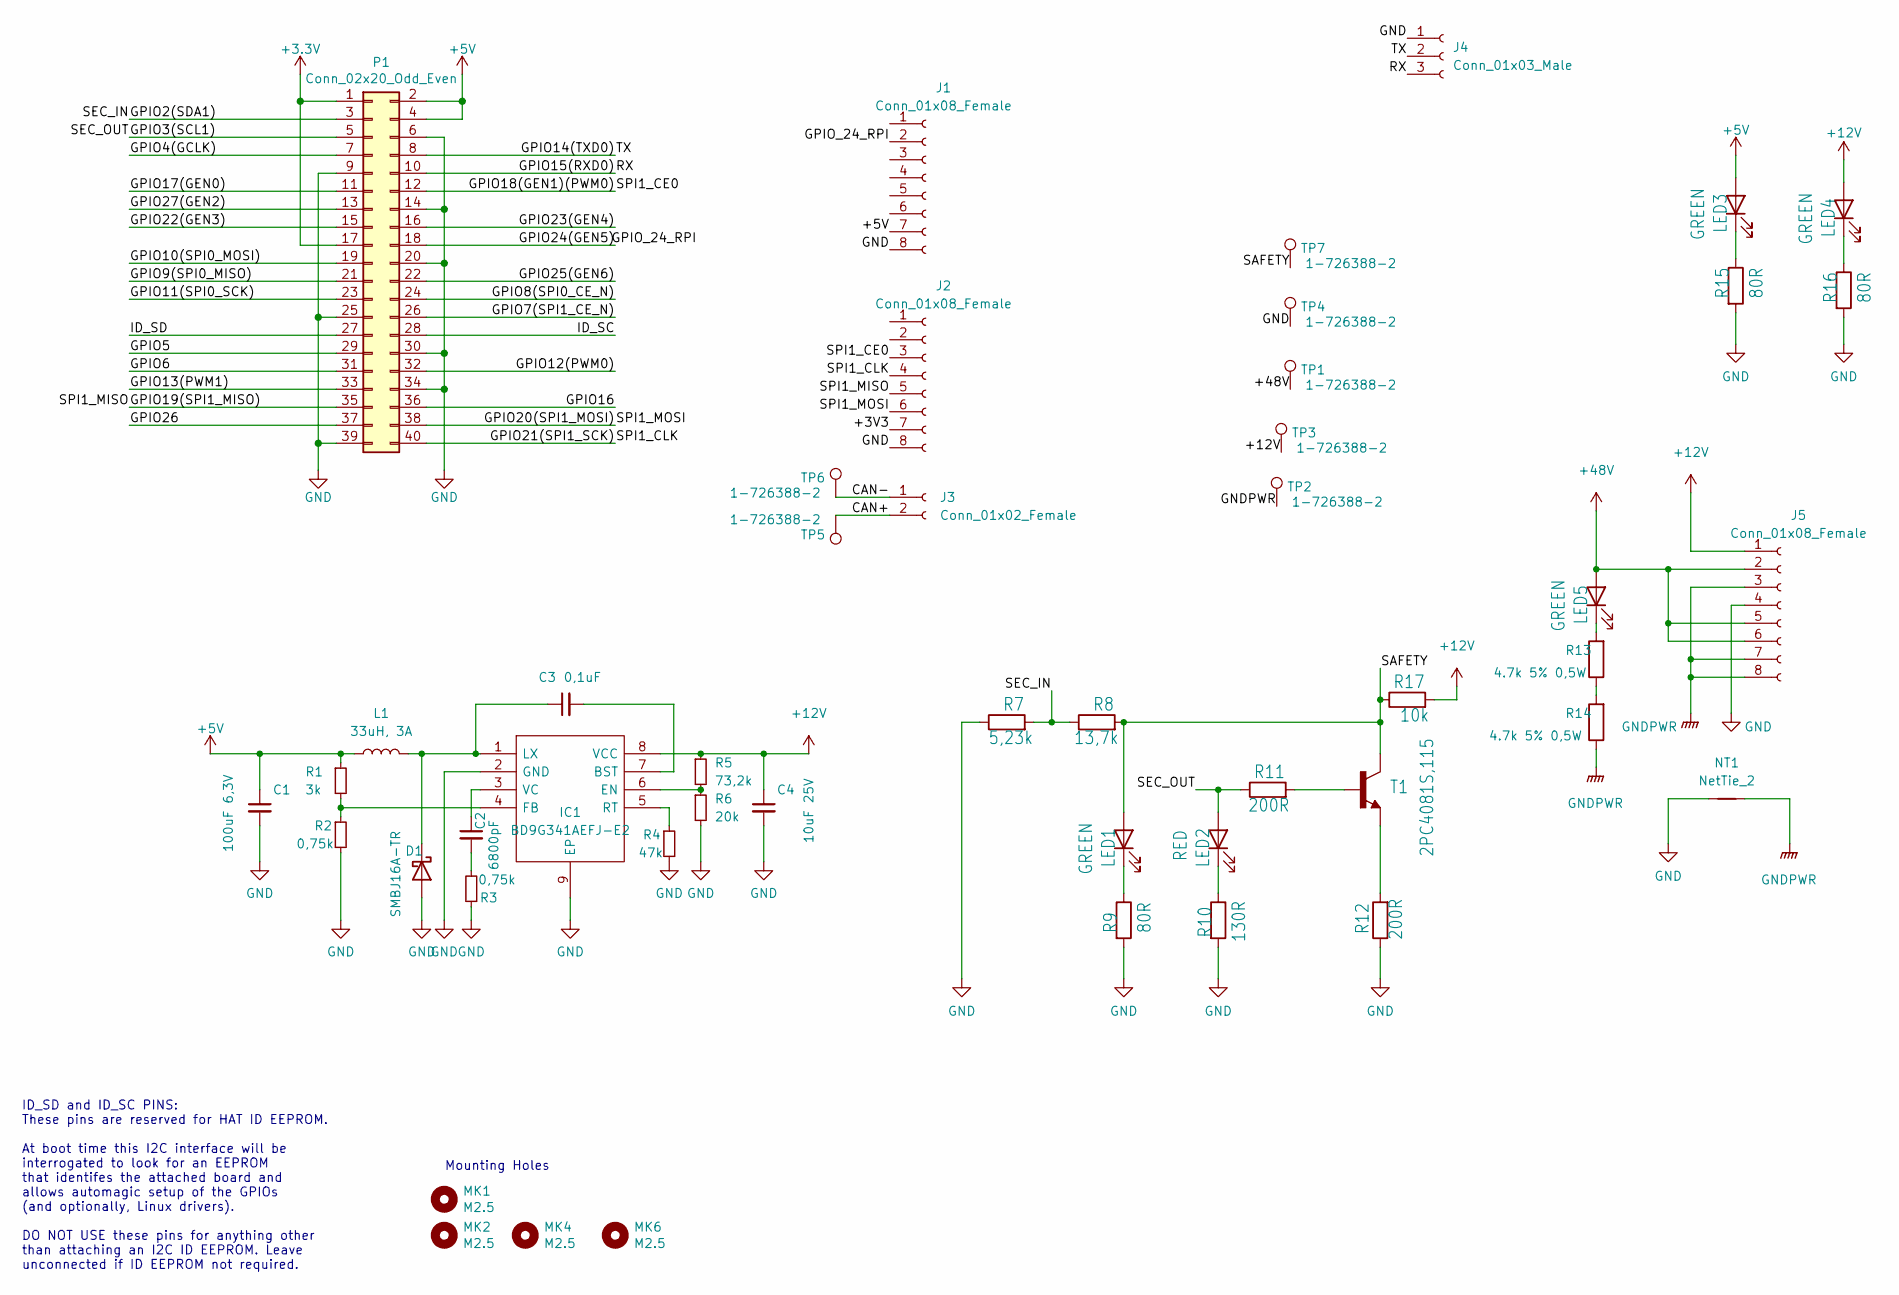
[picture p120: schematic ARM_RPI4_HAT_1.0.kicad_sch]

Parts:
C1: 100uF 6,3V; C_1206_3216Metric_Pad1.33x1.80mm_HandSolder
C2: 6800pF; C_0603_1608Metric_Pad1.08x0.95mm_HandSolder
C3: 0,1uF; C_0603_1608Metric_Pad1.08x0.95mm_HandSolder
C4: 10uF 25V; C_0603_1608Metric_Pad1.08x0.95mm_HandSolder
D1: SMBJ16A-TR; D_SMB_Handsoldering
IC1: BD9G341AEFJ-E2; SOIC127P600X100-9N; Mouser Part Number 755-BD9G341AEFJ-E2
J1, J2: Conn_01x08_Female; PinSocket_1x08_P2.54mm_Vertical
J3: Conn_01x02_Female; PinHeader_1x02_P2.54mm_Vertical
J4: Conn_01x03_Male; PinHeader_1x03_P2.54mm_Horizontal
J5: Conn_01x08_Female; 105314-2208
L1: 33uH, 3A; MPEV1D1040L330
LED1, LED3, LED4, LED5: GREEN; D_0603_1608Metric_Pad1.05x0.95mm_HandSolder
LED2: RED; D_0603_1608Metric_Pad1.05x0.95mm_HandSolder
MK1, MK2, MK4, MK6: M2.5; MountingHole_2.7mm_M2.5
NT1: NetTie_2; NetTie-2_SMD_Pad0.5mm
P1: Conn_02x20_Odd_Even; PinSocket_2x20_P2.54mm_Vertical
R1: 3k; R_0603_1608Metric_Pad0.98x0.95mm_HandSolder
R2, R3: 0,75k; R_0603_1608Metric_Pad0.98x0.95mm_HandSolder
R4: 47k; R_0603_1608Metric_Pad0.98x0.95mm_HandSolder
R5: 73,2k; R_0603_1608Metric_Pad0.98x0.95mm_HandSolder
R6: 20k; R_0603_1608Metric_Pad0.98x0.95mm_HandSolder
R7: 5,23k; R_0603_1608Metric_Pad0.98x0.95mm_HandSolder
R8: 13,7k; R_0603_1608Metric_Pad0.98x0.95mm_HandSolder
R9, R15, R16: 80R; R_0603_1608Metric_Pad0.98x0.95mm_HandSolder
R10: 130R; R_0603_1608Metric_Pad0.98x0.95mm_HandSolder
R11, R12: 200R; R_0603_1608Metric_Pad0.98x0.95mm_HandSolder
R13, R14: 4.7k 5% 0,5W; R_0805_2012Metric_Pad1.20x1.40mm_HandSolder
R17: 10k; R_0603_1608Metric_Pad0.98x0.95mm_HandSolder
T1: 2PC4081S,115; SOT23-EBC
TP1, TP2: 1-726388-2; 61-1537-11-0031
TP3, TP4, TP5, TP6, TP7: 1-726388-2; 61-1407-21-0031

Connections:
+5V: C1.1, J1.7, L1.1, LED3.2 (A), P1.2, P1.4, R1.1
+12V: C4.1, IC1.8 (VCC), J5.1, LED4.2 (A), R5.1, R17.2, TP3.1
+48V: J5.2, J5.5, J5.6, LED5.2 (A), TP1.1
/CAN+: J3.2, TP5.1
/CAN-: J3.1, TP6.1
/GPIO2(SDA1): P1.3, R7.2, R8.1
/GPIO3(SCL1): LED2.2 (A), P1.5, R11.1
/GPIO4(GCLK): P1.7
/GPIO5: P1.29
/GPIO6: P1.31
/GPIO7(SPI1_CE_N): P1.26
/GPIO8(SPI0_CE_N): P1.24
/GPIO9(SPI0_MISO): P1.21
/GPIO10(SPI0_MOSI): P1.19
/GPIO11(SPI0_SCK): P1.23
/GPIO12(PWM0): P1.32
/GPIO13(PWM1): P1.33
/GPIO14(TXD0): J4.2, P1.8
/GPIO15(RXD0): J4.3, P1.10
/GPIO16: P1.36
/GPIO17(GEN0): P1.11
/GPIO18(GEN1)(PWM0): J2.3, P1.12
/GPIO19(SPI1_MISO): J2.5, P1.35
/GPIO20(SPI1_MOSI): J2.6, P1.38
/GPIO21(SPI1_SCK): J2.4, P1.40
/GPIO22(GEN3): P1.15
/GPIO23(GEN4): P1.16
/GPIO24(GEN5): J1.2, P1.18
/GPIO25(GEN6): P1.22
/GPIO26: P1.37
/GPIO27(GEN2): P1.13
/ID_SC: P1.28
/ID_SD: P1.27
/SAFETY: LED1.2 (A), R8.2, R17.1, T1.C, TP7.1
GND: C1.2, C4.2, D1.2 (A), IC1.2 (GND), IC1.9 (EP), J1.8, J2.8, J4.1, J5.4, NT1.1, P1.6, P1.9, P1.14, P1.20, P1.25, P1.30, P1.34, P1.39, R2.2, R3.1, R4.2, R6.2, R7.1, R9.2, R10.2, R12.1, R15.2, R16.2, TP4.1
GNDPWR: J5.3, J5.7, J5.8, NT1.2, R14.1, TP2.1
unnamed: C2.1, IC1.3 (VC)
unnamed: C2.2, R3.2
unnamed: C3.1, D1.1 (K), IC1.1 (LX), L1.2
unnamed: C3.2, IC1.7 (BST)
unnamed: IC1.4 (FB), R1.2, R2.1
unnamed: IC1.5 (RT), R4.1
unnamed: IC1.6 (EN), R5.2, R6.1
unnamed: LED1.1 (K), R9.1
unnamed: LED2.1 (K), R10.1
unnamed: LED3.1 (K), R15.1
unnamed: LED4.1 (K), R16.1
unnamed: LED5.1 (K), R13.2
unnamed: R11.2, T1.B
unnamed: R12.2, T1.E
unnamed: R13.1, R14.2

Notes on the sheet:
ID_SD and ID_SC PINS: These pins are reserved for HAT ID EEPROM. At boot time this I2C interface will be interrogated to look for an EEPROM that identifes the attached board and allows automagic setup of the GPIOs (and optionally, Linux drivers). DO NOT USE these pins for anything other than attach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
Mounting Holes

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
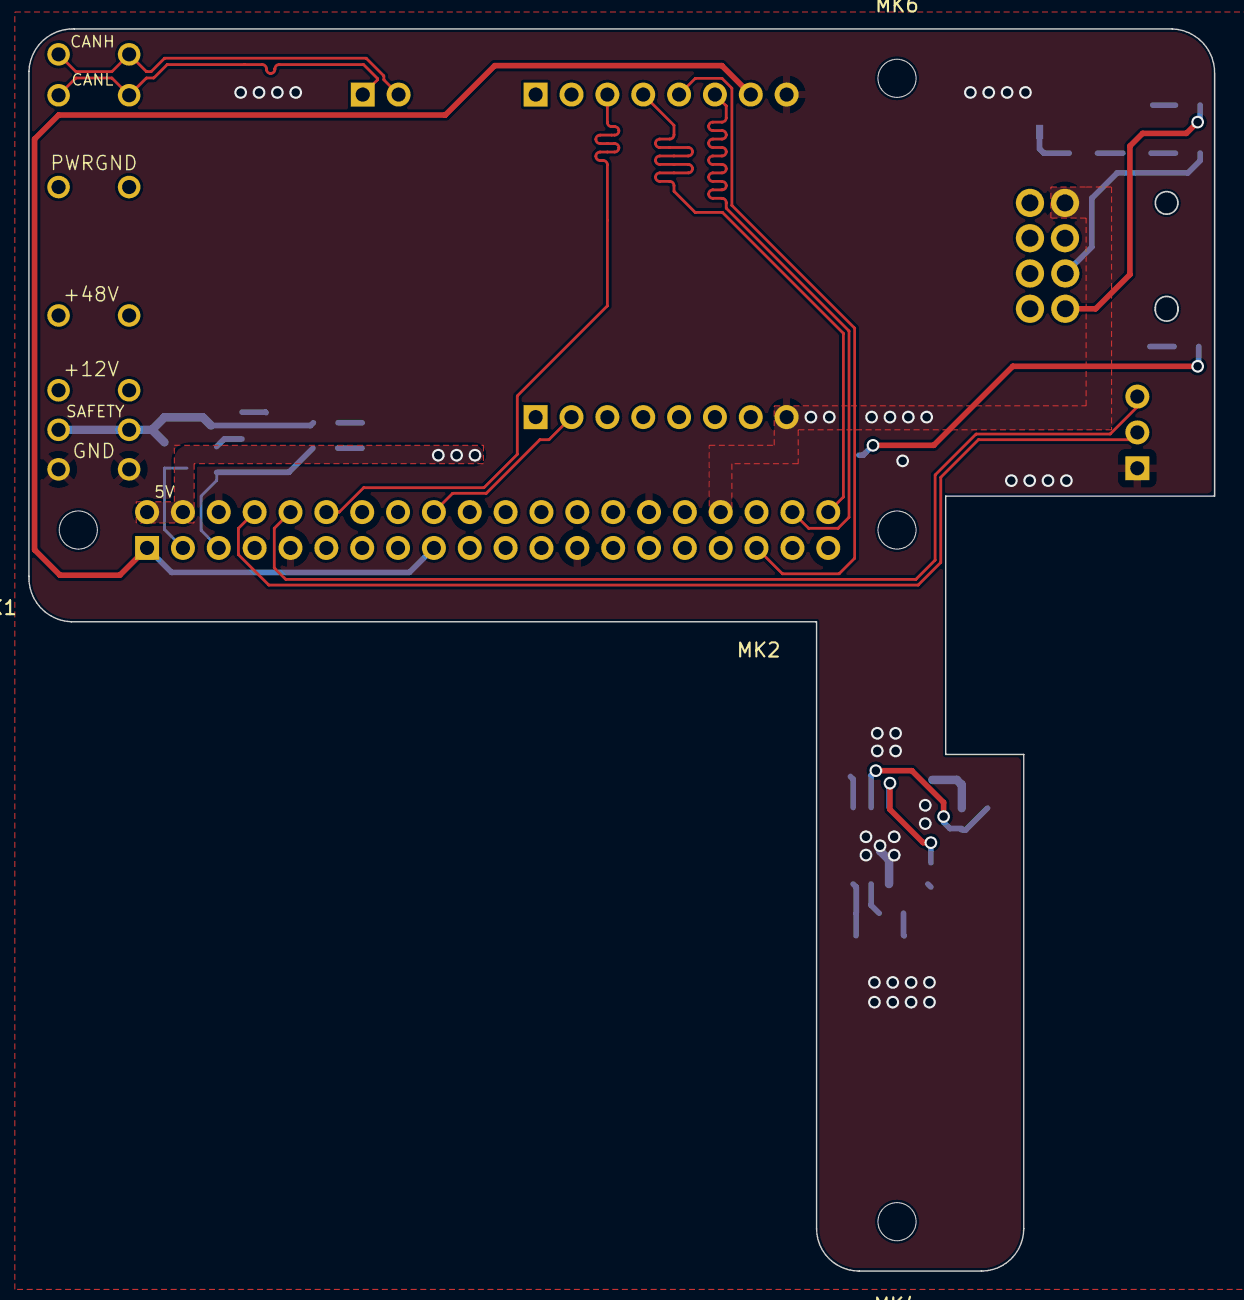
[picture p121: board ARM_RPI4_HAT_1.0.kicad_pcb from above]

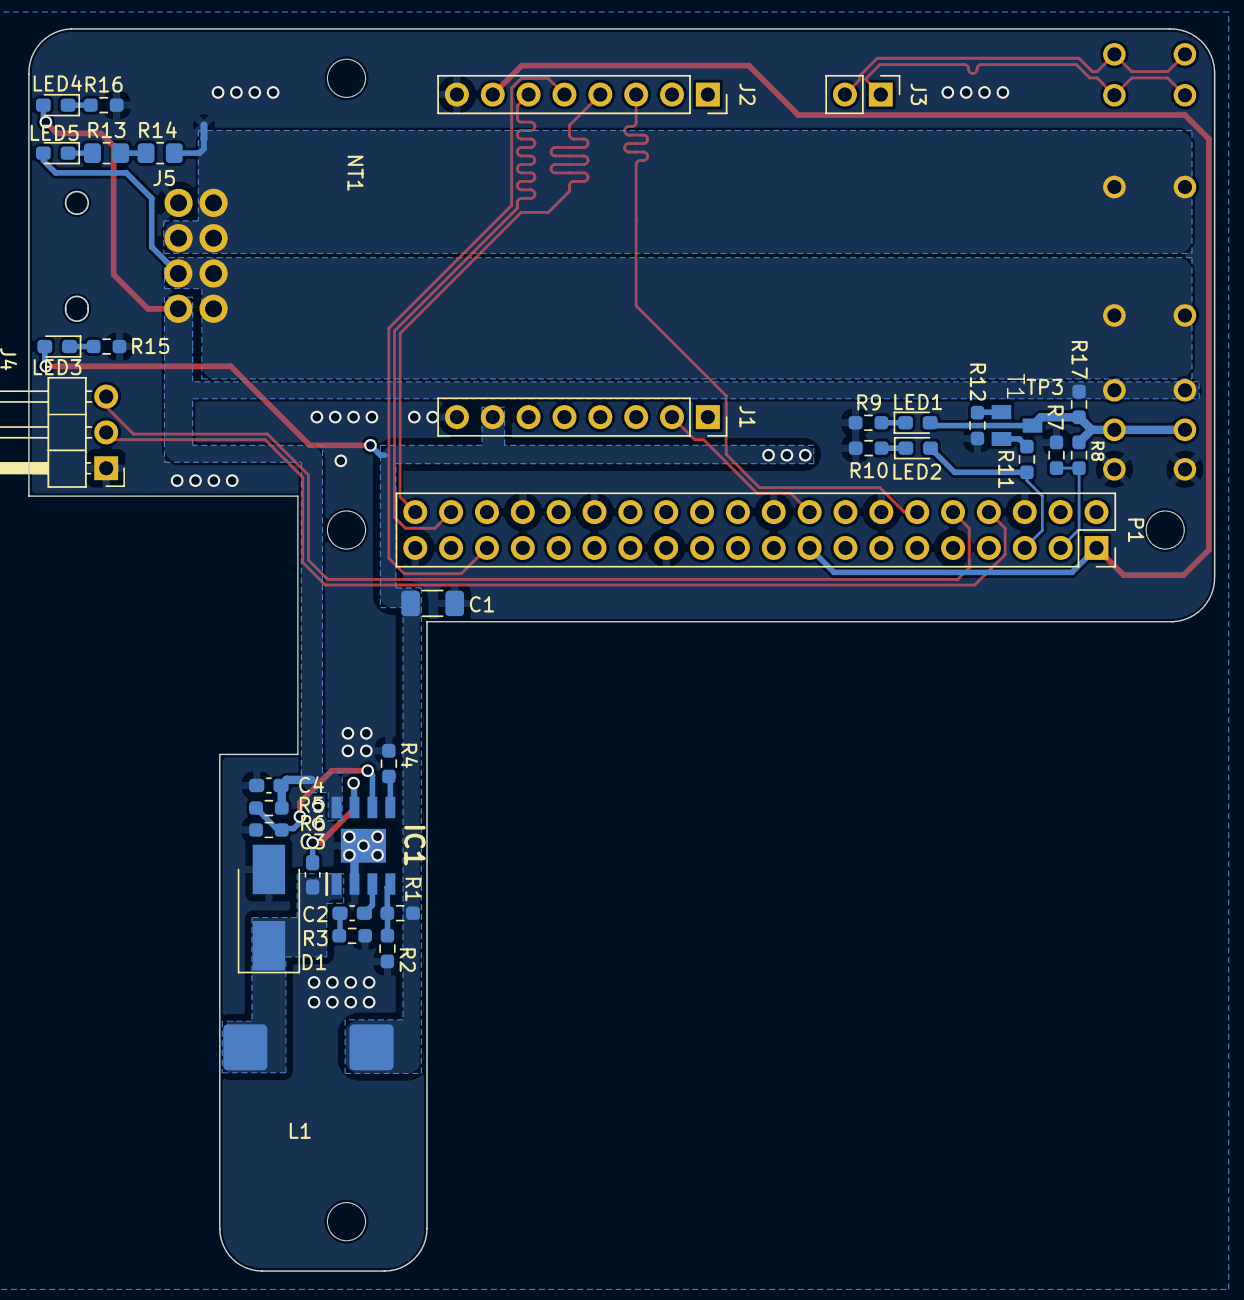
[picture p122: board ARM_RPI4_HAT_1.0.kicad_pcb from below]

Board: 2 copper layers, 84.0 x 88.0 mm, 48 parts (44 on the bottom side), 33 nets.
