avena-robotics/pcbs/TACTILE_28UFQFPN_SPI_v2.2/TACTILE_28UFQFPN_SPI_v2.2.kicad_pcb

## KiCad design TACTILE_28UFQFPN_SPI_v2.2/TACTILE_28UFQFPN_SPI_v2.2.kicad_pcb (2022-01-12)

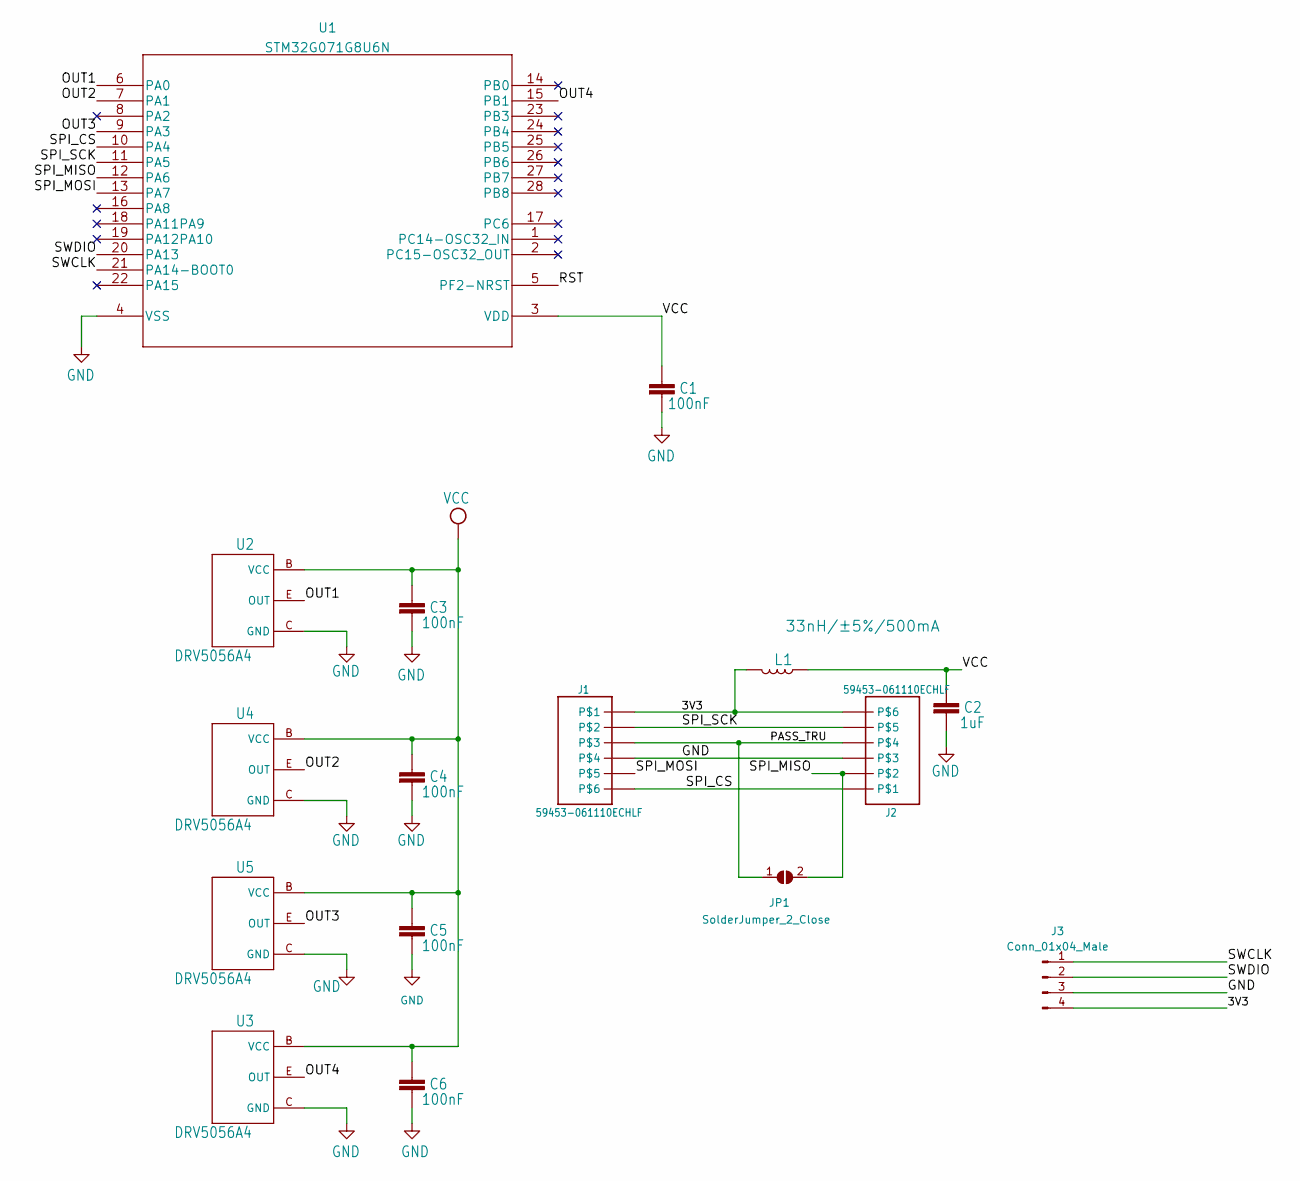
[picture p123: schematic TACTILE_28UFQFPN_SPI_v2.2.kicad_sch]

Parts:
C1, C3, C4, C5, C6: 100nF; C_0603_1608Metric_Pad1.08x0.95mm_HandSolder
C2: 1uF; C_0603_1608Metric_Pad1.08x0.95mm_HandSolder
J1, J2: 59453-061110ECHLF
J3: Conn_01x04_Male; PinHeader_1x04_P2.54mm_Vertical
JP1: SolderJumper_2_Close; SolderJumper-2_P1.3mm_Bridged_Pad1.0x1.5mm
L1: 33nH/±5%/500mA; L_0603_1608Metric_Pad1.05x0.95mm_HandSolder
U1: STM32G071G8U6N
U2, U3, U4, U5: DRV5056A4; SOT23-BEC

Connections:
/3V3: J1.P$1, J2.P$6, J3.4, L1.2
/OUT1: U1.6 (PA0), U2.E (OUT)
/OUT2: U1.7 (PA1), U4.E (OUT)
/OUT3: U1.9 (PA3), U5.E (OUT)
/OUT4: U1.15 (PB1), U3.E (OUT)
/PASS_TRU: J1.P$3, J2.P$4, JP1.1 (A)
/RST: U1.5 (PF2-NRST)
/SPI_CS: J1.P$6, J2.P$1, U1.10 (PA4)
/SPI_MISO: J2.P$2, JP1.2 (B), U1.12 (PA6)
/SPI_MOSI: J1.P$5, U1.13 (PA7)
/SPI_SCK: J1.P$2, J2.P$5, U1.11 (PA5)
/SWCLK: J3.1, U1.21 (PA14-BOOT0)
/SWDIO: J3.2, U1.20 (PA13)
GND: C1.2, C2.2, C3.2, C4.2, C5.2, C6.2, J1.P$4, J2.P$3, J3.3, U1.4 (VSS), U2.C (GND), U3.C (GND), U4.C (GND), U5.C (GND)
VCC: C1.1, C2.1, C3.1, C4.1, C5.1, C6.1, L1.1, U1.3 (VDD), U2.B (VCC), U3.B (VCC), U4.B (VCC), U5.B (VCC)

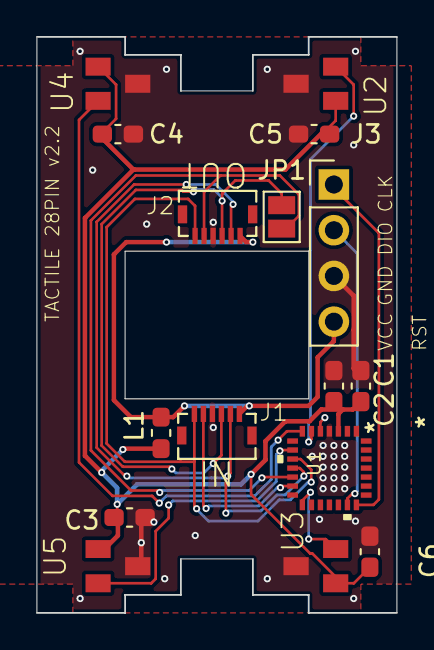
[picture p124: board TACTILE_28UFQFPN_SPI_v2.2.kicad_pcb from above]

Board: 2 copper layers, 20.0 x 32.0 mm, 16 parts (0 on the bottom side), 14 nets.
