avena-robotics/pcbs/IR_LED_PROJECTOR_v0.3/ir_led_projector_v0.3.kicad_pcb

## KiCad design IR_LED_PROJECTOR_v0.3/ir_led_projector_v0.3.kicad_pcb (2022-01-12)

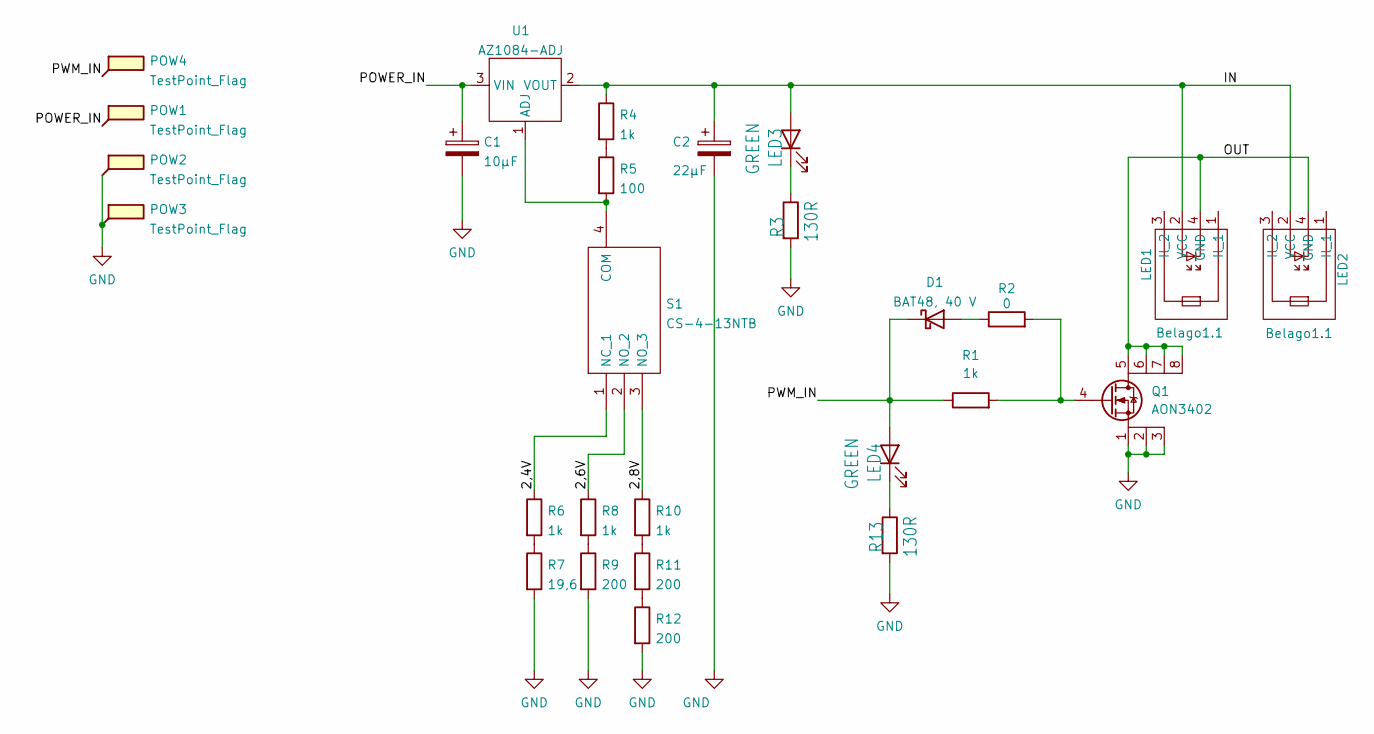
[picture p125: schematic ir_led_projector_v0.3.kicad_sch]

Parts:
C1: 10µF; CP_Elec_3x5.4
C2: 22µF; CP_Elec_3x5.4
D1: BAT48, 40 V; D_0603_1608Metric_Pad1.05x0.95mm_HandSolder
LED1, LED2: Belago1.1
LED3, LED4: GREEN; D_0603_1608Metric_Pad1.05x0.95mm_HandSolder
POW1, POW2, POW3, POW4: TestPoint_Flag; TestPoint_Pad_4.0x4.0mm
Q1: AON3402; DFN3x3A_8L_NEP_P
R1, R4, R6, R8, R10: 1k; R_0603_1608Metric_Pad0.98x0.95mm_HandSolder
R2: 0; R_0603_1608Metric_Pad0.98x0.95mm_HandSolder
R3, R13: 130R; R_0603_1608Metric_Pad0.98x0.95mm_HandSolder
R5: 100; R_0603_1608Metric_Pad0.98x0.95mm_HandSolder
R7: 19,6; R_0603_1608Metric_Pad0.98x0.95mm_HandSolder
R9, R11, R12: 200; R_0603_1608Metric_Pad0.98x0.95mm_HandSolder
S1: CS-4-13NTB; CS413NTB; Manufacturer_Part_Number CS-4-13NTB
U1: AZ1084-ADJ; TO-252-3_TabPin2

Connections:
/2,4V: R6.1, S1.1 (NC_1)
/2,6V: R8.1, S1.2 (NO_2)
/2,8V: R10.1, S1.3 (NO_3)
/IN: C2.1, LED1.2 (VCC), LED2.2 (VCC), LED3.2 (A), R4.1, U1.2 (VOUT)
/OUT: LED1.4 (GND), LED2.4 (GND), Q1.5 (D), Q1.6 (D), Q1.7 (D), Q1.8 (D)
/POWER_IN: C1.1, POW1.1, U1.3 (VIN)
/PWM_IN: D1.1 (K), LED4.2 (A), POW4.1, R1.1
GND: C1.2, C2.2, POW2.1, POW3.1, Q1.1 (S), Q1.2 (S), Q1.3 (S), R3.2, R7.2, R9.2, R12.2, R13.2
unnamed: D1.2 (A), R2.1
unnamed: LED3.1 (K), R3.1
unnamed: LED4.1 (K), R13.1
unnamed: Q1.4 (G), R1.2, R2.2
unnamed: R4.2, R5.1
unnamed: R5.2, S1.4 (COM), U1.1 (ADJ)
unnamed: R6.2, R7.1
unnamed: R8.2, R9.1
unnamed: R10.2, R11.1
unnamed: R11.2, R12.1

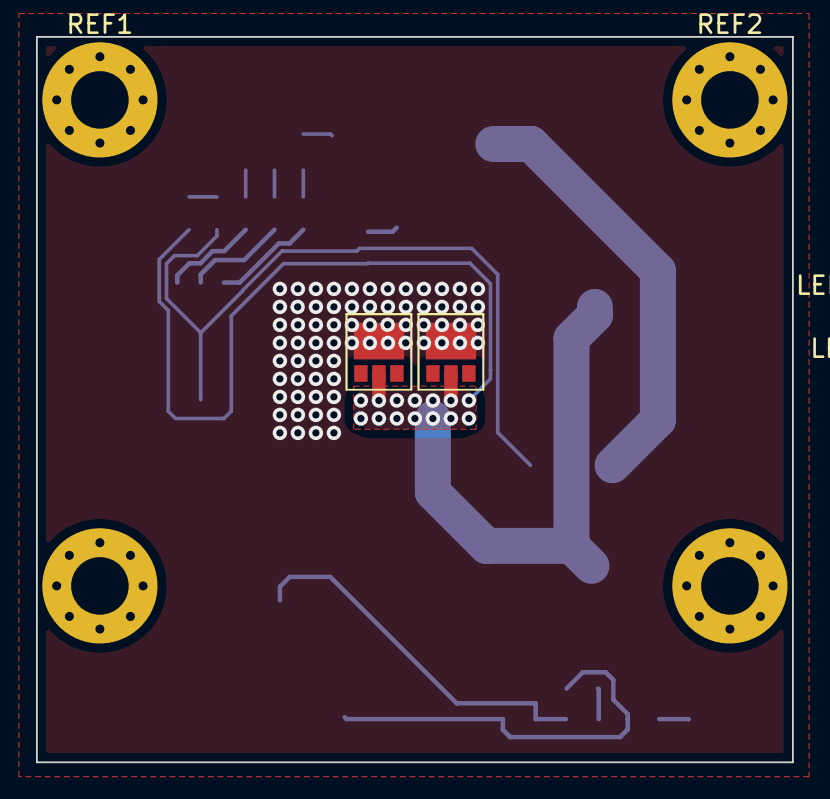
[picture p126: board ir_led_projector_v0.3.kicad_pcb from above]

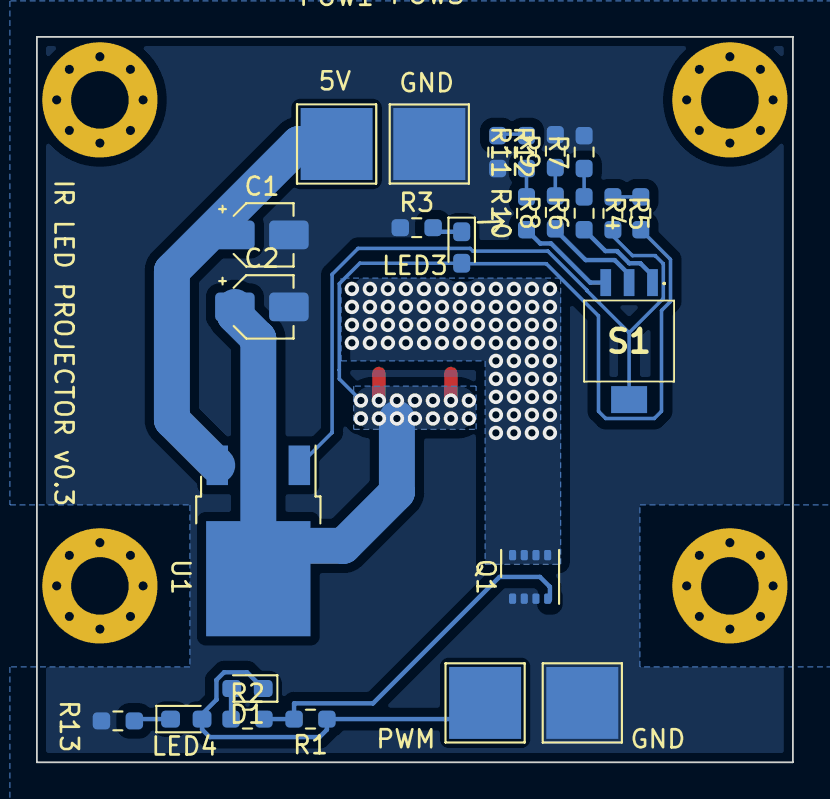
[picture p127: board ir_led_projector_v0.3.kicad_pcb from below]

Board: 2 copper layers, 42.0 x 40.3 mm, 31 parts (25 on the bottom side), 18 nets.

Other parts of the board:
REF1, REF2, REF3, REF4: MountingHole_3.2mm_M3_Pad_Via
