avena-robotics/pcbs/TACTILE_20UFQFPN_SPI_v2.0/TACTILE_STM32L011F4_SPI_v2.0.kicad_pcb

## KiCad design TACTILE_20UFQFPN_SPI_v2.0/TACTILE_STM32L011F4_SPI_v2.0.kicad_pcb (2021-11-19)

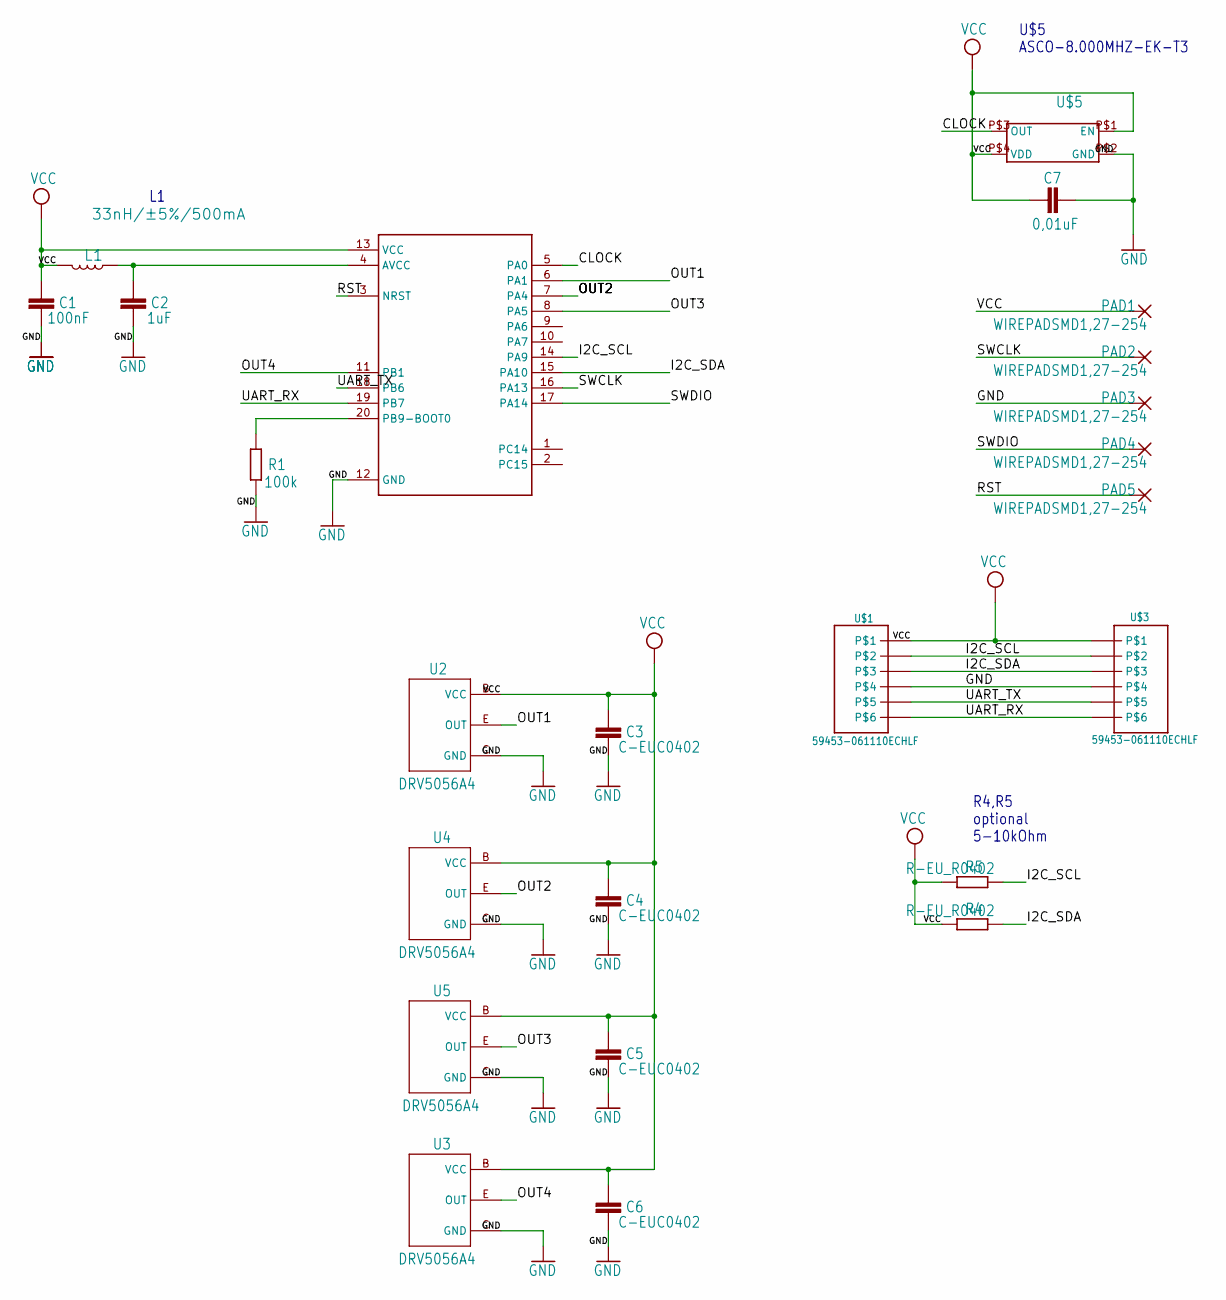
[picture p128: schematic TACTILE_STM32L011F4_SPI_v2.0.kicad_sch]

Parts:
C1: 100nF; C0402
C2: 1uF; C0402
C3, C4, C5, C6: C-EUC0402; C0402
C7: 0,01uF; C0402
L1: 33nH/±5%/500mA; 0603
PAD1, PAD2, PAD3, PAD4, PAD5: WIREPADSMD1,27-254; SMD1,27-2,54
R1: 100k; R0402
R4, R5: R-EU_R0402; R0402
U2, U3, U4, U5: DRV5056A4; SOT23-BEC
U$1, U$3: 59453-061110ECHLF
U$2: STM32L011F4; QFN50P300X300X60-20N
U$5: ASCO-8.000MHZ-EK-T3

Connections:
CLOCK: U$2.5 (PA0), U$5.P$3 (OUT)
GND: C1.2, C2.2, C3.2, C4.2, C5.2, C6.2, C7.1, PAD3.1, R1.1, U2.C (GND), U3.C (GND), U4.C (GND), U5.C (GND), U$1.P$4, U$2.12 (GND), U$3.P$4, U$5.P$2 (GND)
I2C_SCL: R5.1, U$1.P$2, U$2.14 (PA9), U$3.P$2
I2C_SDA: R4.1, U$1.P$3, U$2.15 (PA10), U$3.P$3
unnamed: C2.1, L1.1, U$2.4 (AVCC)
unnamed: R1.2, U$2.20 (PB9-BOOT0)
OUT1: U2.E (OUT), U$2.6 (PA1)
OUT2: U4.E (OUT), U$2.7 (PA4)
OUT3: U5.E (OUT), U$2.8 (PA5)
OUT4: U3.E (OUT), U$2.11 (PB1)
RST: PAD5.1, U$2.3 (NRST)
SWCLK: PAD2.1, U$2.16 (PA13)
SWDIO: PAD4.1, U$2.17 (PA14)
UART_RX: U$1.P$6, U$2.19 (PB7), U$3.P$6
UART_TX: U$1.P$5, U$2.18 (PB6), U$3.P$5
VCC: C1.1, C3.1, C4.1, C5.1, C6.1, C7.2, L1.2, PAD1.1, R4.2, R5.2, U2.B (VCC), U3.B (VCC), U4.B (VCC), U5.B (VCC), U$1.P$1, U$2.13 (VCC), U$3.P$1, U$5.P$1 (EN), U$5.P$4 (VDD)

Notes on the sheet:
R4,R5 optional 5-10kOhm
U$5 ASCO-8.000MHZ-EK-T3

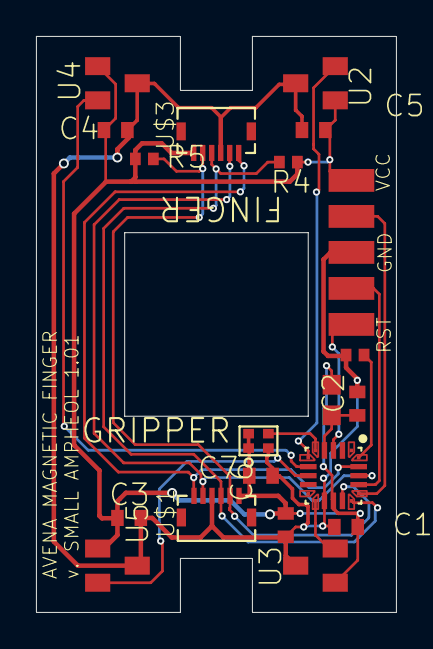
[picture p129: board TACTILE_STM32L011F4_SPI_v2.0.kicad_pcb from above]

Board: 2 copper layers, 20.0 x 32.0 mm, 24 parts (0 on the bottom side), 16 nets.
