avena-robotics/pcbs/(commit log)

2021-11-14 migration from gitlab
    [Belago1.1.stl, CP_Radial_D12.5mm_P2.50mm.step, CP_Radial_D12.5mm_P5.00mm.step, CP_Radial_D12.5mm_P7.50mm.step, CP_Radial_D6.3mm_P2.50mm.step, C_0603_1608Metric.step, C_2512_6332Metric.step, D_0603_1608Metric.step]
2021-11-19 update tactile pcb v2.0
    [TACTILE_28UFQFPN_SPI_v2.0.kicad_pcb, TACTILE_28UFQFPN_SPI_v2.0.kicad_sch, TACTILE_STM32L011F4_SPI_v2.0.kicad_pcb, TACTILE_STM32L011F4_SPI_v2.0.kicad_sch]
2021-11-19 remove universal joint 2.2.1
    [FTSH-107-01-L-DV-K-TR.step, FTSH-107-01-L-DV-K-TR.stp, M20-7810345.stp, UNIVERSAL_JOINT_v2_2_1.dxf, UNIVERSAL_JOINT_v2_2_1.kicad_pcb, UNIVERSAL_JOINT_v2_2_1.kicad_sch, UNIVERSAL_JOINT_v2_2_1.step]
2021-11-30 UJ 3.1 IR 0.3 TACTILE 2.1
    [1-726388-2.step, Belago1.1.stl, CP_Radial_D12.5mm_P2.50mm.step, CP_Radial_D12.5mm_P5.00mm.step, CP_Radial_D12.5mm_P7.50mm.step, CP_Radial_D6.3mm_P2.50mm.step, C_0603_1608Metric.step, C_2512_6332Metric.step]
2021-11-30 UH 2.8 RI80
    [D3-2515-31 - PCB - hall SMD v.3.1 - obrys płytki i elementów.DXF, D3-2515-31 - PCB - hall SMD v.3.1.- obrys płytki z otworami nontażowymiDXF.DXF, universal_hall_pcb_v2.8.kicad_pcb, universal_hall_pcb_v2.8.kicad_sch]
2021-12-08 add gripper and so on
    [1-726388-2.step, 61-2348-11_0030.STEP, D3-15-24 - PCB - hall SMD v.3.2 - obrys płytki.dxf, D3-2515-31 - PCB - hall SMD v.3.1.- obrys płytki z otworami nontażowymiDXF.DXF, FTSH-107-01-L-DV-K-TR.step, Gripper Connection Board.kicad_pcb, Gripper Connection Board.kicad_sch, Gripper FeeTech.kicad_pcb]
2021-12-10 UJ 2.2 remove brake resistor
    [DRV8323RHRGZR.STEP, LQFP48-7x7mm.step, SKHUALE010.step, TCAN332G.step, UNIVERSAL_JOINT_v2_2.kicad_pcb, UNIVERSAL_JOINT_v2_2.kicad_sch]
2021-12-13 update NM parts
    [UNIVERSAL_JOINT_v3_1.kicad_sch]
2021-12-14 tactile 2.1
    [TACTILE_28UFQFPN_SPI_v2.1.kicad_pcb, TACTILE_28UFQFPN_SPI_v2.1.kicad_sch]
2021-12-17 update UJ 3.1 NM values
    [UNIVERSAL_JOINT_v3_1.kicad_pcb]
2022-01-12 MASTER UPDATE
    [01000020Z LITTELFUSE x 20mm.step, 105314-2208.step, 61-1407-21_0031.step, 61-1537-11_0031.step, AON3402.step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]
2022-01-12 MASTER UPDATE v2
    [CP_Radial_D12.5mm_P2.50mm.step, CP_Radial_D12.5mm_P5.00mm.step, CP_Radial_D12.5mm_P7.50mm.step, CP_Radial_D6.3mm_P2.50mm.step, C_0603_1608Metric.step, C_2512_6332Metric.step, D_0603_1608Metric.step, M20-7810345.step]
2022-02-07 update to newest
    [01000020Z LITTELFUSE x 20mm.step, 1-726388-2.step, 105314-2208.step, 39-30-1080.step, 61-1407-21_0031.step, 61-1537-11_0031.step, 61-2348-11_0030.step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]
2022-03-01 update descriptions
    [UNIVERSAL_JOINT_v3_2.kicad_pcb, UNIVERSAL_JOINT_v3_2.kicad_sch]
2022-04-29 update UJ 3.3
    [1-726388-2.step, 61-2348-11_0030.step, BSS138PS.STEP, C_Radial_D12.5mm_H25.0mm_P5.00mm.step, C_Radial_D6.3mm_H11.0mm_P2.50mm.step, D3-16-33 - PCB kontroler.dxf, ECS-240-8-36B2-CKM-TR.step, FTSH-107-01-L-DV-K-TR.step]
2022-07-06 new UJ 3.5
    [1-726388-2.step, 61-2348-11_0030.step, BSS138PS.STEP, C_Radial_D12.5mm_H25.0mm_P5.00mm.step, C_Radial_D6.3mm_H11.0mm_P2.50mm.step, ECS-240-8-36B2-CKM-TR.step, ECX-2236B2.step, FTSH-107-01-L-DV-K-TR.step]
2022-07-13 UJ 3.5 - draft
    [BM02B-SRSS-TB.step, CP_Radial_D8.0mm_P2.50mm.step, C_Radial_D12.5mm_H25.0mm_P5.00mm.step, C_Radial_D6.3mm_H11.0mm_P2.50mm.step, D3-16-33 - PCB kontroler - D-shape.dxf, EVP-BB2A9B000.step, IC-PX.step, Ic-PX.step]
