avena-robotics/pcbs/(notices)

Notices in the files:
common_libraries/3dmodels/C_1206_3216Metric.step:
Copyright (C) 2017, kicad StepUp
This work is licensed under the [Creative Commons CC-BY-SA 4.0 License](https://creativecommons.org/licenses/by-sa/4.0/legalcode),
with the following exception:
To the extent that the creation of electronic designs that use 'Licensed Material' can be considered to be 'Adapted Material',
You are free to use the library data in your own projects without the obligation to share your project files under this or any other license agreement.
common_libraries/3dmodels/C_Elec_4x5.4.step:
Copyright (C) 2018, kicad StepUp
common_libraries/3dmodels/D_SMA.step:
This program is free software: you can redistribute it and/or modify
it under the terms of the GNU General Public License as published by
the Free Software Foundation, either version 3 of the License, or
any later version.
itself might be covered by the GNU General Public License.
common_libraries/3dmodels/PinSocket_1x08_P2.54mm_Vertical.step:
Copyright (C) 2017, Terje Io
This work is licensed under the Creative Commons CC-BY-SA 4.0 License with the following exception:
To the extent that the creation of electronic designs that use 'Licensed Material'
https://creativecommons.org/licenses/by-sa/4.0/legalcode
common_libraries/3dmodels/TSOT-23-6.step:
Copyright (C) 2019, kicad StepUp
UNIVERSAL_JOINT_v3_5/UNIVERSAL_JOINT/3dmodels/FTSH-107-01-L-DV-K-TR.step:
FILE_NAME( 'e:/temp/worker_65/temp/exporttempdir_408_265_AhXkw/format_0/FTSH-107-01-L-DV-K-TR.stp', '2021-10-18T19:26:05', ( 'License CC BY-ND 4.0' ), ( 'CADENAS' ), ' ', 'PARTsolutions', ' ' );
parts and their libraries:
Copyright 2021 Accelerated Designs. All rights reserved.
